MEGA65/mega65-core/docs/images/precomp.pdf

etherload.a65

etherload.prg

Ophis

diskchooser.a65

diskchooser

Ophis

diskmenuc000.a65

diskmenu_c000.bin

Ophis

.incBIN | .incBIN | .include | .include

diskmenu.a65

diskmenuprg.a65

diskmenu.prg

Ophis

kickstart.vhdl

Python Script

(./makerom)

kickstart.a65

kickstart65gs.bin

Ophis

rom_template.vhdl

.include

kickstart_task.a65

kickstart_mem.a65

kickstart_dos.a65

kickstart_machine.a65

kickstart_process_descriptor.a65 .incBIN

Choose ONE or
the OTHER
creates | creates

version.sh

version.vhdl | version.a65

.include

This diagram shows an overview of the build process implemented with the Makefile.

For example, to generate “etherload.prg” file, the “etherload.a65” file is passed into the “Ophis” compiler.

The “.incBIN” denotes that the lower file 'includes' the upper file, and the upper file is inserted into the lower file in a binary format.
Similarly:
the “.include” denotes that the lower file 'includes' the upper file, and the upper file is inserted into the lower file in a text-based format.

The “creates” suggests that the upper file 'generates' the lower file.

The “Choose...” suggests that one of the upper files is chosen to be “included” in the lower file.
Both the upper files are compiled by default.
The lower file is modified to select which of the two upper files to include.

The “pngprepare” executable is built from source. Details of this are not provided (refer to the Makefile).
The “pngprepare” file takes the upper file and generates the lower file.

A “Python Script” is used to generate one lower file from two upper files.

8x8font.png

charrom.vhdl

./pngprepare

mega65_64x64.png

BOOTLOGO.G65

./pngprepare

Used by Xilinx ISE
to be included within
the FPGA's bitstream.

To be copied onto the SD-Card. This image is displayed
during the boot process.
