MEGA65/mega65-core/docs/images/precomp-small.jpg

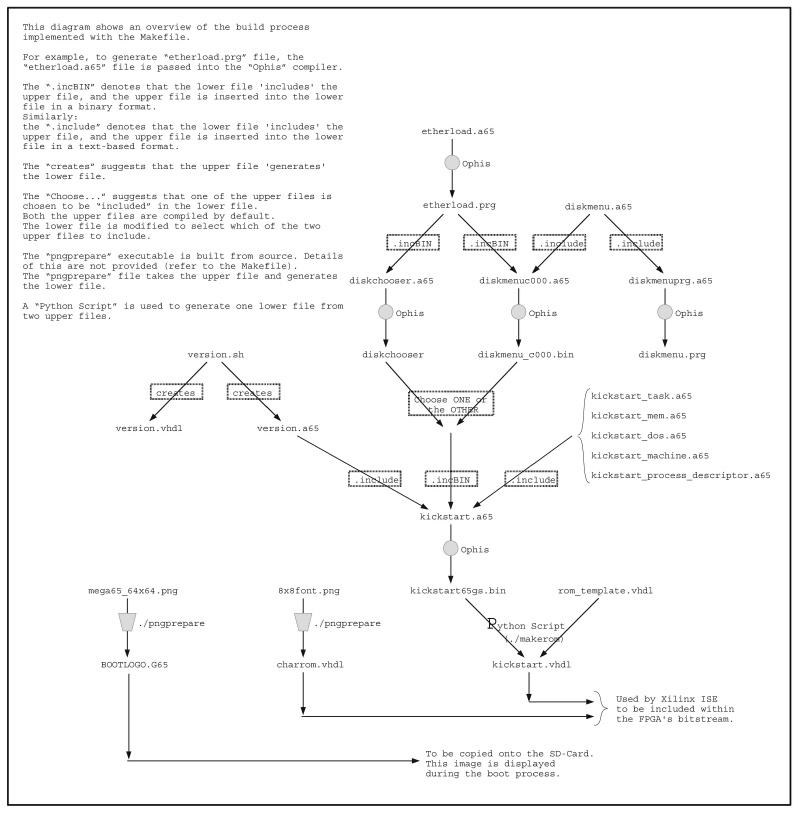
docs/images/precomp-small.jpg
