MEGA65/mega65-core/(threads)

Thread 1 (2016-08-08):

SD Card reader issues

gurcei, 2016-08-08:
I'm presently having trouble getting the kernel read from the sd-card and into memory.

There seems to be a chunk of incorrect data in the data, described in this forum post:

https://groups.google.com/d/msg/c65gs-development/q7kCars2Xqw/a_WIWMmcAgAJ

Paul has a few suggestions to chase up that he mentions in that forum thread.

##BREAKS Hypervisor cannot boot computer to C65 BASIC 10 from SD card

Ben-401, 2016-08-10:
Paul suggests this is one of my initial tasks.
also this thread:
https://groups.google.com/forum/#!topic/c65gs-development/lfTTbbDhWgo

gurcei, 2016-08-10:
No worries and fair enough too, as it's a fairly nasty issue that needs some heavy focus, and I'm getting fairly distracted with m65dbg as is. I'll still keep one eye on looking into this too, as it provided the impetus for the growth of the debugger, so I might still chip in my 10 cents worth on this topic from time-to-time if I notice anything.

gurcei, 2016-08-16:
While debugging tonight, discovered a potential cause of the problem. More info in this forum-post:

https://groups.google.com/d/msg/c65gs-development/lfTTbbDhWgo/5Fm-_td2AwAJ

gardners, 2016-08-16:
How about (untested):

dos_file_read_current_sector:
jsr dos_set_current_cluster_from_file
jsr dos_cluster_to_sector

; Add sector within cluster
jsr dos_get_file_descriptor_offset
bcc dos_return_error_already_set
ora #dos_filedescriptor_offset_sectorincluster
tay
ldx #$00
clc
php
lda dos_file_descriptors,y
bne dfrcs4
dfrcs2: lda #$00
dfrcs4: plp
adc $d681,x
sta $d681,x
bcc dfrcs_inced
php
inx
cpx #$04
bne dfrcs2
plp
dfrcs_inced:

i.e., save and restore the processor flags. Cost is 4 bytes and some cycles.

Do check that what I have suggested actually does the job before committing
;)

Paul.

On Tue, Aug 16, 2016 at 10:53 PM, Gurce Isikyildiz <notifications@github.com
> wrote:

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

gurcei, 2016-08-19:
Yep, Paul's suggestion solved the prob and he's pushed in the fix into the master branch.

There's another issue regarding the failed loading of the (optional) KICKUP.M65 file from the sd-card, I'm looking into that next.

gurcei, 2016-08-22:
I've tested with the latest bit-stream (I was on an older bitstream previously), and it was able to load the KICKUP.M65 successfully. Ok to close? Or other known quirks of behaviour in the sd-card reading that still remain?

gardners, 2016-08-22:
Hello,

If there are no known outstanding items, close the request. We can always
reopen it or open a new one if (or when ;) we find new problems.

Paul.

On Tue, Aug 23, 2016 at 5:50 AM, Gurce Isikyildiz <notifications@github.com>
wrote:

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

Ben-401, 2016-08-26:
i have confirmed that the SDcard reader sometimes needs to call the "redoread" function.
it seems to do this when it detects that it did not read 2x-pages (512 bytes).
in this regard i reverted the debug message to display this abnormality, in an attempt to characterise the behaviour.

It seems to consistently re-do-read when loading bitstream from USB and having KICKUP on SD.

Ben-401, 2016-08-29:
I have reviewed the "kickstart" and "dos" code, and have modified the Checkpoint messages that are generated. I now have a better understanding of how it works.

I have also created a script that examines a sdcard and writes information to harddisk.
I have also created a script to zero/partition/format a sdcard in an attempt to try diagnose the problem.

I will upload these files to the repo soon, in the src/utilities directory.

Ben-401, 2016-08-31:
i have found some unusual behaviour in the _dos code:
- re-reading MBR (sector 0) when not neccessary
- checking for $55AA when not nessessary
- not observing file attributes appropriately.
- seems to be using CHS (cylinder/head/sector) i think
- a heap of code for file handlers and offset information...

I have modified the _dos code, available for viewing on MVFILE branch
but is under development, please do not merge or branch from.

gardners, 2016-08-31:
Hello,

It should only be using LBA, not CHS addressing.

The file handler code etc is important, to allow a program to ask the
hypervisor to open multiple files at the same time.  However, we do know
that we have a file handle leak somewhere.

Paul.

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

Ben-401, 2017-02-14:
how do we test that this change infact works?
is there as basic program or assembly code that we can include in our test procedure?
Please... :)

And can this patch be applied to the development branch instead of cursorkeys?
I thought cursorkeys has been retired?

gardners, 2017-02-14:
Hello,

Falk and I are still pushing the cursorkeys branch forward as the focus of
our attention, as we are the only folks working on it.  It would be good to
merge all the changes onto development, of course.

Paul.

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

lydon42, 2022-01-09:
As reading and writing of the SD Card obviously works in 2022, we can close this.

Closed 2022-01-09.

Thread 3 (2016-08-09):

Problem with etherload stub

SvOlli, 2016-08-09:
Hello,

I tried a partial rewrite of the etherload stub to get arp replies working. I succeeded, almost. Even though the code should reply always the same if arping'ed from the same host, the results vary.

Without knowing what happening inside the hardware, I can't go on any further.
Once this issue has been solved, I might be able to squeeze in support for ICMP, so the stub will reply to pings.
[etherload.txt](https://github.com/MEGA65/mega65-core/files/409798/etherload.txt)

gardners, 2016-08-09:
What differences are you seeing? We did see some subtle bit corruption bug
with sending packets, but I don't know if that is still happening. Some
examples of the packets would be helpful in discovering the cause.

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

Ben-401, 2016-08-10:
to see what is going on in the hardware maybe you could add checkpoint messages to the .a65 asm files? and view those messages using the serial-monitor. ie

	jsr checkpoint
	.byte 0,"GOT-TO-HERE",0
or even better populate the output message with values corresponding to the register values.

SvOlli, 2016-08-10:
Hello,

I don't think that it has to do with the C65 code. There are a lot of bit
flips, where I can't make up a pattern. I've attached a dump done with
wireshark.

btw: the sourcecode reveals who to tell the hardware how big the packet to
send is, but how can I tell how big the incoming packet is?

Greetings,
SvOlli

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

Winke: o/~
SvOlli
--
|  _______       |
| (  /\          | Sie glaubt an ihre Traeume
|__)v\/lli a.k.a.| weil Traeume mehr als Gold wert sind.
|Sven Oliver Moll|   -- Selig, "Maedchen auf dem Dach"

gardners, 2016-08-10:
Hello,

Yes, I recall there was a problem with bit-flips.  I am not sure of the
cause of this.  I am guessing that it will likely be a problem with the
delay relationship of the clock line versus the data lines from the FPGA to
the ethernet controller.  It would be instructive to know if the bits are
in effect copied from the preceding 2-bit word in either direction (the
ethernet interface takes data 2 bits wide).

Paul.

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

gardners, 2016-08-10:
Datasheet for the ethernet interface IC on the Nexys4 is at:

http://ww1.microchip.com/downloads/en/DeviceDoc/8720a.pdf

TX data is latched when the clock goes high.  The data should already be
present on the line at that point in time, i.e., should be provided when
the 50MHz clock goes low.  At present, that is not the case.

Probably the best solution is to make the controller run at 100MHz, divide
that by 2 to generate the 50MHz clock for the ethernet controller, and then
drive the data explicitly on the low phase of the 50MHz clock, to be
certain that it is ready on time.  There is probably a one or a couple of
days work for someone to implement and test that.

Paul.

On Wed, Aug 10, 2016 at 4:55 PM, Paul Gardner-Stephen <
paul@servalproject.org> wrote:

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

gardners, 2016-08-10:
Have just taken a quick look: It seems possible to just invert the sense of the ethernet 50MHz clock to the PHY.   Trying that (commit e788e25610c59c83e899521976fb777def57b467).

Ben-401, 2016-08-10:
I am no expert, but I think the clocking of components needs revision.
ISE reports that there are gated-clocks, and clocks generated from combinational-logic(?).
This needs to be changed in my opinion.
From my experience we should be able to draw a solid line through the design to show which components are being clocked at 200M, 100M, 50M, and etc.

Ben-401, 2016-08-10:
my opinion is that all components should be clocked at 200mhz (or more), and the chip-enable to each circuit be generated from a 4-bit counter (to give 100, 50, 25) driven by the incoming 200+ clock_in.

gardners, 2016-08-10:
I agree the clocking can be improved. However, the pixel clock requires 192MHz, and the ethernet 50MHz, thus we cannot avoid having 2 clock domains.  The CPU is 48MHz (pixelclock/4), which is generated by the FPGA's PLL.  However, there are some other clocks lurking around the place that can probably be simplified, provided the process doesn't break anything.

gardners, 2016-08-15:
We have just tried flipping the ethernet clock, as it looked like we were providing data on the wrong clock phase, but that is in fact not the problem.

Ben and my best guess now is that there is glitching on the TX side, and will try registering the outputs.

gardners, 2016-08-15:
Implementing registering of ethernet tx signals in commit 44cddf87588ae2b14e00be76dd072387ae0a5b2d

gardners, 2016-09-15:
I still haven't gotten around to testing if registering the signals has fixed the bit-flip problem.

Ben-401, 2016-09-15:
Please assign this one to me. I will look into it after sdcard/fat32.

lydon42, 2022-01-09:
As this is very old, and stuff like WeeIP, fetch and Haustierbegriff works, I deem it hereby closed.
If there are still topics with it, it might be better to create a new issue with clear description of shortcomings and reference this one.

Closed 2022-01-09.

Thread 7 (2016-08-10):

serial buffer for in-built monitor

gurcei, 2016-08-10:
This one relates to #2 somewhat. Paul suggested the creation of a serial buffer for the comms sent out of the hardware by the monitor:

https://groups.google.com/d/msg/c65gs-development/FESl92s4vEM/rpmUe5Z4AQAJ

Perhaps this might improve performance too?

gardners, 2016-08-10:
The only performance boost it will give, is that you will be able to write
a whole command and flush at once.  USB latency is still likely to be a
remaining problem.

On Wed, Aug 10, 2016 at 8:32 PM, Gurce Isikyildiz <notifications@github.com>
wrote:

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

Ben-401, 2016-08-10:
i think the serial-comms needs to be a blocking-call. Ie your calling component waits until the message has been sent, then the calling component goes away and continues.
i dont think a buffer here will help at all, infact it will only duplicate the message, whereas my understanding is that the current architecture calling component sends a byte-at-a-time to the serial-monitor to transmit.
as for the serial-comms component, i think an improvement would be that the 2000-odd clock cycle delay be done-away with, and more tightly-timed circuit be implemented. I can elaborate on this. Its all about handshaking.

gardners, 2020-12-18:
The serial monitor is basically UART fed, so the lack of a UART RX buffer does mean that the sending side has to leave a long enough gap between each character for the monitor to process it. As the new monitor is actually running in a little CPU, this delay can be quite big. As a result we have to send each character with a considerable delay between them. Worse, because its over USB we have to make sure that the USB layer doesn't merge any of the writes into a single packet.  To make this stable, we typically have delays of 500 -- 2000 usec between each character, often more.  This means we effectively write at ~1KB/sec instead of the ~200KB/sec that the 2mbit/sec serial interface can support.  Thus just being able to write whole commands at once will likely result in substantially faster performance. But more importantly, it will greatly reduce the chance of characters being dropped, which does seem to be a problem when using Windows as the sender.

Closed 2022-10-02.

Thread 20 (2016-09-14):

Hypervisor DOS FAT32 chain and directory following/parsing compatibility problem and speed improvement idea

lgblgblgb, 2016-09-14:
According to https://en.wikipedia.org/wiki/Design_of_the_FAT_file_system

The FAT table contains last cluster for chain ("EOC") as values 0x?FFFFFF8 - 0x?FFFFFFF. It seems, KS only recognizes 0x?FFFFFFF, though as a test, I can see, that Linux dosfstools uses 0x?FFFFFF8 (this behaviour and compatibility problems even mentioned by the page). This can be an explanation why file systems created on some OSes doesn't work for us. The page also mentions about the fact, that FAT32 is actually FAT28, and the high 4 bits are not so much used to express cluster number but not always zero still, that's the reason of '?' marks in the hex numbers above (so they should be "masked out" before using a value as cluster?). It seems it's even recommended to treat **any** value in FAT which is over the max number of cluster on the given FS as "EOC", not only the range above, for better compatibility (as the page claims: "a good implementation ..."). This is exactly the problem I noticed with my M65 emulator with my own created FAT32: soon, invalid block is tried to be read on directory scanning, it can be the issue, that EOC (what is produced by my Linux box, but what is accepted by my various "stuffs" like digital camera etc) is misinterpreted by KS, and tried to be converted into SD block number the read -> thus the problem we see. As far as I know some other people also has problem like this.

I think, "sensing" EOC should be modified to care about these information too, including the 4 high bits issue, the multiple possibilities for EOC, and maybe even that any cluster number in FAT should be treated as EOC, if it would cause to address a cluster which does not exist on the used FS. This should be true for directory parsing, but also, for any file, where FAT is used for anything to detect EOC situation. Also maybe not only EOC, but cluster info from FAT should be handled to use only the lower 28 bits just in case for some "strange" FAT32 file systems, and even better compatibility.

I found this table especially useful (it mentions even more EOC possibilities, like cluster 0 and 1 ...):

https://en.wikipedia.org/wiki/Design_of_the_FAT_file_system#Cluster_values

The other issue is more like a performance gain than a real issue: again, according to the page above, during a directory read, if the 32 bytes directory entry starts with byte 0, directory parsing can be stopped. So even there is no need to parse the rest of the cluster (or read the next logical sector belonging to the actual cluster ...), and maybe no need to even check for next cluster then in FAT. It seems, this can be a compatibility issue in general in case of older FATs (FAT12 and FAT16) with some extreme old DOS versions, like DOS 1 and DOS 2 and some half-CP/M-half-DOS beings. However, as FAT32 is surely not handled/produced by these, I think, we can surely say, this theory is true for our case with FAT32-only KS. Even deleted files has first byte as 0xE5, zero should only encountered if no other entries follows in the directory (let it be the root directory or any other - as with FAT32 there is no difference, unlike with FAT12/16). Reference:

https://en.wikipedia.org/wiki/Design_of_the_FAT_file_system#Directory_entry

gardners, 2016-09-15:
FAT end of directory marker fix in commit

cc0cd02315e18259b9be1e6d6a623932a4da9029

FAT EOC marker fix in b9178ec202700edad6944c3884280dce88c6e88c

Both currently untested.

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

rdpeake, 2021-02-05:
fixed

Closed 2021-02-05.

Thread 24 (2016-09-23):

BOULDERMARK not working

Ben-401, 2016-09-23:
PGS has advised that the "BOULDERMARK" program no longer works on the current bitstream.
The Bouldermark program runs a special-level in the Boulderdash program and counts how many frames it takes to complete.
The Bouldermark program can be found on the MEGA65 image.

Ben-401, 2016-09-23:
An old bitstream dated Mar 15 2016 23:18:00 shows that the Bouldermark program gains a score of ~27K.
go64
y
sys49152
<mount MEGA65>
load"BOULDERMARK
POKE0,65
LIST
RUN
<joystick-FIRE a couple of times>

Ben-401, 2016-09-23:
PGS has suggested that maybe something in the gs4510 file has changed, causing the Bouldermark program to now crash.
PGS has suggested that an iterative-approach be taken to find which bitstreams do work, and at what point the bitstreams dont work, and then find the commit that breaks the Bouldermark program.

Ben-401, 2016-09-23:
the bitstream referred to above (Mar 15) is commit ID
commit ad7698ce809479d3ce1b71675ded70d2fa729b77
Author: justburn <justburn@users.noreply.github.com>
Date:   Sun Mar 13 07:44:16 2016 +0000
    Cleanup and making it work again

Ben-401, 2016-09-29:
i am currently building all relevant bitstreams to detect which commit caused the issue.

Ben-401, 2016-10-05:
I am able to build old bitstreams, using colossus HPC,
home/dev/sdcard/_safeKeep/MEGA65.BIT is the BITfile that runs and gets a score of 26023.
work only on PGS fpga-board, ie not on BNG fpga-board.
BG has captured a video showing the highscore.
still need to verify if I can build a BITfile that gains the same highscore.

gardners, 2016-10-20:
Have you found the commit where it stops working?

Ben-401, 2016-10-24:
i have found a commit where it does work. All I have is a "container.bit" file as listed above. What I have found is that this particular bitstream works to some success(*) only on your Nexys board; it works to a much lesser amount on my Nexys board. This suggests to me that the bitstream is not hardware independant. Given all the compile warnings and lack of timing closure, i think the best approach is to get the design compiling with 100% timing closure and minimise warnings before trying to fix an intermittent problem.

(*) Your board runs for a minute or so, says it run out of time, then continues the level as score increases, loops a number of times, then finishes the level with about 30k.
(*) My board starts the level, border flashing, after 5-secs or so, full-screen flash with bitmap-detail showing top horizontal line. seems to be stuck in a loop.

gardners, 2016-10-25:
Hello,

Yes, this suggests that timing closure is the problem -- or failing that,
that one of our boards is faulty in some way.

For the timing closure issue, this is relatively easy to verify, as you can
modify the design to operate at ~32MHz (196/6) or ~40MHz (192/5) instead of
~48MHz without great difficulty.  This isn't a long-term solution,
however.  The remaining timing closure problems in the CPU were intended to
be fixed by moving to the new CPU design, however, that is still some time
off.

Note that the VIC-IV 192MHz clock domain is much harder to get to meet
timing right now, but is rather unlikely to be the cause, because the CPU
is not sensibly dependent on it. The easiest and most sensible way to solve
the video clock timing is to drop to 1080p, as we have been planning for
some time, as this will allow dropping the pixel clock to 148MHz, which
should fixing the timing closure there.

Of course, the CPU and VIC clocks have to remain integer ratios of each
other, since there is a lot of cross-domain data passing between them.
This would mean that the CPU would need to be at 148/3 = ~48MHz as now, or
148/4 = ~37MHz.

But in the meantime, if you can identify the commit ID, we can examine what
was changed, and revert that specific problem for now.

Paul.

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

Ben-401, 2017-03-20:
The current version of code is KSv10.
The KSv10 when running on the NEXYS4DDR board labelled "PGS" gains a score of 26k or more. I have tested many times.
The KSv10 when running on the NEXYS4DDR board labelled "BNG" gains a score of zero. During the first 3 secs (when the balls are falling), the screen shows the balls falling etc but flickers black a few times, after the balls finish dropping, GAME OVER is instantly displayed and switches to the high-score table. This differs to what was experienced previously as detailed on 24-OCT-2016.

I consider that the firmware is not hardware independant, and seems 'tuned' to the 'PGS' board where the firmware was initially written for.,

This issue remains open.

gardners, 2017-03-20:
As mentioned, the issue is most likely related to the lack of timing
closure on the CPU.  This means that production variation in the FPGA can
change the behaviour of the system.  If you run Bouldermark with the CPU at
1MHz, then it performs reliably on all boards that I have seen, adding some
support for this theory.

I believe the underlying problem is occurring in branch instructions, but
don't have the hard evidence to back that up at the moment.

Paul.

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

Ben-401, 2017-03-20:
Yes, both the "PGS" and "BNG" boards get a score of 306-to-309 when BOULDERMARK is run in 1 MHZ mode, ie "POKE 0,64".

As for the timing closure issue...

gardners, 2017-03-20:
You could make a build with a 32MHz CPU and try that.

It is also possible that it is something strange that requires a CPU wait
state for some signal to be propagated.

Paul.

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

gardners, 2018-02-08:
This problem has been fixed some time ago, as I recall. I forget precisely what the underlying cause was. Please test and verify, then we can close the issue.

Ben-401, 2018-02-09:
cannot load the "BOULDERMARK.PRG" file from sdcard, as sdcard not working.
have tried using "monitor_load" but cannot seem to upload PRGs to c65-mode like i can do in c64-mode.

Can monitor_load be updated to upload files to c65-mode?
I will wait until sdcard operational then test.

Ben-401, 2018-02-09:
sorry, we should be in c64 mode, not c65 mode.
Yes I can upload bouldermark to c64 mode, gets a score of ~100 in c64 mode.
then upload bouldermark, POKE0,65, run, does not score.

-> still a problem (as verified with you alongside me)

rdpeake, 2021-02-05:
Currently tested on recent bitstream as working

Closed 2021-02-05.

Thread 39 (2017-10-27):

Errors while compiling

sorgelig, 2017-10-27:
https://github.com/MEGA65/mega65-core/blob/c1954d254a64a65d1a05083dcd4cb5262f61ca88/src/vhdl/viciv.vhdl#L1689

is current VHDL can be compiled? I have a lot of issues with signal multi-drivers like on link.
For example the address bus palette_fastio_address gets assigned in lines:
first group, lines: 1689 1693 1697
second group, lines: 2300 2304 2308
First group is combination logic used in read while second group is sequential logic triggered by rising_edge(ioclock) during write. This produces error as this signal has 2 drivers. I didn't use Xilinx development tools. I use Altera. But i've though there is a common HDL rule where signals might be assigned only in one logical block.
There are many such places in the different HDL files.
Finally, i found some modules have different signal assignment than calling module.

Overall code doesn't look like working. Am i right?

gardners, 2017-10-27:
For the moment, build from the m65pcb-ports branch if not already doing so. This branch synthesises fine using ISE. We will synchronise master and development to this in the near future.

However, it is possible that there may still be problems of this sort when switching tools, due to my inferior VHDL skills and differences in tools. If you can confirm which branch you are using, we can work out if we still need a solution, and proceed from there.

sorgelig, 2017-10-27:
I've cloned default branch, which should be master, i guess.

By the way, is it really necessary to use such high resolution? While many TVs/Monitors can support it, for compatibility purpose can you consider 1280x720@60 at least as an option?

gardners, 2017-10-27:
Hello,

ok. Try m65pcb-ports and let me know if the problem is still present.

Regarding the resolution, the challenge is we need to use a single common
mode that works everywhere, if we are to preserve the C64 idiom of
standardised raster timing.  That said, we may well move to 800x480 for a
variety of reasons I can't presently explain.  For testing, you can
certainly pick a mode with a lower dot clock to ease your timing closure.
It must be an integer multiple of the CPU clock, however.

Paul.

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

sorgelig, 2017-10-27:
Ok. i'm looking into m65pcb-ports branch, but can't find top-level files container*.vhd

sorgelig, 2017-10-27:
By the way, can you tell what is current BRAM (FPGA RAM) usage in the project?
My FPGA has 5,662,720bits of BRAM - do i have chance to run the mega65?

gardners, 2017-10-27:
The m65pcb-ports branch uses a new Makefile that creates all the files required. Also, it uses top-levels named for the different FPGA boards we are using, e.g., nexys4ddr, m65pcbr1 etc.

As for BRAM, we are using almost the entire BRAM of the T100 FPGA. There is some scope to save some space by merging the video and shadow RAM if you dropped the pixel clock (and possibly CPU clock) enough, but that would be a lot of work.

You currently need 128KiB for chip ram, 128KiB for the shadow of that, 128KiB for the "ROM", 32KiB for colour RAM, 24KiB for the Hypervisor and a few other 4KiB and 8KiB buffers here and there.

But if I have calculated correctly, your FPGA has more BRAM than the T100, so it should be fine.  What part/board are you using, out of curiosity?

sorgelig, 2017-10-27:
If you are still target to T100 then it's good! I was afraid you've moved to T200 already.

I'm trying to port mega65 to my project MiSTer: https://github.com/MiSTer-devel/Main_MiSTer/wiki
It's based on Terasic DE10-nano with additional expansion boards. Besides the main board all PCB designs, SW and HDL are open source and available on my repository.

I have ported C64, but in some aspects it's desired to be better. That's why i want to try your version of C64 as a subset of mega65.

gardners, 2017-10-27:
Ah, very cool. Well, we are happy for the M65 core to be ported, as we very much agree with the open-source approach.  Our C64 core is currently not as good as we would like, but welcome improvements, and certainly intend to improve it further.  Note at present our CPU defaults to 4510, not 6502.  6502 illegal opcodes are only partly implemented, and indeed the CPU is currently over complex for what it needs to do, and needs some refactoring and simplification -- but maybe not until we have some better test cases, so that we can verify that nothing gets lost in the process.  I have started work on a pipelined multi-core register-renaming 4510/6502 that is designed to be a lot faster and smaller in hardware, while still completely backward compatible (including for self-modifying code), but it isn't very far advanced yet.

You can see the current progress at: https://github.com/gardners/gs4502b

sorgelig, 2017-10-27:
where can i get **convert** utility used in your makefile?

gardners, 2017-10-27:
convert is a standard unix package for converting image types.  apt-get
install convert should get it.
what OS are you using?

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

sorgelig, 2017-10-27:
i've found it already, sorry :)

now i cannot find m65fdisk.prg
is the any link where to download it?

sorgelig, 2017-10-27:
I'm using Windows. I've downloaded this https://www.imagemagick.org/script/convert.php
it seems the same as linux one.

gardners, 2017-10-27:
It is built from a git submodule.

git submodule init
git submodule update
make

should do everything.

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

sorgelig, 2017-10-27:
it seems it links to non-existing commit. github gives error 404. git submodule also give error.
I will clone the latest commit - hope it will work as well.

gardners, 2017-10-27:
I have just pushed the missing commit

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

sorgelig, 2017-10-27:
Thanks for supporting! I'm slowly moving forward.
another problem:
```
$(BINDIR)/diskmenu_c000.bin:	$(UTILDIR)/diskmenuc000.a65 $(UTILDIR)/diskmenu.a65 $(BINDIR)/etherload.prg
	$(OPHIS) $< -l $*.list -m $*.map -o $*.prg
```

i see references to diskmenu_c000.bin, but actually diskmenu_c000.prg is produced. Is it mistake in makefile?

sorgelig, 2017-10-27:
ok, after changing to
```
$(OPHIS) $< -l $*.list -m $*.map -o $*.bin
```
i could finish generate following:
generated_vhdl
firmware
iomap.txt
utilities
roms

So, now i have files for SD card and hopefully all HDL files. Preparation and adjusting the HDL code will take some time, i think. So will report you later about result.

gardners, 2017-10-27:
okay. let me know how you go.  Feel free to make a pull request for the fix.

Paul.

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

sorgelig, 2017-10-27:
it's me again :)

I don't know how Xilinx compiles this part of code:
```vhdl
    if ioclock'event and ioclock = '1' then
      -- Allow writing to bitplane buffer memory directly for debugging
      -- (will be overridden if VIC-IV data pipeline is feeding us data)
      -- @IO:GS $FFBF000 - $FFBFFFF - DEBUG allow writing directly to the bitplane data buffer.  Will be removed in production.
      if fastio_write='1' and fastio_address(19 downto 12) = x"BF" then
        bitplanedatabuffer_waddress(11 downto 0)
          <= fastio_address(11 downto 0);
        bitplanedatabuffer_wdata(8) <= '0';
        bitplanedatabuffer_wdata(7 downto 0) <= fastio_wdata;
        bitplanedatabuffer_write <= '1';
      end if;
    end if;
    if pixelclock'event and pixelclock = '1' then  -- rising clock edge

      -- Copy sprite colission status out
      sprite_map_out <= sprite_map_in;
      sprite_fg_map_out <= sprite_fg_map_in;

      -- Have a drive stage on bitplane mode bits to ease timing.
      bitplane_mode <= bitplane_mode_in;
      bitplane_enables <= bitplane_enables_in;
      bitplane_complements <= bitplane_complements_in;

      -- copy sprite data chain from input side to output side
      sprite_spritenumber_out <= sprite_spritenumber_in;
      sprite_datavalid_out <= sprite_datavalid_in;
      sprite_bytenumber_out <= sprite_bytenumber_in;
      sprite_data_out <= sprite_data_in;
      sprite_number_for_data_out <= sprite_number_for_data_in;

      if sprite_datavalid_in = '1' and (sprite_spritenumber_in > 7) then
        -- Record sprite data
        report "BITPLANES:"
          & "  byte $" & to_hstring(sprite_data_in)
          & " from VIC-IV for bp#"
          & integer'image(sprite_spritenumber_in)
          & " byte #" & integer'image(sprite_bytenumber_in)
          & " x=" & integer'image(x_in)
          & " x_start=" & integer'image(bitplane_x_start)
          & " y=" & integer'image(y_in)
          & " y_start=" & integer'image(bitplane_y_start)
          & " border_in=" & std_logic'image(border_in)
          & " bitplane_mode_in=" & std_logic'image(bitplane_mode_in)
          & " bitplane_drawing=" & std_logic'image(bitplane_drawing);
        bitplanedatabuffer_waddress(11 downto 9)
          <= to_unsigned(sprite_spritenumber_in mod 8, 3);
        bitplanedatabuffer_waddress(8 downto 0)
          <= to_unsigned(sprite_bytenumber_in, 9);
        bitplanedatabuffer_wdata(8) <= '0';
        bitplanedatabuffer_wdata(7 downto 0) <= sprite_data_in;
        bitplanedatabuffer_write <= '1';
      end if;
```
signals **bitplanedatabuffer_wdata** and **bitplanedatabuffer_write** are driven by 2 clocks ioclock and pixelclock. Altera tools refuse to synthesize this. It's even impossible in real world. It's like connect outputs of 2 clocks together physically. How it's possible in Xilinx - i have no idea :(

sorgelig, 2017-10-27:
in this particular case, these signals are used to write into 2-port RAM, so it would be better to re-arrange the ports. One port use for ioclock control, another for pixelclock control. Anyway, it's not good to clock the RAM port with one clock but drive signal from other clock.

But there are several places with multi-drivers in other parts of code.

gardners, 2017-10-27:
Hello,

You can simply remove the ioclock access in the above case, as it was only
ever there to help debug bitplane function.  Falk Rehwagen will be merging
in the final fixes for the bitplanes when he has time, so there is no need
to keep the debug function.

Let's just work through the multi-drivers one by one, if that suits you.

Paul.

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

sorgelig, 2017-10-27:
Yep, doing one by one is the best way.
```vhdl
    if fastio_read='1' then
      if fastio_addr = x"D3632" then
        -- @IO:GS $D632 - Lower 8 bits of thumbnail buffer read address (TEMPORARY DEBUG REGISTER)
        fastio_rdata <= thumbnail_read_address(7 downto 0);
      elsif fastio_addr = x"D3631" then
        -- @IO:GS $D631 - Read port for thumbnail generator
        fastio_rdata <= thumbnail_rdata;
      elsif fastio_addr = x"D3630" then
        -- @IO:GS $D630-$D631 - Read-only hardware-generated thumbnail of display (accessible only in hypervisor mode)
        -- @IO:GS $D630 - Write to reset port address for thumbnail generator
        -- @IO:GS $D630 - Read to obtain status of thumbnail generator.
        -- @IO:GS $D630.7 - Thumbnail is valid if 1.  Else there has not been a complete frame since elapsed without a trap to hypervisor mode, in which case the thumbnail may not reflect the current process.
        -- @IO:GS $D630.6 - Thumbnail drawing was in progress.
        thumbnail_read_address <= (others => '0');
        fastio_rdata(7) <= thumbnail_valid;
        fastio_rdata(6) <= thumbnail_started;
        fastio_rdata(5 downto 0) <= (others => '0');
      else
        fastio_rdata <= (others => 'Z');
      end if;
    else
      fastio_rdata <= (others => 'Z');
    end if;

    if rising_edge(ioclock) then

      -- Tell ethernet controller which half of the buffer we are writing to.
      -- Ethernet controller autonomously sends the contents of the other half
      -- whenever we switch halves.
      buffer_moby_toggle <= output_address_internal(11);

      -- Logic to control port address for thumbnail buffer
      if fastio_read='1' then
        if fastio_addr = x"D3631" then
          last_access_is_thumbnail <= '1';
          if last_access_is_thumbnail = '0' then
            thumbnail_read_address <= thumbnail_read_address + 1;
          end if;
        else
          last_access_is_thumbnail <= '0';
        end if;
      else
        last_access_is_thumbnail <= '0';
      end if;     
    end if;
```
thumbnail_read_address has multi-drivers because first block is combination logic while second block is sequential clocked by  ioclock.
Is ioclock block also for debugging and can be removed?

sorgelig, 2017-10-27:
may be add following code to the ioclock block and remove thumbnail_read_address from combination block?
```vhdl
      elsif fastio_addr = x"D3630" then
        thumbnail_read_address <= (others => '0');
      end if;
```

sorgelig, 2017-10-27:
here is the whole block with my modification:
```vhdl
    if fastio_read='1' then
      if fastio_addr = x"D3632" then
        -- @IO:GS $D632 - Lower 8 bits of thumbnail buffer read address (TEMPORARY DEBUG REGISTER)
        fastio_rdata <= thumbnail_read_address(7 downto 0);
      elsif fastio_addr = x"D3631" then
        -- @IO:GS $D631 - Read port for thumbnail generator
        fastio_rdata <= thumbnail_rdata;
      elsif fastio_addr = x"D3630" then
        -- @IO:GS $D630-$D631 - Read-only hardware-generated thumbnail of display (accessible only in hypervisor mode)
        -- @IO:GS $D630 - Write to reset port address for thumbnail generator
        -- @IO:GS $D630 - Read to obtain status of thumbnail generator.
        -- @IO:GS $D630.7 - Thumbnail is valid if 1.  Else there has not been a complete frame since elapsed without a trap to hypervisor mode, in which case the thumbnail may not reflect the current process.
        -- @IO:GS $D630.6 - Thumbnail drawing was in progress.
        fastio_rdata(7) <= thumbnail_valid;
        fastio_rdata(6) <= thumbnail_started;
        fastio_rdata(5 downto 0) <= (others => '0');
      else
        fastio_rdata <= (others => 'Z');
      end if;
    else
      fastio_rdata <= (others => 'Z');
    end if;

    if rising_edge(ioclock) then

      -- Tell ethernet controller which half of the buffer we are writing to.
      -- Ethernet controller autonomously sends the contents of the other half
      -- whenever we switch halves.
      buffer_moby_toggle <= output_address_internal(11);

      -- Logic to control port address for thumbnail buffer
      if fastio_read='1' then
        if fastio_addr = x"D3631" then
          last_access_is_thumbnail <= '1';
          if last_access_is_thumbnail = '0' then
            thumbnail_read_address <= thumbnail_read_address + 1;
          end if;
        else
          last_access_is_thumbnail <= '0';
        end if;
        if fastio_addr = x"D3630" then
          thumbnail_read_address <= (others => '0');
        end if;
      else
        last_access_is_thumbnail <= '0';
      end if;     
    end if;
```
Actually the part with combination logic may introduce glitches in work since it produces many latches. Latches are evils :)

sorgelig, 2017-10-27:
another multi-driver:
```vhdl
    if rising_edge(pixelclock) then

      if rx_clear_flags='1' then
        -- Clear byte read flag
        reg_status0_rx_full <= '0';
        -- Clear RX over-run flag
        reg_status1_rx_overrun <= '0';
        -- Clear RX parity error flag
        reg_status2_rx_parity_error <= '0';
        -- Clear RX framing error flag
        reg_status3_rx_framing_error <= '0';
      end if;

      if (baud_subcounter + baud_subcounter_step < 1048576) then
        baud_subcounter <= baud_subcounter + baud_subcounter_step;
        tick709375 <= '0';
      else
        baud_subcounter <= baud_subcounter + baud_subcounter_step - 1048576;

        -- One baud divisor tick has elapsed.
        -- Based on TX and RX modes, take the appropriate action.
        -- Each tick here is 1/2 a bit.
        tick709375 <= '1';
      end if;
      if tick709375='1' or clock709375='0' then
        -- Depending on whether we are running from the 7.09375MHz
        -- clock or the 193.5MHz pixel clock, see if we are at a baud tick
        -- (193.5MHz clock is used for baud rates above 57.6K.)
        fine_tick <= '1';
      else
        fine_tick <= '0';
      end if;
      if fine_tick='1' then
        if reg_tick_countdown > 0 then
          reg_tick_countdown <= reg_tick_countdown - 1;
          baud_tick <= '0';
        else
          reg_tick_countdown <= reg_divisor;
          baud_tick <= '1';
        end if;
      end if;

      -- Keep track of last 16 samples, and update RX value accordingly.
      -- We require consensus to switch between 0 and 1
      rx_samples(15 downto 1) <= rx_samples(14 downto 0);
      rx_samples(0) <= uart_rx;
      if rx_samples = "1111111111111111" then
        filtered_rx <= '1';
      end if;
      if rx_samples = "0000000000000000" then
        filtered_rx <= '0';
      end if;

      if baud_tick = '1' then
        -- Here we have a clock tick that is 7.09375MHz/reg_divisor
        -- (or 193.5MHz/reg_divisor if clock709375 is not asserted).
        -- So we now have a clock which is the target baud rate.
        -- XXX We should adjust our timing position to try to match the phase
        -- of the sender, but we aren't doing that right now. Instead, we will
        -- use the simple consensus filtered RX signal, and just read it.

        -- Progress TX state machine
        uart_tx <= '1';
        if tx_in_progress = '0' and reg_status6_tx_empty='0' and reg_ctrl7_tx_enable='1' then
          -- Sent stop bit
          uart_tx <= '0';
          tx_in_progress <= '1';
          tx_bits_to_send <= 8 - to_integer(reg_ctrl23_char_length_deduct);
          tx_buffer <= reg_data_tx;
          reg_status6_tx_empty <= '1';
        end if;
        if tx_in_progress='1' then
          if tx_bits_to_send > 0 then
            uart_tx <= tx_buffer(0);
            tx_buffer(6 downto 0) <= tx_buffer(7 downto 1);
            tx_bits_to_send <= tx_bits_to_send - 1;
          else
            -- Stop bit
            -- XXX We don't support parity
            uart_tx <= '0';
            tx_stop_bit_sent <= '1';
          end if;
          if tx_stop_bit_sent = '1' then
            tx_in_progress <= '0';
            tx_stop_bit_sent <= '0';
          end if;
        end if;

        -- Progress RX state machine
        if rx_in_progress='0' then
          -- Not yet receiving a byte, so see if we see something interesting
          if filtered_rx='0' and reg_ctrl6_rx_enable='1' then
            -- Start bit
            rx_buffer <= (others => '1');
            rx_in_progress <= '1';
            rx_bits_remaining <= 8 - to_integer(reg_ctrl23_char_length_deduct);
          end if;
        else
          -- Receiving data, parity and/or stop bit
          if rx_bits_remaining > 0 then
            -- Receive next bit
            rx_buffer(6 downto 0) <= rx_buffer(7 downto 1);
            rx_buffer(7) <= filtered_rx;
            rx_bits_remaining <= rx_bits_remaining - 1;
          else
            -- Receive stop bit (or parity when we support it)
            rx_in_progress <= '0';
            -- Stop bit:
            if filtered_rx='0' then
              -- Received byte
              reg_status0_rx_full <= '1';
              if reg_status0_rx_full = '1' then
              end if;
              -- Allow short bytes
              case reg_ctrl23_char_length_deduct is
                when "01" => reg_data_rx(6 downto 0) <= rx_buffer(7 downto 1);
                             reg_data_rx(7) <= '1';
                when "10" => reg_data_rx(5 downto 0) <= rx_buffer(7 downto 2);
                             reg_data_rx(7 downto 6) <= (others => '1');
                when "11" => reg_data_rx(4 downto 0) <= rx_buffer(7 downto 3);
                             reg_data_rx(7 downto 5) <= (others => '1');
                when others => reg_data_rx <= rx_buffer;
              end case;
              -- XXX Work out parity and set state for reading it.
            else
              -- Framing error
              reg_status3_rx_framing_error <= '1';
              -- Make bad data visible, purely for debug purposes
              reg_data_rx <= rx_buffer;
            end if;
            -- XXX Assert IRQ and/or NMI according to RX interrupt masks
          end if;
        end if;
      end if;
    end if;

    if rising_edge(cpuclock) then

      porth_write_strobe <= '0';

      register_number(7 downto 5) := "000";
      register_number(4 downto 0) := fastio_address(4 downto 0);

      -- Calculate read value for various ports
      reg_porte_read <= ddr_pick(reg_porte_ddr,porte,reg_porte_out);
      reg_portf_read <= ddr_pick(reg_portf_ddr,portf,reg_portf_out);
      reg_portg_read <= ddr_pick(reg_portg_ddr,portg,reg_portg_out);

      -- Support proper tri-stating on port F and port G which connects to FPGA board PMOD
      -- connector.
      for bit in 1 to 7 loop
        -- Bit 0 of porte is the capslock key, which is input only
        if reg_porte_ddr(bit)='1' then
          porte(bit) <= reg_porte_out(bit) or (not reg_porte_ddr(bit));
        else
          porte(bit) <= 'Z';
        end if;
      end loop;
      for bit in 0 to 7 loop
        if reg_portf_ddr(bit)='1' then
          portf(bit) <= reg_portf_out(bit) or (not reg_portf_ddr(bit));
        else
          portf(bit) <= 'Z';
        end if;
        if reg_portg_ddr(bit)='1' then
          portg(bit) <= reg_portg_out(bit) or (not reg_portg_ddr(bit));
        else
          portg(bit) <= 'Z';
        end if;
      end loop;

      -- Check for register writing
      if (fastio_write='1') and (fastio_address(19 downto 16) = x"D")
         and (fastio_address(11 downto 5) = "0110000") then
        register_number(7 downto 5) := "000";
        register_number(4 downto 0) := fastio_address(4 downto 0);
        case register_number is
          when x"00" =>
            reg_data_tx <= std_logic_vector(fastio_wdata);
            reg_status5_tx_eot <= '0';
            reg_status6_tx_empty <= '0';
          when x"01" => null;
          when x"02" =>
            reg_ctrl0_parity_even <= fastio_wdata(0);
            reg_ctrl1_parity_enable <= fastio_wdata(1);
            reg_ctrl23_char_length_deduct  <= fastio_wdata(3 downto 2);
            reg_ctrl45_sync_mode_flags <= std_logic_vector(fastio_wdata(5 downto 4));
            reg_ctrl6_rx_enable <= fastio_wdata(6);
            reg_ctrl7_tx_enable <= fastio_wdata(7);
          when x"03" => reg_divisor(7 downto 0) <= fastio_wdata;
          when x"04" => reg_divisor(15 downto 8) <= fastio_wdata;
          when x"05" => reg_intmask <= std_logic_vector(fastio_wdata);
          when x"06" =>
            -- reg_intflag
            -- This register is not used in the C65 ROM, so we don't know how it
            -- should behave.  What is clear, is that there is some other mechanism
            -- besides reading this register that actually clears the IRQ.
            -- Perhaps just reading the data register is enough to clear an RX
            -- IRQ?  What about TX ready IRQ? It seems like writing a character
            -- or disabling the transmitter should clear it.
          when x"07" => reg_porte_out<=std_logic_vector(fastio_wdata(7 downto 0));
          when x"08" => reg_porte_ddr<=std_logic_vector(fastio_wdata(7 downto 0));

          when x"09" =>
            clock709375 <= fastio_wdata(0);
          when x"0b" => reg_portf_out <= std_logic_vector(fastio_wdata);
          when x"0c" => reg_portf_ddr <= std_logic_vector(fastio_wdata);
          when x"0d" => reg_portg_out <= std_logic_vector(fastio_wdata);
          when x"0e" => reg_portg_ddr <= std_logic_vector(fastio_wdata);
          when x"10" => porth_write_strobe <= '1';
          when x"11" => null; -- bucky keys readonly
          when x"12" =>
            widget_enable_internal <= std_logic(fastio_wdata(0));
            ps2_enable_internal <= std_logic(fastio_wdata(1));
            physkey_enable_internal <= std_logic(fastio_wdata(2));
            virtual_enable_internal <= std_logic(fastio_wdata(3));
            joy_enable_internal <= std_logic(fastio_wdata(4));
          when x"14" => portj_out <= std_logic_vector(fastio_wdata);
                        portj_internal <= std_logic_vector(fastio_wdata);
          when x"15" =>
            portk_internal <= std_logic_vector(fastio_wdata);
          when x"16" =>
            portl_internal <= std_logic_vector(fastio_wdata);
          when x"17" =>
            portm_internal <= std_logic_vector(fastio_wdata);
          when x"18" =>
            portn_internal <= std_logic_vector(fastio_wdata);
          when x"19" =>
            porto_internal <= std_logic_vector(fastio_wdata);
          when x"1A" =>
            portp_internal <= std_logic_vector(fastio_wdata);
          when others => null;
        end case;
      end if;
    end if;
```
**reg_status6_tx_empty** is driven by pixelclock and cpuclock.
If pasting the code is not convenient for you, i write the file name and line number instead.

gardners, 2017-10-27:
Hello,

The thumbnail_read_address <= (others => '0') is to reset the read pointer
for the thumbnail buffer.  Currently this happens if $D630 is READ. It
could be easily changed to be reset instead when $D630 is WRITTEN, which
would then place it in the ioblock.  This is more or less what you are
proposing, so it should be okay.

Paul.

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

Thread 41 (2017-11-20):

no compile - add m65fdisk src-files,

Ben-401, 2017-11-20:

Ben-401, 2017-11-20:
using the m65pcb-ports branch, and at toplevel, "make", getting to the stage where:
- kickup is compiled,
- on_screen_keyboard_gen etc is compiled,
- BANNER-M65 is compiled/generated,
then when an attempt to compile the "**mega65-fdisk**" PRG, it fails because the source-files are not in the directory.

Unsure where to get these.
The tail of the make-log is below.

```
src/tools/pngprepare/pngprepare logo bin/mega65_320x64_128colour.png sdcard-files/BANNER.M65
argv[0]=src/tools/pngprepare/pngprepare
argv[1]=logo
argv[2]=bin/mega65_320x64_128colour.png
argv[3]=sdcard-files/BANNER.M65
Reading bin/mega65_320x64_128colour.png
Input-file is: width=320, height=64.
Input-file is read and now closed
Processing with mode=0 and output=sdcard-files/BANNER.M65
mode=0 (logo)
Writing out palette of 87 values
done
src/tools/mempacker/mempacker -n shadowram -s 131071 -f src/vhdl/shadowram.vhdl sdcard-files/BANNER.M65@3D00
131071 bytes written
gcc -Wall -g -std=c99 -o src/tools/utilpacker/utilpacker src/tools/utilpacker/utilpacker.c
../Ophis/bin/ophis -4 src/border.a65 -l bin/border.list -m bin/border.map -o bin/border.prg
Assembly complete: 92 bytes output (12 code, 71 data, 9 filler)
( cd src/mega65-fdisk ; make )
make[1]: Entering directory '/home/gerb0002/dev/github/mega65/mega65-core-pauls/src/mega65-fdisk'
make[1]: *** No targets specified and no makefile found.  Stop.
make[1]: Leaving directory '/home/gerb0002/dev/github/mega65/mega65-core-pauls/src/mega65-fdisk'
Makefile:237: recipe for target 'src/mega65-fdisk/m65fdisk.prg' failed
make: *** [src/mega65-fdisk/m65fdisk.prg] Error 2
```

gardners, 2017-11-20:
git submodule init
git submodule update

before compiling will check them out.  This is standard for nested git
repositories.

Paul.

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

Ben-401, 2017-11-20:
```
$ **git submodule init**
Submodule 'src/mega65-fdisk' (git@github.com:MEGA65/mega65-fdisk.git) registered for path 'src/mega65-fdisk'
$ **git submodule update**
Cloning into 'src/mega65-fdisk'...
The authenticity of host 'github.com (192.30.255.112)' can't be established.
RSA key fingerprint is SHA256:nThbg6kXUpJWGl7E1IGOCspRomTxdCARLviKw6E5SY8.
Are you sure you want to continue connecting (yes/no)? yes
Warning: Permanently added 'github.com,192.30.255.112' (RSA) to the list of known hosts.
Permission denied (publickey).
fatal: Could not read from remote repository.

Please make sure you have the correct access rights
and the repository exists.
fatal: clone of 'git@github.com:MEGA65/mega65-fdisk.git' into submodule path 'src/mega65-fdisk' failed
```
i then added git config user.name and user.email, and tried again
```
$ **git submodule update**
Cloning into 'src/mega65-fdisk'...
Warning: Permanently added the RSA host key for IP address '192.30.255.113' to the list of known hosts.
Permission denied (publickey).
fatal: Could not read from remote repository.

Please make sure you have the correct access rights
and the repository exists.
fatal: clone of 'git@github.com:MEGA65/mega65-fdisk.git' into submodule path 'src/mega65-fdisk' failed
```
Any ideas?

gardners, 2017-11-20:
Hello,

Probably the issue here is that the git submodule references are by ssh
instead of https.  You can try modifying .gitmodules to use an https URL
copied from the repository "clone or download" option.

Paul.

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

Ben-401, 2017-11-21:
I could not get it to update the submodule.
So I manually cloned into the ./src dir, ie
```
cd src
git clone https://github.com/MEGA65/mega65-fdisk.git
cd ..
```
and the above worked fine.

below is what i tried when modifying the gitmodules file:
```
$ cat .gitmodules
[submodule "src/mega65-fdisk"]
	path = src/mega65-fdisk
	url = https://github.com/MEGA65/mega65-fdisk.git
$ git submodule update
<error as in above post>
```
I do not know how to fix this, but have provided a work-around.

Ben-401, 2018-02-06:
i have found that you need to "git submodule init" after any change to the .gitmodules file.

further, a clean checkout of the mega65-core repo was necessary to allow the modified ".gitmodules" file to work with "git submodule init" && "git submodule update".

refer to "builder" branch based on px100mhz, dated 6-FEB-2018.

gardners, 2018-02-08:
Assuming fixed by pull request #48.

Closed 2018-02-08.

Thread 72 (2019-03-19):

RESET approach in the Mega65 - suggestion

adtbm, 2019-03-19:
Testing the latest Bitstream and the soft Reset implementation
i thought about the main approach of doing a Reset on the Mega65.

How is it about, of making it possible, to swap inside the Freeze menu, between a soft reset and a Reset, without module check.
So a kind of a Hard Reset, maybe toggle between the two by pressing "R" and swap the "F5" key description accordingly between (F5 - (S)-Reset) and (F5 - (H)-Reset)

This would result, that the user would have the possibility of 3 different Reset functions , excluding Powering Off/On the Mega65:

1 x Soft reset (like shortening pin 1 and 3 on the c64 userport or typing SYS64738)
      - via Freeze Menu (S)-Reset
1 x Hard Reset (excluding the module check)
      - via Freeze Menu (H)-Reset
1 x ultra Hard Reset/Reboot
      - via Reset button on the Mega65

adtbm, 2019-03-19:
Issue is solved after speaking with Paul.

planned update:
Whenever doing a Reset (pressing " F5" inside the freeze menu), it will be checked for a module signature at $8000-$8009. If one exists, then the user will be asked, if it should be ignored or not and the Reset will be done accordingly.
"F6"-Key could be used for Hard Reset.

rdpeake, 2021-02-05:
Moved to mega-freezemenu as freezer now lives over there

Closed 2021-02-05.

Thread 104 (2019-09-19):

CIA timer problem

lgblgblgb, 2019-09-19:
During my experiment with IP65 TCP/IP stack I found a problem. IP65 needs some timing info, and it uses CIA timers for that purpose. It seems it fails on M65 but works in C64 (at least tested with VICE by me). The actual code what IP65 uses can be seen here:

https://raw.githubusercontent.com/cc65/ip65/master/drivers/c64timer.s

I quickly hacked some lame test program to isolate these functions only.
[c64timer_test.zip](https://github.com/MEGA65/mega65-core/files/3633031/c64timer_test.zip)

It simply shows the values given by those functions. On C64 the first 16 bit number normally increases, on M65 it's always zero. The second single byte is the second counter from TOD, that seems work on both of C64 and M65.

For more information how IP65 wants to use CIA exactly please see the source link above, it has some comments as well.

gardners, 2019-09-20:
The problem seems to be related to timer b counting timer a underflows.  The logic in the VHDL was crazy, and I have simplified it.

lgblgblgb, 2019-09-20:
As far as I see it fixed the problem by looking the result of my test program and compared with C64 (using VICE). The ethernet thingy we talk about is another question, not related this one, I guess :) Thanks.

lgblgblgb, 2019-09-21:
Still with CIA stuff, I measured 20sec of TOD second counting on the screen as about 29sec of real time with the stop watch app of my smart phone :) So it seems M65 TOD update is about 50% slower than it should be? But also NTSC/PAL stuff can effect this maybe (I am not sure) bit not as much as here I noticed, probably. Interestingly the timer value looks like in pair what VICE/x64 shows just the TOD looks slower.

lgblgblgb, 2019-09-21:
Interestingly even on VICE 30 sec real of "TOD time" is 36 sec real time, though I tried with PAL/NTSC, sounds interesting (real CIA - AFAIK - would maintain TOD clock from the 50/60Hz sampled from the power supply 9V AC, IIRC so it depends on the region of frequency of the mains ...). But with M65 the difference looks bigger anyway.

Closed 2021-02-28.

Thread 106 (2019-09-21):

CIA TOD seems to be too slow

lgblgblgb, 2019-09-21:
Still with CIA stuff, I measured 20sec of TOD second counting on the screen as about 29sec of real time with the stop watch app of my smart phone :) So it seems M65 TOD update is about 50% slower than it should be? But also NTSC/PAL stuff can effect this maybe (I am not sure) bit not as much as here I noticed, probably. Interestingly the timer value looks like in pair what VICE/x64 shows just the TOD looks slower.

Interestingly even on VICE 30 sec real of "TOD time" is 36 sec real time, though I tried with PAL/NTSC, sounds interesting (real CIA - AFAIK - would maintain TOD clock from the 50/60Hz sampled from the power supply 9V AC, IIRC so it depends on the region of frequency of the mains ...). But with M65 the difference looks bigger anyway.

The TOD second value can be seen with my test program mentioned and included in issue #104

gardners, 2020-02-29:
Confirmed that problem is real.

gardners, 2020-02-29:
Above commit patches i2cstatus.c to also show CIA TOD with RTC, so that we can very easily compare speeds.

Ideally we should switch between 50Hz and 60Hz clock, based on PAL vs NTSC.

gardners, 2020-02-29:
Above commits should fix the remaining known discrepencies.

frehwagen, 2020-03-16:
Fixed and successfully tested together with #163, merged back to stable_base so this is going to close now.

Closed 2020-03-16.

Thread 114 (2019-11-03):

PAL/NTSC Cycle-Accurate and HDMI-Compatible video modes needed

gardners, 2019-11-03:
The current video modes are VGA-oriented, and have  a number of problems:
1. They are not 63/65 VIC-II cycles per raster-line.
2. They have the wrong number of raster lines.
3. They use different dot clocks from one another, which causes shimmering in different modes, because the buffering for this is rather borked.
4. They won't work on HDMI, for many of the above reasons.

Thus we need to switch to the 27MHz dotclock HDTV modes for PAL and NTSC, but ideally in a way that still works on most VGA monitors. It may not be possible to make it work on all VGA monitors.

VGA output will likely need to be masked to 720/640 pixels wide, to avoid wrong colour correction.

There is significant work on this already on the unstable branch.

gardners, 2019-11-04:
The main remaining problem is that the video image appears on the wrong place on many monitors. This likely comes from the fact that we are producing a 800 pixel wide image, but the VGA modes want only 720.  So we should make sure that those front and back porches of 40 pixels either side are black.  But we want at the same time to provide the full 800 pixels wide for the MEGAphone. Thus the commits above provide two output streams, one 800 wide and the other narrower, as required.

gardners, 2019-11-06:
My LG TV thinks the 720x480 60Hz NTSC mode via VGA is 640x350 60Hz, with screen shifted down and right a bit, as well of course of looking way too large, so only part of the screen fits on.
Same LG TV refuses to even display the 720x576 50Hz PAL mode.

gardners, 2019-11-06:
Confirmed HSYNC and VSYNC polarity has no effect on these problems.

gardners, 2019-11-09:
The work on the unstable branch to get HDMI output working is progressing.
It is now at the point where running the src/utilities/hdmitest.a65 program and pressing SPACE a couple of times will configure the ADV7511
correctly, including retreive EDID info. The effect is that a connected HDMI monitor will begin receiving an HDMI signal.  The problem is that the display, however, remains blank.

gardners, 2019-11-13:
Considerable further work has been done on the unstable branch, such that we now have working HDMI output, and also VGA output that seems to work on a majority of monitors.
Deft etc have undertaken initial testing of this, and it seems to be functional, and thus can be merged into the 114 feature branch, in preparation for closing this issue.

gardners, 2019-11-16:
A sub-problem is that the $D012 raster counter is still not counting in the VSYNC period, which breaks some things. This is being fixed also.

gardners, 2019-11-27:
See also #146

adtbm, 2019-12-07:
Tested Bitstream on Nexys4 & Widget.

- 1st monitor: (LCD Panel) Video looks good:
PAL has a black frame on the right and upper side:

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

NTSC looks OK:
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

Older VGA monitors didn't received a signal at all.

adtbm, 2019-12-07:
Test with R2 board,
bitstream: mega65r2-20191202.19-HEAD_n-b03d929+DIRTY.bit

Attached R2 to HD 720p Beamer.
But when pressing the RESET Button on the MEGA65 reboots and shows for a splitsecond , the MEGA65 display Look Here:

frehwagen, 2019-12-21:
Finally this has been merged to stable_base branch. All open finding has been separated into new issues, so lets close this.

Closed 2019-12-21.

Thread 115 (2019-11-03):

Fix keyboard rework in unstable branch

gardners, 2019-11-03:
The keyboard matrix stuff in keyboard_complex was switched from using a 72-bit parallel interface to a little RAM block. This saves LOTS of FPGA resources. Unfortunately, right now it causes problems with the Widget board.  The exact problem needs to be identified and then dealt with.

gardners, 2019-11-06:
The problem is bad keyboard behaviour with widget board, and with any target when CPU is at 40MHz.
To reproduce, try typing using widget board, and it will sometimes print the wrong characters.
Also, if you POKE0,65 to set the CPU to 40MHz, the keyboard on any target will be very horrible to use.

gardners, 2019-11-06:
Confirmed resolved for nexys4ddr-widget target

gardners, 2019-11-06:
Confirmed fixed on mega65r2 target with real keyboard.

I now consider this problem fixed.

adtbm, 2019-11-08:
OK i can confirm #115 with freshly formated SD card on NEXYS4DDR+WIDGET
- naming internal incorrect
    name of bitstream on Scryptos: nexys4ddr-widget-20191105.02-HEAD_n-13bf229+DIRTY.bit
    name internally during bootup: (.13BF229+DIRTY.20191104.23
- c64/c65 keyboard works in 40 MHz
- Freezer menu crashes on leaving (entering works)
- loading d81 works
- NTSC video looks good
- PAL can't test (Freezer crashes)

frehwagen, 2019-11-08:
Fixed on stable_base build #2 by merge commit https://github.com/MEGA65/mega65-core/commit/98f8500eb2f50836b2baaf0fb45feef18f871c09, finally we are able to close this issue.

Closed 2019-11-08.

Thread 116 (2019-11-03):

Fix D81 / DMD disk image handling in unstable branch

gardners, 2019-11-03:
D81 mounting is currently not working on the unstable branch.
Find problem and fix.
Suspect the recently implemented MEGAdisk support as the cause.

frehwagen, 2019-11-11:
While it seems that the D81 mount issue was a broken image file on sd card, we will use this ticket to properly integrate MEGAdisk support into stable-base branch.

gardners, 2019-11-13:
Fixed by commit ba65cb53efdcb3535bdad927a2147541cc002a86

gardners, 2019-11-27:
Proposed test procedure:
1. Use freezer to set drive 0 and 1 both to "- no disk -".
2. DIR U8 -> should give ?DOS: DRIVE NOT READY
3. DIR U9 -> should give ?DOS: DRIVE NOT READY
4. Use freezer to set drive 0 to "- internal 3.5" -"
5. DIR U9 -> should give ?DOS: DRIVE NOT READY
6. DIR U8 -> should show directory of disk in drive, or hang if no disk inserted (See #147 )
7. Reset (solves hang problem if you had no disk to insert in (6)).
8. Use freezer to set drive 0 to a disk image, and drive 1 to "- no disk -"
9. DIR U8 -> should show directory of selected disk image
10. DIR U9 -> should give ?DOS: DRIVE NOT READY
11. Use freezer to set drive 1 to a disk image, and drive 0 to "- no disk -"
12. DIR U8 -> should give ?DOS: DRIVE NOT READY
13. DIR U9 -> should show directory of selected disk image
14. Use freezer to set drive 0 to one disk image, and drive 1 to another disk image.
15. DIR U8 -> should show directory of first disk image selected
16. DIR U9 -> should show directory of second disk image selected

Closed 2019-11-13.

Thread 118 (2019-11-03):

Check joystick pot input circuitry on MEGA65r2 PCB for completeness and correctness

gardners, 2019-11-03:
We should ;probably try to do this sooner rather than later, so that any fix can be incorporated into the r3 PCB for the devkits.

adtbm, 2019-11-04:
#122

gardners, 2019-11-04:
It needs to work with 1351 mouses and paddles.  The mouses in particular require behaviour that matches the C64, i.e., using a threshold comparitor and having a drain driver for pulling the line low.

gardners, 2020-02-13:
It looks like all we need to add is some 1.2nF capacitors between the POT lines and GND on the joystick ports.

gardners, 2020-02-13:
Looking more closely at the JA_POTX (and friends) lines on the FPGA, it looks like by substituting R77 for 0 Ohm, C130 for 1.2nF, removing R75 and R73 would get the circuit mostly right, except that it would not have any voltage conversion from 5V down to 3.3V.

gardners, 2020-02-13:
Ideally the circuit would be quite different, however:

1. JA_AX would be connected to the top of a transistor that when enabled, would pull the line to ground.  The enable line for this transistor would be connected to some pin on the FPGA.  This pin can be shared for all four pot lines.
2. JA_AX would also be connected to a 1.2nF capacitor whose other pin is connected to GND.
3. JA_AX would also be connected to the input of a 5.5V to 3.3V level converter (or something else that can limit the voltage to no more than 3.3V.

For testing, this could be perhaps be bodged by removing R73, R77, R75 and C130, and then using those pads to connect the necessary circuitry to.
Alternatively, we could make an adapter for the joystick ports that contains the necessary circuitry inline.

Either way, a first step could be to implement the circuit on a PMOD board.

gardners, 2020-02-14:
Found this specifications document for the 5717 chip in the 1351 mouse:

http://cbm-hackers.2304266.n4.nabble.com/attachment/4660682/0/5717spec.txt

Also confirmed with gnucap that the current configuration basically varies between 0V and about 0.85V when fed with between 0V and 5V as input.  So safe to use as is, just won't work with the 1351 mouse.

From the 5717 documentation: The SYNC input (which is just connected to a POT line with a 5.1K pull-up, as far as I can tell) must be <=1V to be considered low, and >=4V to be considered high.

I can see no simple way to replicate this by just changing values of the existing passives on the POT lines, that doesn't also result in >3.3V on the FPGA pins.

In short, we need to have the level converter and transistor method.

gardners, 2020-02-14:
This means adding a NC7SZ126P5X and transistor for each of the four pot lines, removing the resistors and capacitors currently there, and having. As there are already enough signals routed to the joystick ports, this should hopefully not require significant re-routing of the PCB.

The challenge is how to test before the board gets re-spun, so that we can be 100% sure it will work.

The various parts of this have been done before in:

http://c65gs.blogspot.com/2018/01/working-on-paddles-and-mouse-support.html

We should indeed make up a PMOD that implements an entire joystick port, and test it out.

Closed 2021-02-09.

Thread 122 (2019-11-04):

Pull-up resistors are needed on R3 board for Joystickports and internal discdrive

adtbm, 2019-11-04:
on the R2 Board the Pull-up Resistors are missing for the Joystick ports and the internal discdrive.
Those missing Resistors need to be implemented in the R3 board layout design.

adtbm, 2019-11-04:
sorry, i've seen it to late, that Paul already opened an issue

Closed 2021-02-08.

Thread 126 (2019-11-06):

Freeze menu should offer disk chooser for both drives

gardners, 2019-11-06:
Currently you can't choose a disk image for the 2nd internal drive.  This should be fixed.

gardners, 2019-11-15:
Fixed in unstable branch + updates to freeze menu.

bluewaysw, 2019-11-19:
This is beeing handled on the 116- branch together with issue #116 related changes.
Just decided to include 2 real floppy support to the branch as well, because it already contains a lot of fixes that relate to the dual drive support in freezer/disk chooser.

adtbm, 2019-11-25:
reviewing #116 issue.
i have encountered issues mounting images.
in my example i mounted an image to drive ID#0 and an Image to Drive ID#2
it resulted, that the internal 3.5 floppy drive was accessed while loading "$",9 NOT the image i've mounted

1st picture shows current mounting state after powering on:
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

2nd picture shows image loaded for ID 0
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

3rd picture shows image loaded for ID 1
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

4th picture shows mounting state after mounting images to 0 & 1 -looks ok-
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

5th picture shows correct mounted image after LOAD"$",8   -OK-
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

6th picture shows INCORRECT mounted drive after LOAD"$",9   -NOT OK-
It shows the content of the 3.5 floppy disc.

so the previousely mounted image for ID 1 has not been mounted, but the 3.5 disc drive has been moved from ID0 to ID 1 and has been mounted as ID 1
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

adtbm, 2019-11-25:
This behaviour is reproduceable and happens every time

adtbm, 2019-11-25:
UPDATE this BUG only happens when the image, you try to mount to ID0 is MEGA65.d81

adtbm, 2019-11-25:
Pauls updated (redesigned) Freezer from today (posted in Skype 12:51), solves the problem

Closed 2021-02-09.

Thread 127 (2019-11-06):

Can't talk to 7511 HDMI driver via I2C

gardners, 2019-11-06:
MEGA65 r1/r2 uses an ADV7511 HDMI driver.
We need to talk to it via I2C to setup various registers.
However, we are unable to get it to respond right now.
src/utilities/hdmitest.prg should show register values.
Doesn't work on SN#000001 pre-series.
I seem to recall that we had it returning register values on some machine, maybe SN#000004, but I'm
not sure.
Next step is probably to probe the SDA and SCL lines on the 7511, to see if we see them waggling.

gardners, 2019-11-06:
Various references for the 7511:

https://www.analog.com/media/en/technical-documentation/user-guides/ADV7511_Programming_Guide.pdf
https://www.analog.com/media/en/technical-documentation/user-guides/ADV7511_Hardware_Users_Guide.pdf

gardners, 2019-11-06:
Suspecting that SCL and SDA might we swapped around. Synthesising a fix for that.

gardners, 2019-11-07:
SDA pin looks like it works.
SCL pin not so much.
According to schematics, the pin for SCL was wrong.  Correcting, and retesting.

gardners, 2019-11-07:
Confirmed correcting that pin in commit ecc0b615f1b6175c1936d6cc3b2f962a4f7fbbb9 fixed the wiring problem.  Then fixed the test utility in commit 2880d7cd152ee68b70cc89aadd4b37d97caffa4c to the
point where we are getting replies.

gardners, 2019-11-08:
Next step: We need to activate the TPD12S016 level-shifter on the HDMI interface, so that the HDMI hot-plug detection and EDID work.  Without this, the 7511 will never leave power-down mode, and thus wont let us write to most I2C registers, and of course, won't produce an image.

See: http://www.ti.com/lit/ds/symlink/tpd12s016.pdf for datasheet.

Commit 84842d3e42acfa47bb6fcb82c5bdae4c0310109f attempts to plumb the CT_HPD and LS_OE and HPD_A lines to the FPGA model, so that we can control them.

gardners, 2019-11-08:
Further background on the 7511's I2C behaviour during power-down: https://ez.analog.com/video/w/documents/837/when-i-try-to-write-to-i2c-registers-of-the-adi-hdmi-transmitter-the-register-values-do-not-change-what-is-going-on

gardners, 2019-11-08:
Confirming that plumbing those lines has seemingly enabled the HDMI to seemingly power up.  Testing whether it allows changing of registers after that.

gardners, 2019-11-09:
ok. I2C communications are fine. Remaining problems are with actually getting an HDMI image.  Will open a separate issue for this.

Closed 2019-11-09.

Thread 129 (2019-11-08):

Bug reading files from real floppy disk directory

deftmega, 2019-11-08:
Around "the middle" of the directory, better end of 1st third, one or two files are not readable. you see them in the directory but get "file not found" if you try to load. or the load process just hangs and never ends.1st is more common. Anton: i can confirm this one ! it loads the file from a real 1581 ! but not from MEGA internal drive (from Skype chat)

gardners, 2019-11-09:
If you check which track/sector good and bad files start from, this would be great.  Basically any clues as to what is going on will be helpful.

gardners, 2020-05-29:
I have been investigating this, and the related problem with it being even less reliable on newer bitstreams.  There seems to be a few things going on:

1. The /DISKCHANGE line from the floppy doesn't seem to always occur.
2. When mounting a disk image or swapping from image to real floppy, there is no simulated /DISKCHANGE event, so DOS can get confused.
3. DOS can think the real floppy drive is on a different track than the one it is really on.  This is likely the cause of the read errors on some tracks, as it gets out of sync, and of course never knows to get back into sync.
4. If the drive hasn't gone to track 0, the head can be sitting funny, and not read properly (this shows up as very diffuse / random magnetix flux inversion intervals.

So, to fix it:
1. I am patching freeze menu disk chooser to always seek to track 0 when mounting a disk.
2. Adding a simulated /DISKCHANGE signal, that allows the dism image mounter to force a disk change event, even if the real drive doesn't support it.

But I still need to work out how and why the tracks get out of step. Are we stepping too quickly when using SD card? Because in theory at least, the drive head should always be matching the position of the SD card disk image from the DOS's perspective.

gardners, 2020-05-29:
Confirmed with floppytest utility from mega65-tools, that the drive ends up one track out sometimes.  We are not yet sure why.  To solve this once-for-all, we are implementing an auto-tuner for the drive controller, so that whether you have just switched to real floppy, or it has got out of sync otherwise, the drive will automatically step towards the track you are looking for. This relies on having a disk inserted that has the correct track numbers on its sectors, so some copy-protection schemes could confuse it badly.  But there aren't many for 1581 software, so I'm not expecting much trouble.

gardners, 2020-05-31:
I believe the auto-tuner has fixed this problem. The fix is staged on 138-hdmi-audio-27mhz (#138).

gardners, 2020-05-31:
The fix now requires independent confirmation.
Use -b @138/47

@frehwagen can you please test under GEOS?

@deftmega can you please test or delegate testing loading files from further down on directory of 1581 disks? (the 1581 disks I have here are empty, so I can't do it myself, unless I get floppy writing working, which is another whole kettle of fish)?

Once both tests are in, we can advance to fix test confirmed.

deftmega, 2020-06-02:
Okay, I understood I should test issue 129 bitstream and came to the result, that it still hangs not finding one track, especially if I reset the MEGA65 while holding the MEGA key - because this does not reset the drive. When I rebooted into C65 mode and heard the drive reset, reading got better afterwards. So, after reading the above, I think that Paul is totally on the right track and will now head over to testing 138/47 and then report back here!

frehwagen, 2020-06-02:
Ok, testing #129, this is interesting, independent of @129/1 or @138/52:
I tested with 3 alternative drives as replace ment of the internal one. 2 of the alternatives work, while the original internal one and another one isn't.

Initially I was a bit mixup, because bit 4 of $D689 is diffently used in #217, which I already integrated into the currentl GEOS version.

gardners, 2020-06-02:
I'll try to reproduce the problem Deft reported.

Falk: To clarify, with this bitstream it works on all of your drives now?

frehwagen, 2020-06-03:
No, 2 drives work, the other 2 doesn't work, show the same problem I observed before.

gardners, 2020-06-03:
Update: I believe we have all agreed that auto-tune solves the first part of the problem, but that reading sectors can still get stuck, which we need to continue to investigate.

frehwagen, 2020-06-15:
I tested with GEOS and saw the same hanging when reading bytes for the blocks. Switching to DMA makes the floppy operation stable and reliable in GEOS, so I can confirm general disk reading work fine, but there is still something with the byte access.

gardners, 2020-06-15:
Thanks for the looking into this. My gut feeling is that there is a bit of a race condition with the stuffing and emptying of the floppy circular buffer, i.e., the handling of the buffer pointers and empty/full flags.  I guess for now use DMA in GEOS, and we should aim to create a simple test programme that can reproduce the problem, so that we can better characterise the problem and then confirm when we have a fix for this.

Closed 2021-02-15.

Thread 136 (2019-11-16):

Suspect 1mhz branches get charged too many cycles sometimes

gardners, 2019-11-16:
Run wizball in PAL, and it will mostly work, but that the display flickerse with interrupts seeming to happen only every other frame, because something is going to slowly.  Disable charging for branches taken ($D7FB bit 0), and the problem goes away.

I have also seen indications elsewhere the branches might be incorrectly billed cycles, e.g., in synthmark64 results at 1mhz looking a bit low for things involving branches.

Needs to be investigated and fixed.

A temporary workaround is probably to just disable charging for these, as slightly too fast CPU shouldn't cause many problems compared with slightly too slow.

gardners, 2019-11-16:
Just as likely actually that badlines are getting triggered in the lower border.

gardners, 2019-11-16:
It looks like it might well be the triggering of badlines in the lower border that was the problem. In any case it has fixed it. There is still a funny glitch with the switching the vertical smooth scrolling from the score banner to the main playfield

gardners, 2019-11-16:
@frehwagen this one can also get merged in and closed when you are happy with it.  The remaining problems will become a separate issue.

lydon42, 2022-10-02:
From the commits this looks not like it was ever merged. Is this still a problem in recent cores? Who knows how to check?

Thread 138 (2019-11-17):

Get HDMI audio output working

gardners, 2019-11-17:
Self-explanatory.

Depends on #114

gardners, 2019-11-17:
Begun implementing this.

Using the hdmidebug target, I am able to play a tone, but it is being  badly shaped, a the following images show:

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

The waveform is smooth, just badly enveloped.

Changing the HDMI initialisation frequency in vga_hdmi doesn't change the ~4Hz pulse train, so it is not some HDMI setup thing.

That the waveform is smooth suggests to me that it probably isn't samples being missed, but its hard to know for sure.

gardners, 2019-11-18:
New fascinating clue: HDMI video works with SPDIF audio enabled, only in NTSC mode: In PAL mode, the screen goes blank.  SPDIF audio is still very broken up in NTSC mode, so something is still not right.

gardners, 2019-11-18:
Found this nice reference: https://www.av-iq.com/avcat/images/documents/pdfs/digaudiochannelstatusbits.pdf

There should be 192 sample PAIRS per sub-frame, not 192 samples, according to this.  Reading more...

gardners, 2019-11-18:
But that might be wrong, as with that, there is not even an HDMI image.
What might also be an issue is if the parity bit is 1, then we need the inverted preamble.  It doesn't look like that ever actually gets sent.

gardners, 2019-11-18:
Another source also indicates 192 x L+R pairs: http://www.hardwarebook.info/S/PDIF
But finding good source material seems to be hard...

gardners, 2019-11-18:
Trying a different SPDIF implementation from OpenCores in case it solves the problem.

gardners, 2019-11-18:
So, still no picture with PAL mode when SPDIF audio is enabled.  But still picture NTSC mode, even if audio is enabled.  STill not convinced the audio is right. Will build full bitstream to test with games.

gardners, 2019-11-18:
Full bitstream: Still no picture in PAL. Picture and broken HDMI audio in NTSC.  Commando music reveals that it seems to be eliminating all high-frequencies.  That is, it sounds like only some samples are being accepted.  Note that this is with a totally different SPDIF implementation to before. This makes me think that something with the ADV7511 setup is wrong.

gardners, 2019-11-19:
See also commit 910ab4753ccd15754e3a0315c656bd80be01d266

gardners, 2019-11-19:
I forgot to tag that commit with this issue, but it might well be the fix: Set N and CTS values for the audio stream, so that proper clock recovery is possible by the receiver.  This at least made LOUD noise come out of the headphones with the test bitstream.  PAL video mode is still blank and silent.

gardners, 2019-11-19:
Build into full mega65r2 target bitstream, and music is now quite recognisable, but still badly distorted using earbuds in the HDMI monitor I have here.  HDMI TV still doesn't want to give a picture in either NTSC or PAL mode, but that might be HDMI interrupt handling, which I have reverted, and will try on a fresh bitstream when ready.

gardners, 2019-11-19:
I get the distinct impression that the problem is the N and CTS values need fine-tuning.  The best solution to this is to allow reading and writing of the I2C registers of the 7511 directly, as well as the automatic initialisation via the i2c_sender, that way I can fine tune the values without having to do repeated synthesis runs.

gardners, 2019-11-20:
Apparently it isn't unusual to have problems with Audio Clock Recovery (ACR) in HDMI:

http://www.aes-media.org/sections/uk/Conf2011/Presentation_PDFs/14%20-%20john%20dawson%20-%20Audio%20Transport%20over%20HDMI%20-%20AES%202011.pdf

This also adds weight to the theory that getting the N and CTS values right is our best hope.  Certianly wrong values (like now) are going to hurt things.

Alternatively, we can increase the sample rate to 44100*(27.083333/27) and rely on the receiver to deal with the 0.31% difference as it would for any normal clock drift.  This would be 44237 samples per second in the SPDIF transmitter.

gardners, 2019-11-20:
The first option didn't work, so the above commits try the alternative of increasing the sample rate.

gardners, 2019-11-20:
That didn't work either. So let's take a step back, and implement a full R/W I2C memory mapped interface for the ADV7511, so that we can see what it thinks about the audio etc.
Will need to also add the i2c_sender functionality, so that it can automatically initialise the HDMI TX when required.

gardners, 2019-11-22:
Going slightly mad trying to get the memory-mapped I2C registers working.  Mapping of the existing M65R2 I2C registers is also being flaky, so suspecting the clock frequency bump might have pushed things out of tolerance, but need to investigate further.  Need a test harness for the I2C stuff, so that I can quickly make sure whether the hdmi_i2c stuff is actually correct or not.

gardners, 2019-11-22:
ok, with new HDMI I2C control and memory mapping of registers we are back to automatically configuring the HDMI display -- although it doesn't re-configure when monitor turns off or is disconnected, only on initial power up.  Writing to an ADV7511 register does trigger it, however.

gardners, 2019-11-22:
(The last commit above is a potential fix for this problem).

gardners, 2019-11-22:
It now mostly works, but the 7511 doesn't get powered back up after HDMI link loss. This means that the screen doesn't come back on automatically if monitor gets turned off and on.  Fix this by checking register $41 in our existing infinite read loop, and powering the chip back up if it has been powered off.

gardners, 2019-11-23:
Wrote HDMI status debug utility that lets me see things like N and CTS values.  This revealed that detected CTS was double the expected value, indicating we are generating samples at 88.2KHz, not 44.1KHz. Thus we need to double the value of N, and keep CTS the same.

gardners, 2019-11-23:
Well, that didn't fix it. But being able to play with registers in real-time revealed some things:
1. You have to turn HDMI audio TX off via reg $0A before you can change things like auto/manual CTS.
2. Switching to auto CTS got HDMI audio working very nicely in NTSC! (commits follow)

gardners, 2019-11-23:
Now to figure out why PAL video still shuts down when audio is enabled...

gardners, 2019-11-23:
Audio level is still WAY too high for HDMI audio. Mixer values need to be like $0707 or lower, so we are still at least 5 bits too loud.  Also some static in the sound sometimes (e.g., in parts of the krakout music).

gardners, 2019-11-23:
Static seems to be constant level, i.e., it sounds relatively louder if you reduce audio mixer gain, and quieter if you increase audio mixer gain.

gardners, 2019-11-23:
Not audible when there is no sound playing. Is it some harmonic of SID to HDMI audio output?

gardners, 2019-11-23:
For PAL mode, anything that ceases the audio stream restores video, including switching from SPDIF to another audio source, or telling the ADV7511 that the audio source uses external MCLK instead of recovered MCLK.

gardners, 2019-11-24:
Have gone through all ADV7511 I2C main map registers and confirmed that everything looks right in PAL vs NTSC modes, but PAL mode still shows no video when SPDIF audio is enabled. Running out of ideas as to what could be the cause.

gardners, 2019-11-25:
Found a possible cause: In PAL video data continues one raster line into the VSYNC period, which might be confusing the ADV7511.  Trying to fix this now...

gardners, 2019-11-27:
Some TVs/monitors have very broken audio, suggesting we aren't indicating the audio sample format correctly.

gardners, 2019-11-27:
Varying I2C register 14 doesn't change it.
Is it bigendian/littleendian perhaps?
Or just 192khz audio sample rate?

deftmega, 2020-03-17:
PAL over HDMI broken on HANNS-G 27" Monitor:
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

Disabling Audio completely makes it worse and adds flickering!

gardners, 2020-05-10:
Issue #165 has added perfect 27MHz pixel clock.  I'll see if that doesn't help us get HDMI audio working with the ADV7511 on all monitors.

gardners, 2020-05-31:
Compatibility test reports are being gathered in:

https://docs.google.com/spreadsheets/d/1Eg2ADZKcW-mgzo7DsoEzXYScAOobrWCLVbrtxMsdCtE/edit#gid=0

Closed 2021-02-15.

Thread 139 (2019-11-17):

HDMI video briefly blinks off sometimes

gardners, 2019-11-17:
Very likely this is due to the way we update the HDMI I2C registers continuously.  Switching it to instead reconfigure whenever an interrupt is received from the ADV7511 should fix it.

gardners, 2019-11-22:
Various fixes in #138 may well fix this problem, or at least mitigate it. This includes interrupt driven automatic reenabling of the link, instead of blindly setting the registers 4 times a second.
The blinking could also be due to losing the HDMI link because of out of tolerance timing due to 27.083 vs 27.000 MHz pixel clock, since enabling the audio stream currently totally kills display in PAL mode.

gardners, 2019-12-08:
Haven't seen this issue for a while.  Will close 20DEC2019 if it is not seen again by then.

rdpeake, 2021-02-15:
Closing as no comment about it being seen since 20 december 2019

Closed 2021-02-15.

Thread 141 (2019-11-19):

Virtual VDC support is needed

bluewaysw, 2019-11-19:
To make MEGA65 compatible to run main GEOS 128 application in high resolution it is required to support a virtual VDC interface. We plan to simulate required VDC functionality by implementing related hypervisor traps. The FPGA implementation need to map the register access to related traps.

gardners, 2019-11-20:
You have a fair bit of this done already, right?

frehwagen, 2019-12-02:
Yes, it is about bringing it to kickstart/stable base, some cleanup and some more testing.
In general the VDC registers conflict with C65 uart registers, so and flag to enable VDC operation needs to be added as well.

gardners, 2019-12-03:
For the C65 UART register conflict, I'd make the traps only work in VIC-II IO mode, as no C128 GEOS app should need access to C65 registers.

gardners, 2019-12-10:
Above commits are first attempt to implement emulated VDC register and memory access. This happens in the CPU's memory re-mapping part.

gardners, 2020-01-04:
There was a problem with this causing the freeze menu to hang. Not sure of the actual cause. As a first defensive measure, I have made the VDC support so that it only works outside of hypervisor mode.

gardners, 2020-02-08:
Yes, both VDC and freeze menu should be working with this commit in place. Please let me know if it is good for you.

frehwagen, 2020-02-19:
After an initial implementation of VDC behaviour subset that is needed by some GEOS 128 application using trap and hypervisor services written in assembly we decided to try a small footprint version directly in vhdl. @gardners did the basic setup directly in the CPU's implementation and it tured out that this seems to be the best approach. We completed the vhdl implementation of the  subset functionality, it is ready for testing now.

@gardners proved that even if we use some mult, div and mod operations in the  vhdl code, there is acceptable impact on the logic complexity, and we can go with this. Even if the VDC registers conflict with the UART C65 register GEOS needs the registers available in VICIV mode, so we introduced an flag to specifically enable the VDC override.

frehwagen, 2020-02-19:
The register/bit to enable VDC simulation registers is $D710 bit 2. Defaults to 0 (disabled).

The simulated VDC ram is assumed to live at $40000. The current implementation assumes 640 pixel screen width (80 cards), mono color. This might be improved later to match VIC configuration better.

As of now the following VDC register are simulated:
$12/$13 - current address for byte read/write or bulk write
$1E - block count for bulk operation
$!F - read/write data byte or trigger bulk operation
$20/$21 - source address for bulk copy

The simulation is only active in non-hypervisor mode.

adtbm, 2020-02-19:
tested :
mega65r2-20191217.13-HEAD_n-a6ed3fb+DIRTY.bit (Issue #141 bitstream)

unfortunately not able to get geos to display:
**HDMI - NTSC**
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

Autoboot GEOS:
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

**HDMI - PAL**
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

Autoboot GEOS:
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

**VGA NTSC:**
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

**VGA PAL**
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

Freezermenu works with Thumbnails
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

gardners, 2020-02-20:
ok, weird. The "SCREEN NOT OPEN" error when trying to load the disk
directory says to me that there is something else weird going on there.
I'll try the GEOS here at some point and see what result I get.

Paul.

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

frehwagen, 2020-02-20:
True, sorry, I left a auto start program on this that is not yet complete at all. Maybe click to the mouse would move in to the desktop. The status of it was, I  trying to acces the SD card mount funktionality of the hypervisor. I wasn't remembering that it acutally is auto starting. I'll send an update D81 without this auto starter.

But all the latest bitstream I see are dated 20200108, not sure where yours came from.

adtbm, 2020-02-20:
i have updated my previous post, with the correct bitstream now.
the Autoboot, is working nicely, i have used your second version of the geos.d81

frehwagen, 2020-02-21:
Merged back into stable_base branch after successfully testing the bitstream and the VDC simulation function by running GeoWrite 128.

Closed 2020-02-21.

Thread 144 (2019-11-25):

White screen when going into BIOS

adtbm, 2019-11-25:
This Bug only happens after powering ON. but it happens every time !
- hold ALT untill hypervisor submenu appears (To press 1 for utilities or 2 for SD tools)

now pressing 1 or pressing 2 will result in White screen....

pressing RESET button on R2 board and pressing ALT again works as work around.

gardners, 2019-11-26:
Please test with latest unstable bitstream, as I can't reproduce it here on N4DDR-widget board with head of unstable branch

gardners, 2020-02-25:
Do you still see this on the latest stable_base?

deftmega, 2020-03-20:
yes! Also entering FDISK is affected!
Happens on every Cold boot if you directly try to go to either FDISK or BIOS MENU!

gardners, 2020-03-24:
Problem is an interrupt of some kind triggering before the utility can mask them, combined with there being no valid ROM ready (even OpenROM requires the ROM vectors at $0300+ to be initialised)

gardners, 2020-03-25:
Fixed. Ready for merging in.

frehwagen, 2020-04-09:
Merged to stable_base/14.

Closed 2020-04-09.

Thread 145 (2019-11-26):

Ethernet is flaky on recent builds

gardners, 2019-11-26:
Ethernet is flaky, presumably because we latch data on rising edge, when it is in fact clocked on falling edges.

gardners, 2019-12-17:
Working on making ethertest.a65 a more useful test to support this.
Will include ARP, PING and TFTP server

gardners, 2019-12-17:
Working on making ethertest.a65 a more useful test to support this.
Will include ARP, PING and TFTP server.
TFTP get already works.
TFTP put is work-in-progress.  This has required implementing the missing dos_mkfile() hypertrap, which is making this issue blow out a bit.

gardners, 2019-12-17:
ethertest.a65 currently doesn't correctly realise when a file exists, to re-use it, and instead creates it again.
dos_mkfile() should fail with "file exists" in this case, but doesn't.
Result is duplicate files if attempting to create / put the same file repeatedly.

gardners, 2020-07-18:
Ethernet RX seems to be quite stable, testing watching the arrival of ICMP PING requests with ascending sequence numbers.

The problem is still on the sending side.

gardners, 2020-07-18:
Things to try:

1. Add back 200MHz TX clock to allow for proper TX phase adjustment.
2. Do we need fast slew?
3. Do we need an OBUF thingy to improve signal integrity?

gardners, 2020-07-18:
For 3, it is already inferring OBUFs.  SLEW FAST didn't fix it.
Not 100% sure if our TX phase adjusting is working, as it should be possible to pick a phase that makes it much worse, but there is no apparent difference.
Trying SLEW SLOW DRIVE 4, in case the problem is reflections or ringing

gardners, 2020-07-19:
Also should display packets on screen to make sure that reading is not the soiurce of the problem

gardners, 2020-07-30:
RX of packets now seems rock solid, and pinging with 950 byte packets results in reliable responses.
TFTP server however stalls sending all the time, because of RX errors on the linux side, i.e., we are still TXing the odd dud packet.  This probably means we should re-check the TX phase.

gardners, 2020-07-30:
Quick test with trying all four TX phase offsets shows problem still happening.  Further investigation required.

gardners, 2020-08-04:
Using BUFG on the ethernet clock has fixed almost all the RX and TX errors. We are still seeing the occasional lost packet, but no more packet corruption caused by fluffy clocks.

gardners, 2020-08-04:
Now, we have a remaining problem where the ethernet locks up and won't TX anymore. It still sees packets arrive, but seems unable to respond to them.

gardners, 2020-08-04:
Doing a soft reset of the machine doesn't fix it, so I assume it something in the ethernet controller's internal state machine.

gardners, 2020-08-04:
TX lockup actually looks like the ethernet PHY chip gets its MDX status confused.

Otherwise, the only problem we are still seeing is packet loss on the TX direction of ~2-3% without any real explanation.

gardners, 2020-08-04:
Removing and reinserting ethernet cable clears MDX status, but doesn't reestablish TX of packets.
Added instrumentation to see TX state machine status, and it looks like it is stuck counting down the TX delay interval.
The new logic for resetting the ethernet state machine seems to work to clear the situation, further confirming it is just a VHDL state machine problem.
That it is a VHDL problem is confirmed by the addition of a "soft reset" option that resets the ETH TX state, without resetting the PHY itself.  USing this soft-reset option also unblocks sending.

gardners, 2020-08-04:
Problem can be stimulated just by trying to send a bunch of packets in quick succession.  In my test, they were
just duplicates of 908 byte long ICMP reply packets.
What is really weird, is that a symptom of the problem is the TX wait counter counting endlessly, indicating that it is getting into the IdleWait state, which is the only action that the software reset performs.

gardners, 2020-08-04:
BUT if you assert the soft-reset for too short a period of time, it doesn't fix the problem.

Closed 2021-02-15.

Thread 152 (2019-12-08):

HDMI display doesn't not always come on on power-up

gardners, 2019-12-08:
If an HDMI interrupt happens while initialising the HDMI chip, it will only cause the HDMI configuration to continue, instead of starting over from the beginning.  However, the interrupt may indicate that the HDMI TX chip has reset, and thus needs a full reset.

gardners, 2019-12-08:
To test, we need to do a large number of reset sequences in a row, and see if it happens.
Will quantify the probability under the bitstreams where it occurs.

gardners, 2019-12-08:
Seems to happen more often if the monitor has been asleep for a while.

gardners, 2019-12-08:
e.g., turn monitor off. Turn monitor on, and leave off long enough to go to sleep.
But that also doesn't always cause it.

gardners, 2019-12-08:
The turn off M65, turn off monitor for long enough to go to sleep/power saving, and turn monitor back on, and finally turn on M65.
Do a series of runs:  Y = happened, - = means it didn't happen.
----Y----Y-YY

So it looks like the probability is >= 10%.  Twenty runs in a row without problem should be enough to confirm the problem is fixed.

gardners, 2019-12-08:
Also confirmed that it still happens without turning the screen off first.

gardners, 2019-12-08:
Seems to have fixed it.
Need to verify it, before retiring the issue.

adtbm, 2019-12-08:
No proper HDMI signal at all.

Let's start with VGA:
VGA looks nominal:
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

OK, main test HDMI:

i can confirm, that the Panel detects the HDMI signal immediately, but no proper picture. several attempts...
Examples:
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

adtbm, 2019-12-08:
sometimes, i receive a more or less...picture.
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

and even if the picture looks as bad as here:

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

The Freeze menu works always: Proof:

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

adtbm, 2019-12-08:
All results are with PAL. NTSC seems to work:

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

adtbm, 2019-12-08:
to summarize it:
The monitor gets the HDMI signal superfast, regardless of in PAL or NTSC !

But in PAL no picture, only freeze menu.
in NTSC picture OK !

gardners, 2019-12-09:
So I am suspecting that it could be HSYNC polarity that is a problem here.
In any case, it seems to be the HSYNC is being misinterpretted in some way.

Things to try:

sffd307c 0
sffd307c 40
sffd307c 80
sffd307c c0

Those four try all combinations of HSYNC and VSYNC polarity.

Then try disabling HDMI audio:

sffd361a 0

Each of the 8 combinations of the above would also be good to test: If it
is an older monitor, it might not do audio over HDMI well, and so the HDMI
audio could possibly cause a problem.

That's the main ideas I have for possible causes.

Paul.

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

rdpeake, 2021-02-15:
"ADV7511 fails HDMI 1.4a compliance tests at 720x576p and 720x480p in our configuration. Fixed on R3 PCB. Wont (and cant) fix on R2 PCB"

Closed 2021-02-15.

Thread 156 (2020-01-17):

Implement flashing of bitstreams into the QSPI flash

gardners, 2020-01-17:
Now that #155 , #153  and #149 are complete, we can implement writing new bitstreams to the QSPI flash.

##BREAKS Launching flash menu from HYPPO by holding TAB while powering on
##BREAKS Selecting a bitstream to switch to by holding TAB while powering on
##BREAKS Flashing a new bitstream to the QSPI flash for later use

gardners, 2020-02-13:
Now can write whole bitstreams, but sometimes doesn't succeed.
Need to add read-back after writing whole (as reading back after each write gets tripped up by a strange read buffer-like behaviour of the flash, as far as I can tell).
Need to implement QSPI writing, to speed up the writing process.
Need to speed up erase, by not repeatedly erasing each page by stepping only 512 forward during erase. We can step at least to the next 4KB boundary (this bug is probably related to the weird read-buffer thing).

gardners, 2020-02-13:
Flash erasing is now faster, but we are again having big problems reliably writing to the flash.
This is quite weird, as write_latch is being set etc.

gardners, 2020-02-13:
Will switch to QSPI for writing next, in case reading QSPI and writing SPI might do funny things.

gardners, 2020-02-28:
Reading registers via the ICAPE2 interface is proving a bit entertaining.  Output value, regardless of register read is $FFFFFF9B.  Tried adding a framework to do the switch to/from read/write, but still no luck, so far.

gardners, 2020-02-28:
CS/RW were switched. Testing with that fix...

gardners, 2020-02-28:
Hmm.. still no change.

gardners, 2020-02-28:
Turns out that you have to have started the FPGA from flash, not JTAG, just like when trying to reconfigure it.

https://forums.xilinx.com/t5/Other-FPGA-Architecture/ICAPE2-Configuration-Readback-issue-Zynq-7Z010/td-p/782420

I now see something. Plumbing in register selection, to see if we can correctly determine the cycle on which to read.

gardners, 2020-02-28:
The above commits get us a long way towards running other cores, and running an upgraded MEGA65 core if one exists.

Basically, the Hypervisor checks if the FPGA has been reconfigured since power on. If not, then it will try to run the megaflash.prg program, that is pre-embedded in BRAM at $50000.
Even if the FPGA has been reconfigured since power on, if either joystick button or the TAB key is being held down, then it will try to run the megaflash.prg.
However, this happens only on first boot after each FPGA reconfiguration, since we cannot otherwise rely on the megaflash program being present in memory.
The megaflash program gets DMAd down to $0801, and JMP $080D starts it -- i.e., it runs in the Hypervisor memory context.  The Hypervisor writes the correct return address at $03F0/1 before jumping to $080D.  The megaflash.prg program will use this to return to the Hypervisor if it decides that it should neither load an alternate bitstream nor display the flash menu itself.

That's all the theory. There are bound to still be some errors in the bitstream built from the above, but it will hopefully be close enough that it won't take long to get it all working.

gardners, 2020-03-01:
These commits get us to the point where the flash menu and utility menu can be run on first boot, and the flash menu appears if TAB is held, but otherwise returns control immediately to HYPPO.

The main problem right now, is that our OpenROM doesn't work with this, and we have to use a real C65 ROM -- seemingly because the $E518 entry point is not compatible.  This might be because it messes with the MAP instruction, which then of course causes grief when the RTS occurs, and it then goes to lala land, because the memory map was changed.

gardners, 2020-03-01:
Created issue in open-roms repo: https://github.com/MEGA65/open-roms/issues/43

gardners, 2020-03-01:
Will also try a work around: Lock hypervisor memory map in place when in hypervisor mode.

frehwagen, 2020-03-17:
Using the current version of the #156 feature branch after switch on it seems to end in endless looping in
dos_cluster_to_fat_sector
of hyppo/dos.

Initial tests show that the bootup passed flash_menu: in hyppo/main, but never end up at jmp
// Actually launch freeze menu
	jmp $080d
This in combination seems a bit strange, have to double check it.

frehwagen, 2020-03-20:
It seems strange that commit 02f2cc start with a flickering board, but latest commit be0ee5 doesn't flicker even if the assembly command order seem eqal?

frehwagen, 2020-03-30:
156- feature branch also come with changes for the following issues:

#149 - Cannot access QSPI configuration flash for updating bitstream under MEGA65 control
#155 - Incorporate fpgajtag functionality into monitor_load
#156 - Implement flashing of bitstreams into the QSPI flash
#153 - Work out how to do multiple bitstreams
#188 - Interrupt immediately following JMP ($xxxx) seems to save address of JMP, not its target
#144 - White screen when going into BIOS
#179 - MEGA65R1 target doesn't build
#167 - ROM checksum in Hyppo sums wrong region of memory
#188 - Interrupt immediately following JMP ($xxxx) seems to save address of JMP, not its target bug
#189 - $D610 ASCII keyboard acceleration ignores CAPS LOCK key
#190 - Holding TAB on power-on not starting flash menu
#164 - MEGA65 R2 PCB external microSD card slot not working

adtbm, 2020-04-04:
Testing 156/61
used Bitstream:  mega65r2-20200401.11-HEAD_n-058b393+DIRTY.bit
i am not reporting any already known and reported bugs, that are not related to this test bitstream
and connected issues.

[#6](https://github.com/MEGA65/mega65-freezemenu/issues/6) in MEGA65-Freezemenu branch **SOLVED**  1 <-> 2 MHz frequency bug ! MEGA65, when starting in c64 mode is in 1MHz and freezer menu shows 1 MHz.

#144  - **SOLVED** ! BIOS is working when powering on MEGA65 and holding ALT
#149  #153  #156  #190   - **SOLVED** ! able to access flash menu and to flash & erase Bitstreams/.COR,  NO SCROLL key works as flash menu hot-key always, as expected.

#189 - **NOT SOLVED** ! CAPS LOCK does not work in FDISK / writing problems, when using SHIFT LOCK in FDISK (

#164 partly solved. MEGA65 displays content of SD card, when two cards (SD & microSD) cards are inserted. it should display the content of the external (microSD).

SUGGESTION: My opinion: if the MEGA65 would use always the internal (SD card) for MEGA65 relevant files (Freezer, etc.) and attaches the external microSD card as a kind of second diskdrive, with access to the d81 images as well would be even more versatile.

#155  #188 #179 #167  - can't state/test on that.

frehwagen, 2020-04-04:
Thanks for the details report, I additionally can prove #179 because there are resuling mega65r1 bitstream on filehost for @156/61.

adtbm, 2020-04-07:
Testing Results: 156/64
Bitstream: mega65r2-20200407.10-HEAD_n-42e315a+DIRTY.bit

i have also rechecked the issues from previous 156/61 bitstream test.

#176  **SOLVED** SD logic is correct, when both SD cards ( SD card & microSD card) are inserted, content of microSD card (external card) is accessible.

#159  **UPDATE** When entering the disc image chooser the first time, the directory is blank. leaving and re-entering solves this issue.
The issue was not present in this bitstream:
unstabl 87a27d8+DIRTY,20191117.01
issue #159 updated - it is also valid for the R2 bitstream not NEXYS only.

#184 **SOLVED** you can choose a bitstream with cursor keys and it will load the selected bitstream
#185 **SOLVED** you can choose a bitstream with number keys and it will load the selected bitstream.
#189 **SOLVED** CAPS LOCK and SHIFT LOCK works both in FDISK menu.
#186 **SOLVED** CURSOR keys work reliably. in FDISK and disk image chooser, etc.
#190 **PARTLY SOLVED** NO SCROLL is the defined Flash menu hot key. REMAINDER Powering on with TAB pressed, still gives menu information popup window. not needed. NO SCROLL is key to enter flash menu. TAB is atm without any function. #190 updated
#197 **NOT SOLVED** more "strange" behaviours. #197 updated and [#199](https://github.com/MEGA65/mega65-core/issues/199) **CREATED**
#196 **NOT SOLVED** not able to type german letters. i've tried using ALT-key with all normal letters....(maybe the fault is me, not sure....)

#155 #188 #179 #167 #196  - can't state/test on those. these ones are still open and need to be tested.

gardners, 2020-04-07:
My test overnight.  Anton has tested most things more fully than I have, but here is a summary from me:

1. Bitstream starts fine with internal SD card.
2. ALT on first boot works to get into FDISK, and ASCII accelerated keyboard works fine in there, including ALT codes for Unicode Latin1 code page, typing quickly and other things that were problematic previously.
3. NO SCROLL on first boot gets flash menu, which has working ASCII accelerated keyboard behaviour, in particular, cursor UP not glitching.
4. Minor problem: TAB held on boot still shows a message, instead of being ignored. I would diff main.asm to unstable, as there are likely very few changes, and they will likely all be related to this.

frehwagen, 2020-04-07:
As for 4. there is no diff of main.asm that I consider logic relevant for TAB handling at startup. The diff hold 3 things:

- some differences in the sd mounting (not sure why those not has been picket to 156)
- hmdi audio related setup
- some string shortening regarding "NO SCROL"

adtbm, 2020-04-08:
When not having a microSD card inserted, MEGA65 doesn't boot.
MEGA65 is looking now for microSD as prime and ignoring normal SD card

frehwagen, 2020-04-09:
Done, merged to stable_base/14.

Closed 2020-04-09.

Thread 157 (2020-01-22):

Update to new Kick Assembler version

titanlab, 2020-01-22:
Kick Assembler releases >= v5.10 now contain new 65c02 instructions. Replace existing macros and migrate to them. This issue can be assigned to myself.

gardners, 2020-01-24:
Thanks! I have been underway relocating to Arkaroola, and will continue to have intermittent internet for the next 10 days or so.

lydon42, 2021-12-20:
Current mega65-core uses acme and ca65, I can't find any make rule that requires KickAss.
So this issue can be closed, and essentially KickAss could be removed from the mega65-core repo.

lgblgblgb, 2021-12-20:
My personal opinion only: it's not a good thing to always change assembler according to the latest fashion :) Just my personal experience, that Xemu used the Ophis format for some hypervisor debug symbol mode. Then mega65-core switched to acme for hyppo. Ok, now I altered things for acme (and I plan to use the "rep" file as well not only the "sym"). Then now switching to kickass, another change? :( Though for sure, I more speak about the assembler used for assembling hyppo.

titanlab, 2021-12-21:
I also think this issue can be closed. KickAss is also not open-source anymore.

lydon42, 2021-12-21:
I also discussed this with paul, we will remove KickAss from the core repo as it is not required anymore.

lydon42, 2021-12-21:
Removed in hwsc.

Closed 2021-12-21.

Thread 161 (2020-02-13):

Quantify MSSIAH cartridge boot/reset timing requirements

gardners, 2020-02-13:
The MSSIAH cartridge is quite picky about power-on timing. Even the Ultimate 64 had to tweak something so that it would work.  It also doesn't currently work on the MEGA65, due to this kind of problem.

What we wish to do, is to quantify the exact timing of the MSSIAH boot process.  This means we need to get oscilloscope traces from a real C64 with a MSSIAH plugged in, showing the 5V, /RESET, /GAME, /EXROM and A0 (as a proxy for CPU activity. Bonus points for capturing all 16 address lines) signals.

This should be done from cold power-on, and also when the /RESET line is triggered, e.g., using a reset button.

It should be ok to gather this data on a C128 instead of a C64, assuming the MSSIAH works on a C128.  But a C64 would be the golden standard for this.

(Once we have this information, we can work to match the timing on the M65's expansion port, and hopefully, get the MEGA65 running the MSSIAH cartridge. But that's for another issue.)

adtbm, 2020-02-13:
Help request has been posted in f64
https://www.forum64.de/index.php?thread/99211-mssiah-mega65-compatibility-communtity-help-needed/

lydon42, 2022-05-29:
This is a #564

LordKromdar, 2024-12-07:
Hello Mega65 friends. I recently got one and am going to quantify the boot timing this week with my MSSIAH cart. Will respond here with info.

Thread 163 (2020-02-14):

MEGA65 R2 PCB I2C peripherals not responding

gardners, 2020-02-14:
As described. No responses.

gardners, 2020-02-14:
Testing by modifying hdmidebug target to waggle the lines, to make sure they are correctly hooked up.
The weird thing is, it has previously worked, as I saw the RTC refusing to set the time when written to one byte of the clock at a time.  But now, it seems to just be stuck high.

gardners, 2020-02-14:
Ok, now we can see the registers for the HMAC/random bytes stuff, as well as the RTC registers, including the RTC SRAM.  RTC SRAM is working for being written to.

gardners, 2020-02-17:
Remaining problem is that we can't write to the RTC time/date registers.  All other RTC registers can be written to. This means we are likely not sending the STOP condition at the end of the write, which is specifically required for the RTC time/date registers, to prevent invalid writes from taking effect.

gardners, 2020-02-17:
Simulation confirms that we weren't sending the STOP signal.  Fixed (hopefully) in the above. Should also be done for other I2C busses, as this is a likely cause of some of the weird things we have seen.  Copy changes once confirmed working here.

gardners, 2020-02-18:
Not properly fixed.  The issue is that we need to allow the I2C bus to go idle after doing the read-all-regs loop, before starting any queued write. But the state machine doesn't handle this, so I'll need to add some mechanism to delay activation of command requests.

gardners, 2020-02-18:
Confirmed I2C write begins and ends with STOP/START sequences in waveform of the above commit.  Now synthesising to test...

gardners, 2020-02-18:
Confirmed that this fixes writing to the RTC clock, and setting it going.

Now we should do the same fix to the other I2C busses for the various targets.

gardners, 2020-02-18:
@frehwagen this one is safe for merging onto stable_base when you are ready.  There are a few others I have closed recently that should also be good to check for merging in.

frehwagen, 2020-02-21:
I reopen this issues because we want to have issues open until they are completed, fully tested and merged into stable_base branch.

adtbm, 2020-03-15:
**Testing 163:**

- **HDMI** NTSC -OK- / PAL -OK-
- **VGA** NTSC -OK- PAL -distorted-
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

- **FREEZER MENU**  THUMBNAIL -OK- Frame -NOT OK- (missing)
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

- **SOUND** -No Sound via HDMI NTSC from 3.5mm Audio jack
                     - Sound OK via HDMI PAL from 3.5mm Audio jack

- **SPRITES** - heavy "ghosting" with multiplexed Sprites
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

- **GEOS** HDMI NTSC -OK- (very good)
                  HDMI PAL -OK
                  FREEZER menu -NOT VISIBLE (blue screen (thumbnail visible, nothing else), but
                  operational (i.e. Pressing "V" to change video mode or "F3" to leave menu.
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

                   RTC tool (MEGA RTC) is working, crashes GEOS but after power recycle date & time are
                   still set.

bluewaysw, 2020-03-15:
As for the SPRITES issues, what this correct when using stable_base bitstream?
FREEZER currently is not able to freeze GEOS, but this should be a nother story/issue.
Not sure with the SOUND, I think this relates to FREEZER version beeing used.

gardners, 2020-03-16:
The lack of frame around thumbnail may be missing C64THUMB.M65 etc from SD card.

frehwagen, 2020-03-16:
The functionality expected here and resulting bitstream has been successfully tested, merged back to stable_base branch so this issues is considered closed now.

Closed 2020-03-16.

Thread 164 (2020-02-14):

MEGA65 R2 PCB external microSD card slot not working

gardners, 2020-02-14:
As described.

gardners, 2020-02-14:
I can waggle all lines EXCEPT D3/CD, which is required to bring the card to attention.  This is presumed to be the root cause of the problem.

gardners, 2020-02-14:
The D3/CD should be pin K2 according to the schematics. This is also connected to the M_RX pin on the MAX10.

gardners, 2020-02-14:
Probably a good idea to try waggling it from the MAX10.  Problem with that, is that for some reason I can't get the write.sh or flash.sh scripts to run. Even after de-configuring the Xilinx FPGA so that its DONE signal clears, allowing the MAX10 JTAG to enable, and making sure the MAX10 FPGA is visible to fpgajtag, the quartus tools are unable to find it.

gardners, 2020-02-15:
ok, so confirmed that the pin is K2, by using the JTAG boundary scan feature of monitor_load to watch while grounding the pin.  This just leaves the question of why the FPGA isn't able to pull the pin down.  Is it be cause the MAX10 is not tri-stating the pin?

gardners, 2020-02-15:
One way to see if this is the case, is to tell the FPGA to drive the pin with higher current, which I'll try. But I'm not yet too confident that it will solve the problem, because I would expect to at least see a ripple on the signal, if the drive was insufficient.

gardners, 2020-02-15:
ok, so it needs to be 24mA to work.  Now synthesising for M65R2.

gardners, 2020-02-15:
Confirming that external SD card now works.

gardners, 2020-02-18:
@frehwagen feel free to merge in to stable_base when you are happy with the changes.

frehwagen, 2020-04-09:
Fixed as part of #156, merged into stable_base/14.

Closed 2020-02-15.

Thread 165 (2020-02-16):

Get HyperRAM working on MEGA65 R2 PCB

gardners, 2020-02-16:
We have never gotten it working.
Adding logic to slow down transactions to ~Hz speed, so that we can monitor what is happening with the JTAG boundary scan stuff, since there are no pins accessible.

gardners, 2020-02-16:
Datasheet on the Hyperram is here: http://www.issi.com/WW/pdf/66-67WVH8M8ALL-BLL.pdf

Access protocol should be quite simple and straightforward.  Read operations are described in Figure 1.1 on page 4 of the datasheet.

gardners, 2020-02-16:
despite trying a pile of things, all the hyperram pins are apparently logic 0.  This is very suspicious, given some are inputs to the hyperram. I'll need to figure out what the problem is here. Is it a powered down IO bank on the FPGA?  Stupid VHDL errors on my part?

gardners, 2020-02-16:
so, hr_* lines all act as though tied to GND. Made sure it wasn't my logic driving them at fault by switching with LED pin, which then works fine.

gardners, 2020-02-16:
Bank 16 should be powered with 3.3V, and things like the joysticks etc are on the same bank, so assume the bank isn't the problem.

gardners, 2020-02-17:
ok, so I can talk to the HyperRAM on the TE0725-03 -- even though I don't seem to be able to write reliably to it.  JTAG shows activity again. This at least proves that my HyperRAM driver is capable of life.  So now to resynthesise for the M65R2, and see if we see any life there.  If not, then assume pins must be incorrect or some other fault on the PCB layout for the hyperram?
Will slow down the HyperRAM accesses again and set a pattern on hr_d (see commit 5e76e15 above) and try running on both M65R2 and TE0725-03 PCBs.

gardners, 2020-02-18:
Consulted with Antti who confirmed pinout is correct, and that he has had the hyperram working on his board, using litex: https://github.com/micro-FPGA/litex-boards/blob/master/litex_boards/partner/platforms/mega65.py

So why are thes pins staying low for me on the MEGA65R2 board, no matter what I do, but using much the same driving code, I can see the lines toggle on the TE0725-03 board?

gardners, 2020-02-18:
Confirmed M65R2 HyperRAM is 3V, and thus setup correctly. The HyperRAM on the TE0725 is actually a totally different part, with 1.8V IO.  Thus it isn't an exact proxy for the M65R2 part testing.

Last commit above is to enable monitor to try to read from HyperRAM which we currently have clocked super slow, so that we should be able to examine the signals via JTAG boundary scan.

(As well as verifying the M65R2 board behaviour, we can also get the HyperRAM more completely working on the TE0725 board, via the same JTAG testing).

gardners, 2020-02-18:
Just confirmed that a bitstream from Antti works, even though the JTAG boundary scan still shows 0 on all the HyperRAM pins. So it looks like I can't really trust the JTAG probing of the HyperRAM.

It might well be, that when I debug the HyperRAM on the TE0725, that it will then work when transferred to the MEGA65 R2 target.  I just need to think of a way to be able to watch and debug what is going on.

gardners, 2020-02-18:
Begun tackling problem by implementing a fake hyperram model that I can test against, now that I know the JTAG boundary scan stuff is not working for whatever unknown reason. This has already turned up several bugs in the hyperram controller.  Will continue with this approach.

gardners, 2020-02-18:
On that note: known things I have to fix so I don't forget:

1. Writing odd/even bytes.
2. Check reading logic for odd/even bytes also.
3. In model, check for RWDS going low ahead of writing actually beginning, then do actual writes.

gardners, 2020-02-19:
With the above commits, the test harness can now read and write.  Test via synthesis comes next.

gardners, 2020-02-25:
Added last commit, because even with the bitbashing debug registers which should always answer, the slow_devices wrapper interprets the RAM as having timed out.  To debug this, I have made it so that the bitbashing registers are ALWAYS read in the hyperram, and asserts the data_ready_strobe thus on any read of the hyperram.  If this works, then maybe the address comparison for the debug registers is wrong. If it doesn't work, then there is some nasty plumbing issue.

gardners, 2020-02-26:
Hyperram never seems to be readable, even with fake data source.

gardners, 2020-02-28:
Okay, with cache turned off, and using internal HyperRAM, we now seem to be able to *mostly* read from the HyperRAM.

There are some gotchas, though:

1. If RAM > 8MB is attempted to be accessed, then reads below 8MB can fail until an attempt is made to write. but it's not consistent. e.g.:

M8000000 <- read from 0MB point, returns lots of random values
M8800000 <= read from 8MB point, i.e., from 2nd (non-present) hyperram die. Returns regular pattern.
M8000000 <- read from 0MB point, should return lots of random values, but sometimes just repeats the pattern from M8800000

2. More importantly, it looks like we read the previously presented byte at all times, e.g.:

m8000000
:08000000:9405514A806F40D0D0191A106C035761

.m8000000
:08000000:6105514A806F40D0D0191A106C035761

.m8000001
:08000001:61514A806F40D0D0191A106C03576161

.m8000001
:08000001:61514A806F40D0D0191A106C03576161

.m8000002
:08000002:614A806F40D0D0191A106C0357616173

.m8000002
:08000002:734A806F40D0D0191A106C0357616173

This would seem to be a problem with the latching of the data read by hyperram.vhdl into slow_devices.vhdl, not a problem with actually reading the HyperRAM itself.  This might be possible to identify the cause of through simulation.

3. Writing seems to almost universally fail.  Presume that latency timing of writes is out by a cycle or two, causing no writes to get latched.

4. In fact, attempting to write can cause strange problems, e.g.:

.m8000002
:08000002:734A806F40D0D0191A106C0357616173

.s8000000 1 2 3 4 5

.m8000000
:08000000:01020304050500000004040404040404

.m8000000
:08000000:04000000000000000004040404040404

.m8000000
:08000000:04000000000000000004040404040404

Writing a single byte seems to break it out of this loop:

.s8000000 99

.m8000000
:08000000:99995549814F40D0D011191044435541

.m8000000
:08000000:41055549814F40D0D011191044435541

Presume a problem with the latching of writes when the HyperRAM interface is busy with an asynchronous write.

Note that we temporarily read back the written value twice (maybe a symptom of how the HyperRAM module gets shocked out of the confused state), but after that, the write has evidently not taken effect.

gardners, 2020-02-28:
Above commits should fix the read latency, and make it possible to adjust the write latency, to see if we can find the correct value.

gardners, 2020-04-07:
So, back at 08872b4 we have some strange behaviour happening with the ISSI hyperram:

With write_latency set to $0E:

1. Reading is fine. No problems at all that I am aware of.
2. Writing EVEN addresses, one at a time, works fine, too.
3. Writing ODD addresses results in the value being written to the correct location, as well as ADDR+2, and often ADDR-(ADDR&7)+1, especially if (ADDR&7)==7

If we set write_latency to $10, then writing to odd addresses works, but of course writes to ADDR+2 instead of ADDR.

Also, if we do multiple writes in quick succession, this seem to bork things, too. So we need a delay after doing one write, before allowing the next. This minimum turn-around time is mentioned in the specifications somewhere.

So we could do some slightly ugly thing with adding 2 to write_latency when writing odd addresses.  this seems really ugly.

So, debugging by using the external HyperRAM PMOD module thingy from 1BitSquared which has a Cypress HyperRAM on it, things are not that different:

1. When reading, we seem to need to allow an extra tick before the data actually comes, this means $xxxxxx0/8 always reads the last byte of the CA value ($00 or $04, respectively).
2. There is some funny stuff going on with duplicated by writes, which is a bit hard to pin down completely, but actually looks quite similar to what we are seeing with the ISSI part.

So it looks like writing a single oddly-addressed byte requires masking an entire word for write first, and we need to enforce enough turn-around time between writes.

gardners, 2020-04-07:
The fix for writing from one word earlier mostly works -- except when writing byte offset +$001 after KB boundary.  In that case, the byte ends up in several variable places in the 1KB area the write has occurred in, and/or in the previous 1KB.

This is presumably because we have fixed the writing of odd addresses by going back one address, and then we step over an internal row or column boundary or something in the HyperRAM's actual DRAM, which mean that things don't get time to settle, and the data can get committed to multiple memory cells.

We should be able to deal with this by using wrapped writes of a fixed size, and then just adjusting the address within that wrap range, and thus always staying on the same memory page/row/column.

Another approach would be to collect writes on an 8 byte cache line, and then commit the whole thing with no masking, as that will also presumably work without problems.

To do this, we need to be able to read and write the config registers for the HyperRAM, which we should do anyway, as it is the best hope we have for reducing read latency in the common case when single latency will be fine, instead of being fixed to double latency.

gardners, 2020-04-07:
With commit 0c6da6c, the following seems to work:

sbfffff5 1f       <- enable proper writing of conf registers
sbfffff8 0 0     <- prepare to write $0000 into conf register
s9001000 1   <- write those values into CR0 conf register (in theory at least)
sbfffff3 6        <- reduce countdown from $e to $6

(Still with the problem with writing to offset $001 in a given KB doing weird things).

Speed test results before this change:

Cache enabled:
Extra RAM -> Fast RAM copy: 5001KB/sec
Fast RAM -> Extra RAM copy: 1970KB/sec
Extra RAM -> Extra RAM copy: 1477KB/sec
Fill Extra RAM: 1970 KB/sec
Cache off:
Extra RAM -> Fast RAM copy: 1625KB/sec
Fast RAM -> Extra RAM copy: 1970KB/sec
Extra RAM -> Extra RAM copy: 902KB/sec
Fill Extra RAM: 1970 KB/sec

Speed test results AFTER this change:

Cache enabled:
Extra RAM -> Fast RAM copy: 5417KB/sec
Fast RAM -> Extra RAM copy: 2407KB/sec
Extra RAM -> Extra RAM copy: 1757KB/sec
Fill Extra RAM: 1970 KB/sec
Cache off:
Extra RAM -> Fast RAM copy: 1912KB/sec
Fast RAM -> Extra RAM copy: 2407KB/sec
Extra RAM -> Extra RAM copy: 1083KB/sec
Fill Extra RAM: 2407 KB/sec

So we are certainly speeding up writes quite appreciably: 2407/1970 = ~22% faster aka write latency reduced to ~0.82x original.

But there is a problem writing to CR0, as it seems to get $FFFF written into it, instead of the correct value.

Having $FFFF would give 4 cycles latency instead of 6, which then means write_latency reduces from $E to $6 (four internal ticks per cycle). It would also leave the extra latency always enabled for reading, which explains why the reading operations have not sped up at all. Also, it should be possible to drop to 3 cycle write latency to get a little extra turn of speed.

Basically it doesn't seem to matter what we try to write to CR0, it seems to get written as $FFFF.
Figure 5.1 of the ISSI HRAM datasheet indicates that the wave form should have the data immediately following.  Only difference I have spotted so far is that the linear/wrap bit should be set to linear for register writes, apparently.  If it is doing some weird wrap and overwriting with reading tri-stated pins, that could well explain what we are seeing with not setting CR0 properly.

gardners, 2020-04-07:
Minor diversion: The cache is still messing something up, as the following sequence shows:

1. Let's put some known values into $8000000:

`.s8000000 0 1 23 4 5 6 7 8 9 a b c d e f
`

2. Let's see what the current state of the cache is:

```
.mbfffff0
:0BFFFFF0:00FF030E021F07003412010000000000
```
So cache row 0 has $8000008-F, and cache row 1 has $8000000-7, with zero valid bytes in either, because the cache is disabled (bit 7 of offset $2).
(offset $0 = valids for row 1, offset $7 = valids for row 0, offsets $a-$c = address bits 26 downto 3 for row 0, offsets $d-$f = address bits 26 downto 3 for row 1).

While the cache is off, reading config registers will also stuff up, reading only the first byte, because of how config registers work on the ISSI Hyperram.  Why we see $12 and $34 as fill bytes is not totally clear to me, though.  Those are the values loaded into the buffer for writing to config registers ($BFFFFF8-9, seen above).

```
.m9000000
:09000000:0C123412341234123412341234123412
```

Again, if we check the status of things, we see the cache line offsets have no updated, but with all valid flags cleared:

```
.mbfffff0
:0BFFFFF0:00FF030E021F07003412000020010020
```

Let's also just make sure the values we wrote can be read back.  There is still the bug with writing to offset $001 in each KB, so that byte is zero, and I didn't type a space between 2 and 3, so its all shifted left a bit, but that's not a worry for us here:

```
.m8000000
:08000000:0000230405060708090A0B0C0D0E0F00
```

So let's enable the cache:

`.sbfffff2 83
`

And check that we can still read the bytes we wrote:

```
.m8000000
:08000000:0000230405060708090A0B0C0D0E0F00
```

Which we can now see are loaded into the cache, with all valid bits set, as the cache rows have been read:

```
.mbfffff0
:0BFFFFF0:FFFF830E021F07FF3412000000010000
```

Also, if we now  read the ID register 0, we get the 8 bytes of repeated values, as we expect:

```
.m9000000
:09000000:0C810C810C810C811212121212121212
```

And we see that these addresses are now happily loaded into the cache, with all valid bits set.
Well, actually, the $9000008-F gets loaded into the cache, leaving $8000008-F still in there.

```
.mbfffff0
:0BFFFFF0:FFFF830E021F07FF3412010020010000
```

This is when it starts getting strange, as if we read $9000000 again, we should just read the cached values, but instead, we get this:

```
.m9000000
:09000000:34343434343434341212121212121212
```

So, even though $9000000-7 should be getting freshly loaded, and it is indeed loaded into the cache, we get rubbish in there.  But the cache content looks file:

```
.mbfffff0
:0BFFFFF0:FFFF830E021F07FF1234010020000020
```

Now the really weird part comes when we load $8000000 again, in that the first transaction reads rubbish:

```
.m8000000
:08000000:0000000000000000090A0B0C0D0E0F00
```

I think the problem might actually be that when the HyperRAM has done a config register read (or possibly when my HyperRAM controller has done a config register read...), the next transaction just goes wonky.

If this is the case, we should be able to reliably read $8FFFFF8-$9000007 (if cache is flushed) to get the first config register, which we seem to be able to do.  Ok, so that's that mystery solved: The cache is fine, it is just switching to and from config register operations that is crazy.

Now to finish debugging setting config register values...

gardners, 2020-04-07:
Now, back to writing to config registers:  This still seems to be rather wonky.
My best guess so far is that when I do a write, I am ticking the clock as well as releasing CS0 -- this might cause a subsequent write to get registered.  This may in fact also explain the double-writes for odd addresses that I was seeing...  So, CS should release without an extra clock tick.  But for writing to even addresses, we probably still need to give the odd tick, so that a complete word transfer has happened.

gardners, 2020-04-07:
ok, the above commits should hopefully fix a variety of evils we were experiencing, and appreciably speed up access to the hyperram in the process.  It should even fix the writing to offset $001, if I have understood things correctly.

gardners, 2020-04-08:
ok, so that has certainly helped speed things up, but now we are still getting intermittent corruption of memory when writing.
This is usually taking the form of $BE ("before even" mask byte written to hr_d), and double-writing of the correct value at ADDR+1 and ADDR+3.  This has been seen mostly with even addresses at the moment.

I am wondering if the latency needs to be increased from 3 cycles to 4, or whether it is glitching on the HyperRAM interface, possibly due to poor timing closure.

gardners, 2020-04-08:
Confirming setting CON0 back to $8F1F and write_latency to $0E makes it all work reliably again.

Trying now with $8F17 (just switching to variable latency), and write_latency = $09
Yes: switching to variable latency would seem to be the problem.

Next step is to make the extra latency adjustable, so that we can get the timing exactly right when it is required.

gardners, 2020-04-08:
So while waiting for that to finish, it's time to start looking at collecting writes together to improve the write speed.

gardners, 2020-04-08:
Cached reading and writing now seems to work fine, and is quite fast:

Copies between fast and hyperram are ~8MB/sec in either direction.
Filling hyperram is also about 8MB/sec.
There is probably scope to further optimise the write scheduler, but it is a darn sight better than it was.

Remaining to be fixed, is that writing without the write scheduler enabled now doesn't work for some reason.  Should be debuggable in simulation.  But also isn't that much of a priority, since the default operation with cache on is what we want, and much more perfomant, in any case.

Apart from that, I just want to do a bit more testing.

Further improvements, e.g., prefetching data for the caches (possibly by fetching 16 bytes instead of 8, and having a "2nd row" buffer that can get moved into place when reaching the end of a cache row and/or actively prefetching a cache line and/or maintaining a larger set of "cached cache lines" that can't be searched for validity with zero latency, but with one cycle latency can be searched, or deferring the toolate signal when collecting writes to improve write performance and/or allowing chained writes of > 8 bytes can all wait.

gardners, 2020-04-08:
So, we will leave the cache on, and not worry about debugging non-cached writes.
I have started looking at shorten clock ticks when data stays the same, since in theory it should be fairly easy to do, and will reduce latency of all transactions maybe 10% or 20%

gardners, 2020-04-11:
165-hyperram feature branch has been created with the commits cherry-picked on.
Bitstream built, but the Hyperram is not writing properly, so will need to be debugged..

gardners, 2020-04-13:
So now the slow mode in this setup mostly works, except that 8th byte in each fetch sometimes gets ORd with the following byte.
E.g.: s8000040 30 31 32 33 34 35 36 37 0

will allow reliably reading the $37 from $8000047, but if we instead:

s8000040 30 31 32 33 34 35 36 37 FF

Enabling fast read doesn't change this behaviour.

Enabling fast write writes values somewhat messed up, which makes sense, as with the clock not offset by half a tick the wrong values and mask values can get latched by the HyperRAM. The same goes for the fast command mode.

So, slow reading should be  fixable by latching the data on the correct clock phase.

The fast modes will need an actually reliable way to delay the HyperRAM clock.  Maybe I should just provide a free-running clock for the HyperRAM, and just allow switching the phase of that, rather than enabling delayed or not delayed, so that there can be no glitching of the clock.

gardners, 2020-05-04:
Above changes are making good progress.
Internal hyperram seems to now be fairly stable with cache and fast read enabled.
Fast CMD and fast write still are unstable, but that's fine. They can stay disabled, as they provide relatively little benefit.

External hyperram is also getting closer to working. Oddly it gets lots of single-byte read errors if the cache is disabled. If cache and block reads are enabled, then they are rarer -- but that's probably just because it performs many less read transactions.   The main behaviour is that read transactions can get 2 bytes of rubbish at the start, presumably because a clock tick gets missed by the external hyperram.  I have enabled fast slew and 24mA drive strength to try to resolve this. Will test on synthesis.

Simulation is still revealing some corner case problems that I need to resolve, and will work on next.
In particular, linear writing to external hyperram seems to lose some writes.  This might well be related to the problem above.

gardners, 2020-05-04:
Attempting to read an address just after a pre-fetch of the same address seems to cause the state machine to get very confused, and the read request from slow_devices times out.

frehwagen, 2020-05-22:
IEC serial devices become instable in GEOS, probably because of the timing changes. This needs to be fixed.

gardners, 2020-05-22:
Yes, this is very likely the case. However, I prefer that we don't hold up this and 138 on that, and instead file a new issue for "IEC devices unstable in GEOS following CPU timing changes", and fix that specifically there.  Otherwise we have too much in one go, and it will take too long to merge it in.

lydon42, 2023-05-02:
checked with Release 0.95 core, no problems with HyperRAM found.

Closed 2023-05-02.

Thread 168 (2020-02-23):

D030 / "C128 fast" mode bit should be reversed?

lgblgblgb, 2020-02-23:
I really don't know too much about C128, unfortunately. But according to Paul, the current behaviour of MEGA65 is:

"Confirming 1 = 1MHz, 0 = 2MHz"

However stated by others (as I've told, I have no idea), the **opposite** should be true! Since it seems some C64 titles uses this bit (in the hope that it's a C128 in C64 mode so they can gain some speed, and setting this bit has no effect on a real C64), this can be a problem. It was discussed on mega65 forum at forum64.

Please someone can check this? First, how it works on C128 for real. Second: is Mega65 complies to the rules, or really it's reversed behaviour now! Third: can we fix that in mega65-core (if it's really reversed!), and then in Xemu too (this one by me).

I wouldn't change it in Xemu unless it's changed in mega65-core as well for obvious reasons :)

gardners, 2020-02-23:
Yes, it has been the wrong way around since the beginning :) Fixing now.

gardners, 2020-02-23:
@frehwagen feature branch created and committed. Change also applied to unstable

adtbm, 2020-03-16:
Testing 168:

    **HDMI** NTSC -OK- / PAL -OK-

    **VGA** NTSC -OK- / PAL -distorted-
    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

    **FREEZER MENU** THUMBNAIL -OK- Frame -OK-

    **SOUND** - Sound -OK- via HDMI NTSC from 3.5mm Audio jack
                 - Sound -OK- via HDMI PAL from 3.5mm Audio jack

    **GEOS** HDMI NTSC -NOT OK- (garbage picture)
              HDMI PAL -NOT OK-
              FREEZER menu -NOT VISIBLE (blue screen (thumbnail visible, nothing else), but
              operational (i.e. Pressing "V" to change video mode or "F3" to leave menu.
              RTC tool (MEGA RTC) - Can't test-
              OBSERVATION: after running GEOS, when switching MEGA65 off/on i receive this picture,
              instead of normal MEGA65 bootup. several tries of powercycling solve this.
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

**Comment to add:** this is the first bitstream, where multiplexed Sprites did not have any timing issue ! i am totally impressed ! WOW ! ! !

I have to cancel the above praisals.....
**C64 starts in 2MHz (Freeze menu shows 1 MHz) so YES the frequencies are inverted, but the Freeze menu doesn't displays this.
So now, when selecting 1MHz, you are running in 2MHz and vice versa.....**
At least this shows me, that there is a still a timing issue, since the demo i am using for testing was written for a 1MHz C64.
In 1MHz i still have the desynced multiplexed sprites. in 2 MHz it looks smooth..

adtbm, 2020-03-20:
issue # 168/4 Bitstreamtest
used Bitstream: mega65r2-20200317.19-HEAD_n-0ca6ef6+DIRTY.bit,
with SD-card files from subfolder.

- atm no change to previous bitstream. 1MHz <-> 2MHz Problem not solved.

deftmega, 2020-03-20:
- Switching to NTSC locks up machine in C65 mode

- Switching to NTSC in C64 mode results in top and bottom border disappearing. Hard lock-up see below.
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

- NTSC mode in C64 mode is super unstable. Machine will hard lock-up. Even reset button does not bring it back.
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

- 2 Mhz results in 1.95 in Synthmark. 1 Mhz results in 0.95 in Synthmark.
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

frehwagen, 2020-03-20:
Actually, from looking at the code internally (cpu-side), (1) mean 1mhz, (0) mean 2 mhz. On the way to the registers $D030 values has been inverted, so properly presented to the outside world. So in the end there is nothing to be fixed here, will close without change.

Closed 2020-03-20.

Thread 171 (2020-02-25):

Activate Internal speaker port on MEGA65 R2 PCB

gardners, 2020-02-25:
This will use the same audio port as bluetooth_left on the MEGAphoneR1, as we have only 8 audio output channels, and they are already all allocated, and we want headphones, HDMI audio and internal speaker to all be independently controllable.

gardners, 2020-02-25:
Well, it looks like it CAN work, but for some reason the audio isn't being plumbed through.  So the last commit above tries to plumb one of the other audio channels through to it. If that works, then we know the bt_audio_l generation is wrong. If it doesn't, then we suspect it is a plumbing problem in the heirarchy.

gardners, 2020-02-25:
so switching to the regular audio stream has it working. I also just realised what I had messed up when trying to feed the BT audio output channels :/ Commit coming ...

gardners, 2020-02-25:
We will need to have an option in the BIOS and AUDIOMIX to select default audio profile: speaker ( / BT ) audio output enabled or not.
Also, the audio level is very low on the nice 2W speakers, or suffers considerable background noise (including when silent) when the volume level is ramped up.  This was using PWM.  Try PDM instead, to see if that is any better (it probably should be).

gardners, 2020-02-26:
PDM indeed has much better signal to noise ratio in the form of reduced background noise.
Confirmed working.

All that remains now is to modify HYPPO to configure this audio channel on boot -- but only for MEGA65R2 PCB, as it will be bluetooth on the MEGAphone boards, so we need a target check. That will be a separate issue.

@frehwagen this one is ready for you to merge in now. To test, you will need an 8Ohm speaker on J19, and to go into audio mixer and under the BTL column, set SIDL, SIDR, DIGIL, DIGIR and MASTER there to F0F0 (press F7 once on each).

Closed 2021-02-21.

Thread 174 (2020-02-26):

Examine HDMI video sync timing differences between stable_base and unstable

gardners, 2020-02-26:
Falk has provided a bunch of screenshots showing monitor scan info for stable_base vs unstable HDMI output.  This seems to indicate that the most probable cause is difference in HSYNC and VSYNC pulse positions and widths.  Thus some investigation of these would be a good step to fixing the HDMI output problems on unstable. (Note that HDMI audio is still a whole separate kettle of fish).

gardners, 2020-02-27:
Unfortunately, examining the two bitstreams VGA output, the HSYNC and VSYNC signals seem to  identical in terms of frequency and position relative to active/inactive parts of rasters and frames.  So back to the drawing board :(

rdpeake, 2021-02-16:
closing as hdmi has been tested for compliance via testing equipment on r3 board. (r2 won't be fixed)

Closed 2021-02-16.

Thread 178 (2020-03-04):

disk chooser doesn't show more than one page of files?

gardners, 2020-03-04:
##BREAKS switching pages of disks in the disk chooser

gardners, 2020-03-04:
Observed on the current head of unstable at least.
To reproduce, have enough disk images to overfill one screen, and try to access them.

gardners, 2020-03-04:
Ooops, tagged the commit that fixes it with #177 instead. Anyway, confirmed fixed.

Closed 2020-03-04.

Thread 188 (2020-03-24):

Interrupt immediately following JMP ($xxxx) seems to save address of JMP, not its target

gardners, 2020-03-24:
See example trace below:

.r

PC   A  X  Y  Z  B  SP   MAPH MAPL LAST-OP In     P  P-FLAGS   RGP uS IO ws h RECA8LHC
FCFF 97 01 84 00 00 01FF 0000 0000         00     A1 N.E....C ...P 10 -  00 - .....lhc
,0777FCFF  6C 00 A0  JMP   ($A000)

.

PC   A  X  Y  Z  B  SP   MAPH MAPL LAST-OP In     P  P-FLAGS   RGP uS IO ws h RECA8LHC
FF48 97 01 84 00 00 01FC 0000 0000         00     A5 N.E..I.C ...P 10 -  00 - .....lhc
,0777FF48  48        PHA

.r

```
PC   A  X  Y  Z  B  SP   MAPH MAPL LAST-OP In     P  P-FLAGS   RGP uS IO ws h RECA8LHC
FF48 97 01 84 00 00 01FC 0000 0000         00     A5 N.E..I.C ...P 10 -  00 - .....lhc
,0777FF48  48        PHA

.m1fc
:000001FC:97A1FFFC000000000000000000000000

```

Note that the address of the JMP at $FFFC has been pushed to the stack, instead of the address of the target of the JMP.

This is causing boot lockup (often with rubbish on the screen) sometimes.
Possible cause of the white screen problem with utility menu etc as well?

Problem manifests with a clean build of the unstable branch commit 6715006b607c9567a15a622c859109cfe9364bc0, but not with my existing build directory, for whatever reason.

gardners, 2020-03-25:
Fixed. Ready for merging in. Problem was different to suspected in the end (although it is possible that this odd behaviour with JMP indirect persists, but in a harmless manner).

frehwagen, 2020-04-09:
Merged to stable_base/14, as part of #156 feature.

Closed 2020-04-09.

Thread 189 (2020-03-25):

$D610 ASCII keyboard acceleration ignores CAPS LOCK key

gardners, 2020-03-25:
Reading keys from $D610 doesn't change the alphabetic keys when CAPS LOCK is active. It should.

##BREAKS CAPS LOCK enables capital letters in $D610 ASCII key feed, e.g., typing in FDISK

gardners, 2020-04-03:
Hmmm, this seems to have either regressed, or never actually worked.
Possibly related: pressing two keys in quick succession results in only the second one being registered.
Regular shift works fine, just still not CAPS LOCK.

gardners, 2020-04-03:
Okay, that has it so that we have a simple bitstream that takes only about 6 minutes to build, and that echos all typed keys out on the serial port, and that reproduces the problem.

It also confirms that CAPS LOCK is not showing up in the bucky bit vector.

gardners, 2020-04-03:
Above commits get CAPS LOCK working and seem to have also fixed the dropping of rapid key presses. Cursor up/down and left/right are confirmed to still be working in the hdmidebug test stream as well.  Now synthesising mega65r2 target to test the corrections.

gardners, 2020-04-03:
It worked, except that CAPS LOCK was inverted for the ASCII key parser, so have inverted the static unused widget board caps lock line for the MEGA65 R2 target to flip it.

gardners, 2020-04-03:
ok. All done and fixed, ready for testing and merging in.

adtbm, 2020-04-03:
Test was successfull.
cursor keys do work in all menus and normal operations as expected.
(cursor up and left, no problems anymore.)
CAPS LOCK works in all menus, especially FDISC.
(of course not in c64 mode, that's expected)

frehwagen, 2020-04-09:
Fixed as part of #156, merged into stable_base/14.

Closed 2020-04-09.

Thread 190 (2020-03-28):

Holding TAB on power-on not starting flash menu

gardners, 2020-03-28:
This seems to be a regression on unstable after re-basing onto the updates on stable_base. The problem also exhibits in the #156 feature branch.

Tackling the problem on unstable first. Suspecting that HICKUP.M65 was out of date.  Confirmed that latest HICKUP.M65 I have built DOES start flashmenu correctly. Now synthesising a bitstream with it incorporated to verify.

gardners, 2020-03-29:
It looks like HYPPO starts the flash menu, but the flash menu doesn't bring up the menu for some reason. Investigating...

gardners, 2020-03-29:
Looks like HYPPO now boots so fast, that it is unlikely that a key event will be triggered in the VERY short time at the beginning of HYPPO initialisation.

Solutions include adding a delay, or using a bucky key, like NO SCROLL instead of TAB, as the bucky keys are scanned instantaneously.  For some reason, we can't use $D613 to query the 9th column of keys, so we can't just hard-probe the TAB key that way.  We could, ,however, do a proper column 8 scan of it, but that will eat more code space that we would probably like.

adtbm, 2020-04-07:
NO SCROLL works as hotkey to enter flash menu. anyway, holding TAB while powering on
still brings a popup screen. this is not needed anymore

frehwagen, 2020-04-09:
Fixed as part of #156, merged stable_base/14.

Closed 2020-04-09.

Thread 197 (2020-04-04):

ESC, F9, F11, F13 and TAB keys in ASCII key scanner have no delay before repeating

gardners, 2020-04-04:
Try pressing any of these keys in FDISK when prompted to type, and you will see this problem.
All are suspiciously on the last column of the keyboard scanner.

On-screen keyboard shows these keys as not being solidly on, so the problem is very much real and observable.

Keys look to be held about 1/4 of the time.

##BREAKS ESC, F9, F11, F13 and TAB keys repeat at normal rate in ASCII keyboard scanner

adtbm, 2020-04-07:
Not sure, if this is related.
when pressing the above mentioned keys, wrong & strange symbols showing up.
Also when usuing standard keys, it looks like the letters are slowly shifting from left to right.
Have a look at the attached picture.

adtbm, 2020-04-07:
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

frehwagen, 2020-04-09:
Fixed as part of #156, merged into stable_base/14.

Closed 2020-04-09.

Thread 212 (2020-04-26):

Accessing external drive should not trigger sounds from speaker

RalphEgas, 2020-04-26:
Context:

By default device #9 is set to an external drive. I tried addressing an external drive by executing load"$",9. I didn't actually have an external drive hooked up.

Witnessed behavior:

When I issues the command, sound was audible from the internal speaker that sounded like a motor was spinning up and coming to a close in rapid succession.

Expected behaviour:

No sound should be audible for external drive access.

gardners, 2020-04-27:
As we discussed, your machine has no internal speaker :) You are hearing the real floppy drive tracking the head movements that the SD card would have triggered, had they been real disk accesses.  Thus this is expected and correct behaviour

RalphEgas, 2020-04-27:
@gardners well, I'm not convinced that this issue can be dismissed, regardless of the sound coming from an actual internal drive. The issue as stated above addresses the fact that an internal sound is heard from an external drive that wasn't even hooked up.

In the external drive's absence, no sound should be heard when accessing one.

What would happen if one actually ended up hooking up an external drive. Would you then hear both external and internal drive spin up their motors? That can't be right.

gardners, 2020-04-27:
The noise from the internal drive only occurs when accessing a disk image from the SD card, ie., there is no real drive as the data source. When a real drive is the data source, there is no "ghosting" by the internal drive, just the real drive actions, so you can't get duplicated noise.  But as to whether we want the external drive over SD to make the internal drive whirr, that probably comes down to a user experience thing. My feeling is that it would be weirder to have ,8 make noise, but not ,9, even though both are coming from SD card.  Probably worth checking with Deft for a final decision.

RalphEgas, 2020-04-27:
I think you're absolutely right with regards to consistency in hearing sounds for #8 and #9 if both come from an SD card. What I'm arguing though is sound coming off an external drive that is *not* tied to an SD card. But then again, my assumption that I was selecting an actual external drive (not and SD card equivalent) may have been wrong and you already assumed this to be the case may have given rise to your argument. To be clear, I selected 1565 drive 1 under (1) External 1565 and assume this would access an external drive hooked up to the serial port. If that is not what this setting means, but instead it still means I'm somehow hooking up #9 to an internal thing, then I understand where you're coming from. Then still, the wording on the device selection in the freeze menu is hopelessly non-intuitive.

frehwagen, 2020-04-27:
The internal logic is real floppy internal or external map ot the same physical port at the moment, so you acutually have an external one it is the internal.

The source on sd mounts is a different issue.

frehwagen, 2020-04-27:
The issue is more that freezer offer the external drive that is not supported at the moment, I would think.

gardners, 2020-04-28:
Well, the problem is that the F011 doesn't correctly activate the external drive when selected. It is presumably still driving the same select line. The hardware *should* with a dual 34-pin floppy cable work with 2 drives.  This is of course untested at the moment.

(Note that the 2nd drive on a finished machine, is intended to be via a 1565 compatible C65 external floppy connection, not a normal C64 serial connection. Or people can just hang the 34-pin floppy cable and power out the back if they want an ugly solution.)

Ok. I just looked into this, and the 2nd floppy drive is not yet plumbed through, and does indeed use the internal drive mechanism.  I'm about to file an issue for this, and submit a fix for it.

gardners, 2020-04-28:
Ok. Synthesising that fix.  This will mean trying to use floppy drive 2 with a single-drive MEGA65 will fail, instead of using the internal mechanism. I don't have a 3.5" drive or disks here, but I do have 5.25" ones, somewhat ironically.

frehwagen, 2020-04-28:
Reopend because we are doing some code changes here.

But isn't it that we now loose the default option to have mounted drive 0/8 (SD) and use internal floppy as drive 1/9? GEOS implementation at least relies the fact the drive 1 floppy is actually map to the internal drive.

I think we need an option to map between F011 and internal floppy drive number more flexible.

frehwagen, 2020-04-28:
Ah it is done on #217.

Closed 2020-04-28.

Thread 215 (2020-04-27):

SDHC cards of 16GB or larger don't like ACMD41 initialisation

gardners, 2020-04-27:
SDHC cards don't like the ACMD41 initialisation sequence, as it makes them think the host is SDC only, and so they allow access to only a small fraction of the storage. (See https://electronics.stackexchange.com/questions/358114/sd-card-block-read-write-issue-in-spi-mode-stm32-cmd17-cmd24 )

So will try to fix this.

##BREAKS 16GB SDHC card capacity correctly recognised in FDISK

gardners, 2020-04-27:
Note this seems to mostly be a problem with the external microSD slot. 8GB and 16GB cards work on the internal slot for me, but neither properly on the external slot.

gardners, 2020-04-27:
Seems to work, but there was actually a problem in FDISK that was also responsible.

lydon42, 2022-01-05:
Tested with latest prerelease devel@fc504ef and 920283: 16GB µSDHC is correctly detected and used in external slot.

Closed 2022-01-05.

Thread 217 (2020-04-28):

Selecting second real floppy drive has no effect

gardners, 2020-04-28:
Currently we don't control the 2nd floppy drive, but still drive the internal drive.  This needs to be fixed to control a 2nd drive on the floppy cable (like B: drive on PCs).

Triggered by the discussion at #212

gardners, 2020-04-28:
Created 217-secondfloppy feature branch.
Synthesising now. We will need to test that internal drive still works (I have no 3.5" floppies here), and then try a 2nd floppy drive.

gardners, 2020-04-28:
Seeking track 0 still hangs forever, because the C65 ROM doesn't seem to have a mechanism for limiting the number of track steps that it will attempt before giving up.  This may be because the F011 external drives show low values by default, if not real drive is connected.

frehwagen, 2020-04-28:
Repeat from  #212

Reopend because we are doing some code changes here.

But isn't it that we now loose the default option to have mounted drive 0/8 (SD) and use internal floppy as drive 1/9? GEOS implementation at least relies the fact the drive 1 floppy is actually map to the internal drive.

I think we need an option to map between F011 and internal floppy drive number more flexible.

gardners, 2020-04-28:
Yes, we can add a flag to swap the internal and external floppy IDs, so that we have the best of all worlds.

RalphEgas, 2020-04-28:
@gardners I noticed an infinite hang until I actually put in a 3.5" floppy into the internal real drive as well, btw. I don't know whether this is standard behaviour for a F011. I don't think this was the case of 1581 drives on the C64 though. That would just report an error immediately if no floppy was inserted.

gardners, 2020-04-28:
That's fixed in the unstable branch, but has yet to be merged in.

Paul.

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

gardners, 2020-04-28:
ok. I am working on allowing swapping internal/external drive for @frehwagen, and also including the "no infinite hang" problem for you @RalphEgas
Will share bitstream when cooked.

frehwagen, 2020-05-24:
Cherry picked to #192 branch, for testing together.

frehwagen, 2020-05-24:
Includes #147

lydon42, 2024-08-17:
@gardners do you remember if this is finished? The tagged commits are all in release-0.96 and development.

Thread 218 (2020-05-03):

Error while Compiling

Nato-Hendo, 2020-05-03:
I'm currently attempting to compile via make and am receiving errors from Vivado stating the Synthesis failed. I've attached a text file containing the console output detailing the error(s). Everything instructed in the 'build' documentation file has been followed so I'm not sure what I'm doing wrong, thanks.

[compiling_error.txt](https://github.com/MEGA65/mega65-core/files/4569660/compiling_error.txt)

gardners, 2020-05-03:
Hello,

use:

make bin/mega65r2.bit

and preferably on the stable_base branch.

We need to clean up the default target and a few other bits and pieces, so
sorry about the confusion.
What board are you targeting?

Let me know if you hit any other problems.

Paul

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

Nato-Hendo, 2020-05-05:
Hi Paul,

Thanks for the assistance, I've followed your advice but am now encountering another error which I assume relates to these error messages as they appear just prior to the failure:

INFO: [Synth 8-139] cannot merge instances iomapper0i_10/\block2.framepacker0/buffer_moby_toggle_reg  and iomapper0i_10/\block2.framepacker0/buffer_offset_reg[11]  because of non-equivalent assertions
INFO: [Synth 8-139] cannot merge instances iomapper0i_10/\block2.framepacker0/buffer_moby_toggle_reg  and iomapper0i_10/\block2.framepacker0/buffer_offset_reg[11]  because of non-equivalent assertions

I've attached a snippet of the output from the terminal.

[compiling_error_02.txt](https://github.com/MEGA65/mega65-core/files/4578514/compiling_error_02.txt)

Thanks, Nathan.

gardners, 2020-05-05:
Hello,

That's weird.
Which branch and commit?

Paul.

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

Nato-Hendo, 2020-05-05:
According to git show:
commit 4abef64aee57c16b88e2cfa144bf17c936755c55 (HEAD -> stable_base, origin/stable_base)

gardners, 2020-05-05:
Can you please try:

git checkout 165-hyperram
make bin/mega65r2.bit

And tell me how that goes?

Thanks,
Paul.

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

Nato-Hendo, 2020-05-06:
Using those, I receive the following error:

make: *** No rule to make target 'src/vhdl/gen_utils.vhd', needed by 'vivado/mega65r2.xpr'.  Stop.

[compiling_error_03.txt](https://github.com/MEGA65/mega65-core/files/4584743/compiling_error_03.txt)

gardners, 2020-05-07:
Hello,

Ok. I have just added and pushed those.  Let me know if it still doesn't
build. But if you try in the next couple of hours, do another pull and try
again, as I am actively working on a couple of things for that branch.

Paul.

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

Nato-Hendo, 2020-05-07:
Thanks Paul, after pulling I received this error:

make: *** No rule to make target 'src/vhdl/s27kl0641.vhd', needed by 'vivado/mega65r2.xpr'.  Stop.

gardners, 2020-05-07:
Hello,

Hmm.. ok. That's one that is only used for simulation.  Pushing a fix to
the Makefile for this.

Paul.

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

rdpeake, 2021-02-28:
closing due to inactivity - builds via development branch should be working at this time for r2 board though

Closed 2021-02-28.

Thread 233 (2020-06-11):

Call for documentation revision

Kern0042, 2020-06-11:
## Brief
Whilst venturing down the lovely rabbit hole of getting the Megacore running, I believe that a lot of confusion whilst compiling could be cleared up with a revision of the documentation. <br /> <br />

## Suggestions
### General Improvements
The index needs a clearer layout. This could be achieved by revising the naming conventions and blocking the documentation into sections, e.g. Compiling the MegaCore, Basic Interactions with the MegaCore and Advanced Interactions with the MegaCore.

### Getting Started/First time compiling experience for new members of the community.
Compiling the Megacore could included various basic guides to get started with specific version numbers and examples of what the user should be seeing. This is proposed primarily as a tool to show the member what they should expect so the member can get closer to understanding and contributing to the project. As it stands the documentation is there just disjointed and in need of some TLC.

### Basic Interactions
May include a list and examples of the most basic interactions a user may be able to do with the program.

### Advanced Interactions
This may include a more collaborative approach allowing the community to contribute guides for how to use their latest features etc. hand in hand with the next suggestion.

### Function List
A list to document all the current features in the project and to tie all git hub commits to a central location such as index.

gardners, 2020-06-11:
It would be helpful if you made examples of what you are proposing.

Kern0042, 2020-06-11:
One complete guide could be all this project needs as long as all version numbers are listed so newbies could replicate the method if they were having issues for example compiling the dev build (mostly exposure so that when switching to a dev build they can undertstand whats happening). Each heading could link to its own page however if possible it would be amazing to have a full PDF using the structure mentioned, the current table of contents could resemble.

# Table of Contents:
1. Getting Started - How to successfully compile. A through guide using version XXXX of ubuntu 64bit methods
shown will work for version XXXX process may vary depending on distro of choice.
1.1 Requirements
1.2 Dependency - Version XXX
1.3 Method
1.4 Example of a successful compile.
2. Basic Interactions - (Formally known as using.md) Various commands and functions and how to use the basic features.
2.1 Ect
2.2 ect
2.3 ect
3. Advanced Interactions - Community describes advanced commands ,debug tools or docs possibly discussion on tools to write a custom OS.
3.1 Tools -
3.2 Quirks of the Emulator
4. Helpful Links
4.1 MEGA65 - same as current table of contents but hyperlinked to its own page
4.2 C65
4.3 C64
4.4 Misc

Ben-401, 2020-06-12:
i agree that the documentation is out of date.

I agree that listing the updated requirements to build would be most useful. I just did a clean clone, master branch, "make", and it failed at about "iverilog" as autoconf was not found.

I understand the previous requirements were listed in:
https://github.com/MEGA65/mega65-core/blob/master/docs/build.md#compiling
but this is now outdated.

Ben-401, 2020-06-12:
i could at least provide a list of dependencies that my system complains about, and post them into a list to try and resolve what are the packages required. I use ubuntu 18.

Paul can you please advise what branch any updates to the build process should be applied to?
I would hope that the master branch file readme.md is at least updated as this is what people see either from a clean checkout/clone or via the github UI.

gardners, 2020-06-12:
Yes, that would be helpful.
master, stable_base and 138-hdmi-audio-27mhz are the three key branches at
the moment.
Basically stable_Base will get merged onto master at some point, and
138-hdmi-audio-27mhz onto stable.
If you can report the missing dependencies, that would be great.

Paul.

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

Closed 2022-01-03.

Thread 234 (2020-06-16):

CBM DOS does not sense disk change and cache things over disk change too?

lgblgblgb, 2020-06-16:
During Xemu development Snoopy from Forum64 reported a bug in Xemu/MEGA65: https://github.com/lgblgblgb/xemu/issues/118

Summary: after disk change the "free blocks" shows the previous disk. This indicates CBM DOS caches some information and **_this situation can be dangerous (ie, what if the BAM is cached too, and a writes happens after disk change?)._** Initially I found that a bug of Xemu itself, since disk change signal was not emulated. However now it seems:

* the situation remains even after proper implementation of the disk change bit
* more over: it seems **MEGA65 itself is affected as well, this is the reason I reported here** too

**(real, rev2 PCB) MEGA65 testing method was:**

*  power-on, with default MEGA65.D81, DIR command, 1 blocks free (quite crowded a disk ...)
*  restore -> mount another disk image -> resume
*  DIR command, the correct directory shown (of the new D81) but with 1 blocks free, still!
* Issuing the COLLECT command, then DIR -> now the correct blocks free info can be seen

_Remark: COLLECT actually does "V"alidate the disk, which can be dangerous (if it's a GEOS disk for example) so it's merely an example only._

Can anyone other confirm this problem? Also, I'm not sure "what to blame" here for this problem. It can be simply a ROM bug from Commodore. Or a slightly different method it want to use, not the same as documented on F011 (what we used to implement it ...). Or it can be a testing mistake of mine :) Or whatever ...

gardners, 2020-06-16:
Its quite possible that the diskchange line handling in the FDC is broken in some way.  This needs to get fixed.

lgblgblgb, 2020-06-16:
What consider a bit strange here, that the chance of having bad disk change signal implementation in mega65-core is lower, since I met the same problem with xemu, where I implemented that disk change signal now with debug messages, and indeed, the bit sets and resets when it needs to be, but still, the problem remained! Maybe a ROM disasm/etc would be needed to see what CBM DOS actually does to try to detect disk change (if it tries at all, who knows ...). Though, just wondering that maybe the bit should have inverted meaning what I assumed, hmmm .. ?

gardners, 2020-06-16:
Well, I'll investigate it when I get the chance. I did notice when I implemented the auto track seek that I wasn't convinced I was seeing the disk change line doing what it should. So we will see. But it might be a while before I attack it.

adtbm, 2020-07-21:
I have to add, since Snoopy is still experimenting with it here: [https://www.forum64.de/index.php?thread/103179-disc-change-bug-in-c65-rom/]
When swapping images the number of free blocks remains the same -known-

BUT...
This bug only happens on the real MEGA65 when swapping images NOT when swapping real floppy discs.

Snoopy patched the 911001 ROM, this results, that the image swapping bug is gone, but now
there are problems accessing the real floppy drive.

So i am not sure, if Snoopys patch is OK and there is something wrong with the real drive implementation or if it is something else

gardners, 2020-07-21:
Can you please confirm if this occurs with the latest 138-hdmi-audio-27mhz branch builds, as those have some fixes for making the drive step to the right place, and if I remember correctly, some tweaking of the disk change stuff.

adtbm, 2020-07-21:
Yes i can confirm i've used the 138-5503-HD bitstream.

Thread 240 (2020-06-21):

Open-roms Ophis not cloned on root make

rdpeake, 2020-06-21:
When attempting to run make on a fresh download of the repo, it fails to run the open-roms make file as it does not init/update the submodules in order to pull down Ophis. (manually doing this in the open-roms folder worked to get past that point.

Ben-401, 2020-06-21:
what branch are you using?
Please use stable_base branch and not master.
Please post the logs if there is an error.

rdpeake, 2020-06-21:
was using development as that was what was suggested by the build readme file - will try stable_base now

rdpeake, 2020-06-21:
Running on stable_base seemed to work up to vivaldo builds - though with the dependencies i'd already installed having to do it the first time.

Given i'm talking dependencies - i figure i should probably point out i needed to install the following in order to get make to run under windows subsystem for linux, ubuntu 18.04 LTS

make, gcc, libusb-1.0-0-dev, libpng-dev (not sure this is needed), autoconf, gperf, flex, bison, g++, openjdk-11-jre-headless, python-minimal, imagemagick

I also had to make sure the vivaldo i installed was available via /opt/ - as it installed into /tools/ by default.

The issue i have now is DRC: `ERROR: [DRC MDRV-1] Multiple Driver Nets: Net machine0/cpu0/reg_math_write has multiple drivers: machine0/cpu0/reg_math_write_reg/Q, and machine0/cpu0/reg_math_write_reg__0/Q.`

gardners, 2020-06-21:
That'd be a bug in the VHDL. use 138-hdmi-audio27mhz branch for now.  That should build.

frehwagen, 2020-06-21:
Actually what target are you trying to build? Looks like the Makefile lists unsupported targets with "all:". I'll fix this.

Currently we maintain mega65r2 and megaphoner1, if you want to try another then you need to specify this with you make command.

make bin/nexys4ddr.mcs

For instance.

rdpeake, 2020-06-21:
i'm just running make directly with no target - as i was just trying to get it to build to make sure i could use the subsytem rather than needing to use a vm, or seperate computer in advance of getting a dev kit
will use the branch gardners suggests

rdpeake, 2020-06-21:
unless frehwagen is correct in that i need to specify a different build target the 138-hdmi-audio-27mhz fails to build due to missing vhdl file /ipcore_dir/dotclock100.vhd.
i may need to clean, given the change in branch - but last time i used clean make failed to work again

Ben-401, 2020-06-21:
hi, thank you for the information on what dependancies are required for windows-subsystem-linnux.
I can use that info as I am updating the build instructions now, see #236

How did you go in building the bitstream(s)?

What version of vivado are you using please?
i am just interested, i dont think there is a dependency on what version used...

rdpeake, 2020-06-21:
I have tried using `make` on branches stable-base, and 138-hdmi-audio-27mhz and they both failed during the build of 'mega65r1' for different reasons. based on frehwagen's comment i attempted to use mega65r2.mcs and megaphoner1.mcs on both branches however they all fail for the reason identified before. and as i indicated, development fails to build due to make errors. never tried master and figured it wasn't worth trying. the 'make clear' target may need to be double checked, as i tried to use that at one point and it didn't end well.

As i currently have no hardware to deploy this to, i'm not particularly worried about it not working, as i was mainly doing this to get it setup prior to the dev kit showing up some time later this year, and trying to understand how the code base is set up for potentially porting MISTer cores once i do get the dev kit.

rdpeake, 2020-06-21:
And because i forgot to answer - i am using vivado 2020.1

gardners, 2020-06-21:
Yes, I have only just updated to 2019.2.1 and don't currently have enough disk space to also install 2020.1 (its also a pain over satellite internet). It's possible that 2020.1 has some extra check that is detecting what it thinks is a multiple diver.  If it isn't a big hassle, you could try 2019.2.1 and see if the problems are still there?

rdpeake, 2020-06-21:
given i had to symlink 2020.1 in to the opt tool spot - it shouldn't be too hard to do it for 2019.2 will give it a go.

rdpeake, 2020-06-22:
using 2019.2 i was able to get to the make file trying to make mega65_ftp before it failed - given the statement above about what targets are maintained - i'm guessing this is a good place to be at and can wait until more details (and improvements are made) as dev kits get closer

Ben-401, 2020-06-22:
yes, we are working on cleaning up the build process.
the focus has been on development for a long while.
please come back soon and keep an eye out on us.

Ben-401, 2020-06-22:
its worth a mention, that the stable_base branch does in fact clone the Ophis
(see lines 30, 32, 42, 118, as shown below.
In that regard, I suggest this issue be closed, and the doco updated.
```
     1	devuser@u16vm:~/dev/mega65$
     2	devuser@u16vm:~/dev/mega65$ date
     3	Monday 22 June  11:03:20 ACST 2020
     4	devuser@u16vm:~/dev/mega65$ git clone https://github.com/mega65/mega65-core.git
     5	Cloning into 'mega65-core'...
     6	remote: Enumerating objects: 101, done.
     7	remote: Counting objects: 100% (101/101), done.
     8	remote: Compressing objects: 100% (77/77), done.
     9	remote: Total 45790 (delta 65), reused 49 (delta 24), pack-reused 45689
    10	Receiving objects: 100% (45790/45790), 25.95 MiB | 2.81 MiB/s, done.
    11	Resolving deltas: 100% (34509/34509), done.
    12	Checking connectivity... done.
    13	devuser@u16vm:~/dev/mega65$ cp -r mega65-core/ mega65-core-clean
    14	devuser@u16vm:~/dev/mega65$ cd mega65-core
    15	devuser@u16vm:~/dev/mega65/mega65-core$ git checkout stable_base
    16	Branch stable_base set up to track remote branch stable_base from origin.
    17	Switched to a new branch 'stable_base'
    18	devuser@u16vm:~/dev/mega65/mega65-core$ git show
    19	commit 4a8842dbedf0eae360092dc603553da03c99bf2b
    20	Merge: a9ccc62 9ef3620
    21	Author: frehwagen <frehwagen@bluewaysw.de>
    22	Date:   Sun Jun 21 11:36:02 2020 +0200
    23
    24	    Merge pull request #235 from Ben-401/stable_base
    25
    26	    update 2x submodules, change implementation of USE_LOCAL_CC65
    27
    28	devuser@u16vm:~/dev/mega65/mega65-core$ make
    29	Makefile:106: =============================================================
    30	Makefile:106: ~~~~~~~~~~~~~~~~> Making: Ophis/bin/ophis
    31	git submodule init
    32	Submodule 'Ophis' (https://github.com/gardners/Ophis.git) registered for path 'Ophis'
    33	Submodule 'cbmconvert' (https://github.com/sasq64/cbmconvert.git) registered for path 'cbmconvert'
    34	Submodule 'cc65' (https://github.com/cc65/cc65.git) registered for path 'cc65'
    35	Submodule 'ghdl' (https://github.com/ghdl/ghdl.git) registered for path 'ghdl'
    36	Submodule 'iverilog' (https://github.com/steveicarus/iverilog.git) registered for path 'iverilog'
    37	Submodule 'src/mega65-fdisk' (https://github.com/MEGA65/mega65-fdisk.git) registered for path 'src/mega65-fdisk'
    38	Submodule 'src/mega65-freezemenu' (https://github.com/MEGA65/mega65-freezemenu.git) registered for path 'src/mega65-freezemenu'
    39	Submodule 'src/mega65-libc' (https://github.com/MEGA65/mega65-libc.git) registered for path 'src/mega65-libc'
    40	Submodule 'open-roms' (https://github.com/MEGA65/open-roms.git) registered for path 'src/open-roms'
    41	git submodule update
    42	Cloning into 'Ophis'...
    43	remote: Enumerating objects: 31, done.
    44	remote: Counting objects: 100% (31/31), done.
    45	remote: Compressing objects: 100% (19/19), done.
    46	remote: Total 1081 (delta 20), reused 23 (delta 12), pack-reused 1050
    47	Receiving objects: 100% (1081/1081), 3.36 MiB | 1.37 MiB/s, done.
    48	Resolving deltas: 100% (584/584), done.
    49	Checking connectivity... done.
    50	Submodule path 'Ophis': checked out 'e6ae193fb11ade39b9c7750b36f509da5106adc0'
    51	Cloning into 'cbmconvert'...
    52	remote: Enumerating objects: 42, done.
    53	remote: Total 42 (delta 0), reused 0 (delta 0), pack-reused 42
    54	Unpacking objects: 100% (42/42), done.
    55	Checking connectivity... done.
    56	Submodule path 'cbmconvert': checked out '1569e9c38d2873fc81c862d4f79b68cc51d2100f'
    57	Cloning into 'cc65'...
    58	remote: Enumerating objects: 110, done.
    59	remote: Counting objects: 100% (110/110), done.
    60	remote: Compressing objects: 100% (76/76), done.
    61	remote: Total 61702 (delta 54), reused 67 (delta 31), pack-reused 61592
    62	Receiving objects: 100% (61702/61702), 22.60 MiB | 2.49 MiB/s, done.
    63	Resolving deltas: 100% (39006/39006), done.
    64	Checking connectivity... done.
    65	Submodule path 'cc65': checked out '6c320f7d654d9c04482b3486abe063c1ac1735bd'
    66	Cloning into 'ghdl'...
    67	remote: Enumerating objects: 253, done.
    68	remote: Counting objects: 100% (253/253), done.
    69	remote: Compressing objects: 100% (178/178), done.
    70	remote: Total 48345 (delta 118), reused 142 (delta 75), pack-reused 48092
    71	Receiving objects: 100% (48345/48345), 59.20 MiB | 2.81 MiB/s, done.
    72	Resolving deltas: 100% (36832/36832), done.
    73	Checking connectivity... done.
    74	Submodule path 'ghdl': checked out 'c00074985783c13dce54de3814c39e76cf269268'
    75	Cloning into 'iverilog'...
    76	remote: Enumerating objects: 58626, done.
    77	remote: Total 58626 (delta 0), reused 0 (delta 0), pack-reused 58626
    78	Receiving objects: 100% (58626/58626), 23.12 MiB | 2.81 MiB/s, done.
    79	Resolving deltas: 100% (46992/46992), done.
    80	Checking connectivity... done.
    81	Submodule path 'iverilog': checked out '40558160e7e4217eca3fcdf60fa357391e5f2700'
    82	Cloning into 'src/mega65-fdisk'...
    83	remote: Enumerating objects: 26, done.
    84	remote: Counting objects: 100% (26/26), done.
    85	remote: Compressing objects: 100% (21/21), done.
    86	remote: Total 399 (delta 13), reused 17 (delta 5), pack-reused 373
    87	Receiving objects: 100% (399/399), 110.43 KiB | 0 bytes/s, done.
    88	Resolving deltas: 100% (255/255), done.
    89	Checking connectivity... done.
    90	Submodule path 'src/mega65-fdisk': checked out '340914b85ba979e1a8e26a55aee5fc87ff14244b'
    91	Cloning into 'src/mega65-freezemenu'...
    92	remote: Enumerating objects: 35, done.
    93	remote: Counting objects: 100% (35/35), done.
    94	remote: Compressing objects: 100% (19/19), done.
    95	remote: Total 683 (delta 19), reused 31 (delta 16), pack-reused 648
    96	Receiving objects: 100% (683/683), 224.31 KiB | 340.00 KiB/s, done.
    97	Resolving deltas: 100% (445/445), done.
    98	Checking connectivity... done.
    99	Submodule path 'src/mega65-freezemenu': checked out '4af915a900d087662d693c3766aa593d630f2859'
   100	Cloning into 'src/mega65-libc'...
   101	remote: Enumerating objects: 189, done.
   102	remote: Counting objects: 100% (189/189), done.
   103	remote: Compressing objects: 100% (110/110), done.
   104	remote: Total 189 (delta 98), reused 163 (delta 76), pack-reused 0
   105	Receiving objects: 100% (189/189), 30.06 KiB | 0 bytes/s, done.
   106	Resolving deltas: 100% (98/98), done.
   107	Checking connectivity... done.
   108	Submodule path 'src/mega65-libc': checked out '43c6f7484bb3dbe2c8ba50931f9e46c49188b6da'
   109	Cloning into 'src/open-roms'...
   110	remote: Enumerating objects: 11125, done.
   111	remote: Total 11125 (delta 0), reused 0 (delta 0), pack-reused 11125
   112	Receiving objects: 100% (11125/11125), 4.29 MiB | 1.89 MiB/s, done.
   113	Resolving deltas: 100% (7691/7691), done.
   114	Checking connectivity... done.
   115	Submodule path 'src/open-roms': checked out '6deb5a4322fe9dd7c796c28125bc98aff4b2edff'
   116	Makefile:479: =============================================================
   117	Makefile:479: ~~~~~~~~~~~~~~~~> Making: src/utilities/ethertest.prg
   118	Ophis/bin/ophis -4 src/utilities/ethertest.a65 -l src/utilities/ethertest.list -m src/utilities/ethertest.map -o src/utilities/ethertest.prg
   119	src/utilities/ethertest.a65:83: WARNING: branch out of range, replacing with 16-bit relative branch
   120	Assembly complete: 414 bytes output (304 code, 102 data, 8 filler)
   121	Makefile:479: =============================================================
   122	Makefile:479: ~~~~~~~~~~~~~~~~> Making: src/utilities/etherload.prg
   123	Ophis/bin/ophis -4 src/utilities/etherload.a65 -l src/utilities/etherload.list -m src/utilities/etherload.map -o src/utilities/etherload.prg
   124	src/utilities/etherload.a65:219: WARNING: branch out of range, replacing with 16-bit relative branch
   125	src/utilities/etherload.a65:225: WARNING: branch out of range, replacing with 16-bit relative branch
   126	src/utilities/etherload.a65:231: WARNING: branch out of range, replacing with 16-bit relative branch
   127	src/utilities/etherload.a65:234: WARNING: branch out of range, replacing with 16-bit relative branch
   128	src/utilities/etherload.a65:243: WARNING: branch out of range, replacing with 16-bit relative branch
   129	Assembly complete: 276 bytes output (264 code, 12 data, 0 filler)
   130	Makefile:479: =============================================================
   131	Makefile:479: ~~~~~~~~~~~~~~~~> Making: src/utilities/test01prg.prg
   132	Ophis/bin/ophis -4 src/utilities/test01prg.a65 -l src/utilities/test01prg.list -m src/utilities/test01prg.map -o src/utilities/test01prg.prg
   133	Assembly complete: 46 bytes output (14 code, 23 data, 9 filler)
   134	Makefile:479: =============================================================
   135	Makefile:479: ~~~~~~~~~~~~~~~~> Making: src/utilities/c65test02prg.prg
   136	Ophis/bin/ophis -4 src/utilities/c65test02prg.a65 -l src/utilities/c65test02prg.list -m src/utilities/c65test02prg.map -o src/utilities/c65test02prg.prg
   137	Assembly complete: 68 bytes output (34 code, 31 data, 3 filler)
   138	Makefile:479: =============================================================
   139	Makefile:479: ~~~~~~~~~~~~~~~~> Making: src/utilities/c65-rom-910111-fastload-patch.prg
   140	Ophis/bin/ophis -4 src/utilities/c65-rom-910111-fastload-patch.a65 -l src/utilities/c65-rom-910111-fastload-patch.list -m src/utilities/c65-rom-910111-fastload-patch.map -o src/utilities/c65-rom-910111-fastload-patch.prg
   141	Assembly complete: 149 bytes output (149 code, 0 data, 0 filler)
   142	Makefile:479: =============================================================
   143	Makefile:479: ~~~~~~~~~~~~~~~~> Making: src/utilities/hdmitest.prg
   144	Ophis/bin/ophis -4 src/utilities/hdmitest.a65 -l src/utilities/hdmitest.list -m src/utilities/hdmitest.map -o src/utilities/hdmitest.prg
   145	Assembly complete: 927 bytes output (750 code, 169 data, 8 filler)
   146	Makefile:479: =============================================================
   147	Makefile:479: ~~~~~~~~~~~~~~~~> Making: src/utilities/vfpgatest.prg
   148	Ophis/bin/ophis -4 src/utilities/vfpgatest.a65 -l src/utilities/vfpgatest.list -m src/utilities/vfpgatest.map -o src/utilities/vfpgatest.prg
   149	Assembly complete: 2414 bytes output (551 code, 1855 data, 8 filler)
   150	Makefile:479: =============================================================
   151	Makefile:479: ~~~~~~~~~~~~~~~~> Making: src/utilities/sdbitbash.prg
   152	Ophis/bin/ophis -4 src/utilities/sdbitbash.a65 -l src/utilities/sdbitbash.list -m src/utilities/sdbitbash.map -o src/utilities/sdbitbash.prg
   153	Assembly complete: 148 bytes output (116 code, 24 data, 8 filler)
   154	Makefile:95: =============================================================
   155	Makefile:95: ~~~~~~~~~~~~~~~~> Making: cc65/bin/cc65
   156	git submodule init
   157	git submodule update
   158	( cd cc65 && make -j 8 )
   159	make[1]: Entering directory '/home/devuser/dev/mega65/mega65-core/cc65'
   160	ar65/objdata.c
   161	ar65/error.c
   162	ar65/library.c
   163	ar65/del.c
   164	ar65/fileio.c
   165	ar65/list.c
   166	ar65/exports.c
   167	ar65/extract.c
   168	ar65/main.c
   169	ar65/global.c
   170	ar65/add.c
   171	ar65/objfile.c
   172	common/check.c
   173	common/abend.c
   174	common/shift.c
   175	common/target.c
   176	common/gentype.c
   177	common/searchpath.c
   178	common/intptrstack.c
   179	common/fileid.c
   180	common/strstack.c
   181	common/hashfunc.c
   182	common/coll.c
   183	common/segnames.c
   184	common/alignment.c
   185	common/bitops.c
   186	common/strbuf.c
   187	common/fname.c
   188	common/strpool.c
   189	common/mmodel.c
   190	common/chartype.c
   191	common/debugflag.c
   192	common/cmdline.c
   193	common/fp.c
   194	common/cpu.c
   195	common/matchpat.c
   196	common/filepos.c
   197	common/filetime.c
   198	common/tgttrans.c
   199	common/xsprintf.c
   200	common/xmalloc.c
   201	common/filestat.c
   202	common/filetype.c
   203	common/exprdefs.c
   204	common/strutil.c
   205	^CMakefile:150: recipe for target '../wrk/common/exprdefs.o' failed
   206	make[2]: *** [../wrk/common/exprdefs.o] Interrupt
   207	Makefile:150: recipe for target '../wrk/common/tgttrans.o' failed
   208	make[2]: *** [../wrk/common/tgttrans.o] Interrupt
   209	Makefile:150: recipe for target '../wrk/common/xsprintf.o' failed
   210	make[2]: *** [../wrk/common/xsprintf.o] Interrupt
   211	Makefile:150: recipe for target '../wrk/common/xmalloc.o' failed
   212	make[2]: *** [../wrk/common/xmalloc.o] Interrupt
   213	Makefile:150: recipe for target '../wrk/common/filestat.o' failed
   214	make[2]: *** [../wrk/common/filestat.o] Interrupt
   215	Makefile:150: recipe for target '../wrk/common/filetype.o' failed
   216	make[2]: *** [../wrk/common/filetype.o] Interrupt
   217	make[2]: *** Deleting file '../wrk/common/cmdline.o'
   218	make[2]: *** wait: No child processes.  Stop.
   219	make[2]: *** Waiting for unfinished jobs....
   220	make[2]: *** wait: No child processes.  Stop.
   221	Makefile:150: recipe for target '../wrk/common/strutil.o' failed
   222	make[2]: *** [../wrk/common/strutil.o] Error 2
   223	make[2]: *** wait: No child processes.  Stop.
   224	make[2]: *** Waiting for unfinished jobs....
   225	make[2]: *** wait: No child processes.  Stop.
   226	Makefile:150: recipe for target '../wrk/common/hashtab.o' failed
   227	make[2]: *** [../wrk/common/hashtab.o] Error 2
   228	Makefile:6: recipe for target 'all' failed
   229	make[1]: *** [all] Interrupt
   230	Makefile:95: recipe for target 'cc65/bin/cc65' failed
   231	make: *** [cc65/bin/cc65] Interrupt
   232
   233	devuser@u16vm:~/dev/mega65/mega65-core$
   234
devuser@u16vm:~/dev/ben-401/mega65-core$

rdpeake, 2020-06-22:
yes, the original issue was resolved once the correct branch to build was given - also able to build supported targets using 2019.2.1 of vivado and the listed dependencies on WSL.

Closed 2020-06-22.

Thread 242 (2020-06-22):

old vivado 2016.2 unsupported, resolve dependency (u16), xpr tcl dsa.num_compute_units

Ben-401, 2020-06-22:
in ubuntu 16 with vivado 2016.2:
```make``` fails, as does ```make bin/nexys4ddr.bit```.

Seems the TCL-script that creates the XPR-file uses a setting that is not supported in v2016.2.
I am yet to confirm this.

```
devuser@u16vm:~/dev/ben-401/mega65-core$ make
Makefile:823: =============================================================
Makefile:823: ~~~~~~~~~~~~~~~~> Making: vivado/mega65r1.xpr
echo MOOSE vivado/mega65r1.xpr from vivado/mega65r1_gen.tcl
MOOSE vivado/mega65r1.xpr from vivado/mega65r1_gen.tcl
./vivado_wrapper -mode batch -source vivado/mega65r1_gen.tcl
vivado -mode batch -source vivado/mega65r1_gen.tcl

****** Vivado v2016.2 (64-bit)
  **** SW Build 1577090 on Thu Jun  2 16:32:35 MDT 2016
  **** IP Build 1577682 on Fri Jun  3 12:00:54 MDT 2016
    ** Copyright 1986-2016 Xilinx, Inc. All Rights Reserved.

source vivado/mega65r1_gen.tcl
# set origin_dir [file dirname [info script]]/..
# if { [info exists ::origin_dir_loc] } {
#   set origin_dir $::origin_dir_loc
# }
# set project_name "mega65r1"
# if { [info exists ::user_project_name] } {
#   set project_name $::user_project_name
# }
# variable script_file
# set script_file "mega65r1.tcl"
# proc help {} {
#   variable script_file
#   puts "\nDescription:"
#   puts "Recreate a Vivado project from this script. The created project will be"
#   puts "functionally equivalent to the original project for which this script was"
#   puts "generated. The script contains commands for creating a project, filesets,"
#   puts "runs, adding/importing sources and setting properties on various objects.\n"
#   puts "Syntax:"
#   puts "$script_file"
#   puts "$script_file -tclargs \[--origin_dir <path>\]"
#   puts "$script_file -tclargs \[--project_name <name>\]"
#   puts "$script_file -tclargs \[--help\]\n"
#   puts "Usage:"
#   puts "Name                   Description"
#   puts "-------------------------------------------------------------------------"
#   puts "\[--origin_dir <path>\]  Determine source file paths wrt this path. Default"
#   puts "                       origin_dir path value is \".\", otherwise, the value"
#   puts "                       that was set with the \"-paths_relative_to\" switch"
#   puts "                       when this script was generated.\n"
#   puts "\[--project_name <name>\] Create project with the specified name. Default"
#   puts "                       name is the name of the project from where this"
#   puts "                       script was generated.\n"
#   puts "\[--help\]               Print help information for this script"
#   puts "-------------------------------------------------------------------------\n"
#   exit 0
# }
# if { $::argc > 0 } {
#   for {set i 0} {$i < [llength $::argc]} {incr i} {
#     set option [string trim [lindex $::argv $i]]
#     switch -regexp -- $option {
#       "--origin_dir"   { incr i; set origin_dir [lindex $::argv $i] }
#       "--project_name" { incr i; set project_name [lindex $::argv $i] }
#       "--help"         { help }
#       default {
#         if { [regexp {^-} $option] } {
#           puts "ERROR: Unknown option '$option' specified, please type '$script_file -tclargs --help' for usage info.\n"
#           return 1
#         }
#       }
#     }
#   }
# }
# create_project -force ${project_name} vivado/ -part xc7a200tfbg484-2
# set proj_dir [get_property directory [current_project]]
# set obj [current_project]
# set_property -name "default_lib" -value "xil_defaultlib" -objects $obj
# set_property -name "dsa.num_compute_units" -value "60" -objects $obj
ERROR: [Common 17-142] Invalid property name 'dsa.num_compute_units'.  Please use the 'list_property' command to find properties supported by the target 'project' object.
INFO: [Common 17-206] Exiting Vivado at Mon Jun 22 17:03:37 2020...
Makefile:823: recipe for target 'vivado/mega65r1.xpr' failed
make: *** [vivado/mega65r1.xpr] Error 1
devuser@u16vm:~/dev/ben-401/mega65-core$
```

Re-runnung ```make```
```
devuser@u16vm:~/dev/ben-401/mega65-core$ make
Makefile:831: =============================================================
Makefile:831: ~~~~~~~~~~~~~~~~> Making: bin/mega65r1.bit
echo MOOSE bin/mega65r1.bit from vivado/mega65r1.xpr
MOOSE bin/mega65r1.bit from vivado/mega65r1.xpr
mkdir -p sdcard-files
./vivado_wrapper -mode batch -source vivado/mega65r1_impl.tcl vivado/mega65r1.xpr
vivado -mode batch -source vivado/mega65r1_impl.tcl vivado/mega65r1.xpr

****** Vivado v2016.2 (64-bit)
  **** SW Build 1577090 on Thu Jun  2 16:32:35 MDT 2016
  **** IP Build 1577682 on Fri Jun  3 12:00:54 MDT 2016
    ** Copyright 1986-2016 Xilinx, Inc. All Rights Reserved.

open_project vivado/mega65r1.xpr
Scanning sources...
Finished scanning sources
source vivado/mega65r1_impl.tcl
# reimport_files
Reimport all applicable files in the project.
INFO: [Vivado 12-429] No file reimported
# reset_project
# launch_runs synth_1 -jobs 2
CRITICAL WARNING: [filemgmt 20-730] Could not find a top module in the fileset sources_1.
Resolution: With the gui up, review the source files in the Sources window. Use Add Sources to add any needed sources. If the files are disabled, enable them. You can also select the file and choose Set Used In from the pop-up menu. Review if they are being used at the proper points of the flow.
ERROR: [Common 17-53] User Exception: Top module not set for synthesis run
Ensure that a valid value is provided for 'top'. The current value for 'top' can be changed using the 'Top Module Name' field under 'Project Settings', or using the 'set_property top' Tcl command
INFO: [Common 17-206] Exiting Vivado at Mon Jun 22 17:05:06 2020...
Makefile:831: recipe for target 'bin/mega65r1.bit' failed
make: *** [bin/mega65r1.bit] Error 1
devuser@u16vm:~/dev/ben-401/mega65-core$
```

try another target
```
devuser@u16vm:~/dev/ben-401/mega65-core$ make bin/nexys4ddr.bit
Makefile:823: =============================================================
Makefile:823: ~~~~~~~~~~~~~~~~> Making: vivado/nexys4ddr.xpr
echo MOOSE vivado/nexys4ddr.xpr from vivado/nexys4ddr_gen.tcl
MOOSE vivado/nexys4ddr.xpr from vivado/nexys4ddr_gen.tcl
./vivado_wrapper -mode batch -source vivado/nexys4ddr_gen.tcl
vivado -mode batch -source vivado/nexys4ddr_gen.tcl

****** Vivado v2016.2 (64-bit)
  **** SW Build 1577090 on Thu Jun  2 16:32:35 MDT 2016
  **** IP Build 1577682 on Fri Jun  3 12:00:54 MDT 2016
    ** Copyright 1986-2016 Xilinx, Inc. All Rights Reserved.

source vivado/nexys4ddr_gen.tcl
# set origin_dir [file dirname [info script]]/..
# if { [info exists ::origin_dir_loc] } {
#   set origin_dir $::origin_dir_loc
# }
# set project_name "nexys4ddr"
# if { [info exists ::user_project_name] } {
#   set project_name $::user_project_name
# }
# variable script_file
# set script_file "nexys4ddr.tcl"
# proc help {} {
#   variable script_file
#   puts "\nDescription:"
#   puts "Recreate a Vivado project from this script. The created project will be"
#   puts "functionally equivalent to the original project for which this script was"
#   puts "generated. The script contains commands for creating a project, filesets,"
#   puts "runs, adding/importing sources and setting properties on various objects.\n"
#   puts "Syntax:"
#   puts "$script_file"
#   puts "$script_file -tclargs \[--origin_dir <path>\]"
#   puts "$script_file -tclargs \[--project_name <name>\]"
#   puts "$script_file -tclargs \[--help\]\n"
#   puts "Usage:"
#   puts "Name                   Description"
#   puts "-------------------------------------------------------------------------"
#   puts "\[--origin_dir <path>\]  Determine source file paths wrt this path. Default"
#   puts "                       origin_dir path value is \".\", otherwise, the value"
#   puts "                       that was set with the \"-paths_relative_to\" switch"
#   puts "                       when this script was generated.\n"
#   puts "\[--project_name <name>\] Create project with the specified name. Default"
#   puts "                       name is the name of the project from where this"
#   puts "                       script was generated.\n"
#   puts "\[--help\]               Print help information for this script"
#   puts "-------------------------------------------------------------------------\n"
#   exit 0
# }
# if { $::argc > 0 } {
#   for {set i 0} {$i < [llength $::argc]} {incr i} {
#     set option [string trim [lindex $::argv $i]]
#     switch -regexp -- $option {
#       "--origin_dir"   { incr i; set origin_dir [lindex $::argv $i] }
#       "--project_name" { incr i; set project_name [lindex $::argv $i] }
#       "--help"         { help }
#       default {
#         if { [regexp {^-} $option] } {
#           puts "ERROR: Unknown option '$option' specified, please type '$script_file -tclargs --help' for usage info.\n"
#           return 1
#         }
#       }
#     }
#   }
# }
# create_project -force ${project_name} vivado/ -part xc7a100tcsg324-1
# set proj_dir [get_property directory [current_project]]
# set obj [current_project]
# set_property -name "default_lib" -value "xil_defaultlib" -objects $obj
# set_property -name "dsa.num_compute_units" -value "60" -objects $obj
ERROR: [Common 17-142] Invalid property name 'dsa.num_compute_units'.  Please use the 'list_property' command to find properties supported by the target 'project' object.
INFO: [Common 17-206] Exiting Vivado at Mon Jun 22 17:08:08 2020...
Makefile:823: recipe for target 'vivado/nexys4ddr.xpr' failed
make: *** [vivado/nexys4ddr.xpr] Error 1
devuser@u16vm:~/dev/ben-401/mega65-core$
```

Ben-401, 2020-06-22:
i will try vivado 2018.2.1 in ubuntu 16.

Should all targets in the "./vivado/*" directory work?
I will assume that the targets in that dir (on stable_base) of interest are:
mega65r2
nexys4ddr
nexys4

Can someone please advise?

gardners, 2020-06-22:
For now, assume only mega65r2 and megaphoner1 work, and maybe nexys4ddr-widget

Ben-401, 2020-06-22:
Thanks for that @paul,
I have confirmed that with vivado 2018.2,
```make``` generates ```bit/mega65r1.bit``` but fails when contuining on to ```bit/nexys4ddr.bit```.
error log is below.

i have started specifying targets now, and will verify those two/three you listed,

below is the log showing that the ```make``` (ie make all), after the mega65r1 was built, continued onto make the nexys4ddr, but failed.
I will not look into why it fails, merely show that it does fail.
```
Starting synth_design
Attempting to get a license for feature 'Synthesis' and/or device 'xc7a100t'
INFO: [Common 17-349] Got license for feature 'Synthesis' and/or device 'xc7a100t'
INFO: Launching helper process for spawning children vivado processes
INFO: Helper process launched with PID 7128
---------------------------------------------------------------------------------
Starting RTL Elaboration : Time (s): cpu = 00:00:02 ; elapsed = 00:00:03 . Memory (MB): peak = 1319.797 ; gain = 97.914 ; free physical = 4832 ; free virtual = 7511
---------------------------------------------------------------------------------
ERROR: [Synth 8-2032] formal clock80 is not declared [/home/devuser/dev/ben-401/mega65-core/src/vhdl/nexys4ddr.vhdl:319]
ERROR: [Synth 8-2778] type error near qspidb ; expected type unsigned [/home/devuser/dev/ben-401/mega65-core/src/vhdl/nexys4ddr.vhdl:346]
ERROR: [Synth 8-2032] formal clock240 is not declared [/home/devuser/dev/ben-401/mega65-core/src/vhdl/nexys4ddr.vhdl:396]
ERROR: [Synth 8-2029] formal clock50mhz has no actual or default value [/home/devuser/dev/ben-401/mega65-core/src/vhdl/nexys4ddr.vhdl:388]
INFO: [Synth 8-994] clock50mhz is declared here [/home/devuser/dev/ben-401/mega65-core/src/vhdl/machine.vhdl:60]
INFO: [Synth 8-994] clock100 is declared here [/home/devuser/dev/ben-401/mega65-core/src/vhdl/machine.vhdl:61]
INFO: [Synth 8-994] clock27 is declared here [/home/devuser/dev/ben-401/mega65-core/src/vhdl/machine.vhdl:62]
INFO: [Synth 8-994] clock162 is declared here [/home/devuser/dev/ben-401/mega65-core/src/vhdl/machine.vhdl:63]
INFO: [Synth 8-994] btncpureset is declared here [/home/devuser/dev/ben-401/mega65-core/src/vhdl/machine.vhdl:66]
INFO: [Synth 8-994] irq is declared here [/home/devuser/dev/ben-401/mega65-core/src/vhdl/machine.vhdl:68]
INFO: [Synth 8-994] nmi is declared here [/home/devuser/dev/ben-401/mega65-core/src/vhdl/machine.vhdl:69]
INFO: [Synth 8-994] restore_key is declared here [/home/devuser/dev/ben-401/mega65-core/src/vhdl/machine.vhdl:70]
<snip>
INFO: [Synth 8-994] btn is declared here [/home/devuser/dev/ben-401/mega65-core/src/vhdl/machine.vhdl:327]
INFO: [Synth 8-994] rsrx is declared here [/home/devuser/dev/ben-401/mega65-core/src/vhdl/machine.vhdl:330]
INFO: [Synth 8-2810] unit behavioral ignored due to previous errors [/home/devuser/dev/ben-401/mega65-core/src/vhdl/nexys4ddr.vhdl:173]
---------------------------------------------------------------------------------
Finished RTL Elaboration : Time (s): cpu = 00:00:03 ; elapsed = 00:00:05 . Memory (MB): peak = 1486.422 ; gain = 264.539 ; free physical = 4853 ; free virtual = 7533
---------------------------------------------------------------------------------
RTL Elaboration failed
INFO: [Common 17-83] Releasing license: Synthesis
65 Infos, 0 Warnings, 0 Critical Warnings and 5 Errors encountered.
synth_design failed
ERROR: [Common 17-69] Command failed: Synthesis failed - please see the console or run log file for details
INFO: [Common 17-206] Exiting Vivado at Mon Jun 22 19:40:11 2020...
[Mon Jun 22 19:40:11 2020] synth_1 finished
wait_on_run: Time (s): cpu = 00:00:13 ; elapsed = 00:00:14 . Memory (MB): peak = 1230.836 ; gain = 0.000 ; free physical = 5162 ; free virtual = 7841
# launch_runs impl_1 -to_step write_bitstream
ERROR: [Common 17-70] Application Exception: Failed to launch run 'impl_1' due to failures in the following run(s):
synth_1
These failed run(s) need to be reset prior to launching 'impl_1' again.

INFO: [Common 17-206] Exiting Vivado at Mon Jun 22 19:40:11 2020...
Makefile:831: recipe for target 'bin/nexys4ddr.bit' failed
make: *** [bin/nexys4ddr.bit] Error 1
devuser@u16vm:~/dev/ben-401/mega65-core$
```

gardners, 2020-06-22:
It's fine if we specify a minimum version of Vivado, e.g., of 2019.2.1, as there are known bugs in earlier versions.

Closed 2022-01-03.

Thread 247 (2020-07-02):

MEGA65 does not boot if an external POWERED OFF Disc Drive is connected to IEC

adtbm, 2020-07-02:
If an external drive 1581/1541-II is connected to the MEGA65 but is not powered on, the MEGA65 will not boot into C65, it does boot into C64, when MEGA-Key is pressed while switching MEGA65 on.

gardners, 2020-07-02:
This will be due to the powered-off drive holding one or more of the IEC lines low, which the C65 DOS misinterprets as there being a device connected.  Please try making an IEC cable with pull-up resistors to see if this resolves the problem, while not stopping normal IEC operation. If so, we should add/strengthen the IEC pull-ups on the M65 mainboard.

gardners, 2020-07-02:
Confirmed M65 R2 lacks pullups, but C64 has them.

RP6 places 1K pullup to 5V on clock, data and ATN:

http://www.zimmers.net/anonftp/pub/cbm/schematics/computers/c64/250469-rev.B-left-corrected2.gif

C128 also puts pull-ups on the SRQ line via RP5.4:

http://www.zimmers.net/anonftp/pub/cbm/schematics/computers/c128/310378-3-left.gif

We need to make sure that Antti is adding these in the list of missing pullups on the R3 PCB

deftmega, 2021-02-28:
The problem is not completely gone with R3. If 1541-II is connected over IEC and turned off, machine will do (tested with DevKit release default disk image):
a) Lock-up during autoboot in C65 Basic
b) Ignore full speed (40 Mhz) switch
c) Randomly lock up in C65 Mode

dansanderson, 2025-03-31:
Related: https://github.com/MEGA65/mega65-rom-public/issues/169

The pending HW IEC implementation does not have this issue.

Thread 255 (2020-07-14):

monitor_load and nexys4ddr core build errors

vvrbanc, 2020-07-14:
On branch master/stable_base commit 4a8842dbedf0eae360092dc603553da03c99bf2b.

I ran into some issues:

**1) src/tools/monitor_load.c compile fails with multiple errors:**

src/tools/monitor_load.c:152:1: error: unknown type name ‘uint32_t’; did you mean ‘u_int32_t’?

FIX: add #include <stdint.h>

undeclared variables/pointers:

screen_address
next_screen_address
screen_width
screen_line_step
screen_rows_remaining
screen_line_offset
screen_line_buffer

undefined function 'print_screencode'

FIX: I'm guessing some files are missing from source control? I don't see these declared anywhere in the entire repository.

**2) nexys4ddr.mcs target fails during synthesis:**

ERROR: [Synth 8-2032] formal clock80 is not declared [/var/tmp/mega65-core/src/vhdl/nexys4ddr.vhdl:319]
ERROR: [Synth 8-2778] type error near qspidb ; expected type unsigned [/var/tmp/mega65-core/src/vhdl/nexys4ddr.vhdl:346]
ERROR: [Synth 8-2032] formal clock240 is not declared [/var/tmp/mega65-core/src/vhdl/nexys4ddr.vhdl:396]
ERROR: [Synth 8-2029] formal clock50mhz has no actual or default value [/var/tmp/mega65-core/src/vhdl/nexys4ddr.vhdl:388]

It seems to me like some refactoring was done and the nexys4ddr.vhdl was not updated to reflect these changes.

A lot of clock lines were changed/renamed.

Nexys4 (non-ddr) builds successfully though. About a year back these two files (nexys4.vhdl and nexys4ddr.vhdl) were identical so I just copied nexys4.vhdl over nexys4ddr.vhdl and changed the line 390 to "target => nexys4ddr".

Looks like LCD panel output (for pmod?) is not present in nexys4.vhdl so that was lost in the process. It used some of the changed clock lines and I didn't know how to fix this.

Either way, I can't test lcd panel output since I don't have that pmod. Ideally nexys4ddr.vhdl should be updated, and the LCD panel part merged back into nexys4.vhdl?

**3) more build errors for nexys4ddr.mcs:**

vivado/nexys4ddr_gen.tcl seems out of date, and nexys4_gen.tcl seemed more up to date so I merged over what made sense.

I've uploaded my fixes here: https://github.com/vvrbanc/mega65-core/tree/vv005 . I advise reviewing the changes before merging, I have no idea what I'm doing :) FWIW it compiles and runs.
commit is here: https://github.com/vvrbanc/mega65-core/commit/60bf44d5050aba12d361eace8a5049d1615ed23b

gardners, 2020-07-14:
For (1), monitor_load.c should just be taken out of this repo, as it has been subsumed by m65.c in the github.com/mega65/mega65-tools repo.

For (2) and (3), we currently only support the nexys4ddr-widget target for the Nexys4 boards.  We should probably just retire the nexys4ddr target.  But I have no objection to it being resurrected, either, if you have it working again.

vvrbanc, 2020-07-14:
Thanks, I didn't realize.

I think it is better to retire nexys4ddr non-widget target.

I suppose all that needs to be done then is replacing nexys4ddr with nexys4ddr-widget in Makefile, as well as removing monitor_load files and Makefile target.

Closed 2020-07-14.

Thread 256 (2020-07-14):

Not possible to enter Configure, when using microSD card

adtbm, 2020-07-14:
when trying to access the MEGA65 configure menu during startup, with a microSD card inserted, MEGA65 only brings black screen.
Using the same card in the internal SD card slot, entering Configure works.

gardners, 2020-07-16:
The problem here is that the configuration menu is launched BEFORE Hyppo probes the SD cards, so we don't know
on which SD bus to look for the config sector.

We could make the configure programme probe the busses first.

Longer term, it makes sense to preferentially read/write config sector to NVRAM, on those models that have it.  But SD card should still be a fall-back.

lydon42, 2022-10-02:
int/ext SD card switching does work with recent cores. It could still be enhanced, I think, but the bug mentioned here can't be reproduced anymore.

Closed 2022-10-02.

Thread 267 (2020-08-06):

VIC-IV: SPRPTRBNK reset when legacy registers are touched

hernandp, 2020-08-06:
When registers considered as "legacy" are touched and HOTREG is enabled,  sprite pointer address registers (SPRPTRADR) are modified accordingly, but  SPRPTRBANK (0..6 bits of $D06E) does not seem to be set. This is correct? Do we need to reset it to zero?

https://github.com/MEGA65/mega65-core/blob/b728aa8ea375f39449b8cccf3e12e9413227ada3/src/vhdl/viciv.vhdl#L1482

gardners, 2020-08-06:
To be tested when synthesis runs, then can move to staging.

gardners, 2020-09-11:
Related to this, the banks are being set incorrectly, as VIC-IV looks at writes to $DD00, but not the DDR register at $DD02 when picking the VIC-II bank.  It needs to get the cooked pin voltages instead.

lydon42, 2022-01-05:
This seems to be somewhat inconsistent with the handling auf CHARPTR in #368:
Here the MSB is *not* reset to allow for use of high memory area in legacy software.

Closed 2022-10-02.

Thread 269 (2020-08-07):

inconsistencies across branches, -> please merge 138-* into master

Ben-401, 2020-08-07:
There are numerous differences between the two main/active branches, namely:
- master/stable_base, and
- 138-hdmi-audio-27mhz
These differences include change of filenames, obvious code, tool chain, etc.

Can we please resolve these consistencies by merging the two branches above??

Ben-401, 2020-08-07:
current problem with 138-hdmi-audio-27mhz is that it does not build 'out-of-the-box'.
These building issues have been resolved in master.

current problem with master/stable_base is that it does not support the new features that is being actively developed in 138-*

Can we please all get onto the same page? so that we can have the best of both worlds?

gardners, 2020-08-07:
the 138 branch implemented a number of important changes to clocking and hdmi output etc, that are required.

What is required to merge the branches is to identify what regressions the 138 branch has compared to stable_base, and fix those, so that we can advance stable_base to the head of the 138 branch.

That is, getting the test framework up and running is the key to advancing stable_base.

lydon42, 2022-01-05:
Current pre relase development has everything from 138-hdmi-audio-27mhz, as a compare shows.

Closed 2022-01-05.

Thread 280 (2020-08-21):

HyperRAM: 16-bit write/read not stable

sy2002, 2020-08-21:
Start at address 0x00333333 and fill 1MB of data with 16-bit values starting from 0x0000 and then count them up by one at every address, so:

```
Address    ==> Value
0x00333333 ==> 0x0000
0x00333331 ==> 0x0001
0x00333332 ==> 0x0002
[...]
0x00343332 ==> 0xFFFF
0x00343333 ==> 0x000
[...]
```

After filling 1MB like this, the code starts to read everything back. If something goes wrong, then the address where this happens, the actual value and the expected value is printed.

### STEP 1: Run from a freshly programmed FPGA (means: HRAM driver and wrapper fresh)

The very first 255 words of the 16-bit part work. But then word number 256 and 257 have a problem. And from there on, every 256 words of the 16-bit part has errors:

```
16-bit linear test: Fill 1MB from 0x0333333 with 16-bit values, then test:
16-bit linear test: FAILED
Read Errors: 0x0198 (decimal: 408)
Address   Actual  Expected
00333433: 0000    0100
00333434: 0001    0101
00333533: 0100    0200
00333534: 0101    0201
00333633: 0200    0300
00333634: 0201    0301
00333733: 0300    0400
00333734: 0301    0401
00333833: 0400    0500
00333834: 0401    0501
00333933: 0500    0600
00333934: 0501    0601
00333A33: 0600    0700
00333A34: 0601    0701
00333B33: 0700    0800
00333B34: 0701    0801
00333C33: 0800    0900
00333C34: 0801    0901
00333D33: 0900    0A00
00333D34: 0901    0A01
00333E33: 0A00    0B00
00333E34: 0A01    0B01
[ ... output shortened, but the pattern continues every 256 bytes ...]
0033FC33: C800    C900
0033FC34: C801    C901
0033FD33: C900    CA00
0033FD34: C901    CA01
0033FE33: CA00    CB00
0033FE34: CA01    CB01
0033FF33: CB00    CC00
0033FF34: CB01    CC01
```

### STEP 2: Run the program again (without re-programming the FPGA)

Similar result, but there are two more errors (410 errors instead of 408) and those two additional errors are at the very beginning.

```
16-bit linear test: Fill 1MB from 0x0333333 with 16-bit values, then test:
16-bit linear test: FAILED
Read Errors: 0x019A (decimal: 410)
Address   Actual  Expected
00333333: CC00    0000
00333334: CC01    0001
00333433: 0000    0100
00333434: 0001    0101
00333533: 0100    0200
00333534: 0101    0201
00333633: 0200    0300
00333634: 0201    0301
00333733: 0300    0400
00333734: 0301    0401
00333833: 0400    0500
00333834: 0401    0501
[ ... output shortened, but the pattern continues every 256 bytes ...]
0033FE33: CA00    CB00
0033FE34: CA01    CB01
0033FF33: CB00    CC00
0033FF34: CB01    CC01
```

sy2002, 2020-09-05:
Unfortunatelly, this did not fix it:

I tested it and the results are exactly the same as the ones described above in https://github.com/MEGA65/mega65-core/issues/280#issue-683859002

Even the behaviour "newly configured FPGA" (step 1) vs. "running the test twice" (step 2).

gardners, 2020-09-05:
Hmm.. It is quite strange that it is behaving exactly the same after the fix.
You did grab the hyperram source files from the head of 138-hdmi-audio-27mhz, not a different branch, right?

sy2002, 2020-09-05:
Yes, I did. I even did a file compare and synthesized twice, because I also at first thought that I made a mistake.

sy2002, 2020-09-05:
You are right, it seems I mixed up the 138-hdmi-audio-27mhz branch with the 138-hdmi-audio branch (without the 27mhz at the end):

I have tested the wrong file.

Retesting now.

sy2002, 2020-09-05:
OK did double check now, with the 100% correct file.

Problem is still here as described in https://github.com/MEGA65/mega65-core/issues/280#issue-683859002

(I always had the right file, already in my initial test, ignore my last mail - sorry for the confusion)

sy2002, 2020-09-26:
## There is Progress:

Using the newest file
```
wget https://raw.githubusercontent.com/MEGA65/mega65-core/138-hdmi-audio-27mhz/src/vhdl/hyperram.vhdl
```
which does nothing else differently than setting this signal to zero:
```
  signal block_read_enable : std_logic := '0'; -- disable 32 byte read block fetching
```
leads to the following result:

### Run 1: Freshly configured FPGA

Freshly configured FPGA means: I am programming a "cold started" FPGA with a fresh bitstream and then load my test program:

**The linear write/read test works like a charm!** 👍

### Run 2 .. n: Running the test program again and again

"Again and again" means: Re-running the test program again and again after the successful run 1.  The 1MB write/read-back works mostly fine, but the very first two writes/reads are failing:

```
8-bit test: PASSED

16-bit linear test: Fill 1MB from 0x0333333 with 16-bit values, then test:
16-bit linear test: FAILED
Read Errors: 0002
Address   Actual  Expected
00333333: CC00    0000
00333334: CC01    0001
```

gardners, 2020-09-26:
How small a fill can you do, where repeating it still stuffs up? I am keen to reduce this to the absolute minimum case.

gardners, 2020-09-26:
Meanwhile, maybe try disabling all of the other cache things, and see if that works, and then we can reenable each in turn.  Send me the repository link again together with the test procedure you are using, and maybe I can try doing that from here.

sy2002, 2020-09-26:
OK - I will try the disabling of the other cache things and prepare the testbed, so that you can use it for example to attach Xilinx ILA / Chipscope. I will try to contact you on Skype later.

sy2002, 2020-09-26:
@gardners about this question:

> How small a fill can you do, where repeating it still stuffs up? I am keen to reduce this to the absolute minimum case.

I did the experiments and here is the result:

I can only reproduce it, when a wrap around happens on the high word:

* I am starting at 0x0333333 (which means 0x0666666, because in 16bit mode I am multiplying the address by 2, before handing it over to your controller)
* When the high word wraps around from 0x33 to 0x34, then the problem happens. That means after 0xCCCD (52429 decimal) words written. In contrast to the 1 MB test, this is a much smaller number :-)
* I assume the number 52429 has no meaning. But the fact that the high word wraps from 0x33 to 0x34 (meaning from 0x66 to 68) might mean something to you?

So for summing up: My original test ran from 0x333333 to 0x433333, which equals 1 MB. My new test runs from 0x333333 to 0x340000 which equals 52429.

About your second question: Yes, you can play around with it by yourself. I created a new branch in the QNICE repository called `dev-hram`. You can synthesize using `hw/xilinx/MEGA65/Vivado` - but I assume I need to give you some mini introduction, before you might be able to attach ILA / Chipscope to it. I will contact you on Skype.

sy2002, 2020-09-26:
I found out some more interessting stuff:

* As described above: When doing 1 MB from 0x333333 to 0x433333, then in the first run it works, in subsequent it does not and I do get **two errors**.

* When going from 0x333333 to 0x340000, which is only 52429 words, then the behavior is identically to the 1 MB case: **two errors**, but only on subsequent runs. In the first run it works.

* Now, fasten your seatbelt: But when I go from 0x33E000 to 0x340010, then **it already fails at the first run** and I do get **31 errors** already on the first run. Here they are

```
16-bit linear test: FAILED
Read Errors: 001F
Address   Actual  Expected
0033E100: 0000    0100
0033E200: 0100    0200
0033E300: 0200    0300
0033E400: 0300    0400
0033E500: 0400    0500
0033E600: 0500    0600
0033E700: 0600    0700
0033E800: 0700    0800
0033E900: 0800    0900
0033EA00: 0900    0A00
0033EB00: 0A00    0B00
0033EC00: 0B00    0C00
0033ED00: 0C00    0D00
0033EE00: 0D00    0E00
0033EF00: 0E00    0F00
0033F000: 0F00    1000
0033F100: 1000    1100
0033F200: 1100    1200
0033F300: 1200    1300
0033F400: 1300    1400
0033F500: 1400    1500
0033F600: 1500    1600
0033F700: 1600    1700
0033F800: 1700    1800
0033F900: 1800    1900
0033FA00: 1900    1A00
0033FB00: 1A00    1B00
0033FC00: 1B00    1C00
0033FD00: 1C00    1D00
0033FE00: 1D00    1E00
0033FF00: 1E00    1F00
```

All these tests were performed with the latest `hyperram.vhdl`. It did not yet deactivate any more cache flags.

sy2002, 2020-09-26:
Update on my last comment: As written there, with the address range 0x33E000 to 0x340010 I am getting 31 errors on a freshly programmed FPGA. What I forget to mention is: If I then re-run the test program, I get 32 errors. Everything identical to my last comment but one more at the very first address:

```
0033E000: 1F00    0000
```

sy2002, 2020-10-03:
Tested the newest `hyperram.vhd`.
The error pattern is identical to the one described in https://github.com/MEGA65/mega65-core/issues/280#issuecomment-699504233

lydon42, 2024-08-17:
@sy2002 @gardners graveyard shift here... shouldn't this be fixed by the new HyperRAM stuff? This is a 4 year old issue...

gardners, 2024-08-17:
@lydon42 I recommend closing it as done, and if someone sees a problem with it in future, then we create a new issue based on what they encounter

Closed 2024-08-17.

Thread 284 (2020-09-12):

AUDIO processing : Add a BBD effect section in the audio processing

jmorel33, 2020-09-12:
This was raised on September 10th 2020 in the MEGA65 youtube channel in the comments aof a video ( https://www.youtube.com/watch?v=NJbSPwVOPhE ), that it would be interesting for developers and sound designers to have the option to use a Reverb / Delay / Chorus for in game effects.  This thread got some traction with many people liking the proposal.

The thought was to include in the audio mixer, a possibility to route the audio of one or multiple channels into an effects chain, or effects module (DSP type processing) to allow a digital form of BBD (Bucket Brigade Delay) type of sound processing.

We asked what would be the basic levers that would be necessary in order to satisfy some of the common requirements of a BBD.  First we need to understand how a BBD works.  For this we could refer to the following thread on Wikipedia.  https://en.wikipedia.org/wiki/Bucket-brigade_device

What was suggested was to allow the following dials to be accessible (via peek/poke memory addresses)
- Delay time (length)
- Delay feedback decay time
- LFO pitch depth (this is a free running LFO)
- LFO rate
- Low Pass filter frequency (this affects the feedback loop) (more fancy would be to have low pass, band pass and high pass with Q factor)

We did not mention if there would be a need for a stereo  model or multiple instances of a BBD, but to at least have one instance would greatly enhance the capabilities vs having no effects at all.  This is why I would suggest to dig deep into this possibility as it may not be out of reach to simply add a sampling algorithm and feedback loop with a filter, and then maybe on a stage two,, add an LFO on the pitch.  The end results will a variety of Reverbs, Delays and Chorus effects, and even possibly phasing.  All of which are the basic effects you can find in the professional music domain for all to enjoy.

NOTE ON MYSELF:  I am a huge fan of the SID chip and the commodore 64.  Also a huge fan of 8-bit and 16-bit computer as a whole, and have been since my first home computer way back in 1985.  I am also a musician (m4ntr0n1c).  You can view my EQUIPBOARD here https://equipboard.com/m4ntr0n1c

gardners, 2020-09-12:
I'm quite happy to consider this, but someone will need to supply a VHDL BBD model that we can look to incorporate. Ideally it would not use any BRAM, as on A100T targets we have none left. Using some distributed RAM is fine, as is using a reasonable number of DSP48 blocks.

jmorel33, 2020-09-13:
So far this is what I found, whcih is a model of the most common BBD chip;
https://www.electrosmash.com/mn3007-bucket-brigade-devices

jmorel33, 2020-09-17:
I haven't found a Bucket Brigade source code... BUT.... Everything else, ,and it is source code which comes from a book, but all available on github https://github.com/juandagilc/Audio-Effects

Thread 285 (2020-09-12):

HYPPO: please consider adding some query interface (maybe using some trap?)

lgblgblgb, 2020-09-12:
In some cases it would be useful if a user program (let it be some "system level" stuff - like a test utility etc - more, than an average - let's say - game, etc) to be able to query some information Hyppo has already, just it's not easy to access (as far as I know, correct me, if I'm wrong). What I can mention:

* current bitstream version as string (or later, as kind of numeric value **too**?). _As hickup displays version string on reset, it surely knows it but AFAIK it's not possible easily a userpace program to "extract" it_
* SD-card detected max sector number (per SD bus?). _For some programs, want to do direct SD I/O (yes, even if it's not so much advertised to use in the future, some time it is still useful at least after some trap which allows in the future to turn on userspace usability of SD I/O at least)_

I'm not sure on the second how useful it is, but surely, it would be handy to do, as FDISK would not need to do its own.

**What we have already (AFAIK):**

* hardware information: by reading port $D629
* HDOS version number (using a trap)

gardners, 2020-09-13:
Raw SD access will only be allowed after asking hyppo for permission.  Not yet enforced. Then it is up to programmes that do this to size the card themselves, as else we use up precious hyppo code space.

gardners, 2020-09-13:
The bitstream identifier would, however, be good to make available, even if the whole idea is that eventually it won't be necessary.

lgblgblgb, 2020-09-13:
I'm thinking that even currently available information (like bitstream version string, etc etc) should be kept within a single block of memory inside of HYPPO. And just adding a simple trap function which copies that block to "user memory" on request. However for sure the structure of that range should be kept the same (maybe appending something if needed but then caller program must aware which version the "info block" has, and how much space it needs). I think, this way, the memory usage in hypervisor memory is minimal, as there are no separate functions of query things etc, just a simple single "copy the info block for me, as-is" kind of call. That wouldn't require more than "few bytes" (ok, this is a bit too much to say, but anyway ...) to implement. The rest of the decoding logic of that information is deferred to the user program want to query this kind of information.

gardners, 2020-09-13:
Bitstream ID can just be in registers. It's easier and safer that way, and doesn't need a hyper-trap to read it that way.  We already have that for the keyboard CPLD version.

lgblgblgb, 2020-09-13:
It was just an example for a broader term of all available information hyppo knows either by "hardwired" (eg textual name of the firmware with git short commit id, or what it is ...) or detected things maybe on power-on. Honestly my idea came to my mind that I'm writing a "mega65 information" utility and I would also like to display that same text for the "firmware" (ie: bitstream) what hyppo also displays on reset. Surely, it's only a marginal need, but there can be so much information still, besides this "nuance". But if it sounds like a stupid idea, just forget it :)

gardners, 2020-09-15:
Itsa a nice idea to have this. You can also query the flash to get the stored information about the bitstream, and there are FPGA registers available that will tell you which slot you have loaded the bitstream from.
The commit ID from HYPPO is not trustable, though, as it comes from HYPPO, which can be changed via HICKUP.M65.

For the keyboard CPLD, you can query:

GS $D62A KBD:FWDATEL LSB of keyboard firmware date stamp (days since 1 Jan 2020)
GS $D62B KBD:FWDATEH MSB of keyboard firmware date stamp (days since 1 Jan 2020)
GS $D62C KBD:FWGIT0 LSB of keyboard firmware git commit
GS $D62D KBD:FWGIT0 2nd byte of keyboard firmware git commit
GS $D62E KBD:FWGIT0 3rd byte of keyboard firmware git commit
GS $D62F KBD:FWGIT0 MSB of keyboard firmware git commit

Ideally I would provide some similar registers for the main FPGA.

lgblgblgb, 2020-09-17:
Ok, thanks! And btw also HYPPO version is nice to know, what is trustable then at least if no other info it is from there :)

lydon42, 2023-03-30:
This seems like an ancient issue, closing.
Please create new issue with reference to this if still something should be added.

Closed 2023-03-30.

Thread 286 (2020-09-12):

Hyppo: Freeze menu breaks text mode display after switching to lowercase

steph72, 2020-09-12:
Steps to reproduce:

1) boot MEGA65 into C65 mode
2) press RESTORE to enter freeze menu
3) press "f3" to resume
4) type: PRINT CHR$(14) [ + RETURN ]

Result: "@" characters all over the screen (colours remain correct though)

Also works in C64 mode. Also works when entering lowercase with [MegaKey]+[ShiftKey]

gardners, 2020-09-13:
This is already fixed with all the $DD00 bank bit fixes in the head of 138-hdmi-audio-27mhz

lydon42, 2021-12-31:
Bug can not be triggered with above recipe in mastet@bbd0391 on r3.

Closed 2021-12-31.

Thread 289 (2020-09-20):

Sprite Y positions are off, depending on video standard and freezer usage

steph72, 2020-09-20:
While experimenting with some old games in C64 mode I discovered that sometimes sprite positions are shifted up and down.

I wrote a little test program in BASIC 2 in order to reproduce the issue:
[spostest.zip](https://github.com/MEGA65/mega65-core/files/5251366/spostest.zip)

Here are the reproducible findings so far:

1. Original PAL C64:
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

2. MEGA65, NTSC mode on powerup, directly booted into C64 mode with test disc image mounted as standard image:
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

3. MEGA65, PAL mode on powerup, directly booted into C64 mode with test disc image mounted as standard image:
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

4. MEGA65, PAL mode on powerup, directly booted into C64 mode with test disc image mounted as standard image, change to NTSC via freezer menu:
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

5. MEGA65, PAL mode on powerup, directly booted into C64 mode with test disc image mounted as standard image, change to NTSC via freezer menu, run test, change back to PAL via freezer, run test again:
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

In my original experiments, I encountered worse deviations, but so far I haven't been able to reproduce them.

gardners, 2020-09-20:
It looks like the NTSC sprite vertical positioning is out versus the character generator position.
In mega65-tools/src/tests there is also vicii.prg that can be built that tests various things.
Interestingly it doesn't pick up the problem you indicated, but does find another problem when I ran it in NTSC.

It would be a very good idea to expand on this, implementing the test you wrote, and attempt to document the problems, so that we can find and fix the root cause(s).

steph72, 2020-09-21:
> It would be a very good idea to expand on this, implementing the test you wrote, and attempt to document the problems, so that we can find and fix the root cause(s).

I'd love to do that (as soon as my jtag adapter arrives)

gardners, 2020-09-21:
Issue gladly assigned :)

Ben-401, 2020-09-21:
Hi, yes I confirm that my build also demonstrates collisions=255 when i mount and run the test program.
Can we add that program to the repo somewhere? is in repo:test-procedures a good spot?
And instead of checking in the binary, can we check in the source code for a basic program?

My build is BRANCH:138-hdmi-27, 20200826, 8A90709 (yes quite old i know).
Using VGA on N4ddr, all DIPs off.

steph72, 2020-09-21:
@gardners I just checked my machine (preseries r2 board, 138-hdmi-audio-27-mhz, 20200917.07) with the vicii test program from mega65-tools/src/tests

To my great surprise, the existing test actually detects the error with my board:

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

This behavior is reproducible by

- starting up in NTSC60 + C65 mode
- mounting test d81 image via freezer
- resuming via 'f3'
- issuing 'go64'
- LOADing + RUNning the test program

I have the feeling that the error in Y positioning gets more pronounced the more the freezer is being used.

This is a photo of my own test program after applying the same procedure:

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

Notice how all sprites are being placed way too low on the screen – in fact almost completely covering the lower 'test frames', except one single line? This almost certainly corresponds to the $32-$1c=$16 pixels difference your test program is reporting.

(Since the existing test program picks up the error alright, I'll refrain from adding my own – redundant – tests, unless you see any use in it...)

gardners, 2020-09-21:
The problem when switching PAL/NTSC in the freezer, is that it has to do some magic to do the switch, because the hotregs don't get triggered, because the flags are being changed in a frozen programme, not in a running one. Thus freezer.c modifies some VIC-IV registers, but clearly doesn't modify the sprite one.

See from about line 862 in freezer.c

I am putting a fix in there,

gardners, 2020-09-21:
Build new FREEZE.M65 from the referenced commit, and it will hopefully fix the problem.

steph72, 2020-09-23:
@gardners with the new FREEZE.M65, the $16px problem after using the freezer is gone

But there's still an 2px offset in Y position when starting up in NTSC mode (not using the freezer) and running the test program:

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

gardners, 2020-09-23:
Try putting different values in $FFD3072 to find the value that is correct. Let me know the correct value, and I'll bake it in.

steph72, 2020-09-23:
For my r2 board, its $18 in NTSC60 mode.

But once I've set $ffd3072 to $18 and then return to PAL mode via the freezer, there is a 1px error in the sprite's Y position which I can't correct no matter what value I put in $ffd3072 (the 1px gap is with a value of $00... it would need -$01 to correct for the 1px gap)

gardners, 2020-09-24:
ok, making a bitstream and updated freezer with $18 as the value.

Thread 303 (2020-10-16):

1351 mouse "stutters"/"jumps" in GEOS

adtbm, 2020-10-16:
We tested the 1351 in GEOS and compared to the MEGA65 CONFIGURE menu, the mouse "jumps" every couple of pixels a bit.
The Micromys has exactly the same problem.

The AMIGA mouse works fine (but keyboard input is not working when the mouse is plugged in)

I've tried to change to "1351 emulation" in CONFIGURE, but that doesn't help either.

bluewaysw, 2020-10-16:
GEOS currently overrrides MEGA65 CONFIGURE and forces the 1351 emulation mode, to prevent the keyboard being locked after startup. This happens if a 1350 is connected initially (an 1351 emu is off?). The keyboard was released then if the mouse is moved around, not sure if this was still the case in the latest bitstream. Forcing the emu mode for 1351 cause the keyboard to work properly but seems to break if a real 1351 is connected.

So the emu mode by GEOS is wrong, so we need a fix for the keyboard lock after startup if a 1350 is connected.

gardners, 2020-10-16:
Hello,

There is a way to disable the joystick port from being able to interfere with the keyboard.  Or at least I thought I there was. Trying to find it... Hmm, no, it would seem my memory is playing tricks on me. BUT what you can do in this case, if you suspect that the joystick is causing problems, you can disable the physical joystick ports via writing $00 to $D611 (writing $02 re-enables them). Note that this is a "write only" function, so don't try to set/clear the bits, instead just write the correct value.

I'd recommend that you just leave the mouse emulation as set by configure, to avoid user confusion.  Setting the 1351 emulation to "aggressive" should also greatly ease the problem.  The problem is if the mouse is resting in a position where the quadrature signals are plausible for a joystick. Or alternatively, add an option to your GEOS configure that allows toggling it.

lydon42, 2022-10-02:
#549 closing old issue, keeping the new.

Closed 2022-10-02.

Thread 304 (2020-10-23):

CPU Rework

gardners, 2020-10-23:
The current CPU memory interface is a bit of a mess because of the ISE to Vivado migration.
Basically ISE allowed asynchronous BRAM access via some magic, and the MEGA65 memory interface was built on this. However, Vivado refuses to do the same magic (probably quite sensibly, as it turns out).
The work around was to put some of the magic into the MEGA65's CPU, however this makes it really hard to manage memory accesses, as there is a two-stage process of presenting the data and latching it in two different places. The end result is that the code is a pain to maintain -- although we very much appreciate the work done to work around the Vivado problem.

But the time has come to fix this once and for all.

The best solution is to move the memory interface out into a separate VHDL file, which abstracts all this away, and uses the BRAM only in a synchronous manner.  This will increase memory access latency. So at the same time, we should increase the clock speed to the BRAM and use pipelining to meet timing closure.

If we add an instruction fetch mode, so that all bytes of an instruction are fetched at the same time, the average latency per instruction should actually drop, as well. Thus we will get more maintainable code, and very likely a reasonable boost to instruction throughput.

Current plan is to drive the BRAM at 8x CPU clock speed, i.e., at 324MHz for 324MB/sec maximum throughput.  By adding an "instruction fetch" flag to the interface, we can make it very quickly fetch whole instructions, and will probably even end up having some little instruction fetch buffer as well, that will mean that the latency per instruction will be encountered only following branches.  If we have a backward-branch instruction fetch buffer, we can probably avoid that latency for tight loops, as well.

This will also make it much easier to interface to the HyperRAM, as we can remove some of the finicky latency-reducing symetry breaks in that interface.

In the end, we will also update the DMA controller to use the fast fetching mechanism, to allow much faster DMAs within the fast RAM.

Finally, all the pipelining will make it possible to have >384KB fast/chip RAM on the MEGA65 R1 and R3 boards that have the A200T FPGA. In theory, we could have about 1MB of fast/chip RAM on those FPGAs.  But with the old design, its not possible to get timing closure to a big BRAM that uses all the little BRAMs, because the physical distances on the chip die are too great.

Current plan is to have 8x 324MHz clocks of latency on data fed to the BRAMs, and the same on the read side. This means two 40MHz ticks on the round trip.

As mentioned, for instruction fetch, we can largely hide this.  For data writes, the write can be scheduled asynchronously.  For data reads, we will now have higher latency than before, by two cycles. However, because the instructions will fetch in 1 cycle typically, the 1+2=3 cycle latency for random reads will still mean we can do an absolute mode read in 4 cycles -- the same as the 6502, and 1 cycle faster than the MEGA65 can do now.  Writes will happen in 1 cycle, however, providing a very significant speed-up.  If we implement the ZP cache, then the ZP indirect modes will be able to do a ZP vector fetch in 3 cycles, the same as now, or possibly even a bit faster, since we can clock the ZP cache at 2x or 4x CPU clock to allow fetching multiple bytes in a single CPU cycle.  This will especially help the 32-bit ZP pointer modes, as their vector fetch time will drop from 5 cycles to probably 2 or 3 cycles.

brouhaha, 2020-10-24:
I wasn't aware that ISE had any magic to make BRAMs look asynchronous, but in both Vivado and ISE I have long done that by clicking the BRAM on the falling clock edge, vs rising edge for all the logic. The usual BRAM setup and hold times still apply, but relative to the falling edge. The static timing analyzer knows how to handle that.

I'm _not_ recommending that you change your plans.

gardners, 2020-10-25:
Hi Eric,
Yes, this all came about because ISE happily synthesised with an async description of the BRAMs in my VHDL, but Vivado refused to do so.  Interesting re clocking on falling edge. I had at some point thought about doing that, but didn't know enough about how it all works to be confident it would be a better solution.

Hopefully I can get the latencies and pipelining under control enough that maximum CPU speed is not worse than at present with my rework. If I can do that, then I won't need to change plans. But if that proves to not be possible, then clocking on falling edge might be a good alternative.

In any case, thanks for the interesting feedback.

Paul.

lydon42, 2024-08-17:
@gardners the cpurework branch seems not to be merged, is this something we can throw away, as it is too old now?

gardners, 2024-08-17:
It can be closed, but don't discard the branch, in case I ever decide to get around to finishing this job @lydon42 .

Closed 2024-08-17.

Thread 307 (2020-11-27):

internal discdrive on DevKit release bitstream not working

adtbm, 2020-11-27:
It's not possible to load something from internal drive.
If you switch in CONFIGURE to internal drive it still loads the content of the SDcard
If you switch in FREEZER to internal drive it starts loading, but fails.  blinking Drive LED or ?FILE NOT FOUND ERROR.

gardners, 2020-12-01:
Problem is caused by ROM DOS toggling bit 2, which changes the selected drive, and the logic comparing with the previously selected drive, instead of the currently selected drive.

lydon42, 2022-01-04:
This is now working with pre release rom and devel bitstream.

Closed 2022-10-02.

Thread 308 (2020-11-28):

$D068-$D06A not being reset by hot registers

FeralChild64, 2020-11-28:
Execute the following code from C64 mode:

```
	; unhide VIC-IV

	lda #$47
	sta $D02F
	lda #$53
	sta $D02F

	; change chargen location

	lda #$01
	sta $D06A ; chargen pointer MSB

	; restore original chargen location by using VIC-II hot register

	lda #$04
	sta $D018
	lda #$14
	sta $D018
```

Result: on the DevKit we get a blank screen (character set is taken from empty C65 RAM - wrong), on XEMU after this piece of code is executed, a normal screen is displayed (expected behaviour). It seems to me that on the DevKit any change to $D068-$D06A result in a state that cannot be reverted to the original VIC-II behaviour any more (wrong).

gardners, 2020-11-28:
This is a feature, not a bug.  $DD00 banks DO get applied, however.

From the VHDL:

```
      -- Apply VIC-II banks
      screen_ram_base(15 downto 14) <= not last_dd00_bits;
      vicii_sprite_pointer_address(15 downto 14) <= not last_dd00_bits;
      character_set_address(15 downto 14) <= not last_dd00_bits;

      -- All VIC-II/VIC-III compatibility modes use the first part of the
      -- colour RAM.
      colour_ram_base <= (others => '0');

      -- NOTE: We DONT reset the character set address with a legacy write.
      -- This makes it easier to use alternate character sets, and full-colour
      -- text mode upgrading of old programmes.
```

If you think we SHOULD do it, we can change that. But given that there is very little software that could possibly expect it right now, I'm uninclined to change it.

FeralChild64, 2020-11-28:
Well, actually Open ROMs (the build which is a part of core flashed on the DevKit) expects this, otherwise it's "GO 64" command won't work.

My use case is: I've set the $D068-$D06A to do what I wanted to (in my case it was Open ROMs, but if someone decides to use these registers from within his newly written file browser, he will end up with exactly the same problem), now I want to launch a legacy program. How do I revert all the effects of my writes to $D068-$D06A?

gardners, 2020-11-28:
The easy remedy is to write $001000 back into those registers before launching the legacy programme, or does that leave problems for you?

FeralChild64, 2020-11-29:
Seems to work - but I haven't tested moving charset to another location using VIC-II/CIA in C64 mode yet.

Closed 2022-01-01.

Thread 309 (2020-11-28):

CROM9 bit of VIC control register A not working

FeralChild64, 2020-11-28:
C65 ROM contains 2 character sets - one ant offset $D000 (original C64 character set), and a second one at offset $9000 (the C128 character set). It is possible to switch to C128 character set by setting bit 6 of VIC-III register $D030. This does not work on MEGA65 DevKit. Easiest way to reproduce problem:

- prepare special MEGA65.ROM - wipe character generator at $9000-$9FFF offsets
- most likely after starting the system with working CROM9 bit you should see a blank screen (I suppose the C65 ROM selects $9000 charset for C65 mode); if not, go to C64 mode, and type:

POKE 53295, 71 : POKE 53295, 73 : POKE 53296, 64

now you definitely should see a blank screen (but on MEGA65 DevKit there is no change in the display - wrong).

BTW. It seems that XEMU does not implement this bit either, and Open ROMs currently uses $9000-$9FFF area for other purposes - I'll have to fix this.

gardners, 2020-11-28:
MEGA65 currently doesn't implement this bit. We might in the future, but its not currently a priority.
Even if we do, it will only be on T200-based MEGA65 targets, as it requires an extra 4KB BRAM to have the doubled character ROM.

dansanderson, 2023-08-13:
We recently confirmed that CROM9 is not implemented in the C65 prototype. I'm removing erroneous prose descriptions of CROM9 from the MEGA65 documentation to avoid confusion. We'll have to decide how to interpret historical artifacts for intended behavior, and how to prioritize implementing a feature that is not needed for historical compatibility and is not practical for modern programs. (CROM9 is not used by the BASIC FONT command to switch fonts. Font switching is a MEGA65 addition and works by copying charsets from the ROM to MEGA65 character memory.)

lydon42, 2024-08-17:
@dansanderson should I add (not implemented) to D030.6 description?

gardners, 2024-08-17:
I believe marking it not implemented is the right approach, and then closing it.

Closed 2024-08-17.

Thread 311 (2020-11-29):

DevKit: SPRPTR16 not working correctly

steph72, 2020-11-29:
In yaped32 (my 32 colour petscii editor) I use SPRPTR16 to put sprites in the $00fxxx memory range. This worked fine on my R2 prototype M65. When I got my DevKit I noticed that sprites are no longer displayed correctly.

I wrote a little test program (attached to this issue) to demonstrate the problem.

On the M65 prototype, the (correct) output looks like this:
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

whereas on the DevKit, only one line of the sprite is displayed:
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

Here is the BASIC 10 test program to reproduce the issue:
[spritetest.zip](https://github.com/MEGA65/mega65-core/files/5612003/spritetest.zip)

gardners, 2020-11-30:
There is indeed something weird going on here.
The first row of the sprites comes from $F000, as expected.
But the subsequent rows are coming from $C000.
So the fetch address is getting borked somewhere.

The issue is an in-progress fix for latching sprite data source area, like VIC-II does, or continuously monitoring the sprite pointer to allow different sprite data to be selected every row, like we previously implemented on the VIC-IV, but which is not actually correct.

To select the correct VIC-II behaviour, which also works around this bug: Clear bit 3 of $D07A.

But I still need to find out the root cause and fix it.

gardners, 2020-11-30:
Probably needs simulation and grinding through the VHDL log messages to see where the sprite fetches all happen from.

What we know is that at the start of the sprite, when sprite data offset = 0, that it is right. But then for subsequent rows, its like the sprite pointer has $0000 in it, instead of the correct value.

More investigation: For subsequent rows it has rubbish in there, because it seems that the sprite_data_addresses() array doesn't get updated sometimes for some reason.

As said, this all needs more debugging.

steph72, 2020-11-30:
I tried the workaround with clearing bit 3 in $d07a. The good news: Sprites are being displayed now; the bad news: The first line is corrupted. The strange thing is that the corruption changes with the position of the sprite... I've attached a little clip, maybe it helps you narrow down the overall problem...

https://streamable.com/5dtndy

(yaped32 has two cursors as sprites: one is the mouse pointer and the other is the current character position)

gardners, 2020-12-18:
I think I have found the cause of this problem now. Will hopefully synthesise a fix for it soon.

lydon42, 2022-01-07:
Can't reproduce this on r3a board and pre release development / rom.

@steph72 could you please recheck and close this issue if it is resolved?

Closed 2024-08-17.

Thread 313 (2020-11-30):

MEGA65 Configuration

umueller-wsw, 2020-11-30:
There are still problems in the configuration menu. In my opinion the time is not read correctly from the RTC. After 11:59.00 comes 32:00.01 ? After 23:59.59 comes 24:00.01 ?

Once the menu has been saved you can no longer access the device. Only after switching it off and on again everything works again. Maybe Paul has a good idea again.

lydon42, 2022-09-25:
Antique issue

Closed 2022-09-25.

Thread 319 (2020-12-13):

DMAs can't cross bank boundaries, but should

gardners, 2020-12-13:
(note that they should not cross MB boundaries, though)

lgblgblgb, 2020-12-14:
Just to have my comment here as well, not just on discord, as far as I remember, Paul told me once, that this is by design, and c65's DMA should behave this way (as on c65 only the lower 16 bits are inc/dec'ed ...). I see a potential incompatibility if this "bug" wanted to be fixed. so then there should be some compatibility flag with c65 (or MEGA65 enhanced DMA option?) to select between behaviours. Though I am not really sure if any existing C65 programs exploited this feature, however I feel a bit uncertain if at more and more points we break C65 compatibility unconditionally in the name of "but this is more logical and easy to use" (which is indeed true, don't get me wrong!). So for me, it's not so much a bug, but instead a feature request. However it's also true, that I am not aware of any tests done on a real C65, if it's really a case there ...

gardners, 2020-12-14:
Hmm..., yes, could be true.  I guess the question is whether there is any C65 code that assumes the C65 behaviour. My gut feeling is probably not.

lgblgblgb, 2020-12-14:
well, not to troll here, but I feel, while you're absolutely right, virtually about everything, we can say "no code assumes that" since not so much C65 software _at all_ exist. But it has some danger to really call MEGA65 as a C65 compatible computer after a while. Especially if some (real) c65 owner starts to dig in into MEGA65 with the hope that their real C65 can get much love and additional software this way, then "strict(er) c65 compatibility subset" of MEGA65 can be an important factor in the future even if it's not the case _right now_. Again, it's just my personal fear with this whole topic to remain c65 compatible. For example as far as I know, Snoopy on forum64 is kinda keen to write/have C65 titles and more interested in the C65 side "only" of MEGA65. Again again ;) as far as I feel about this situation ... Feel free to ignore my stupid comments, though, I have not so much a big problem with this change otherwise ...

gardners, 2020-12-14:
I hear you, and I agree generally.  That said, there will already be other compatibility problems to real C65s (and they have compatibility problems with each other). Indeed, there are at least 2 incompatible versions of the DMA controller in the field. So on this particular one, I think the risk is acceptable.

Closed 2024-08-18.

Thread 321 (2020-12-18):

DMA texture issue on Nexys 4

headkaze, 2020-12-18:
Exhibited whilst running the MEGAMAZE demo. Screenshots attached show expected vs Nexys 4 rendering.
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

headkaze, 2020-12-19:
Looking at the source we can see the following #define for the location of the textures:
`#define TEXTURE_ADDRESS 0x8000000L`
Which according to iomap.txt refers to
`GS $8000000 - $FEFFFFF Slow Device memory (127MB)`
Which is the expanded memory or PSRAM on the Nexys 4.

Please refer to https://github.com/MEGA65/mega65-core/issues/324

gardners, 2020-12-20:
Yes, so it looks like it is using the expansion RAM for the textures.

lydon42, 2022-10-02:
There is no attic RAM support on the Nexys4. A possible solution is to either support the DRAM on the nexys4ddr / A7, or to allow the use of PMOD hyperram. This is something that could be done, but the focus currently is on the mega65r3 boards.

And already is covered in issue #324, so closing this one.

Closed 2022-10-02.

Thread 322 (2020-12-18):

Erasing flash slots not working on Nexys 4

headkaze, 2020-12-18:
Launching slot 0 works with the latest **138-hdmi-audio-27mhz** branch but erasing a slot or flashing a bitfile to a slot is failing (see attached screenshot).

Also the nexys4.xdc and nexys4ddr.xdc files need ConfigRate changed from 66MHz to 26MHz so flashing to QSPI from Vivado works without CRC errors.

`set_property BITSTREAM.CONFIG.CONFIGRATE 26 [current_design]`

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

lydon42, 2022-01-03:
Duplicate #348 ?
nexys4.xdc and nexys4ddr-widget.xdc both have the 26MHz setting. Note that nexys4ddr target is obsolete, please use the -widget variant.

Can you please test with a recent (today) development core?

lydon42, 2022-10-02:
#522

Closed 2022-10-02.

Thread 332 (2020-12-30):

Transparency Issues with 16 color sprites

smnjameson, 2020-12-30:
Reduced a bug I was seeing down to the following reproducable test. As you can see overlapping sprites in 16 color mode (16bit pointers, Color 0 set as transparent) seem to have issues:

https://user-images.githubusercontent.com/4640763/103364107-cf743400-4ab4-11eb-8c7d-3e6b80a93d1c.mp4

Tet prg here:
[SpriteTest.zip](https://github.com/MEGA65/mega65-core/files/5754725/SpriteTest.zip)

gardners, 2020-12-31:
Most curious. Are you able to quantify more exactly what is happening?  It looks like pixels to the left of the overlap are ending up black (or maybe some other colour).  Maybe if you can make a programme that shows the problem statically (maybe hit space to toggle the problem-causing-overlap), then I can dig into it a bit more easily.

smnjameson, 2020-12-31:
It seems to be that in an overlapped area, the sprite underneath takes the left most column of pixels in the underlying area and repeats them for each column in the overlap, in this case showing black for transparency was in the left most column. The following update to the test will move the sprite to the same position when you press fire:

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

[SpriteTest.zip](https://github.com/MEGA65/mega65-core/files/5757675/SpriteTest.zip)

gardners, 2021-01-09:
Seems to fix it for me. Please confirm in latest bitstream, then mark STAGED.
Test programme for exercising this issue is in github.com/mega65/mega65-tools /src/tests/test_332.c

gardners, 2021-01-10:
Test written in mega65-tests src/tests/test_332.c

lydon42, 2021-12-31:
Checked with stable bitstream on r3 hardware, all looks good!

lydon42, 2022-07-31:
Correct: 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
Wrong: 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
(wrong example made with mega65r3-20201226.18-138-hd-7534ac3.bit)

Closed 2021-12-31.

Thread 339 (2021-01-17):

When enabling 16 sprite pointers, the low byte of the sprite data address is ignored

M3wP, 2021-01-17:
When enabling 16 bit sprite pointers with $D06E, the low byte address of the pointer is not used in the calculation to determine the location of sprite data in memory.

hernandp, 2021-03-12:
Guys, is there any workaround for this ? Thanks.

hernandp, 2021-03-20:
There is any workaround for this? Thanks.

hernandp, 2021-04-26:
@rdpeake @gardners  SPRPTR16 test program.   Press any key to switch between 0x380 with 8-bit pointer table and 0xC000 using SPRPTR16.

[sprptr16.test.zip](https://github.com/MEGA65/mega65-core/files/6378894/sprptr16.test.zip)

gurcei, 2021-05-04:
I've done some inspection of the test and fiddled with the $D06C-$D06E values on the fly via m65dbg and shared some observations on this discord thread:
- https://discord.com/channels/719326990221574164/783728598313992262/839109186482733056

From what I've seen, it seems as though it is not so much that the LO-byte in $D06C is being ignored, but moreso the first 4 bits of it are being ignored.

gurcei, 2021-05-04:
Further inspection of `viciv.vhdl` within that Discord thread has led me to the following conclusions on the behaviour of sprptr16 location:

So from what I'm seeing here, this 16-byte boundary location for the sprptr home is 'by design'.

So if I were to document it, I'd say:
```
$D06C =
  - bits 0-3 ignored
  - bits 4-7 = SPRPTRADDR bits 4-7
$D06D =
  - bits 0-7 = SPRPTRADDR bits 8-15
$D06E =
  - bits 0-3 = SPRPTRADDR bits 16-19
  - bits 4-6 = ignored
  - bit 7 = SPRPTR16 enabled flag
```

So, from what I'm seeing, I think SPRPTRADDR can be positioned anywhere within the 1st megabyte (and not within the 1st 8MB of RAM, as currently described in the mega65-book)
These 8 sprite-pointers can then point to sprite-data within the 1st 4MB range (as correctly described in the docs).

M3wP, 2021-09-30:
Why was this issue closed?  The issue has NOTHING to do with the location of the sprite pointers but the use of the sprite pointer data at that address.  As far as I can tell, the original issue still persists.

Closed 2021-09-18.

Thread 341 (2021-01-17):

IEC communications is flaky

gardners, 2021-01-17:
Basically IEC communications fails quite often. We suspect that there is something fishy with the CPU timing at 1MHz.

See also #150 for a related problem, where badline emulation happening at the wrong time may be a contributor.

Attached are traces captured with a real C64 and the MEGA65 doing various IEC things, so that we can try to spot the difference.
[iec-trace-mega65-load-1541-and-sd2-iec.zip](https://github.com/MEGA65/mega65-core/files/5826914/iec-trace-mega65-load-1541-and-sd2-iec.zip)
[iec-trace-mega65-sd2-iec.zip](https://github.com/MEGA65/mega65-core/files/5826915/iec-trace-mega65-sd2-iec.zip)
[iec-trace-mega65-1541-load-and-sd2-iec-load.zip](https://github.com/MEGA65/mega65-core/files/5826916/iec-trace-mega65-1541-load-and-sd2-iec-load.zip)
[iec-trace-c64-1541-2-load.zip](https://github.com/MEGA65/mega65-core/files/5826917/iec-trace-c64-1541-2-load.zip)
[iec-trace-c64-load-8-and-sd2-iec-load-9.zip](https://github.com/MEGA65/mega65-core/files/5826918/iec-trace-c64-load-8-and-sd2-iec-load-9.zip)

gardners, 2021-01-17:
These can be viewed with pulseviewer on Linux

gardners, 2021-01-17:
I also need to conduct pulse tests from the MEGA65 with a precisely timed loop toggling the IEC lines, to see if the resulting frequency is correct.

adtbm, 2021-01-19:
> I also need to conduct pulse tests from the MEGA65 with a precisely timed loop toggling the IEC lines, to see if the resulting frequency is correct.

Is there a tool available ? Tomorrow Dieter will come to my house and we will repeat the measurements in the "non-working" condition.

gardners, 2021-01-20:
Not yet.
But let me see if I can cook something up quickly. It really will be very small and simple.

gardners, 2021-01-20:
Try this one.  Screen will go funny when it is running, but it should toggle all 3 lines on the IEC port with 50% duty cycle at about 70KHz.  Please log on real C64 and on a MEGA65. Do not have a disk drive connected for this test, as it is toggling the serial lines flat out, which might upset a connected device.

adtbm, 2021-01-21:
> Try this one.

??? what file/bitstream ?

gardners, 2021-01-21:
[iectoggle.zip](https://github.com/MEGA65/mega65-core/files/5846334/iectoggle.zip)
Sorry, it rejected the .PRG file. Here is the .ZIP which is several times bigger :/

adtbm, 2021-01-30:
Here are the data logger recordings for,
MEGA65 : runs constant
C64 : seems to crash:
[iectoggle.zip](https://github.com/MEGA65/mega65-core/files/5897213/iectoggle.zip)

C64 :
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

gardners, 2021-02-04:
That funny display is correct for C64 running iectoggle, as it crudly messes with the VIC-II banking as well, which is also on $DD00.

gardners, 2021-02-04:
iectoggle.prg does indeed toggle the line at ~70KHz on MEGA65.
There is jitter if the screen is on ($1B in $D011), which is expected, but not sure if it is correctly timed.
Will be interesting to try to load on MEGA65 with the screen disabled ($00 in $D011), to see if that helps the IEC, in which case, we have bad line bugs as the likely culprit.

gardners, 2021-02-04:
My 1581 seems to have died again, so testing with an old 1541.
Found a disk with "skate or die", and it seems to be loading fine: loader graphic screen appears correctly, music starts playing.
This is on R3 with bitstream:

```
build GIT: development,766,20210201.17,5ab8bc9
```

Which version of bitstream did you guys test with?

adtbm, 2021-02-08:
i am using this one at the moment
mega65r3-20210203.20-develo-06000a4.bit

should i expect changes with the IEC drives ?  then i'll start a test

gardners, 2021-02-08:
With the bitstream I indicated above, I couldn't cause the 1541 to fail to load anything.

gardners, 2021-02-08:
Now have the Pi1541 back up and running with a fresh 1970s era 7405 from my stock.
It's set to device 11 at the moment, and I can do:

```
10 OPEN15,11,15
20 GET #15,A$: ? A$;:GOTO 20
```

And that seems to work fine. But if I try `LOAD"$",11`, it gets stuck on `SEARCHING FOR $`

But I'm not sure if this is a problem with the C65 ROM or not.

gardners, 2021-02-08:
Confirmed problem happens with stock C64 ROM as well.

Next step is to try tweaking CPU speed a bit faster or slower to see if we get any clues there.

gardners, 2021-02-08:
So, I can load a directory BEFORE having mounted a disk image, but after that, it hangs on `SEARCHING FOR $` as described above.  So presumably the problem is when the Pi switches to the accurate 1541 emulation that it has problems.

gardners, 2021-02-08:
Now I am wondering what the difference between `OPEN15,11,15` etc is, compared with `LOAD"$",11`, from a protocol perspective, since one works, but the other doesn't... It's the sending of the filename. If I use `OPEN15,11,15,"I"`, then it also won't work.

So this means it is probably the turn-around between sender and receiver that breaks. This is a helpful clue.

gardners, 2021-02-08:
The potential problems that come to mind are reading and writing $DD00.
The 45GS02 processor always runs at full speed internally, so a write to $DD00 effectively happens 3 x 1MHz cycles too early, as it happens near the start of the 1st cycle, instead of during the 4th cycle.
A similar problem occurs for reading $DD00 -- the value will be read 3 x 1MHz cycles early.

Now, in theory it feels like this should cancel out, as a connected drive would see the signal from the M65 the same amount early that the M65 will read the response from the drive, and indeed, all signals from M65 to the drive will be similarly shifted forward.

However, clearly this falls down somewhere, since it doesn't work with the Pi1541. OR the Pi1541 is not quite cycle accurate, since the turn around DOES work with a real 1541.

gardners, 2021-02-08:
Will try adding a cycle-accurate delay to writes to $DD00 in the first instance.

gardners, 2021-02-08:
Issue logged on Pi1541 repo https://github.com/pi1541/Pi1541/issues/209

lydon42, 2024-09-24:
Merged 736, which should also handle this one.

Closed 2024-09-24.

Thread 352 (2021-01-29):

MEGAFLASH: Make use of a new 'model_id' field within core header to assess suitability of .cor file chosen for flashing

gurcei, 2021-01-29:
This is the megaflash-counterpart to the card on mega65-tools repo:
- https://github.com/MEGA65/mega65-tools/issues/19

The aim is to prevent the user from trying to flash a .cor file into a slot if it is not appropriate for their m65 target device.

E.g. If they try to flash a nexys .cor file into a slot on a mega65r3 board, new logic added within 'megaflash.c' should prevent them from doing so.

gurcei, 2021-06-03:
@gardners preferred to make use of the 'model_id' number (which should equate to the value in register $D629).

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

So I've provided such a field in the core file's header now (via the latest bit2core tool), and will aim to make use of it in this ticket.

```
0x0000 +====================+
       | "MEGA65BITSTREAM0" | (magic string - 16 bytes long)
0x0010 +--------------------+
       |     CORE NAME      | (32-byte string)
0x0030 +--------------------+
       |   CORE_VERSION     | (32-byte string)
0x0050 +--------------------+
       |    M65_TARGET      | (32-byte string)
0x0070 +--------------------+
       |    M65_MODEL_ID    | (1-byte)
0x0071 +--------------------+
       |                    |
       :    CORE PADDING    :
       |                    |
0x1000 +====================+
       |                    |
       :  BITSTREAM HEADER  :
       :       & DATA       :
       .                    .
```

gurcei, 2021-07-07:
Just as a side-note, on this card, I've also resolved an issue Kernal reported with the mechanism for selecting ROMs at boot-up failing for nexys boards. Issue raised here:

- https://discord.com/channels/719326990221574164/783728598313992262/860354253696532501

The patch to main.asm got a mention here:

- https://discord.com/channels/719326990221574164/783728598313992262/861709873569988638

Didn't hear any objections there, so will treat that as my code-review. And it has been confirmed to fix the issue on Kernal's nexys board, as well as mine.

Closed 2021-07-07.

Thread 353 (2021-01-30):

Default audio levels are illogical and cannot be changed?

M3wP, 2021-01-30:
The default audio levels seem to be fixed on reboot.  This is not too much of an issue except for the fact that they are shockingly out of what could be considered reasonable.

I can't seem to attach a screen shot of what they should be.  Here is what it should read from the audio settings of the freezer menu:

0
-2
-3
-6
-6
-79 (although -6 would be reasonable)

0
-6
-6
-2
-3
-79 (although -6 would be reasonable)

gardners, 2021-01-30:
The defaults are all set in src/hyppo/audiomix.asm
There should be routines for setting stereo vs mono default audio settings in there. And using configure menu should change between those on boot, as well.

M3wP, 2021-01-30:
Okay, understood I'll take this on then.  The settings aren't being saved as far as I can tell.

gardners, 2021-01-30:
Audio mixer settings are not saved between reboots.
It would be possible to use some of the config sector to put this information, if you feel like making the configure menu capable of setting the audio levels (or choosing between some presets, as you see fit).

gardners, 2021-01-30:
(If you do, please keep in mind that the MEGAphone has quite a few more outputs and inputs that should be configurable, such as BT in/out volumes, micrphone in volumes, cellular in/out for two modems, and quite possibly some more I have forgotten).
If you do that side, I'll make the freeze menu audio mixer save its changes when modified there, and make HYPPO read the settings in.  For Hyppo efficiency, there should be a number of audio coefficient number + 8-bit coefficient pairs = 2 bytes per value, so that I can just read through them in HYPPO. OR we just use the upper 256 bytes of the config sector to hold the complete set of coefficients might be even easier...

M3wP, 2021-01-30:
I'll just do some diffs on the settings as they are given by the current defaults and what I need to change.

There are quite a few config changes lined up!  I think having panning and volume controls would work much better and maybe only the main outputs in config?

M3wP, 2021-01-31:
Unfortunately, I have found a fundamental flaw in audiomix.asm.  It is not checking the system setting for stereo or mono operation and is simply falling through to setting mono after setting stereo.  This fall through is new to the development branch where a change was made to include the OPL.

I do not know how to test the configuration settings myself.  I need to maintain some compatibility with other devices and setting deltas are better for all of them but there is no way I can see of applying them except as something of a hack.

I will simply allow the program to run as it does now and then patch the final result.  This is totally inelegant but the only solution at the current time.

gardners, 2021-01-31:
syspart.asm is the place where system settings are applied.
That should be setting them correctly. So you will likely see setting stereo, then mono, then whatever is correct.  This should be rationalised to probably setting mono only, then whatever is correct (which will only happen if there is a system partition).

M3wP, 2021-02-03:
I believe I am getting inconsistent results between m65 -a and the audiomix program.  I will need to check by recalculating the values manually.  I am still uncertain if the Headphone L and R slots are the right way around in the listing.  I should be setting them the same, in any case.

I have found, in exploring the mixer settings, that there are serious issues on the Nexys board.  Testing will need to be done on this hardware.

I don't think it is vital that the settings be saved in configuration at this point so long as the settings are logical.

I will check the values with m65 since this does seem to be consistent with the results of my tests so far.  I have not yet looked at the audiomix program.

M3wP, 2021-02-04:
I have been experimenting with the R2 and Nexys and have found what I think are the best settings.  There are a few issues with the current settings and some bugs in a number of programs.  Now that I have a better grasp of what is required and what is happening, I can look at addressing some of the issues.

Thread 355 (2021-01-31):

DEW/INW does not set/clear the N flag

FeralChild64, 2021-01-31:
It seems that DEW does not handle N flag at all (Z flag seems to work), contrary to what is stated in both MEGA65 manual and 65CE02 whitepaper. Example test code (changes screen/border colour in case of unexpected N flag status):

```
	lda #$01
	sta $FC
	lda #$FF
	sta $FB

	; At this point N flag is set, it is expected that DEW should clear it

	dew $FB
	bpl @1
	inc $D020 ; if N is cleared (as expected), this shouldn't execute!
@1:
	lda #$00
	sta $FC
	sta $FB

	; At this point N flag is cleared, it is expected that DEW should set it

	dew $FB
	bmi @2
	inc $D021 ; if N is set (as expected), this shouldn't execute!
@2:
```

FeralChild64, 2021-01-31:
Same problem with INW.

gardners, 2021-02-01:
Staging a commit to fix this.

gardners, 2021-02-04:
Please confirm when fixed, and add the "staged" flag to the issue.
Ideally someone would also write a test case for mega65-tools repo in src/tests/test_355.c :)

FeralChild64, 2021-02-06:
Where can I find the bitstream with the fix?

gardners, 2021-02-07:
Latest experimental builds will be at http://cores.dev.mega65.org/experimental

Paul

FeralChild64, 2021-02-07:
Checked today - it seems to be fixed correctly.

lydon42, 2021-12-20:
Created test_355.prg in mega65-tools to check this.
Checked against master@bbd0391 and development@0f9af7e, all tests pass.

```
Entering unit test mode. Waiting for test results.
2021-12-20T16:36:35.312Z START (Issue#0355, Test #000 - DEW/INW DOES N FLAG)
2021-12-20T16:36:35.312Z  PASS (Issue#0355, Test #001 - #01 DEW $NN -NZ)
2021-12-20T16:36:35.312Z  PASS (Issue#0355, Test #001 - #02 DEW $NN +Z-N)
2021-12-20T16:36:35.313Z  PASS (Issue#0355, Test #001 - #03 DEW $NN +N-Z)
2021-12-20T16:36:35.315Z  PASS (Issue#0355, Test #001 - DEW - 3 TESTS PASSED)
2021-12-20T16:36:35.316Z  PASS (Issue#0355, Test #002 - #01 INW $NN -NZ)
2021-12-20T16:36:35.316Z  PASS (Issue#0355, Test #002 - #02 INW $NN +Z-N)
2021-12-20T16:36:35.317Z  PASS (Issue#0355, Test #002 - #03 INW $NN +N-Z)
2021-12-20T16:36:35.319Z  PASS (Issue#0355, Test #002 - INW - 3 TESTS PASSED)
2021-12-20T16:36:35.322Z  PASS (Issue#0355, Test #000 - TOTAL - 6 TESTS PASSED)
2021-12-20T16:36:35.322Z  DONE (Issue#0355, Test #000 - DEW/INW DOES N FLAG)
>>> Terminating after completion of last test.
```

Closed 2021-12-20.

Thread 356 (2021-01-31):

$D613 and $D614 in iomap.txt and their detailed behaviour

lgblgblgb, 2021-01-31:
It seems, `$D613` and `$D614` registers are used by open-rom to scan the keyboard without the usual "joystick interference" and having also the "C65 extra keys" as part of the matrix. However by looking iomap.txt it's confusing, since it says:

    GS $D613 DEBUG:CRTACSCNT Count of cartridge port memory accesses (read only)
    GS $D614 DEBUG:KEYMATRIXPEEK 8-bit segment of combined keyboard matrix (READ)

If possible please make it clear what those registers are for, and also please remove the `DEBUG` tag if this new functionality is planned to be supported on longer term.

Also some questions (my be more a documentation kind of material?):

* $D614 seems to select the row to scan, but not with a bitmask but with values 0-8 (8th being the "C65 row"). What happens if someone writes value greater than 8?
* Why do we need to registers, ie writing `$D614` and then reading `$D613`, it would be enough to have a single register, selecting the row by writing and reading the selected row's state on reading. But anyway, then the next question:
* What effect do you have if you read `$D614` or write `$D613`?

_So, it's not just 'remove debug status', as it seems `$D613` is meant to do something with the cartridge and other questions still may remain anyway._

gardners, 2021-02-01:
It should be only $D614: Write the row number and then read the matrix row back.
Values 0 through 9 read the keys, values above that will return $FF, i.e., no key(s) depressed.

gardners, 2021-02-01:
I think no change is required? If happy, please close the issue.

lgblgblgb, 2021-02-01:
Thanks! Hmm, interesting! Since I emulated this by using the scheme I've described using both of `$D613` and `$D614` and it seems how open-rom works, since it actually allowed me to be able to type in open-rom. So at least for me it seems, the current behaviour of MEGA65 uses that scheme if open-rom can be used this way. The other question: what selected row 9 does? 0-7: C64 "normal" matrix, 8: C65 extra keys, but what 9 does?

gardners, 2021-02-01:
So I think you are right. I misread the VHDL.  So I think its write to $D614, read from $D613, right?

lgblgblgb, 2021-02-01:
Yes. And one question was, why it's the case and not happens in the way actually you described as well, looks like more logical and more saving in precious I/O space :) So I liked your description that it "should" work that way, just it seems it's not the case currently, though :) Also, in iomap.txt `$D614` is described quite well, maybe just remove the word "DEBUG", but for `$D613` it's documented with a kind of very different functionality something to do with cartridges? :-O Honestly I was not aware too much about these things, only a forum64 thread made me thinking that I should make it possible to use open-rom with Xemu, so this thread of problems came ...

lydon42, 2022-10-03:
BOUNCE: did one of you derived the correct interpretation? Please update the docs :)

lgblgblgb, 2022-10-03:
I can only tell how I emulate this now in Xemu which seems to work: writing $D614 selects the row to scan, then reading $D613 gives the result of the selected row read. $D614 seems to need the value between 0-8, where 0-7 are the standard C64 positions, and the 8 is the "C65 keys" extra row we can say.

lydon42, 2024-08-17:
Essentially we could swap the DEBUG with UARTMISC and be done.
The latest ROMs use D619 for the keyboard, though.

gardners, 2024-08-17:
Agree, just promote from DEBUG to supported in the documentation.

Closed 2024-08-17.

Thread 358 (2021-02-02):

C64 Jiffydos

DarkstarII, 2021-02-02:
I would like to see if you can implement Jiffydos in the C64 mode of the Mega65. Current hardware like Commodore 1541, 1571, 1581 and others like Rear Admiral Thunderdrive and uIEC/SD adapters that use it will lose the speed benefits.

FeralChild64, 2021-02-07:
Open ROMs already contains JiffyDOS implementation - but for now I had to disable it in the MEGA65 build, as there are some timing problems leading to data damage (happens with original JiffyDOS ROM too). Currently Open ROMs implementation is not as fast as the original one, due to missing specialized LOAD protocol support, but is still several times faster than original CBM code.

lgblgblgb, 2021-02-08:
Even if IEC timing is perfect: I would say, it's kinda non-trivial to implement Jiffydos for C64 mode of C65 (or MEGA65) the reason that it's kinda non-standard KERNAL with various modifications, like even move to C65 mode on boot, and all the patches to call the "in-computer" DOS for accessing the internal drive, also for example tape routines are removed, maybe new stuff is there instead, and who knows. Maybe it's possible though to slightly modify a Jiffydos ROM for C65/MEGA65, which works then, minus, you can't access easily the internal drive anymore (including the possibility of "mounted" D81 from the SD-card). That would need more serious effort to have a snapshot on the heavily modded C64 KERNAL used in C64 mode of C65, and try to implement Jiffydos support in it ...

gardners, 2021-02-08:
@FeralChild64 if you are able to quantify the timing problems, this would be great, as I am trying to track down and squash all IEC port timing problems.

The one I know may contribute, is the CPU internal timing is always at 40MHz, and the CPU then just waits many cycles before executing the next instruction, if set to 1MHz.  This means both reads and writes to the IEC port happen 3 cycles earlier than expected.  But as the difference is equal, it "shouldnt" affect things. But I'd welcome your input on this.  Otherwise, there is a problem with badlines happening at the wrong time, that I need to fix, which will be making JD sad when badline emulation is on.  Does disabling it allow JD to work without problems?

FeralChild64, 2021-02-08:
Last time I tried (last year...) both mine and original JiffyDOS implementations were producing an error (damaged byte) every couple of bytes, randomly. My implementation running with disabled badlines was producing one error each few kilobytes - this wasn't really that visible to the user, but for example crunched software did crash.

Is this '3 cycles earlier' read/write relevant to LDx/STx only, or for every instruction? My implementation uses LDA, ORA and EOR for reading CIA #2 port A, depending on a bit pair received.

I'll try to retest it and find out which bits are misinterpreted (just not today, it will require several tests) - maybe this will give us some clue.

gardners, 2021-02-08:
It applies to any instruction: Because the CPU runs at 40MHz, the IEC port will see the event (or the IEC port event will be seen) within 100ns of the instruction starting.  Since almost all accesses will be with XXX $nnnn type instructions, those all take 4 cycles on a real C64, i.e., ~4,000ns, with the write/read occurring at about 3,000ns, this explains the "3 cycles early", in that 2,900ns = ~ 3 cycles.

FeralChild64, 2021-02-08:
Some updates:

1. [offtopic] It seems that my routine to detect PAL/NTSC (https://github.com/MEGA65/open-roms/blob/master/src/kernal/init/setup_pal_ntsc.s - stolen from Codebase 64) hangs on MEGA65 if NTSC is enabled. I'll try to check it in more details - maybe I did something wrong, if I won't find anything I'll create a ticket.

2. When I switch MEGA65 to NTSC mode, my JiffyDOS loading is stable if badlines are disabled, there are no transfer errors. Is it possible, that the '1 MHz' clock is slightly too slow? Please keep in mind, that my implementation is reverse-engineered and tuned by trial-and-error on VICE and Ultimate 64; timing might not be precisely the same as the original JiffyDOS implementation.

gardners, 2021-02-08:
Yes, it is possible that it is very slightly too slow, because the frame rate is exactly 50Hz.
50Hz x (625/2) lines x 63 cycles / line = 984375 Hz
But it should apparently be 985248 Hz , so we are running at about 99.9% speed, i.e., we should drop less than one cycle per thousand, which I wouldn't have thought would cause problems -- but who knows.
To fix this, we need to go from 540000 cycles per frame to 540486 cycles per frame.  I can most easily increase it to 540000 + 625 by making each raster line one clock tick narrower.

But this also reminds me: I've seen C64s with clocks that are up to +/- 3% away from nominal speed. So I'd be a bit surprised if this was enough to cause the problem.

As for the PAL/NTSC detection, can you please debug what value it gets for the max raster number?  It might be that we have an out-by-one somewhere for the NTSC max raster number.

gardners, 2021-02-08:
Please check max raster in NTSC, and let me know.
Synthesising the above fix for PAL clock speed adjustment.

gardners, 2021-02-08:
On frequency variation, 50ppm error on the crystal would imply a best-case tolerance of ~50Hz, which is much tighter than I have observed on real C64s.  Would be interesting for some folks to measure it on various machines.  In any case, as JiffyDOS byte transfers take <1,000 cycles, I'm not confident that this fix will be successful.

Is JiffyDOS incorrectly guessing that a PAL machine is NTSC? Or is the code the same for both video standards?

gardners, 2021-02-09:
Bitstream for test: http://cores.dev.mega65.org/experimental/mega65r3-20210209.10-develo-ac1aac0.bit

FeralChild64, 2021-02-09:
Unfortunately, no change regarding JiffyDOS in this build (not a surprise, the speed difference is really very small). Bits that get flipped seem to be random at first glance, but I'll try to analyze the results in more detail.

No, my JiffyDOS code does not check for PAL/NTSC - the instruction timing should be valid for both clocks.

Regarding the VIC RASTER register - it goes up to $FF, something else must be the reason; I'll try to write some more sophisticated tests (but this is a topic for another ticket).

gardners, 2021-02-09:
ok. I'm also not surprised that the tiny speed difference has no effect.

Paul.

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

dansanderson, 2025-03-31:
HW IEC is a new feature that adds timing-accurate IEC communication as a hardware (FPGA) device, and the MEGA65 KERNAL is being upgraded to use it for all IEC serial comms. For IEC disk drives that support JiffyDOS, this supports the JiffyDOS protocol.

There are currently no plans to update the C64 KERNAL that powers GO64 mode to use HW IEC. I'm reluctant to touch the C64 KERNAL at all: it works, and keeping it as byte-stable as possible is the reliable path to keeping it compatible with C64 software. But if anyone wants to try replacing the C64 KERNAL IEC routines similarly to the M65 KERNAL, we could do a slow rollout with a forked ROM at first for people to test until we're confident that it's stable, offer it as a fork indefinitely, or even make C64 KERNAL switching a feature of GO64 mode and distribute both.

FWIW, I doubt there is a reasonable way to use the C64 JiffyDOS KERNAL with GO64 mode directly. The GO64 KERNAL is not identical to a C64 in a few important ways. Using HW IEC is a more likely path forward.

dansanderson, 2025-04-28:
I'm going to resolve this for now. Once HW IEC is completed, the path forward for giving GO64 mode access to JiffyDOS would be changes to the GO64 ROM, with no further core changes required. That can be someone's fun project someday, but it's not on the roadmap. (I have backwards compatibility concerns, as above.) If someone really wants this open, please re-file at mega65-rom-public.

Closed 2025-04-28.

Thread 370 (2021-03-16):

MEGAFLASH: Set autoboot slot via flashmenu

adtbm, 2021-03-16:
This is a Feature request.

i would suggest to compare the bitstream version in slot 1 against slot 0

if slot 1 MEGA65 Bitstream version is older or not a MEGA65 bitstream, boot from slot 0
slot 0 can/should only be a MEGA65 bitstream (it is a MEGA65 ;-) )

or a different approach:
maybe would it be possible to select the autoboot slot in the flashmenu ?
i.e. i have:
- in slot 0 the nominal MEGA65 bitstream
- in slot 1 Gameboy
- in slot 2 ZX uno
- in slot 3 and alternate MEGA65 bitstream
Now i want to make a test session with the ZX uno, so that i can switch the autoboot slot to 2 ?

So whenever i power on the MEGA65 it will boot from the selected slot, if a valid bitstream is existent, otherwise it will fallback to slot 0.
 Untill i change/deselect the autoboot slot again.

gardners, 2021-03-18:
A timestamp field in the COR files would allow for an efficient "newness" test.

In terms of setting the default slot examined, this is also possible, by storing this elsewhere in the flash (this means we have to erase the 64KB page that holds this, and reserve 64KB for it). A complication is if the newness test is also used, as if you want to auto-start a bitstream that is older than the latest factory bitstream will mistakenly trigger the "do you really want to load this older bitstream?" behaviour. I'd welcome ideas on how to best manage that.

adtbm, 2021-03-18:
I would say, if you can set the default slot (0 - 3) then there is no need anymore to compare the bitstream version, because then it could be intentional that you want to run an old bitstream (maybe for testing, from i.e. slot 2).
as long as you can set the default bootslot between 0 and 3 this should be fine and as long as slot 0 is always a MEGA65 bitstream and in case of problems it always falls back to slot 0.
So if you set the default slot to 0, the MEGA65 will always boot from slot 0 regardless of what cores are flashed in the other slots, and so on.
This would also prevent the problem we had last time, when we flashed with vivado a new bitstream to the MEGA65, while the previous user updated the MEGA65 only on slot 1, unfortunately we have not been able to erase the core in slot 1 (with CTRL & 1) so the only way to bypass slot 1 autoboot was by doing a full erase with vivado.

just to ensure again: if the selected default slot is empty or not a valid core, it falls back to slot 0 which is always a MEGA65 bitstream.

gardners, 2021-03-19:
If a slot is invalid, unfortunately it will (by the nature of the FPGA
hardware) keep searching through the flash for the next valid slot.

Also, we need to deal with the case where you had the problem with updating
the factory core. I suggest that we should remember the default chosen
core, and the version of the factory core at the time. If the factory core
is updated to a newer core than the default one selected, then it should
ask for confirmation on next boot, and if accepted, we update the stored
version of the factory core in this, so that we don't get asked again.

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

lydon42, 2022-01-03:
There is now the option to choose between slot 1+2 via dip switch 4: #443

lydon42, 2023-09-24:
Default slot selection is in 683-cartflash branch.

Closed 2023-09-24.

Thread 379 (2021-05-02):

HyperRAM read failure

steph72, 2021-05-02:
On the R3 board, when

1) writing to address A,
2) reading from address A again, and then
3) repeatedly reading from address B

sometimes the contents of address A is returned instead of the contents of address B.

After writing a different value to address A, address B switches to the correct value.

Attached is a BASIC65 program that demonstrates the issue.

[hyperbug.zip](https://github.com/MEGA65/mega65-core/files/6411534/hyperbug.zip)

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

Edilbert, 2021-05-02:
I can confirm this issue.
The program runs with no errors on XEMU, but shows read failures on the MEGA65 dev kit.
When I inspect the attic RAM with the BS monitor after running the program, its shows correct values.
So it seems, that under certain conditions the read access does not return the value from the correct memory page.

lydon42, 2021-12-30:
BASIC test is a little bit faulty, NEXT R is missing between 200 and 210.
Runs without fault. Fix already merged with master.

lydon42, 2022-08-13:
Unittest for this is test_585

Closed 2021-12-30.

Thread 380 (2021-05-03):

Not able to enter Flash menu

adtbm, 2021-05-03:
i have a strange issue with the last two bitstreams for R3 (the two in the posts above my report), whenenver i try to go to the FLASH menu, instead of booting into the flashmenu (when holding NO SCROLL while powering up), i get instead in the Hypervisor/CONFIGURE menu.
When i boot up the MEGA65 in this condition it gives me on the screen the number "4" when i press "5".
(This happens only with a newly formatted SDcard)
completely discharging the MEGA65 and inserting the "original" SDcard it then works again.

adtbm, 2021-05-03:
Pauls reply:
It sounds like the ASCII keyboard scanner is having marginal timing for some reason.

gardners, 2021-05-03:
Just tried with latest bitstream build here, and it works. Commit id: a1f4135d53c157a9bfdcf249e51ed11b896760d6
Not sure if there is something odd going on. Poke me on discord for latest bitstream I generated here.

adtbm, 2021-05-03:
it does looks like a keyboard timing issue.
https://youtu.be/QexOtJ_k_0A

adtbm, 2021-05-03:
keyboard tester.
- pressing and holding "5"-key
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

adtbm, 2021-05-04:
defective cable was the root cause.

gardners, 2021-05-04:
Loose cable was probably causing glitched clock pulses and/or reflections that were causing the first few keys in the data vector to be corrupted on each transfer. The keyboard protocol runs at several MHz, with an effective scan update frequency of about 10KHz -- 100KHz depending on temperature and phase of moon in keyboard CPLD.

Closed 2021-05-04.

Thread 402 (2021-06-15):

DMA Line Fetch - incorrect results

smnjameson, 2021-06-15:
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

The above image is created by horizontally scanning a source texture and horizontally drawing it line by line to the screen. The screen is set up with vertical char strips and the source texture is a regular image scanned left to right and top to bottom. In the above case both slopes are X positive with slope values of $00:$00 and it draws correctly

If we take the source slope and change it to $FF:FF it should read the source texture with diagonal lines at a 45 degree downward angle to the original. Drawing these lines out to the screen should have the effect of skewing the resulting screen image 45 degrees upwards. However this is the output:

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

Likewise we can rotate a scan line in the source image around a point like a clock hand and draw that texture source data at the same rotated angles on the screen. Essentially copying data in a circle from source to destination. However the result is such:

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

With only the left hand quadrant somewhat displaying the correct data.

smnjameson, 2021-06-15:
Here is a good image showing the problem:

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

The same image is scanned and rendered to the screen using lines three times with gaps between each scan line to help visualise the scan line directions. The arrows above each image show the direction of the scan lines and the lines drawn are of the same direction and angle as their corresponding scan line. The orange arrows indicate the direction of the start point of each line over time, with the start point remaining stationary on the third radial example.

You can see that horizontally scanning works perfectly, this is the same as the source texture image.

Scanning vertically does something strange, while the starting point is correctly moving from left to right, it appears like each source line is still taken _**horizontally**_ and so we see the red line at the top of the source image drawn vertically and getting smaller as the source start point moves across it.

Therefore when scanning at a range of angles as shown in the third image, the results are completely incorrect

smnjameson, 2021-06-15:
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
 OK Ignore this!!!

the key is to make sure the texture data is stored like the screen data, in vertical strips of 8x8 chars
obvious really, I feel so stupid

Closing this "bug" as its working as intended

gardners, 2021-06-15:
You can actually structure the source data in a variety of different ways, provided you configure the DMA controller to know what you are doing :)

Closed 2021-06-15.

Thread 411 (2021-06-20):

synth_1 failed run for mega65r3.bit make

clar0867, 2021-06-20:
Unable to make mega65r3.bit as synth_1 run fails preventing impl_1 to launch.
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

gurcei, 2021-06-20:
Which branch are you building from? If not using it already, I'd suggest working from "development" branch, as that is the most active branch at present and is building successfully

clar0867, 2021-06-21:
Build was from the development branch.

gurcei, 2021-06-21:
Ah ok, so just for point of comparison, our Jenkins build server successfully built the latest commit to 'development' branch (commit#73a2cab) from 3 days ago.

So if you're building from this exact commit too and it is failing, it'll require figuring out what is different on your system compared to what the jenkings build agent has.

If you've made changes to the vhdl since then, you might need to scrutinise those changes.

Also might be worth reaching out to falk on the discord channel to learn more details on what pre-reqs are on those build agents and how they differ to you.

E.g. Could it be a difference in versions of vivado causing this? (Though I've switched between a few different versions of vivado in my time and had success, but still, can't rule it out).

Also, jist to share my own recent experiences, I built from latest development branch on my local ubuntu vm last night, for `make bin/mega65r3.bit` and `make bin/nexys4ddr-widget.bit`, and both built fine.

gardners, 2021-06-21:
This can also be caused by having insufficient RAM. Vivado needs _lots_ of
RAM, probably at least 4GB, and more likely 8GB to successfully synthesise
the MEGA65.

Paul.

On Tue, 22 Jun 2021 at 00:42, Gurce Isikyildiz ***@***.***>
wrote:

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

clar0867, 2021-06-22:
Appears that the solution to running make bin/mega65r3.bit using Vivado 2020.2 is to run an excess of 8GB of RAM and multiple processor cores to enable this. I feel as though a minimum inclusion of hardware requirements would be beneficial as this has solely come down to a lack of information on this behalf.
If aware I could have resolved this issue weeks ago throwing near full capacity of 32GB RAM and the i7-10875H into the VM for this to conduct this almost instantly.

gurcei, 2021-06-22:
Glad you got it sorted, and can sympathise with the pains you went to get things working.

Also good to see that not long after reaching out via the ticket, you got some answers that helped make up for the shortcomings of present documentation.

So moving forward, I agree with you that it'd be good to document minimum hardware requirements for building bitstreams somewhere:
- speed of cpu
- number or cores
- how much hard disk space is needed for the vivado installation
- how much memory

As for where a good home for these details might be, I was thinking perhaps in the repo's build.md file?

https://github.com/MEGA65/mega65-core/blob/master/docs/build.md

Perhaps @gardners might have another home for it in mind?

@clar0867, if you're keen, you're welcome to add such details and open a PR for us to merge in.

Also might be good for it to point to a walkthrough of how to install vivado, as I recall someone recently tripping up on install steps.

Someone has already prepared some docs for vivado steps, I will try to integrate it into the mega65 user guide soon.

https://github.com/MEGA65/mega65-user-guide

gurcei, 2021-07-01:
Ok, on this matter, I've played my part and merged in Amok's documentation on installing-vivado into the latest mega65-book.pdf file.

I'll leave this ticket open a little longer, to see if you're open to adding those minimum-hardware-details into the 'build.md' document.

gurcei, 2021-07-13:
I've found a location inside the mega65-book.pdf file where some mention of the required specs was made for synthesising bitstreams, in "CH19: Flashing the FPGAs and CPLDs in the MEGA65":

> Be prepared to install many gigabytes of software on a Linux or Windows PC, before you
will be able to write programs for the FPGAs and CPLDs in the MEGA65. Also, ”compiling”
complex designs can take up to several hours, depending on the speed and memory capacity
of your computer. We recommend a computer with at least 8GB RAM (preferably
16GB) if you want to write programs for FPGAs and CPLDs.

I will update this paragraph to reflect your recent experiences, and perhaps provide a concise list of suggested pre-reqs for synthesis:

- **speed of cpu**: As fast as you can get your hands on!
- **number or cores**: The free license for Vivado can make use of a maximum of 8 parallel cores (so ideally, 8 or a few more)
- **how much hard disk space is needed for the vivado installation**: Several GB, depending on how much you install (bear in mind the full install file is 50GB)
- **how much memory**: Latest bitstreams need a minimum about 12GB of RAM to build (ideally, have more, to play it safe)

gurcei, 2021-07-16:
I've found a location inside the mega65-book.pdf file where some mention of the required specs was made for synthesising bitstreams, in "CH19: Flashing the FPGAs and CPLDs in the MEGA65":

> Be prepared to install many gigabytes of software on a Linux or Windows PC, before you
will be able to write programs for the FPGAs and CPLDs in the MEGA65. Also, ”compiling”
complex designs can take up to several hours, depending on the speed and memory capacity
of your computer. We recommend a computer with at least 8GB RAM (preferably
16GB) if you want to write programs for FPGAs and CPLDs.

I will update this paragraph to reflect your recent experiences, and perhaps provide a concise list of suggested pre-reqs for synthesis:

- **speed of cpu**: As fast as you can get your hands on!
- **number or cores**: The free license for Vivado can make use of a maximum of 8 parallel cores (so ideally, 8 or a few more)
- **how much hard disk space is needed for the vivado installation**: Several GB, depending on how much you install (bear in mind the full install file is 50GB)
- **how much memory**: Latest bitstreams need a minimum about 12GB of RAM to build (ideally, have more, to play it safe)

Ok, I feel like `mega65-book.pdf` has been updated sufficiently well now to address your feedback, feel we can close this ticket off.

Closed 2021-07-16.

Thread 422 (2021-07-05):

Saving CONFIGURE settings under nexys

kernal-clink, 2021-07-05:
When using latest bitstream (nexys4ddr-widget-20210628.22-develo-400b006.bit) settings are unable to be saved

gurcei, 2021-07-11:
Oh, I'm wondering if this relates to something that user Amok experienced early on too.

I was reading his past threads on Discord recently and saw that he switched:

- https://discord.com/channels/719326990221574164/719326990221574168/842697905290215435

FROM: loading the bitstream from the sd-card (the default path nexys users are suggested to use in our docs)

TO: loading the bitstream from the QSPI flash chip (which is a less trodden path and not as well described in our docs, but improving)

I read that the possible reasons that made him switch were:

1) Problems rebooting after onboarding finished or freeze-menu used to swap PAL/NTSC
2) Such settings not being saved.

So it's possible that settings not being saved from the configuration utility might also be affected by this, and so you might want to try switching to QSPI bitstream-loading mode yourself.

I'm underway with merging Amok's documentation on his nexys4 experiences of topics like this (transitioning over to using QSPI). Some of these efforts have made their way into the latest mega65-book.pdf

Temporary location of latest documentation is here:
* http://gurce.net/mega65_files/docs/

In "CH10: Using Nexys4 boards as a MEGA65", there's now a section called "Loading the bitstream from QSPI".

I've still got two more docs from Amok to merge in that probably have more details too, so will put *all* of his docs on your radar too, just in-case.

https://drive.google.com/drive/folders/1gCMJYNMlzHUNEyNNFBCIPwh8zOnVaL__?usp=sharing

gurcei, 2021-07-11:
I also had a read of the discord thread that spawned this ticket:

- https://discord.com/channels/719326990221574164/783728598313992262/861702464189235230

The thread is a bit intermixed with another thread, but Paul jumped in at this point providing some reasoning:

- https://discord.com/channels/719326990221574164/783728598313992262/861761354692296724

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

gardners, 2021-07-12:
Configuration goes to SD card, and it should not matter at all whether the bitstream was loaded from QSPI, USB or carrier pigeon. Only flashing QSPI is restricted if you didn't load the bitstream from QSPI (for complicated Xilinxy reasons that are possibly possible to overcome, but I haven't figured out how to).

headkaze, 2021-07-17:
Be aware that the default setting for QSPI ConfigRate in [nexys4.xdc](https://github.com/MEGA65/mega65-core/blob/master/src/vhdl/nexys4.xdc#L267) and [nexys4ddr.xdc](https://github.com/MEGA65/mega65-core/blob/master/src/vhdl/nexys4ddr.xdc#L241) is 66MHz:

`
set_property BITSTREAM.CONFIG.CONFIGRATE 66 [current_design]
`

But it may be too fast so you may need a lower setting like 26MHz:

`
set_property BITSTREAM.CONFIG.CONFIGRATE 26 [current_design]
`

gardners, 2021-07-17:
Correct -- but now that the configure settings are not stored in the QSPI, but rather on the SD card. But you are quite right, that on some boards at least, 26MHz may be required, if the system doesn't boot reliably from QSPI.

gurcei, 2021-07-24:
Just refreshing my memory on what I observed from testing @gardners' attempted fix, mentioned in this discord thread:
- https://discord.com/channels/719326990221574164/783728598313992262/866247419490336769

Seems like it didn't work as hoped, that settings weren't getting saved successfully to sector 1, and visibility of the sd-card during startup seemed a little hit-and-miss (with occasional hickup reports of `NO MEGA65.ROM FOUND` on some startups).

I'll dig into it some more tonight...

gurcei, 2021-07-27:
Ok, a fix for this has been merged into 'development' branch

Closed 2021-07-27.

Thread 423 (2021-07-12):

Cannot enter config menu if no SD card is inserted

deftmega, 2021-07-12:
If no SD card is inserted, config menu crashes after decrunching.

Closed 2021-12-20.

Thread 433 (2021-08-21):

Floppy should retry if CRC errors occur during reading

gardners, 2021-08-21:
Currently if the 1st attempt to read a sector fails, then the sector operation fails.
We should, however, retry a few times before giving up, in case its a transient error.

gardners, 2021-08-23:
Believed to be working now, but a bit difficult to test, without formatting a special disk with multiple broken copies of a sector, and one real good copy of the sector on a track.

Closed 2021-08-23.

Thread 437 (2021-08-28):

Saving to disc images no longer works with latest bitstream

steph72, 2021-08-28:
With bitstream development@292846b it is no longer possible to save files to disc images mounted from the internal SD card (using closed ROM V920218)

Steps to reproduce:
1. Mount a .d81 disc image from the freezer (or have it auto mounted at startup)
2. Create an arbitrary BASIC one liner
3. save it with `DSAVE "FOO"`
4. type `DIR`
5. "foo" wasn't saved and doesn't show up in the directory

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

steph72, 2021-08-28:
P.S.: Issue is not related to BASIC65. Using CBDOS through the C64 mode kernal has the same results.

gardners, 2021-08-28:
Roger that. Will investigate tonight. Most likely still something funny with implementation of floppy writing.

lgblgblgb, 2021-08-28:
I had similar problems with Xemu in the old days when I have a ( .... err ... more ) bugs in the fdc emulation. It's really interesting though that there is no error message or anything that it could not be written, this was my experience as well.

gardners, 2021-08-28:
Confirmed that I can save to a D81 on commit 80a1b3c, and also on ccd8468.

@steph72 can you please double-check that there is no HICKUP.M65 on the SD card? As there was a bug in the HICKUP code that would cause this problem.

There were also some recent commits where it was broken, but it should not be 100% fine.

steph72, 2021-08-29:
Problem disappears with a freshly formatted SD card.

lgblgblgb, 2021-08-29:
Btw it seems **Gurce found the possible reason that deleted file is picked up** still, that is on filename comparison uses `DEX` followed by `BNE` and not `BPL` so the first (zeroth ...) char of the name is never checked. Among other problems (like picking up also `AICKUP.M65` for example instead of `HICKUP.M65`, it also causes to happy find a deleted file as exactly the first character of the filename is overwritten by `$E5` in that case, which is not checked then by that bug.

Closed 2021-08-29.

Thread 441 (2021-09-10):

VIC displays wrong border colour in 2-bitplane mode and even colour indexes.

Edilbert, 2021-09-10:
10 FOR BC=0 TO 7:BORDER BC
20 SCREEN 320,200,2
30 PRINT BC,PEEK($D020)
40 GETKEY A$
50 SCREEN CLOSE
60 NEXT BC

This test program opens in a loop a graphics screen for the border colours 0 to 7.
The border colours 2, 4 and 6 are displayed as 1, 2 and 3, while the printout shows the correct numbers.
The other indexes are correct.
0 -> 0
1 -> 1
2 -> 1
3 -> 3
4 -> 2
5 -> 5
6 -> 3
7 -> 7

So if bit 0 of the border colour is 0, the displayed colour is the register colour shifted right.

lydon42, 2021-12-20:
Can't reproduce this with current development@0f9af7e nor master@bbd0391 on nexys4ddr.
Border colours are correct, return values of peek match BC.
Is this still an issue? Please clarify platform, core and rom used.

lydon42, 2021-12-30:
Possibly fixed by 32 color patch. Problem no longer exists. Bit Shifter confirms.

Closed 2021-12-30.

Thread 449 (2021-09-25):

Enhance SID, please?

M3wP, 2021-09-25:
Please make some enhancements to the SIDs including extra oscillators and better noise, as discussed.

This link was requested to be included:  [https://justanotherelectronicsblog.com/?p=402](https://justanotherelectronicsblog.com/?p=402)

M3wP, 2021-11-30:
Perhaps convert it to LAN based protocol?  You have the source?

Daniel.

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

headkaze, 2021-12-01:
> Perhaps convert it to LAN based protocol? You have the source?

Building the entire MEGA65 bitstream just to work on the SID implementation would be quite time consuming so I propose using NetSID for faster development. You can make modifications to the vhdl, build a bitstream directly to the Nexys 4, then test any song using the ACID 64 player over UART.

The history of the SID implementation used in MEGA65 is quite interesting as referenced in the [README.md](https://github.com/headkaze/NetSID/blob/main/README.md). Essentially we don't know the original author of the vhdl but we do know that [alvieboy](https://github.com/alvieboy) added filter support.

I was under the impression this implementation was quite complete? What features are missing or are you proposing enhancements not contained in the original SID chip?

gardners, 2022-01-26:
Relevant reference material for accurate SID emulation (in no particular order):

https://www.kvraudio.com/forum/viewtopic.php?t=526480  -- includes SPICE model of the filter. Can we use that to implement a VHDL one?
https://bel.fi/alankila/c64-sw/index-cpp.html
http://forum.6502.org/viewtopic.php?f=8&t=4150

There are some tools for converting SPICE to Verilog, for example, which could be a nice way to tackle this. E.g.:

https://www.tekmos.com/about/blog/spice-to-verilog

deftmega, 2022-01-29:
Let's try Sorgelig's new Mister SID for a change:

deftmega, 2022-01-29:
https://github.com/MiSTer-devel/C64_MiSTer/tree/master/rtl/sid

deftmega, 2022-01-29:
oh, one more comment: we need someone (NOT Paul) to dig into porting reSID to VHDL in full. It has not been done because the other projects don't have big enough FPGAs - we do. This can be the perfect SID without the limitations of a too small FPGA, like FPGASID. If anyone dares to take this job, please contact us / me for support <3

deftmega, 2022-01-30:
More valuable resources:
http://www.sidmusic.org/sid/sidtech.html
https://bel.fi/alankila/c64-sw/index-cpp.html

deftmega, 2022-01-31:
from discord:

 Test bit (from the inSIDeous document):
On every synthesizer, the oscillators are usually running in the background continuously. If there is silence, the oscillators will still be playing, but you won't be able to hear them because the amplitude envelope has reduced their volume to zero. When you press a key to play a note, the envelope allows the sound to pass through, but the oscillator itself does not restart its wave from the beginning. The test bit allows you to do just that. When it is set, the oscillator will have its wave restarted from the beginning (at a phase of zero). This is an advanced feature that is mostly useful when using multiple channels to create a single monophonic sound. If you set one channel to use the test bit and another to not, the two waves will have a random phase difference on every new note. You can also set the test bit at any point in the step table, allowing you to make it sound like a single waveform is playing a new note.
Try using 2 channels, both set to use the sawtooth wave and make sure the TEST bit is disabled for both. Play some notes to hear how it sounds. The sound should be consistent on each new note, but the phase between the 2 channels will be different. You can see this on the output scope at the bottom-right of inSIDious. Now enable the TEST bit on one channel. Play some notes again and you'll be able to hear (and see in the scope) that the phase is different between the two on every note. This is because one channel has its phase reset on every note while the other doesn't. Now enable the TEST bit on both channels. Because both channels have their phase reset on every note, the two waveforms are identical and so sound like a single channel at twice the volume.

`:
  reg8 test_next = control & 0x08;

  // Test bit set.
  // The accumulator and the shift register are both cleared.
  // NB! The shift register is not really cleared immediately. It seems like
  // the individual bits in the shift register start to fade down towards
  // zero when test is set. All bits reach zero within approximately
  // $2000 - $4000 cycles.
  // This is not modeled. There should fortunately be little audible output
  // from this peculiar behavior.
  if (test_next) {
    accumulator = 0;
    shift_register = 0;
  }
  // Test bit cleared.
  // The accumulator starts counting, and the shift register is reset to
  // the value 0x7ffff8.
  // NB! The shift register will not actually be set to this exact value if the
  // shift register bits have not had time to fade to zero.
  // This is not modeled.
  else if (test) {
    shift_register = 0x7ffff8;
  }

  test = test_next;`

M3wP: I suggest making test a counter and while not 0, fade the registers and decrement, setting it to some value on detecting the bit being set and unset (to stop the counter)

deftmega, 2022-01-31:
TEST (Bit 3)--The test bit, when set to a one, resets and locks oxcillator 41 at zero until the test bit is cleared. The noise waveform output of oscillator 41 is also reset and the pulse waveform output is held at a DC level. Normally this bit is used for testing purposes, however, it can be used to synchronize oscillator 41 to external events, allowing the generation of highly complex waveforms under real-time software control.

deftmega, 2022-01-31:
I found a complete reference on digital sampling and the C64, including: general theory, SID hardware description, and methods of playback, here:
http://sid.kubarth.com/articles/the_c64_digi.txt

Closed 2024-09-10.

Thread 452 (2021-09-30):

Make a 15khz video output for older monitors

intric8, 2021-09-30:
This could allow one to use an old C= CRT monitor, for example, while also using an HDMI modern monitor. (which would be totally rad)

gardners, 2023-12-25:
Speaking with @ki-bo , we explored some of the solution space, and came to the following idea:

1. This should work with a special DB9 to DB15 adapter cable on the MEGA65's VGA port.
2. It should use the same cable as the M2M framework for MEGA65.
3. The cable should be used to provide the means of detection for the MEGA65 core (and M2M cores when they are updated to support this), so that it is impossible to accidentally provide 31KHz video to an old CRT monitor.
4. The VGA SDA/SCL pins are a good candidate for this: Bridge them using a 4.7K resistor, and the MEGA65 can check for this physical connection. If present, then the MEGA65 can assume it has a 15KHz monitor attached, and switch to 15KHz output.
5. The 15KHz video generation can be provided by r3_expansion.vhdl, that already generates 15KHz timed video for composite / S-video output.
6. The R,G, and B channels are already the right voltage on VGA, so we just need to provide a "composite sync" signal, which we can already generate in r3_expansion.vhdl.
7. r3_expansion.vhdl should just gain VGA SCL/SDA pins, and a pass-through for the VGA from the core to the VGA connector, and do all the magic switching internally.
8. When working, coordinate with M2M framework team for them to support the same mode.

Ideally we should collate links to all the relevant resources in this issue. Some already:
https://www.retrogamingcables.co.uk/composite-video-vs-composite-sync
https://bboah-hardware.de/cgi-bin/showhardware.cgi?HARDID=849

gardners, 2023-12-25:
Probably me to do the VHDL parts. But I don't have a 1084 or similar monitor here, so will require assistance with testing.  It would be good for me to have a test cable with the resistor fitted, but with a momentary-break switch in-line for testing the auto-detection via watching sync on oscilloscope. i.e., so that I can watch the sync frequency change.

markkrueg, 2024-03-12:
It would be nice if there were a software "force mode" option as well. With warnings if necessary (although 15KHz mode shouldn't damage a modern VGA monitor).

Currently I connect my MEGA65 to my US NTSC 1084S-P using a DB15 to 6 pin DIN connector. The US 1084 does not have SCART or a DB9, so the normal way to connect an Amiga or similar would be over the analog 6 pin DIN connector.

Anyway, I use this cable to connect my MEGA65 to my 1084, but currently it only operates when using the C64 core. This core has a nice menu where you can choose 15KHz mode and what type of sync you prefer. I'm hoping for a similar capability in the MEGA65 core without having to build another cable.

https://www.ebay.com/itm/124200576180?var=425049611391
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

markkrueg, 2024-03-12:
Here is a comparison of PAL and NTSC models of 1084:
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

ZorroDJ, 2024-06-21:
Pease 115Khz RGB, not CVBS.

gardners, 2025-09-06:
I'm currently looking at this, using a VGA to SCART passive cable I have here.

Also fixing NTSC colour space issues for composite output on the expansion board.

gardners, 2025-09-06:
Confirmed that this gets 15KHz SCART output working for me from the VGA connector with a standard MiSTer cable.

Thread 454 (2021-10-04):

Fetch current CPU bank

M3wP, 2021-10-04:
When MAPping the CPU, it becomes important for library code to know where a seemingly near address is actually located in the flat memory space (for example, when declaring DMA job lists and trying to call them).

Being able to fetch the actual current bank will alleviate many issues when attempting to build code libraries.

M3wP, 2021-10-04:
[test454.zip](https://github.com/MEGA65/mega65-core/files/7281653/test454.zip)

I have created a test which tests the following conditions:

1. DMA started from $D706 works correctly in RAM when _not_ MAPped
2. DMA started from $D706 works correctly in RAM when MAPped

It adheres to the automated test harness requirements and reports test activity.

It succeeds on the R2 but apparently fails on the Nexys.  I am yet to confirm.

lydon42, 2021-12-21:
This is in hdfloppy and hwsc branches.
I just tested it on hwsc and get a green border, no 1 or 2 displayed. But I don't see any unit test output in my m65 tool.

M3wP, 2021-12-21:
I had to port the unit test output code from C to ASM.  You may be unwilling to debug it.

If there is a green border, then it is working.

I do apologise about the unit test output unit not working.  I ran out of time and didn't know how to test it properly.

lydon42, 2021-12-22:
Is your issue resolved by the provided solution?

M3wP, 2021-12-22:
Umm...  Well...  The change does allow the DMA to be used more sensibly when utilising the MAP CPU feature.  I was hoping for a more generic solution (reading from the DMA perhaps) but the issue can be closed.

Closed 2022-01-09.

Thread 460 (2021-10-17):

Exit and reboot to onboarding - reboots to Open Rom.

mindrail, 2021-10-17:
When in the configuration menu and doing an exit and reboot to on-boarding.. It reboots to open rom.
If you power off and back on it then enters the on-boarding.

lydon42, 2021-12-30:
Is this still happening? Which core release are you using?

lydon42, 2022-01-09:
I tested this in the last week quite often on both r3 and r3a: this is fixed.

Closed 2022-01-09.

Thread 465 (2021-11-02):

$D610 consumes key presses without being written to

gardners, 2021-11-02:
If multiple keys are pressed, they replace the key value currently being presented on $D610, without requiring $D610 to be written to.

gardners, 2021-11-02:
Confirmed problem is with keyboard input buffering logic.
Synthesised an initial fix, now fixing a previously unnoticed problem with the $D610 keyboard input buffer overflowing.

gardners, 2021-11-03:
Resolved.

gardners, 2021-11-03:
Simple test program that allows you to type keys, then press fire on joystick 2 to see them displayed on the screen, to confirm that they were properly queued.

gardners, 2021-11-03:
```
;d610_test.prg ==0801==
    0 print"{clr}"
    2 poke53295,asc("g")
    3 poke53295,asc("s")
    5 i=1
   10 v=53248+6*256+16
   20 j2=53248+12*256
   25 poke1024,peek(v)
   30 ifpeek(j2)and16goto25
   40 poke53280,(peek(53280)+1)and15
   50 poke1024+i,peek(v)
   55 i=i+1
   60 pokev,1
   70 if(peek(j2)and16)=0 goto70
   80 goto30
```

Closed 2021-11-03.

Thread 472 (2021-11-07):

Floppy WDATA line can contain glitches

gardners, 2021-11-07:
Root cause unknown, as it suddenly started happening on my R3, prior to which reading was rock-solid.
Suspect VCC to floppy is too low at 4.7V.
The symptom is very short gaps, typically ~1/3 of the minimum interval length breaking up the true interval (as compared from multiple reads of the same track.
Thus the problem is believed to be in the read electronics. Symptoms seem consistent with a brief flux inversion being reported that is not really there.
Thus these short gaps should be treated as glitches and merged with the gaps on either side.

gardners, 2021-12-30:
Confirmed that it is _not_ on the read side, as disks written by other systems read without glitches.
Must therefore be on the write side.
R3A board has 5.07V instead of 4.65V on 5V line, so that is not the problem.
Suspect the combinatorial logic that selects the F_WDATA, F_WGATE etc is the most likely source of glitches.
Trying to move that to clocked to resolve this.

lydon42, 2022-01-09:
Floppy writes where tested thoroughly the last week, so this is fixed.

Closed 2022-01-09.

Thread 499 (2021-12-22):

HW-Reset from within FREEZER breaks sprite display

hernandp, 2021-12-22:
Using the latest core and BASIC ROM yields the following behavior:  the default sprite mode seems to be full vertical resolution (V400) but poking POKE $D076,0 to disable it does not seem to work.

This can be tested with:

* Boot up the machine in 65 mode.
* Type:

10 FORI=1536TO1536+63:POKEI,255:NEXT
20 POKE$D015,255:POKE$D000,100:POKE$D001,100

run the program you will see the sprite in non-VICII mode (full vertical resolution).

POKE $0D76 to enable or disable the setting.  It wont change.

lydon42, 2021-12-22:
Tested on nexysA7 with latest master, development and hwsc plus ROM 920271 and 920273:
$D076 is always 0 on startup, and sprite is big, so V400 disabled.
Best report issues with specific core build (either jenkins number or git hash) and ROM version.

hernandp, 2021-12-22:
Cold resetting made it to work, but the start of my adventure into this is that in my Sprite Editor I get now V400 enabled at default, so I get bad cursor and preview sprites ;  but I couldn't reset it poking to D076, so I'm researching what  the Freezer environment changed in the last commits.  I know VICIV registers are setup differently now.

hernandp, 2021-12-22:
I reproduced it again by:

* Cold reboot
* Execute BASIC program, should work.
* Enter Freezer.
* Do not exit with F3/F5, Warm reset with Nexys board.
* Execute BASIC program, sprite is of incorrect height. D076 seems to be unoperational.

ROM 920273.
Freezer commit 16518d87ceea2d5bbf267495bf34aa87fb7831b6
MEGA65 hypervisor 00.16, Development 20210810.19,3e0bacf

hernandp, 2021-12-22:
Updated to Development 20211229.22, 0F9AF7E.

Same behavior.

lydon42, 2021-12-23:
Just tested with 0f9af7e and 920273 on nexysA7, following your instructions: behaves as it should. Tested both PAL and NTSC modes.
Could you generate a md5sum of your FREEZER.M65? Perhaps the problem lies there. Just tested again with a freshly build FREEZER from hwsc head, but it also does not show the problem. My original FREEZER must be about two month old from the SD-Card Essentials file.
`b09b6066e0b05635834e6310307ce5eb  FREEZER.M65` (installed from SD Card Essentials)

Correction about the instructions:
- Power on
- _flash bitstream with m65 -b_
- run test program from disc
- enter freezer
- preset reset button on nexys
- run test program from disc

hernandp, 2021-12-23:
My FREEZER.M65 is built on the latest commit.
$ md5sum FREEZER.M65
5a03e8d7a998d209880c58fc2131a3c7 *FREEZER.M65

El jue, 23 dic 2021 a las 13:12, Oliver Graf ***@***.***>)
escribió:

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

lydon42, 2021-12-23:
ok, now tried with the head of mega65-freezemenu: still no bug! Damn, the second to last commit message even mentions D076... I will look at the changes if something pops up... and the question would be: is this really a mega65-core issue? or is it a mega65-freezemenu issue?

hernandp, 2021-12-23:
@lydon42  Thanks for following up.
Made a quick video of it, sorry for the video shake (phone-in-hand) :)

https://youtu.be/lFlbbGjhWlQ

lydon42, 2021-12-23:
Already the first POKE$D076,255 looks wrong to me. The sprite should not be at the top position right below the border. rather it's distance in V200 mode it has to the top should be halved. So that's already suspicious.

This is how it looks for me: https://youtu.be/4cfVrJC87vo
You also see that my Freezer is way to low on the screen... only happens with NTSC.

hernandp, 2021-12-23:
Thanks. I can confirm that works in NTSC, but not in PAL.

gardners, 2022-01-02:
@hernandp please tell me how to reproduce the problem in the sprite editor, and I'll debug it directly from there.

hernandp, 2022-01-03:
@gardners Checkout  f655bcb437d4190597436cc28270d5a9776fbd8e from mega65-freezer (I added poking $D076 to zero in the startup code) and build FREEZER.M65 and SPRITED.M65 from there.
Upload to SD Card.

I'm using:
ROM 920273.
Core: Development 20211219.22, 0F9AF7E.

Bootup machine. Start freezer -> and Sprite Editor. You'll see distorted cursor and preview sprite.

hernandp, 2022-01-03:
Addendum:  Attach the D076 test program.
[D076.zip](https://github.com/MEGA65/mega65-core/files/7801746/D076.zip)

lydon42, 2022-01-20:
I could reproduce this using master@1586ad4 and 920287 on r3a.
Poking $d076 to 255 is not a prerequisite to trigger the bug, just FREEZE and then press reset button.
After this sprites are in the described state.

So this is nothing that is triggered by D076. It is some state then freezer sets the VIC to which is not cleared by a reset. Only way to get it back to normal seems to be power cycle.

The problem is only triggered by pressing the hardware reset button while in freezer. Pressing F3 or F5 in the freezer to reset does not trigger the problem.

lydon42, 2022-01-20:
I already compared VIC registers before and after the reset, but I could not find anything obvious. And setting VIC regs to values from before the reset did also have no effect on the wrongly displayed sprites.

Symptoms are:
- sprites are not in the position they should be (they are moved left and down compared to before)
- sprites are in V400 mode regardless of D076 contents

lydon42, 2022-01-20:
Steps to reproduce:
- have a prg that displays a sprite (the one above or my SPV4002.PRG)
- start in mega65 mode
- execute prg to see sprites
- freeze with restore
- press warm reset button of hardware
- execute prg
- bug!

Also:
- start sprite editor from freezer, sprites a are wrong

Reproduced with master@1586ad4 and 920287 on r3a.

[spv4002.zip](https://github.com/MEGA65/mega65-core/files/7908723/spv4002.zip)

lydon42, 2022-02-05:
No core bug, this is a freezer bug -> https://github.com/MEGA65/mega65-freezemenu/issues/33

lydon42, 2022-02-05:
This needs still an update of the mega65-freezemenu submodule, so reopening this as a reminder.

lydon42, 2022-02-06:
Pushed update to new freezemenu version.

Closed 2022-02-06.

Thread 523 (2022-01-16):

Ethernet RX buffer handling problems

gardners, 2022-01-16:
The ethernet controller seems to have problems with the RX buffer handling.  Initial investigation shows duplicate frames being received, suggesting that the wrong buffer is being presented to the CPU.  Similarly lost frames and seemingly out-of-order received frames suggests that this might be an issue.

The duplication of received frames was confirmed by enabling logging of received and transmitted ethernet frames in mega65-weeip, and then using a utility to convert those logs to normal pcap-compatible capture logs that could be analysed using tcpdump or wireshark.

gardners, 2022-01-16:
Maybe make an ethernet loop-back enabling program, to see if we can reproduce the problem.

gardners, 2022-06-30:
Confirmed that the ethernet buffer handling in VHDL gets confused if all buffers are filled (which of course can happen quite easily for client software written in C).

ki-bo, 2023-05-25:
This is probably solved by this commit: https://github.com/MEGA65/mega65-core/pull/653/commits/70522820ad65217f5d681a60566b4591e2982429

Closed 2024-09-10.

Thread 526 (2022-01-19):

N and V flags with BIT #imm

jimnicholls, 2022-01-19:
In the VHDL, does the immediate addressing mode of `BIT` (opcode 89) alter the N and V flags and should it?
Ref: http://forum.6502.org/viewtopic.php?f=2&t=2241&p=27243#p27239

Xemu and hyppotest both implement this quirk of `BIT` whereby `BIT #$nn` does **not** alter the N and V flags but it does alter the Z flag. All the other addressing modes for `BIT` alter all 3 flags.

Some datasheets for 65c02-class CPUs say `BIT #$nn` does **not** alter the N and V flags. Some say the N and V flags are undefined. And some don't make any specific mention of `BIT #$nn` being different to the other addressing modes of `BIT`.

gardners, 2022-01-19:
Yes, N, V and Z are currently set for all version of the BIT instruction, including immediate mode. This is the simplest logic.  We can change it if its wrong, however.

jimnicholls, 2022-01-19:
There's a some ambiguity around if the real 4510 did this or not, and if 45GS02 needs to follow.

lgblgblgb, 2022-01-19:
> There's some ambiguity around if the 65CE02/4510 did this or not, and if 45GS02 needs to follow. I'm going to write a simple test program and see if someone with a 4510 can run it.

Even if 4510 does not follow, I think it's more important to be compatible with 65C02 at this point. Eg, I would guess about zero programs ever written for C65 which really depends on this. However 65C02 and compatible CPUs are used in many things, many compiler/assembler can be targeted that, and some 65C02 based stuff can be expected to be ported to MEGA65, with the promise that 65CE02 is in fact an enhanced 65C02 (thus the letter "E", I think). So just by chance, I think it's much more important to follow the standard. After all, some (early? most? all? no idea ...) 4510s known to exist in development C65s **could not even** execute well the Z-indexed addressing mode because some hardware bug in 4510 implementations. Does it mean that we must follow 4510 and forget Z indexed addressing mode then? ;)

_Surely it was my personal opinion only_. Of course if there is a much more major difference 4510 did differently (compared to lake 65C02) then it's already a bit different story.

lydon42, 2022-01-20:
Bo Zimmermann did run a test on the real C65: the CPU did set N and V flags also for the immediate addressed versions.

Reference: https://discord.com/channels/719326990221574164/782759365064917065/933794977232879627

lydon42, 2022-01-20:
In essence: the MEGA65 behaves like the C65, but not like the 65C02 (which does not set N and V in immediate mode).

Now the decision is still to be made: which one do we follow?

lydon42, 2023-12-13:
The implementation of the MEGA65 copies the implementation of the 4510 CPU of the C65, which does not treat BIT immediate differently then it's addressed variants. The test Bo Zimmermann did confirms this on real hardware.

The Steering Committee confirmed that the current implementation in the core is the correct one, and that we will add documentation to the user-guide to reflect this and avoid further questions.

See also the [65CE02 documentation](https://web.archive.org/web/20221112231057if_/http://archive.6502.org/datasheets/mos_65ce02_mpu.pdf) (the 4510 is based on a 65CE02 core):

> The BIT (IMMEDIATE) test will set the N and V flags
> with valid states, which was not the case with earlier
> 65C02s.

xemu-mega65 will be changed to mirror the behavior of the MEGA65 core.

Closed 2023-12-13.

Thread 531 (2022-02-05):

Enable mounting of D64 disk images

gardners, 2022-02-05:
We currently support D81 and D65 images. It would be good to support D64 and D71 images.
Bitshifter already has working CBDOS modifications to support these, but the hardware disk image handler needs to know about the new sizes of these images, so that it doesn't allow read or write beyond the end of the disk image.

$D68A bit 6 = D64/D71 enable for disk 0
$D68A bit 7 = D64/D71 enable for disk 1

Combining D64 bit with MEGA Disk bit = 1571 image. So now we have D64, D71, D81 and D65 disk sizes using two bits per drive... once I implement it.

lydon42, 2022-06-13:
Open: HYPPO needs to allow the attaching of D64 images. This currently fails because there is a size check.

gurcei, 2022-06-17:
I've committed a few tweaks to the `d64_support` branch to get it to accept d64 files in hyppo and the freezer.

I can now see the .d64 files in the diskchooser menu, but the disk preview elements within show up as corrupted:
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

To my surprise, if I mount some .d64 images while in c64-mode, I can list their directories (not all the time, some d64s work like this, others don't).
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

But regardless, I'm unable to load files within the disk at present.

I cherry-picked two of @gardners' commits in relation to #531 that he had on another branch and built a core with them, but still didn't help.

We can revisit this later when there's time to iron things out further.

dansanderson, 2024-07-01:
Status update: A previous attempt to enable D64 support in the ROM (920381) caused some weird issues in edge cases and was rolled back. I am testing a roll-forward of the ROM change atop ROM beta 920402, and along with core release v0.96, an affected case that could be reproduced in core v0.95 ROM 920381 cannot be reproduced in core v0.96 and a new ROM. We don't have an explanation; my closest guess is something in the core wasn't being reset before and now is, though this doesn't explain why this case appeared to persist state across a cold boot (!). I'm doing extra end-to-end testing on this change, then will be re-releasing the ROM side as a new ROM beta.

> the hardware disk image handler needs to know about the new sizes of these images, so that it doesn't allow read or write beyond the end of the disk image.

Just to confirm, has this part been implemented?

If we're satisfied with the core, Hyppo, and Freezer changes for D64 support, then this issue can be resolved. ROM issue https://github.com/MEGA65/mega65-rom-public/issues/45 tracks the implementation and release of the ROM change.

lydon42, 2024-07-02:
> > the hardware disk image handler needs to know about the new sizes of these images, so that it doesn't allow read or write beyond the end of the disk image.
>
> Just to confirm, has this part been implemented?

Looking at [99db06f](https://github.com/MEGA65/mega65-core/commit/99db06fb9ad883a6bd8705ffdeed477d55bdf165) I would tend to confirm this:
`
        if f011_d64_disk='1' and (f011_track >34) or (f011_track = 34 and f011_sector > 2) then
          -- Past end of D64 image, point to first sector instead
          diskimage1_offset <= to_unsigned(0,17);
        end if;
`

lydon42, 2024-08-15:
Got some positive feedback from discord with development and 920407, closing.

Closed 2024-08-15.

Thread 542 (2022-05-15):

Unify date/time display and entry between tools

dansanderson, 2022-05-15:
The configuration screen's RTC setting interface displays the current value of the clock, time and date. The date entry expects the format YY-MM-DD, but does not enforce value ranges. If someone misunderstands the date format and enters MM-DD-YY values, it accepts them, but then some date displays like the BASIC title screen show a corrupted value. The config screen doesn't indicate that there's an issue: it just prints the date as it was entered.

Ideally the config screen would display the expected format alongside the field value, and also enforce ranges. I understand enforcing ranges properly requires deeper logic and UX, but even hard-coded limits of 99, 12, and 31 could be useful. Short of enforcement, a warning message would help.

A "20" before the year value would also be a big win, I think.

On-boarding sets the time using a very different interface. I don't know if any changes are required there.

lydon42, 2022-05-29:
I agree, Date and Time ranges should be enforced by configure.

lydon42, 2022-08-13:
The way time and date is entered and displayed should be unified. This will be decided in the next steering group meeting.

Onboarding uses `HH:MM:SS dd/mmm/yyyy`
Configure uses `HH:MM.SS yy.mm.dd`
ROM displays `dd-mmm-yyyy HH:MM:SS` on startup as well in TI$ and DT$

lydon42, 2022-08-21:
Confirmation by steering group: `HH:MM:SS dd/mmm/yyyy` we will go for and implement in all configuration tools.
In addition range checking should be implemented as much as it is possible. Full leap year day limiting is not a requirement.

Closed 2022-09-24.

Thread 544 (2022-05-17):

Ugly scroll in C64 mode

fredrikr, 2022-05-17:
I ran a small Basic game in C64 mode on the MEGA65 core (the core version that was shipped with my MEGA65, serial no 311) and the scrolling of the color memory seems to be out of sync with the scrolling of the screen memory, i.e. when the text scrolls up sometimes part of a character flashes in the wrong colour. I tried the same game on a real C64C PAL and it doesn't happen there. Attaching the game.

[torpedo.zip](https://github.com/MEGA65/mega65-core/files/8706550/torpedo.zip)

HovKlan-DH, 2022-05-17:
Did you try to update the ROM to the newest version, 920350? So many ROM changes since the factory default version.

fredrikr, 2022-05-17:
I installed the latest core and the latest ROM. It still happens, but maybe less frequently than before. I also changed my display from HDMI to VGA - could that be a factor?

Edilbert, 2022-05-30:
ROM changes are done for the MEGA65 mode, not the C64 mode.
The C64 mode is not fully compatible with a real C64 for several reasons:
Illegal opcodes do not work as expected, they are now real opcodes for new instructions.
Access to units #8 and #9 is intercepted and handled by CBDOS, not the IEC bus.
Tape routines are removed to make room for bank switching CBDOS calls.

fredrikr, 2022-05-31:
I'm fully aware of that.

I just thought this seemed to be a thing that could be improved in the scrolling routine.

Edilbert, 2022-05-31:
I get already a lot of complains, because I change the MEGA 65 part of the ROM,
which, sometimes inevitable, sometimes by chance introduce incompatibilities.

I'll not touch the ROM part for the C64 mode.
If I would do that, I know, that I would be blamed for every issue, that pops up and there are many already.
But these are currently all heritage of the Commodore 65 developers,
so these are not my business and I can focus on BASIC 65 and CBDOS.

fredrikr, 2022-05-31:
Ok. I certainly didn't mean to complain. I know you've done a great job and you keep at it. Closing this.

Closed 2022-05-31.

Thread 546 (2022-05-19):

Zero-byte at end of command string to drive breaks

fredrikr, 2022-05-19:
Using assembler in C64 mode on the MEGA65 core, I sent a command to the drive: "U1 2 0 1 0" + zero byte. (Read track 1 sector 0 on drive 0, send results to channel 2). Adding the zero byte at the end is incorrect, but doing this still works on a real 1541 or 1581 drive, or an emulated drive in Vice. Here, it makes the drive return seemingly random data instead of the data that is actually in track 1 sector 0.

I realize fixing this may not be a top priority, but I thought I'd share it anyway, as it may stop some C64 programs from working.

I used the current core and current ROM as of 2022-05-18.

lydon42, 2022-10-02:
For one: it is not expected that the C64 mode is fully C64 compatible.
On the other hand a real core version (recheck with RC1 or upcoming RC2) would be great, and an example program would alos be great. And if you know if a pi1541 will handle this correctly, because this is the only IEC device I currently have attached (1541 and 1571 are broken/dirty/no disks :) )

Thread 552 (2022-05-28):

Hyppo / Config run in HDMI mode even if DVI only is configured

lydon42, 2022-05-28:
Reported by @dananderson as https://github.com/MEGA65/mega65-rom-public/issues/4

**Test Environment (required)**
 - Platform: MEGA65
 - ROM Release: 920355
 - Core Commit: bdeeb15

**Describe the bug**
The "Enhanced" (sound enabled) DVI video mode does not work with DVI-only displays, which is why it is an option in the configuration. However, it appears that several of the pre-config menus, including the Hypervisor, core menu, and the config menu itself use "Enhanced" mode. This breaks these screens on DVI-only displays, and prevents the user from accessing the config menu to change it for the rest of the machine.

As I understand it, DVI-only mode should show a correct picture on all displays using the DVI output, including modern HDMI displays that otherwise support sound. Hypervisor et al should use DVI-only mode.

**To Reproduce**
Steps to reproduce the behavior:
1. Connect a DVI-only display. I'm using a Dell 2001FP and an HDMI-to-DVI video cable.
2. Hold Alt, then turn on the MEGA65.

**Expected behavior**
The Hypervisor Alt menu should display correctly. Instead, it behaves as if in "Enhanced" video mode.

The only workaround I know is to connect a VGA display to access these menus. It so happens that the Dell 2001FP has both VGA and DVI inputs, so I keep both connected and switch between them as needed. I now realize that this would not be necessary if these menus used DVI-only mode.

lydon42, 2022-05-29:
Someone needs to test this, my DVI monitor can't handle the MEGA65 signal.

dansanderson, 2022-05-29:
If there's a candidate fix I'm happy to test an experimental core where I can reproduce this issue.

cwscws, 2022-06-06:
Would be very much interested in a fix. Using VGA at the moment but would prefer DVI. Unfortunately black screen when in config/core select via DVI.

Would a fix be applied with a Mega65 core update?

lydon42, 2022-06-06:
I can reproduce it, probably happens because config is read after start of mega65_config.prg

lydon42, 2022-06-06:
Try the following (works best if you also have VGA connected to not have to write blindly):
```
Boot with ALT, press 1 for configure.
MEGA-TAB
s777d61a 02
```
now DVI should show a picture.

I can't fix it with a HICKUP, as it seems, as the startup stuff all comes from unmodified core in slot 0. And fixing mega65_config will also require reflashing of slot 0. So there is probably no workaround without flashing slot 0.

Problem is hyppo/main.asm - safe_video_mode, which sets $d61a to 0 instead of 2. Possible fix is also to add a sta of 2 to §d61a in init of mega65_config.asm.

dansanderson, 2022-06-06:
I can confirm that s777d61a 02 restores a configuration screen on the DVI display.

Are there plans to ship batch #2 machines with an updated core 0? In theory this bug locks out users with DVI-only displays, but I don't know how big that user base is, and in practice most DVI-only displays also have VGA analog inputs and we can coach those users toward the workaround of using both inputs. I'm more inclined to recommend "use a VGA or HDMI display for config" as the workaround than "get a special difficult-to-find cable and carefully overwrite core 0." If we have the opportunity to prepare a new factory core for batch #2, I'd prioritize this fix.

dansanderson, 2022-06-06:
P.S. I do have a full JTAG adapter and I'm willing to try a new core 0 to test. I'd need instructions.

lydon42, 2022-06-07:
fix core created, testing with @dansanderson

dansanderson, 2022-06-07:
Testing successful. The fixed core runs boot menus in DVI-only video mode.

The fixed core must be in slot 0 to run the core selection menu in DVI-only mode. We verified this by first testing the fixed core in slot 1 (ALT utilities worked, NO SCROLL core selection still did not), then flashing it to slot 0 via JTAG (both ALT and NO SCROLL utilities work).

cwscws, 2022-06-07:
Great! But have no JTAG adapter. And it was said that nobody should mess with slot 0...

lydon42, 2022-06-07:
@cwscws  flashing slot 0 is possible without JTAG. It is just more dangerous, because if the flashing goes wrong, you will have no way to get the MEGA running again. So we advice against this. We will be discussing this topic in an upcoming meeting.

cwscws, 2022-06-07:
I think it would be better to wait for a more stable core before flashing to slot 0. VGA works anyway, DVI would just be a nice bonus.

Closed 2022-06-07.

Thread 553 (2022-05-29):

CMD swap button compatibility

oe3gwu, 2022-05-29:
**Test Environment (required)**
You can use [MEGA65INFO](https://files.mega65.org?id=3eeb7d82-8bd7-44b7-82b6-cef29d123b0e) to retrieve this.
 - Platform: MEGA65
 - Core Commit: 7C5281E
 - ROM Release: 920357

**Describe the bug**
CMD FD-2000 and CMD-HD Swap Buttons dont work properly. This button swaps the CMD Jumpered Drive Number with the internal drive 8. It works on real hardware, aswell aus the Ultimate 64. However, if you press the button on the MEGA65, nothing happens. A workaround is, that you can reconfigure the internal drive to an unasigned number, then the swap button works.

**To Reproduce**
Steps to reproduce the behavior:
1. Turn on the MEGA65
2. Click the swap button
3. Swap LED does NOT light up.

**Expected behavior**
The internal drive 8 and the jumpered drive letter from the CMD drive should swap positions.

**Additional context**
If I get my hardware back, I can support with a Read Admiral FD-2000 Drive (CMD FD-2000 Clone).

lydon42, 2022-05-29:
Is this related to #554 ?
Does the drive itself work?

oe3gwu, 2022-05-29:
No I use damaged drives all time time. Of course they work and work perfect on my Ultimate 64 Elite.

gardners, 2022-05-30:
The reason that this doesn't work, is that the CMD swap button works by breaking the IEC standard, by temporarily becoming the bus master -- which only the computer is allowed to do -- and then connecting to whatever drive is on the other device ID, and instructing it to change it's device number, and then the CMD device changes its device number internally as well.

This never worked on any of the Commodore 65 prototypes because the C65's internal drive is _not on the IEC bus_.  The C65 KERNAL doesn't listen for IEC commands from another bus master.  In fact, it _can't_ listen for IEC commands from another bus master, because the ATN line is output only on the C65 (and the C64, for that matter).  So there is no way for a C65 to know that the CMD device is trying to take over the world temporarily (for the purposes of good of course ;).

Even if the C65 were physically able to watch for this situation, it would only work while the KERNAL was active.  It would mean that the KERNAL would have to be running an interrupt _very_ frequently to watch for the ATN line mysteriously going low.  The instant you were running software that disabled the KERNAL and used its own interrupt routines (i.e., a very large fraction of all software), it would also cease to work.

The MEGA65 has exactly the same function here as a C65, and thus the CMD drive swap button will only work with IEC connected drives. The MEGA65's internal drive is, just like in the original C65, not on the IEC bus, and so all of the above discussion still applies.

The only way to fix this would be to make the MEGA65 do the drive swap function, instead of the CMD drive breaking the IEC protocol to do it.

The FD2000 manual (eg from ftp://cbm8bit.com/hardware/manuals/CMD-FD2000-Manual.pdf) confirms that this is how the drive swap button works (top of page 15):

"SWAP can be used even if you do not already have a device 8 or 9 on the serial bus. In this case, the FD simply becomes device 8 or 9 without affecting any other devices on the bus."

It's a little vague, but the clear implication of what they are saying is that if the FD2000 doesn't find another device on the IEC serial bus, then it will just switch to the swapped device number.  This is exactly what happens with a C65 or a MEGA65 (or for that matter, a C64 with an REU ram disk on device 8, or anything else on device 8 that is not on the IEC serial bus).

The key give-away here is "without affecting any other device on the bus" -> The FD2000 drive swap can by its own admission only affect other devices on the IEC serial bus. The C65 and MEGA65's internal drive is not on the IEC serial bus, but is rather directly on the processor's address and data bus, and it appears on device 8 because the KERNAL intercepts accesses to that device number before they even hit the IEC bus -- just like an REU ram disk would.

So as much as it would be nice to support the CMD drive swap buttons, this is not physically possible.  The work-around is to use the freezer or other means to shove the internal drive off of device 8.  It would also be possible to implement a function in the freezer that does the swap. You are welcome to implement this, as I am sure a number of people would appreciate it.

But as for the original issue, it is not possible.

Closed 2022-05-30.

Thread 554 (2022-05-29):

1581 Game Compatibility

oe3gwu, 2022-05-29:
**Test Environment (required)**
You can use [MEGA65INFO](https://files.mega65.org?id=3eeb7d82-8bd7-44b7-82b6-cef29d123b0e) to retrieve this.
 - Platform: MEGA65
 - Core Commit: 7C5281E
 - ROM Release: 920357

**Describe the bug**
There is a website for download converted games to 1581 (D81) format. However, 2/3 of the games stall in loading. Like Test Drive II. After detecting the drive, nothing happens - just before the Accolade Logo. Be aware, the icons on the website dont work anymore, but the download links are still valid.

I got those images on CMD-2000 FDD's. Due to a Freezer Bug, I cant mount the game via the C64 Freezer Menu.

The Disks work perfect using a real C64 or a Ultimate 1541 Elite.

http://members.optusnet.com.au/spacetaxi64/MAIN/1581-GAMES.htm

**To Reproduce**
Steps to reproduce the behavior:
1. Turn on the MEGA65
2. Mount the Test Drive II D81
3. Load the game
4. Change cheat options as you want
5. N0S Loader will detect the Image (od Drive)
6. Loading stalls

**Expected behavior**
Game should work

gurcei, 2022-05-29:
I've also found slme c64 releases a bit problematic to load up. I do recall someone saying to try choose versions of software released by groups like REMEMBER, as they didn't use any illegal instructions in their code. I wodner if that will help (I haven't tried on my end).

If illegal instructions are a necessity though, they are available via the pure C64 core.

lydon42, 2022-05-29:
Please clarify: are we talking about real disks that are read in some IEC attached drive? Or real disks written with this CMD-2000 and then read in the internal drive?
Or is this a problem that the specific game does not work? That's no problem, it is expected that not all C64 games will work in C64 mode.
If we are talking IEC device problems, that could be an core issue.

oe3gwu, 2022-05-29:
Real disks, I use a Rear Admiral FireDrive 2k.

Thread 555 (2022-05-29):

REU Builtin

oe3gwu, 2022-05-29:
**Is your feature request related to a problem? Please describe.**
No

**Describe the solution you'd like**
D81 Images sometimes tend to load them into RAM. This is true for Sonic the Hedgehog for example. So a REU Support should be added. But dont get me wrong, I am not willed to use a REAL REU Brick on an FPGA Computer. It would be nice to have it built in.

**Describe alternatives you've considered**
I tried to use my real REU Cartridge, but it doesnt work. I am not developer enough to debug this, however the commands that are added from the REU to Store and Fetch Data arent working either.

lgblgblgb, 2022-05-29:
@oe3gwu REU is a C64 "thing". So you can't expect too much to be in the mega65-core. It is more suited for the C64 core, but this "issues" section is for mega65-core, not the C64-core (also called "alternative cores", C64-core being one of them). The MEGA65 style solution for this problem is to fill the hyperRAM ("Attic RAM") which is 8Mbyte in size (you can use even BASIC65's `BLOAD` - I believe - to load things there). MEGA65-core's C64 compatibility is limited by design as C65's one too (and MEGA65 based on the C65 design). That is the reason for better C64 compatibility, a dedicated C64 core should be used, it's a common mistake to think that MEGA65-core should be 100% C64 compatible (even then' MEGA65's "C64 mode" is way more C64 compatible than C65's, but because of reasons I mentioned it won't be ever 100% and it's not even the goal, that's more a C64-core territory). Otherwise of course it wouldn't hurt to have REU in the MEGA65-core as well, however the problem that it's impossible to do: mega65-core internal memory decoding and its timing is so much overloaded, that it's about virtually impossible to try to "force in" even more things in this respect, at least currently.

oe3gwu, 2022-05-29:
Well it is a MEGA65. The C64 core is builtin the MEGA65.ROM, so this is a MEGA65 issue. The REU Units can also be used for the C128. So why not the M65?

lgblgblgb, 2022-05-29:
Oh, no, there is a big misunderstanding here. C64 core is not builtin the ROM! The core itself what configures the FPGA to use routings between its logic blocks, LUTs etc to routed in a given way, ie a creating a "hardware circuit" inside the FPGA using its resources. That is what mega65-core's or the C64-core. The ROM is only a software running on top of the hardware (in our case, on the hardware created inside the FPGA). MEGA65's "C64 mode"  you see after "GO64" is nothing to do with the C64-core! It's a C65 "legacy" and it just does that the MEGA65-core and its created hardware gets settings in I/O register to try to mimic the defaults of a C64 more or less (like, setting VIC-IV to have 40 column display etc, but it's still a VIC-IV and not VIC-II! So won't be even _ever_ 100% C64 compatible just more or less ...). At the other hand, C64-core is a core, which sets up the FPGA to implement a totally different internal logic for implementing a C64 computer. Cores needs to reconfigure the FPGA. Thus, for having a simple example, core is like having a C64, C16, Plus4 etc so the hardware itself (just in MEGA65's FPGA case, it can be altered since it's an FPGA not a fixed PCB with fixed chips like a real C64 or C16, etc ...) while ROM is only a software running on the hardware, it cannot be a "core" since it's software and not hardware (I mean the ROM content, for sure in a C64 ROM itself is also a chip ... I didn't meant that).

Hopefully it helped to cure the misunderstanding here what a core is. Even with my bad English :) C64-core is a totally different entity, with its own core files needed to be uploaded to the FPGA to re-create a C64 not a MEGA65 hardware inside the FPGA.

oe3gwu, 2022-05-29:
Well, I am no developer. As User I just would like a REU Support. I need it for many operations on the C128 too. This is a basic function that EVERY other FPGA C64 has got.

If this is thr wrong place, then tell me where to put it.

lgblgblgb, 2022-05-29:
Yes, absolutely, I will discuss this "wish place" idea with the others which is not mega65-core topic strictly. However the other key factor here that you wrote: "This is a basic function that EVERY other FPGA C64 has got". Well mega65-core is not a c64 core. That would the the alternative C64-core but not the mega65-core. So mega65-core is not needed to be C64 compatible at all. As I've said even the "Go64" is still not the C64-core, it's a C65-legacy (you can say mega65-core is a C65 - not C64 - core though with large amount of own inventions meanwhile to become the MEGA65 now) to provide a very basic level of C64-like environment more or less, without real "strict" C64 compatibility. For a better C64 compatibility, surely another FPGA core should be used, like the C64-core I mentioned now several times, not the mega65 FPGA core.

oe3gwu, 2022-05-29:
Well if it is no C64 and I shouldnt have any hopes that C64 functions are added, you should remove it entire. I mean I am very frustrated now. I gonna shelf this project. If nothing changes the next month, I just sell it. I am out, completly!

lydon42, 2022-05-29:
This is not a MEGA65 issue. The C64 core has REU on the roadmap.

gardners, 2022-05-30:
Also, it must be said, that there is already partial implementation of the REU in the MEGA65. It may well get completed at some point, but requires someone with the time and energy to tackle it.  You are welcome to contribute to this. I will provide support, but it will require someone who knows (or is willing to learn) VHDL.

Now, in terms of removing the "GO64" and the C64 mode of the MEGA65 -- this makes no sense: What we have, is exactly what the C65 had in this regard, a _partially_ compatible C64 mode for _partial_ compatibility with existing software and _some_ hardware. The C65 Specifications Manual document from Commodore is quite explicit about this. I think they call it "moderate compatibility" with hardware.  In fact, you couldn't even _physically fit_ a C64 REU in the C65's cartridge port, because the C65 had a Plus/4 style cartridge port instead. So we have already improved the hardware compatibility with the C64 quite a lot!

A more fruitful approach would be to patch any software that expects an REU to instead use the MEGA65's DMA controller and Attic RAM.  This would not be particularly hard to do for most titles.

gardners, 2022-05-30:
Also, please remember that we have been totally up-front that the MEGA65 is a _community work in progress_. It gets better by everyone contributing. If you were looking for a machine that was finished from day 1, then I am sorry, the MEGA65 is probably not the machine you were looking for.  If on the other hand you have patience, or the desire to learn how to solve some of these rough edges, then you will have a great time along with the rest of us. But that is not a decision we can make for you.

Closed 2022-05-29.

Thread 556 (2022-05-29):

Kung Fu Flash Cartridge doesnt work correct

oe3gwu, 2022-05-29:
**Test Environment (required)**
You can use [MEGA65INFO](https://files.mega65.org?id=3eeb7d82-8bd7-44b7-82b6-cef29d123b0e) to retrieve this.
 - Platform: MEGA65
 - Core Commit: 7C5281E
 - ROM Release: 920357

**Describe the bug**
Kung Fu Flash is a software defined cartridge. The last configured CRT or PRG will automatically start. This works fine. However, if you want to reset the MEGA65 through the reset button, a blue screen appears. If you want to go to the freezer menu and load an other software, the screen scrambles and the MEGA65 hangs. Again works perfect on the Ultimate 1541 Elite.

**To Reproduce**
Steps to reproduce the behavior:
1. Turn on the MEGA65
2. Click the Menu or Reset Button on the Kung Fu Flash

**Expected behavior**
Freezer and Reset should work.

**Screenshots**
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

**Additional context**
If I get my cartridge back, I can ship it to a developer for debugging.

lydon42, 2022-05-29:
This is a #564

Schwefelholz, 2024-08-18:
On my R3A using cores RC fb7e8f0 and 0.96 Release, I cannot get my Kung Fu Flash to run at all.
I just get the second clean blue picture as shown in https://github.com/MEGA65/mega65-core/issues/556#issue-1251851024

nobruinfo, 2024-08-18:
On R6 and da9b0fb and the earlier 0.96 3c10488 release core this just works for me.
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

https://github.com/user-attachments/assets/6e7295e9-ce3c-4f12-988a-f0e3a677f5c9

lydon42, 2024-08-18:
> On R6 and [da9b0fb](https://github.com/MEGA65/mega65-core/commit/da9b0fb8d02b224eeeafcca18f7049a09a60c434) and the earlier 0.96 [3c10488](https://github.com/MEGA65/mega65-core/commit/3c1048830bb6f543cb832049e969301a9a389fa2) release core this just works for me.

Just to clarify: the Cartridge does run in the C64 Core not in the MEGA65 core. But detection through MEGAFLASH works well, as the C64 core seems to be started automatically.

Pressing HELP will bring up the C64 cores menu, thats a clear indicator (but you did not press it in your video).

nobruinfo, 2024-08-18:
Yes, I didn't think of the [HELP] key.
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

paich64, 2024-08-18:
Kung FU flash observations on **R6**:

**With the C64 core V5.1** : It perfectly works, all buttons are working as expected.

**Without the C64 core** (i.e using the Mega65 core) :

- If a game was previously saved as the game to start (operation done when used with the C64 core), Then the cartridge the Mega65 core will boot the cartridge and launch the game.

- Now having the game launched, MENU & RESET button won't work correctly :

While a game is running, MENU will not come up when hitting the "MENU" button. instead the game freezes and the left/right borders are flashing really fast.

The only workaround to access the MENU (while having the game frozen and left/right borders flashing) is to reset the MEGA65 with the Mega65 reset button.

As soon as the Mega65 resets, it boots the cartridge and display the KFF menu.

It's possible to navigate in the menu, but trying to load a game will fail [black screen] (Normally the KFF flash cartridge is supposed to load the game in memory and start it)

- The RESET button won't work : instead of resetting, it will freeze the game. Any attempt to reset the Mega65 with the Mega65 reset button will result in the Mega65 resetting but not booting the cartridge.

Instead we get to the Basic 65 prompt. We need to power cycle the Mega65 to having it booting the KFF again and the Game (already launched when using the C64 core) will start immediately.

What it means : It means that **on R6 with the MEGA65 core, the KFF partially works but it barely unusable since it's not possible to launch a game.**

Kung FU flash observations on **R3/R3A**:

**With the C64 core V5.1** on R3A, It's already known as not capable of working as expected because of the Cartridge Lines limitations in R3A

Read https://github.com/MJoergen/C64MEGA65/blob/master/doc/cartridges.md in which the is a section which clearly states :

_The circuits of the MEGA65's R3 and R3A boards are not able to detect the KFF's signals properly. Therefore you need a workaround to work with the KFF. It takes a bit of practice to get the timing right, but as soon as you are getting the hang of it, you can work very well with the KFF and the C64 for MEGA65 core_

Personally i can't experience on R3A since i have a problem with my cartridge port. Even the explained workaround won't work for me.

**Without the C64 core V5.1**

For the same reason I can't experience on R3A

lydon42, 2024-08-18:
So the todo here would be: get Kung Fu flash working on r6 with the MEGA65 core. Possibly so that a M65 style CRT can be used with it.

Schwefelholz, 2024-08-18:
> So the todo here would be: get Kung Fu flash working on r6 with the MEGA65 core. Possibly so that a M65 style CRT can be used with it.

From my perspective it would be better to use an EF3 instead of a KFF for that, because I actually can boot an EF3 with the M65 core on as R3A...
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

Thread 558 (2022-05-29):

Add support to upload different ROMs like JiffyDOS, JaffyDOS, SpeedDOS, ExOS, ...

oe3gwu, 2022-05-29:
**Is your feature request related to a problem? Please describe.**
No

**Describe the solution you'd like**
I would like to use a JiffyDOS ROM on the C64 Side. It would be nice to have to one big MEGA65.ROM but different ROM's. One for the MEGA65, and one for the C64 Side.

**Describe alternatives you've considered**
The real C64 ROM is just slow to load stuff and annoys me now the same way as in the past.

lgblgblgb, 2022-05-29:
@oe3gwu So as far as I can see, it's more like C64-core request. MEGA65's C64 mode anyway uses CBDOS thus for the internal drive (and for "D81 mount") it's nothing to do with the IEC bus, these solutions won't even work (as these "fastloader" solutions are for speeding up the IEC bus communication between the computer and the drive on the IEC bus). MEGA65-core is based on the C65 design thus not using IEC bus at all for its internal drive access + D81 "mounting".

For sure, in theory you can you can use an IEC bus drive with the MEGA65 + mega65-core, indeed, when it can be useful, that's true. But having a custom C64 ROM in "C64 mode" of mega65-core would lose all possibility to access the internal drive and SD-card D81s from C64 mode. Thus it's more a sane solution for the C64-core, in my opinion at least.

lydon42, 2022-05-29:
The C64 core will be able to load other ROMs, as the MiSTer can, it is on the roadmap.
I am unsure how this will translate to the MEGA65 core. We need to discuss this.

Edilbert, 2022-05-30:
The C64 mode of the MEGA65 uses CBDOS for the internal drive and the SD-Card images.
This is way faster, than any IEC bus solution, like Jiffy-DOS and others.
Alternative ROMs like JiffyDOS don't know about CBDOS. The internal floppy drive and SD Card images couldn't be used with such ROMs.

gardners, 2022-05-30:
Also don't forget that you can already use a C64 JiffyDOS ROM on the MEGA65 -- its just that it will then only boot into C64 mode, and will not be able to see the internal 3.5" drive or SD card or any other C65 or MEGA65 feature anymore, as the ROM will be managing the machine as though it were a C64. It _will_ however make your external drives load at JiffyDOS speed.  You can have multiple ROMs on the SD card named MEGA651.ROM through MEGA659.ROM, and use those on a boot-by-boot basis by holding down the number keys 1 through 9 when resetting the MEGA65. Thus you can easily switch between the normal MEGA65 ROM and the JiffyDOS C64 ROM based on what you want to do at the time.

In the alternative, you are welcome to offer assistance at completing the JiffyDOS support in the MEGA65's ROM.

oe3gwu, 2022-05-31:
Ok I understand!

I have to try this. I wasnt aware, that different ROM's were already compatible already with the MEGA65.

Thank you!

Mikey351AU, 2023-01-27:
> Also don't forget that you can already use a C64 JiffyDOS ROM on the MEGA65 -- its just that it will then only boot into C64 mode, and will not be able to see the internal 3.5" drive or SD card or any other C65 or MEGA65 feature anymore, as the ROM will be managing the machine as though it were a C64. It _will_ however make your external drives load at JiffyDOS speed. You can have multiple ROMs on the SD card named MEGA651.ROM through MEGA659.ROM, and use those on a boot-by-boot basis by holding down the number keys 1 through 9 when resetting the MEGA65. Thus you can easily switch between the normal MEGA65 ROM and the JiffyDOS C64 ROM based on what you want to do at the time.
>
> In the alternative, you are welcome to offer assistance at completing the JiffyDOS support in the MEGA65's ROM.

Hi Paul,

What are the requirements to create a MEGA65x.ROM file for a Jiffy C64 mode. I guess it will need to contain basic+jiffykernal+char rom ?

Mike

dansanderson, 2023-02-02:
MEGA65.ROM is an uncompressed binary file that gets loaded into 3.000-4.FFFF by the Hypervisor. The segments of the ROM follow the C65 layout documented in the manual, with DOS and C64-mode ROM regions in the first half. Registered MEGA65 owners can get read access to the Closed ROM source repo (MEGA65/mega65-rom) if you want to look at the source. You can modify it, build it, and generate binary diffs for distribution. (The complete ROM cannot be distributed freely because it contains licensed material. End users can reconstruct the ROM with the M65Connect tool and the official C65 ROM distributed for free by Cloanto.)

Alternatively you can prepare it as a runtime patch with a loader routine that disables the Hypervisor write protect. It might be challenging to keep it up to date with future ROM changes, but runtime patching might be an interesting way to offer it so it can be something that an end user can just load from a boot disk.

Closed 2024-09-10.

Thread 561 (2022-05-29):

(S)FTP Client builtin

oe3gwu, 2022-05-29:
**Is your feature request related to a problem? Please describe.**
No

**Describe the solution you'd like**
I would love to have an FTP Client to native connect to the Filehost and get online COR and Kernel Updates. Also maybe connect to 3rd party FTP for File Download.

**Describe alternatives you've considered**
I currently do this via a PC: It works, but still ...

**Additional context**
None.

lgblgblgb, 2022-05-29:
@oe3gwu As with #562 this is a software not so much a mega65-core idea/bug itself. This one would be indeed very useful and even planned in theory, however the same issue as with #562 that the team is more focusing now with the hardware platform itself, and the mega65-core, and even "only" this totally overloading everybody. However as I wrote at the other issue as well, MEGA65 is a community effort, so of course we would be very happy to take this job, let it be you, or anybody else. Surely maybe in the future of "more relaxed time" it's quite possible that even team members will have more time to do things like this as well. Of course personally I would like to do things like this (as well). However time is always the limiting effort, as it's just a non-profit hobby for all of us. And I totally agree, it would be a very cool feature not to need to have a PC for this task, but doing it on the MEGA65 itself only :D :D

oe3gwu, 2022-05-29:
I understand that this has no priority. :-)

lgblgblgb, 2022-05-29:
Btw, I really think, we should create a software-idea kind of bug tracking / wish-list place as well, at this point :D Do not misunderstand me, all ideas counts and useful (and should be remembered), just maybe would be better to have the correct place for those, much easier to have an overview and even making people's life easier who want to contribute to an idea with some actual work. But this _my_ opinion now, not the team's common one, so stay tuned please.

oe3gwu, 2022-05-29:
Thats a good idea.

lydon42, 2022-05-29:
Again, no core related feature, but a an application. Probably to be integrated into the freezer or as an standalone option.
There are already thoughts going around (@gardners ) implementing an ethernet based alternative to the JTAG interface. But again this does not need additional support from the core.

Yes, we will thing about a better way to create overarching feature requests that can't be easily assigned to on specific MEGA65 repository. And it's not helping that we can't move issues...

gurcei, 2022-05-29:
Understanf this is off-topic to mega65-core, but still thought it was worth a mention that maybe the mega65_ftp tool can help you scratch that itch a little bit. While it is still a pc-based tool, it does have commands like `fh` and `fhget` that retrieve files directly from the filehost and transfer them onto your sd-card (via the serial/jtag connector). If you'd like more info/details on this, happy to talk it over further on the discord chat server.

Closed 2022-05-29.

Thread 567 (2022-06-06):

Flasher should ignore dotfiles

dansanderson, 2022-06-06:
**Test Environment (required)**
 - Platform: MEGA65
 - Core Commit: bdeeb15
 - ROM Release: 920364

**Describe the bug**
When installing a new core from the core menu, the core file selection screen duplicates every .cor file with a similar entry with an odd character at the beginning of the name. The "file" with the odd character is not a real core. Selecting it will warn that the device ID doesn't match, but the user can continue to write the errant file to a core slot.

**To Reproduce**
Steps to reproduce the behavior:
1. Prepare a microSD card in the MEGA65. Move it to a PC, copy some valid .cor files onto it, then move it back to the MEGA65.
2. Turn off the MEGA65, hold NO SCROLL, then turn on the MEGA65. The core selection menu opens.
3. Press Ctrl + 2 (or any numbered slot). The core file selection screen will display.

**Expected behavior**
Only the actual .cor files should appear in the menu.

**Screenshots**
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

**Additional context**
I manipulate my SD card with a macOS computer. I don't think it's a Mac-specific artifact but I could be wrong.

The errant file entry does not appear when the SD card is mounted to a PC (or at least not on my Mac).

lgblgblgb, 2022-06-06:
Just a comment and guessing here: can it be an LFN issue? Ie, if not DOS short name compatible names are used (8 + 3 characters, upper case only, US-ASCII only) then an LFN entry is created for the filename as well.

gurcei, 2022-06-06:
I'm wondering if it is a file with a dot at the start of the file (hence hidden from view, perhaps visible by doing an `ls -lha`?)

dansanderson, 2022-06-06:
Aha, @gurcei wins the prize! These are macOS resource fork files with names like `._C64MEGA65-1-R3.cor`.

This is now a feature request to have the core file selector ignore dotfiles. (LFN support is always good too but for this issue it's about the dotfiles.)

lydon42, 2022-06-07:
This requires LFN support in both hyppo and qspiflash, because DOT is no valid DOS filename character.
Postponed until LFN works @gurcei

lydon42, 2023-06-09:
683-cartflash already should not show those files anymore.

lydon42, 2023-06-16:
Check with a image provided by @dansanderson shows that the changes seem to be sufficient.

Closed 2023-06-16.

Thread 570 (2022-06-07):

In the Freezer when choosing new D81 or D65 Image - System Hangs

oe3gwu, 2022-06-07:
**Test Environment (required)**
You can use [MEGA65INFO](https://files.mega65.org?id=3eeb7d82-8bd7-44b7-82b6-cef29d123b0e) to retrieve this.
 - Platform: (MEGA65)
 - Core Commit: (187-899CF4F)
 - ROM Release: (920365)

**Describe the bug**
When I enter the FREEZER (0.1.4) and want to create a new D81 or D65 Image, the System hangs. Border color changes sometimes to red or black.

**To Reproduce**
Steps to reproduce the behavior:
1. Go to the FREEZER
2. Click on 0
3. Choose new D65 HD Image
4. System hang.

**Expected behavior**
A new Image or a Dialog with a Filename.

**Screenshots**
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

dansanderson, 2022-06-07:
I'm also having an issue with D81 disk image creation, but I make it to the name prompt and the "Creating..." message with the flashing border. It flashes like it's doing something but never finishes. Note that this appears to be a regression in newer firmware/FREEZER.M65 because I was able to do it "before," but I haven't tried looking for the version that broke it yet.

Should we track these as separate issues?

gurcei, 2022-06-08:
Had another debug session just now on my devkit, some further notes here:
- https://discord.com/channels/719326990221574164/984239895918837791/984239899446222878

On this occasion, I noticed the system tried to load the `MAKEDISK.M65` file from the sd-card but failed.

When I took a look at my sd-card, it indeed was missing.

After adding the `MAKEDISK.M65` file onto the sd-card and trying again, I finally got the popup window offering me to type the filename:
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

So I'm wondering if it's possible that this file went missing on your sd-cards too perhaps?

As for why it might have happened, not sure. I thought perhaps some of you may have prepared your own sd-cards anew via the mega65 config menu's fdisk utility, and I wondered if it perhaps failed to extract out this `MAKEDISK.M65` file from the core? I noticed that in a screenshot from a past user, that the file was in there:
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

...but who knows, perhaps something went amiss with this pre-populating process in more recent cores?

gurcei, 2022-06-09:
I still had probs after adding MAKEDISK.M65. Upon debugging them, seemed like there was a bug when traversing dir-entry clusters. I provided more details and a new `MAKEDISK.M65` file that affected users can try on their sd-cards. Let me know if this resolves your situation or not:

https://discord.com/channels/719326990221574164/984239895918837791/984400989614407720

oe3gwu, 2022-06-09:
Thank you!

I will try this later today. Keep you posted here.

gurcei, 2022-06-12:
Ok, digging into this issue revealed another edge-case issue (if the last direntry of a directory is on the end of a cluster). This edge-case impacted both the hypervisor and makedisk, so I've added fixes to both and will roll them into my upcoming PR.

gurcei, 2022-06-13:
Ok, judging from the feedback from several affected users, feel like the fix for this is sorted now, the PR is still underway, but will close now.

Closed 2022-06-13.

Thread 573 (2022-06-09):

Sound Playback using PLAY never ends

iFlash, 2022-06-09:
When playing a melody using PLAY command and the sound is stopped with PLAY **before** it plays through, any further usage of PLAY is compromised: The volume is wrong (and can not be changed), the Envelope can no longer be changed, and the sound will not stop although "R" command is given and no looping is wanted.

gurcei, 2022-06-09:
It may be a core issue. @iFlash I'm wondering which SID you were using? 6581? Would it be possible to try switch to the 8580 SID (via ALT-powerup and go to config menu to select SID version).

It's just that I had observed odd behaviour on the 6581 lately, and I believe @gardners was underway with changes to that SID.

If that proves to be the case, lets re-open the issue here.

iFlash, 2022-06-09:
Platform: MEGA65
Core Commit: d71fa6b
ROM Release: 920365

If using a SID 6581 a melody is stopped prematurely by PLAY (without parameter) OR another PLAY in the same channel starts before the end of the melody, the sounds will never end and play in different envelope, volume etc. The sound can not be changed by any PLAY commands. PLAY without parameters will stop the sound, but when started again it will still play with different volume etc. and will not stop on last note, i.e. the last note of the melody will play forever. Change in volume, envelope will have no effect.

If using a SID 8580, the sound will not get as much corrupted if stopped with PLAY"" but the tone currently playing will never end. And the MEGA will crash if only PLAY (without quotation marks) is used (RUN STOP/RESTORE will bring it back). IMPORTANT: The cash will only happen when running the commands in a program! The error does not show when you enter the commands directly.

dansanderson, 2024-06-30:
An issue filed against the ROM a long time ago is actually this issue. I'm confident it's a core issue. BASIC65.D81's "PLAY EXAMPLE" is really good at reproducing it. https://github.com/MEGA65/mega65-rom-public/issues/3

I tried this with @MassiveBattlebotsFan 's most recent SID improvement build and can still reproduce the issue.

Some good news: I can only reproduce this with the 6581, and not the 8580.

(fwiw I messed around with PLAY a bit and am confident it is doing the right thing.)

Thread 579 (2022-06-12):

Tiled sprite not covering right-most pixel of the screen

zendar, 2022-06-12:
- Platform: NexysA7
 - Core Commit: d71fa6b
 - ROM Release: 920352

**Describe the bug**
When using 200px high, tiled sprite, the rightmost pixel-column is visible indepent of what Xpos of sprite is. The column is so thin it looks like a 1pixel column of 640px wide mode, even though I am running program in 320x200 mode.

Using sprite setup:

    // Enable a full color, tiled sprite with 200 height
    lda #$01
    sta $d015     // Turn on sprite
    sta $d06b     // Full color
    sta $d055     // Variable height
    lda #$f0
    sta $d04d     // Horisontal tiling (SPRTILEN)
    lda #200
    sta $d056     // Height of sprite (SPRHGHT)

    lda sprite_wipe_x
    sta $d000
    lda #50
    sta $d001
    //MSB
    lda sprite_wipe_x_msb
    sta $d010

**To Reproduce**
Steps to reproduce the behavior:
1. Go to '...'
2. Click on '....'
3. Scroll down to '....'
4. See error

**Expected behavior**
Tiled sprite is expected to cover whole screen from X-pos to right side of screen.

.

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

gardners, 2022-06-13:
Probable cause is this section of sprite.vhdl:

```
    -- Stop drawing sprites in right fly-back, to prevent glitches with
      -- horizontally tiled sprites.
      -- (but allow non-tiled sprites to wrap around into left border, as on the
      -- C64.)
      if (sprite_h640='0') and (x_in > 416) and (sprite_horizontal_tile_enable='1') then
        x_in_sprite <= '0';
      end if;
      if (sprite_h640='1') and (x_in > 832) and (sprite_horizontal_tile_enable='1') then
        x_in_sprite <= '0';
      end if;
```

Can someone please confirm if the problem exists in both 40 column and 80 column mode?
Also, if someone can please produce a minimum failing test in mega65-tools/src/tests/ that uses the VIC-IV pixel-read-back to confirm if it is happening or not in an automatic way, this will help regression testing.

gardners, 2022-06-13:
Problem is _not_ that the sprites stop one pixel early, but something else stranger, as the VIC-IV pixel colour read-back thing can't read the values. Also note that it is only on every second raster.  I'm suspecting that the sprites might stop rendering 2/3 of a pixel early at this stage. Currently investigating.

Closed 2022-10-09.

Thread 584 (2022-06-18):

Complete paddle support

dansanderson, 2022-06-18:
**Test Environment (required)**
You can use [MEGA65INFO](https://files.mega65.org?id=3eeb7d82-8bd7-44b7-82b6-cef29d123b0e) to retrieve this.
 - Platform: MEGA65
 - Core Commit: 380f41a
 - ROM Release: 920365

**Describe the bug**
Someone in the Discord mentioned that paddle support is incomplete. I did a quick test and am opening this issue to track completion of this feature. (I don't know if this is core or ROM.) Issues I noticed:

1. Paddles connected to joystick port 1 register direction and fire on JOY(1) and JOY(2). They also register direction but not fire on JOY(3) and JOY(4).
2. Paddles connected to joystick port 2 only register the fire buttons on JOY(3) and JOY(4), and do not register a direction.
3. There is about a quarter turn at the end of the counterclockwise direction that all reads as 255, so the entire range of motion is not reported across 0-255. (I don't know if this might be an issue with my paddles or if this is expected for Commodores.)

**To Reproduce**
Steps to reproduce the behavior:
1. Use this BASIC program: `10 PRINT JOY(1), JOY(2), JOY(3), JOY(4):GOTO 10`
2. Connect Atari-style paddles to joystick port 1. Run the program, and adjust both paddles all the way clockwise and counterclockwise. Press the fire buttons.
3. Connect Atari-style paddles to joystick port 2. Run the program, and adjust both paddles all the way clockwise and counterclockwise.

I'm happy to test candidate fixes, just let me know.

dansanderson, 2022-06-18:
(ROM code looks ready on visual inspection, so I'm guessing this is a CIA paddle port wiring issue in the core.)

lydon42, 2022-10-02:
As paddles do work with the C64 Core, it certainly should be fixable.

dansanderson, 2023-01-27:
I'm going to nuke this and convert it to a ROM issue. I'm not aware that more wiring is needed to support paddles connected to port 2. The POT() function is not working to spec but the cause is not clear. (I don't know why I said "JOY" above, I clearly meant "POT". But no matter. :) )

Also, I only recently just learned that the "missing" quarter turn is because I'm using Atari paddles. Commodore paddles use a different potentiometer value. I acquired some Commodore paddles today and they correctly register 0-255 across the entire turn.

Closed 2023-01-27.

Thread 589 (2022-07-01):

Core menu can be entered by powering up with space-bar held

gurcei, 2022-07-01:
My daughter discovered this by her own accidental bash-testing.

I even recall on one of her bash-testing forays, she managed to jump straight into the flashing mechanism (skipping the initial core slot menu altogether).

Part of me feels like we might be able to replicate these issues with some bash testing ourselves.

gurcei, 2022-07-01:
Other observations:
- While on the core slot menu, if I press c, b, d it surprisingly goes to a file chooser (to pick a core).

- pressing 'm' shows the flash monitor, but @gardners explained this is intended behaviour

lydon42, 2022-08-17:
Also TAB and Joystick buttons seem to be (or have been) an entry vector. This needs to be cleaned up further. Perhaps also differentiated by target platform, so we reduce the keys for the *real* thing, but leave in the backdoors for the development boards, where you might have sub-optimal USB keyboards attached.

lydon42, 2022-08-17:
Also: add display of flasher/core version to the flasher screen.

Closed 2022-09-24.

Thread 591 (2022-07-08):

External RTC logic sets hour to "19" on boot; everything else works

dansanderson, 2022-07-08:
**Test Environment (required)**
 - Platform: MEGA65
 - Core Commit: f555316 (198)
 - ROM Release: 920371

**Describe the bug**
Using an external Real-Time Clock (RTC) sets the hour to "19" on boot. All other features appear to work: the year, month, day, minute, and second values can be set in Configuration, and advance correctly with both power on and power off.

I have a batch #1 MEGA65 with a faulty internal Real-Time Clock (RTC) that does not tick. I acquired a DS3231 RTC in a package intended for RaspPi applications, along with a Grove connector cable, and installed it according to published instructions. The battery of the DS3231 external RTC had low voltage (0.8V) so I replaced it with a CR2032 (2.6V measured).

I removed the RTC battery on the main board.

**To Reproduce**
With a MEGA65 that has a non-ticking internal RTC (as reported my MEGAINFO):

1. Install the DS3231 external RTC with Grove cable and upgraded battery.
2. Turn on the MEGA65. Ensure that it is running core f555316 (v198); install this build to core slot 1 to such a core if it isn't. Confirm with MEGAINFO (with recent SD files, Freeze menu then Help key) or another method that the clock is ticking successfully.
3. Turn off the MEGA65. Hold Alt, turn on, then enter Configuration (1). Set the time and date using an hour value *other* than 19, then save and exit. Notice that the clock has the time that you set, including the hour value, but is not ticking because it is using the factory core.
4. Turn off the MEGA65, then turn it on again to run the latest core from slot 1. Notice that the clock is now fully functional *except* it shows an hour value of 19.
5. Reboot into the Configuration utility. Notice that the Configuration UI also now believes the hour is 19.

**Expected behavior**
The hour should match what was set, and advance correctly with the rest of the time values.

grim-fandango, 2022-07-08:
Even though the hours are stuck at 19 on the MEGA65, I've noticed that the date advances still - which suggests that the RTC has a sense of what the hours are.  My guess is that the MEGA65 always sets the hours to 19 and reads the hours as 19.  I'll test this and report back

dansanderson, 2022-07-08:
I have confirmed that the battery of my DS3231 is only reading about 0.8V. I will pursue the recommendation to use a soldering iron to connect a more reliable 3V source, then re-test.

dansanderson, 2022-07-09:
I have installed core 198 (f555316), and have upgraded the battery on my DS3231 to a CR2032 that measures 2.6V with the same polarity as the previous battery. I have used MEGAINFO to confirm that it is using the external RTC and it is ticking. I have used the Configuration utility to set the time (17:32:40 as I write this); doing so boots into the factory core, so I power off, then power on. The time now reads 19:35:11.

I am now in full agreement with @grim-fandango : There seems to be something peculiar setting the hour to 19, while preserving the other date and time values. Everything else seems to be working with the external RTC, including battery backup of the time. This is true even with the battery on the main board removed.

dansanderson, 2022-07-09:
(Updated issue title and description.)

dansanderson, 2022-07-09:
I left the MEGA65 powered on starting at "19":37:34, and the time now reads "19:04:18". So the "19" is being forced in real time; it doesn't tick over to 20.

gardners, 2022-07-09:
Please try POKE $FFD7402,<something other than $19> from BASIC65, and report if it changes the hours.

dansanderson, 2022-07-09:
```
POKE $FFD7402,$03
?TI$
03:40:59
```

Yes, the POKE updates the hours. This value survives the reset button, but not a power cycle: turning the machine off then on again sets the hour back to 19.

dansanderson, 2022-07-09:
New data point: I set the hour to $03 with the POKE and let the minutes roll over. The hour value *stayed* at 03.

```
?TI$
03:49:24

?TI$
03:01:38
```

grim-fandango, 2022-07-09:
Well, I watched the date all day yesterday, and 15 hours later it still hadn't changed, but then I was just too tired to wait another hour :-)  This morning the date has changed, so at some point the date has incremented.  I've just tried setting the time to 2355 to see if the date flipped at 'midnight', but it didn't.  Very peculiar!

grim-fandango, 2022-07-09:
Another observation: when in MegaInfo, it detects the RTC, and says "CHECKING".  It then starts displaying the time.  If you want until the top of the hour, it says CHECKING again, when you wouldn't expect it to.  Just noting that here in case that was an indicator of something

dansanderson, 2022-07-09:
A clue from a troubleshooting session with Paul in Discord: the hour value survives the reset button, but not the FPGA reset poke. This indicates bad initialization.

Set the hour value and confirm it is set:
```
POKE $FFD7402,$10:?TI$
```

FPGA reset into core slot 1:
```
POKE $FFD36C9,$40:POKE $FFD36CF,$42
```

This resets the hour to 19.

We could see this from the Alt menu via the serial monitor: set the hour value again, power off, hold Alt, power on to get to the Hypervisor menu with core 0. Hold Alt on the MEGA, then In the serial monitor:

```
sffd36c9 40
sffd36cf 42
```

This resets to the menu again with core 1. Confirm this in the serial output, then test the hour value with `mffd7402`. I saw:

```
MEGA65 Serial Monitor
build GIT: development,20220623.13,f555316

.:0FFD7402:1901080722000000000000001C08001C
```

(See the "19" at the beginning.)

dansanderson, 2022-09-14:
FYI this issue persists in RC 0.95 core dadad1c. (I'm not aware that anyone submitted a fix, just saying it will continue to be an issue if not fixed for RC 0.95.)

lydon42, 2022-09-25:
> Another observation: when in MegaInfo, it detects the RTC, and says "CHECKING". It then starts displaying the time. If you want until the top of the hour, it says CHECKING again, when you wouldn't expect it to. Just noting that here in case that was an indicator of something

This is expected, MEGAINFO can only do between 1-2 hours of tracking, then the counter will run over and it will start detecting again.

pietpukkel, 2022-09-25:
it however also does this when starting MEGAINFO just 1 minute before rollover. Reverts to checking and the hour does not rollover.

lydon42, 2022-09-25:
F1 enables debug output in the bottom row...

lydon42, 2022-09-25:
And to summarize my investigation today: I can't see any place where the RTC hours get set to 19, nor where the RTC gets totally reset. Looked into hyppo and i2c vhdl.

lydon42, 2022-09-27:
The part where the 19 can be find is the signal initialization in grove_i2c.vhdl:
```
  signal write_job_pending : std_logic := '0';
  signal write_reg : unsigned(7 downto 0) := x"02";
  signal write_val : unsigned(7 downto 0) := x"99";
```

But write_job_pending is 0, so it is unclear to me why it is writing it on startup.

Quick fix will be implemented by changing write_reg to 0d, which will write to the second alarm day register instead. As alarm features are unused, this will solve the clock hour 19 problem, but it is obviously not the final solution to the problem.

Closed 2022-10-03.

Thread 592 (2022-07-09):

QSPI flash write-protect PPB bits are not checked on R3A

gardners, 2022-07-09:
**Test Environment (required)**
Any extant core.

**Describe the bug**
The flash menu and jtagflash utilities do not query the PPB write-protect flags for flash sectors. But this information is required when diagnosing problems restoring core slot 0 in the flash when it has been somehow messed up.

**To Reproduce**
Steps to reproduce the behavior:
1. Lock a sector using the PPB flags
2. Hold NO SCROLL and power cycle, _or_ run jtagflash.prg via your favourite method.
3. Attempt to flash a slot that includes the locked sector.
4. Note that you will get an error about unable to write, but no explanation as to the root cause.

**Expected behavior**
1. If a PPB bit is configured for a sector, this should be reported, and flashing stopped.

**Screenshots**
N/A

**Additional context**
N/A

lydon42, 2023-06-16:
the changes of [66c9f2b](https://github.com/MEGA65/mega65-core/commit/66c9f2bcd06d3f827e1c8c03ed93a055bf91a76d) are no longer in development nor in 683-cartflash, as they made problems.

So we need to reinvestigate this, but as there is no thing that sets the write protect, I will need a testcase for this.

0xa000, 2024-02-02:
What is the use case for this? Normally the flash should unlocked, right? I did read somewhere that R3(A?) boards came with write protection enabled, is that true?

Checking write protection in a general way is a (little) bit tricky, because there is also block protection in addition to the PPB bits (and DYB bits, but these we can ignore). Also, for the 4K/64K mixed sector flash chips, determining the bit to check needs extra work. (I thought erasing also needed special care, but it turns out you can erase the 4K/64K chips as if they have a uniform 64K sector layout.)

lydon42, 2024-07-21:
I think this is more a function we need to add to mflash.prg, as it seems to me that this will come up during development and debugging, rather than on production systems. So we could opt to not add it right now.

Thread 599 (2022-08-07):

Floppy not recognised when going from GO64 to MEGA65 mode

MauriceMEGA65, 2022-08-07:
**Test Environment (required)**
See screenshot MEGA65 info, core 3253c5d

**Describe the bug**
While in GO64 mode, I used Freezer to mount my real floppy.
After mounting, I could write and read to/from floppy, so in G64 mode all was fine.

Then I went to MEGA65 mode via SYS58552.
After that point, the floppy was no longer recognised, and DIR give me a READ ERROR.

I tried:
1. Mount the floppy again via Freezer --> same read error after DIR
2. Mount the floppy in BASIC via MOUNT --> same read error after DIR
3. Eject the disk, reinsert the disk, MOUNT --> success

**Expected behavior**
MOUNT of a floppy disk should work after switching between MEGA65 and GO64 mode without re-inserting the disk.

**Screenshots**
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

lydon42, 2022-10-02:
Can't confirm this on RC1, just did it with the hybernated disk and after the SYS to MEGA65, autoboot kicked in and started the game, as it is expected.

Closed 2022-10-02.

Thread 601 (2022-08-22):

C65 demo does not run on core 3253c5d, but does run on XEMU and slot 0 core

MauriceMEGA65, 2022-08-22:
**Test Environment (required)**
You can use [MEGA65INFO](https://files.mega65.org?id=3eeb7d82-8bd7-44b7-82b6-cef29d123b0e) to retrieve this.
 - Platform: MEGA65
 - Core Commit: 3253c5d
 - ROM Release: 911001

**Describe the bug**
C65 demo (see attached) does not run on latest core, but runs OK on core in slot 0 and on XEMU

**To Reproduce**
Steps to reproduce the behavior:
1. Boot with old ROM (911001)
2. Mount ZED-YAGO.D81 (see attached)
[zed_yago.d81.zip](https://github.com/MEGA65/mega65-core/files/9397446/zed_yago.d81.zip)

3. Load and run DEMOLOAD65 (will switch to C64 mode)
4. In C64 mode, load and run DEMOLOAD64

**Expected behavior**
Same as on XEMU or real hardware booted with slot 0 core

**Screenshots**
If applicable, add screenshots to help explain your problem.

**Additional context**
Audio seems OK, video is effected/scrambled

lgblgblgb, 2022-08-22:
I'm not sure how important that is, since: https://github.com/lgblgblgb/xemu/issues/142#issuecomment-855451262

So it can happen it's just a coincidence that it runs with older bitstream (slot 0) or Xemu. But I can't judge this clearly anyway.

lydon42, 2022-10-02:
A slot 0 core is just a very old core. As we are adding enhancements, old stuff intended for the "real" C65 will probably break, it is not possible to enhance and keep old the old "quirks".
So if you like to run a very old example, make sure to use an equally old core.

Closed 2022-10-02.

Thread 604 (2022-08-28):

VIC-IV raster irq incorrectly triggered twice

ki-bo, 2022-08-28:
**Test Environment (required)**
 - Platform: NexysA7,
 - Core Commit: F5553164
 - ROM Release: 920376

**Describe the bug**
1. If the IRQ is acknowledged ($d019) while still in the same line where it was triggered and the handler is exited while still in the same raster line, a second "phantom" raster IRQ will be triggered at the beginning of the following raster line. This makes it rather impossible to have proper raster IRQ handlers that last shorter than one raster line.
2. If the IRQ is acknowledged in the same line where it was triggered, but exited in another raster line, a second (phantom) IRQ will be triggered immediately after the first handler has exited via rti (it is therefore happening in the same raster line still, not the following one).
3. If the IRQ is acknowledged in a different raster line than it was triggered, all is as expected (no second phantom IRQ is triggered).

**To Reproduce**
Steps to reproduce the behavior:
See example code snippet

[vic-iv_raster_irq_ack_bug.txt](https://github.com/MEGA65/mega65-core/files/9440437/vic-iv_raster_irq_ack_bug.txt)

The raster irq should draw the border in red for some lines starting at $68. Instead, it also draws it cyan for the same amount of lines afterwards - indicating a second raster irq has been triggered after the first one is done. The IRQ handler of the test snippet attached is written to chose red color in case we really get called in line $68 and will draw cyan lines otherwise.

**Expected behavior**
The raster IRQ acknowledge should be possible in the IRQ handler no matter in which raster line it is done (same behaviour as a C64/VIC-II would show).
In the attached example: only one raster IRQ should be triggered (in the example in line $68), no other raster IRQ should be triggered, no cyan lines should be visible.

**Screenshots**
Output of the test program:
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

ki-bo, 2022-08-30:
Looking at viciv.vhdl, the problem seems to be that for a vic-iv raster line, the irq is activated for the first three pixels (as long as external_frame_x_zero_latched is 1), but _in addition_ at the very end of the raster. There are two pixelclock cycles where external_frame_x_zero_latched is already 1, but ycounter is still representing the old raster line (since ycounter is updated through ycounter_driver, there is a two cycle delay). This will trigger the raster irq again at the very beginning of the next raster, and therefore only irq handlers lasting at least until the second row will be triggered as expected by users (and only if users are careful to ack the irq only in the next line, thus rather at the end of the irq handler).

This is not an issue for vic-ii raster lines, because for those the raster irq is edge triggered on the update of ycounter (or more specifically vicii_ycounter in that case), so there is only one specific pixelclock cycle in which the raster irq triggering is evaluated. There is a comment in the code that for vic-iv this is not needed. But I really can't see why this should not also be the case for vic-iv rasters. We will eliminate the spurious raster double triggers and make life easier for developers getting the behaviour they are used to.

Closed 2022-09-13.

Thread 613 (2022-09-14):

RC 0.95: Configure time set doesn't always stick while editing

dansanderson, 2022-09-14:
**Test Environment (required)**
 - Platform: MEGA65
 - Core Commit: dadad1c
 - ROM Release: 920376

**Describe the bug**
Release candidate 0.95, Configuration v01.00: new time setter may or may not retain the value I type. This appears to be an issue with how the clock is being updated in the field while I'm typing in it. When I leave the field late, sometimes it re-reads it from the RTC and overwrites my value.

I can't tell under what circumstances it retains the value and when it doesn't. I was able to set my hour field with some struggle, but I have not successfully set my minute field yet.

*Important:* I am running a Grove external RTC. My batch #1 MEGA65 has a non-functional internal RTC (no ticks).

**To Reproduce**
Steps to reproduce the behavior:
1. Install core dadad1c in slot 1.
2. Power off, hold Alt, power on. Select Configuration (1).
3. Use cursor keys to navigate to Chipset menu, with Time field selected. Notice it is updating the current value once per second.
4. Enter a different hour value from what is set. Press Tab to navigate to the minute field at different times.

**Expected behavior**
If I have typed any value in a time field, it should retain that value and set it to the RTC when I leave the field, regardless of when I leave the field.

**Additional information**
I would further suggest that typing two digits in any time field should automatically advance the cursor to the next field. Right now I have to type (for example) 2 3 TAB 2 8 TAB 0 0. I personally wouldn't mind freezing the entire Time value if any Time field is active.

Pressing TAB with the seconds field active does nothing. Maybe this should advance to the first Date field?

dansanderson, 2022-09-14:
I'm having other issues with the Time *and* Date setting in Configuration retaining their values. I just set my Date to 31-OCT-2022, cursored to another tab, then cursored back and it went back to its previous date value.

Again, this is with a Grove external RTC and the dadad1c candidate core in slot 1.

M3wP, 2022-09-14:
I believe that this is a problem with not having enough documentation.

The date and time fields aren't saved in the same way as the other details.  This is because they aren't restored by Hyppo during the boot process, they are simply free-running.

In order to save the time or date you enter, you need to press "Return" while editing the field.  This can be done at any time but when it is done, validation is also applied so invalid times or dates will be altered.

Tab is required to shift between the sub-fields of the time field because the sub-field (hours, minutes, seconds) being edited is locked from updates until moving to another field or sub-field.  This could be changed but I do not recommend it.

Tab does not move to the next field.  Use the arrow up/down keys to do this.  This could be changed but it would likely need to be made a general key and I again, do not recommend it.

dansanderson, 2022-09-14:
There are more fundamental UX issues here that can't be patched over by documentation.

The requirement to press Return is extremely unintuitive, not least because pressing Return appears to do nothing at all: it doesn't advance the cursor to another field, and there's no other user feedback if the user has entered a valid date. If I change a date value then use the cursor keys to navigate to other fields on the page, the date field appears to retain the value I entered. If I leave the Chipset page, the value I entered is lost, and I may never notice. There is nothing to indicate that the value is unsaved and it's my responsibility to do something special to save it, and there is nothing in the entire UI that needs the Return key for this purpose.

I agree that part of the problem is we're mixing UI metaphors. The overall Config interface behaves as a draft document that doesn't take effect until explicitly saved in the Done tab. The date and time fields do not currently behave this way and are updating the RTC during the editing process. It also needs value validation, and there's no other part of this UI that currently validates values. If space weren't at a premium, I'd suggest that the date and time be a modal editing interface (e.g. a pop-up window) that reinforces that settings are validated and set on exit; exit can be blocked with a message if the value is invalid, with an option to revert and cancel.

We should at least validate and save/restore the date the moment the field is exited via cursor up/down or the page is exited via cursor left/right, i.e. all loss of focus should behave like Return. It's less than ideal that an invalid date value is invisibly reverted when I leave via cursor left/right, but fixing that would require bigger changes to the overall Config UI. As is, I can enter a *valid* date value and have it invisibly reverted, which is unacceptable.

M3wP, 2022-09-14:
There will be no modal functions, no pop-ups.

Why is updating a value by pressing Return "unintuitive"?  What sort of feedback is actually required?  These fields are quite specifically different to the others.

Why do you need auto-commit?  What if you have entered the incorrect value and don't want it anymore?  Another "unintuitive" key press (labelled so because you don't know it yet) to reset?

It will only "revert" your entry if you don't "commit" it.  All I can see is user error in light of not having the correct documentation.  There is no "fundamental" problem only a lack of familiarity of use.

If you enter a valid value and commit it, your problem is solved.

dansanderson, 2022-09-14:
+1 to not doing a modal pop-up here, there's not enough time or space. :)

There are only three text fields in the entire Config UI, so there's not a lot of opportunity for a user to discover how it works. The Default Disk Image field retains its value without pressing Return. It's only the date and time fields that use Return in this way.

I can only say that the current behavior is against my expectations and I'm not sure how I could have figured it out. If I'm in the Hour field and type a value then press Tab to navigate to the Minute field, the Hour field reverts to its previous value. As far as I can tell, I can't edit the time. Now that you've told me how it is implemented, I see that I can enter the Hour field value and press Return, then press Tab, then enter a Minute value and press Return, etc. Pressing Return doesn't appear to do anything, even though it is doing something. I would at least expect to be able to enter the entire time value before needing to press Return to set it.

The date field appears to behave differently from the time field in this way. I can tab through its fields and enter values without pressing Return, and they don't revert until I switch pages.

If we really need the user to press Return within each sub-field to commit its value, we should print a "press return to set" message under the selected field if the field contains changes (and hide it when the field doesn't contain changes). The time and date fields should behave consistently with each other. Does that sound right?

M3wP, 2022-09-14:
Yes, you were meant to be able to enter the whole time value before commit.  At some time during the development, this was lost.  This should be addressed to improve ease-of-use.

There is no commit required on the Disk Image field because it is managed by the standard save and Hyppo load.  The MAC address field also behaves differently to the others but this seems to have gone unnoticed.

There is absolutely no room for any messages.  I don't think I can even change the colour of the field at this point in time.

If you change the date and time, some kind of commit is going to be required.  I think auto-commit would be a mistake.

lydon42, 2022-09-25:
The ticking while editing has been disabled. Pressing RETURN to write value entered into RTC is needed.

Closed 2022-09-25.

Thread 614 (2022-09-14):

RC 0.95: Onboarding date setting shows day -1

dansanderson, 2022-09-14:
**Test Environment (required)**
* Platform: MEGA65
* Core Commit: https://github.com/MEGA65/mega65-core/commit/dadad1c885c95d61f49387648551e6448586d077
* ROM Release: 920376

**Describe the bug**
It appears the Onboarding date setting interface reads the date from the RTC with the day value -1. After setting it, it appears in BASIC as the set day value +1. This is true even when setting the day value to 31: BASIC shows a day of "32."

*Important:* I am running a Grove external RTC. My batch-1 MEGA65 has a non-functional internal RTC (no ticks).

This may or may not be related to https://github.com/MEGA65/mega65-core/issues/613.

**To Reproduce**
1. Power off, hold Alt, power on. Select Configuration (1).
2. Chipset tab, notice the current date setting. (Right now, mine says 15-SEP-2022.)
3. Done tab, Exit and Reboot to Onboarding.
4. Notice that Onboarding things the day value is -1. Mine says 14/Sep/2022.
5. Use F9 and F11 to set the date to 31/Oct/2022. Press Return to save and exit.
6. BASIC header displays `32-OCT-2022`, as does `?DT$`.

**Expected behavior**
Onboarding should show the current set date accurately, and should set it accurately.

**Additional context**
The time and date set in Onboarding appears in BASIC, but is reverted when I power off and on again. This might be a separate issue, and may be specific to Grove external RTC support.

lydon42, 2022-09-14:
duplicate #540

Closed 2022-09-14.

Thread 620 (2022-09-26):

HYPPO: d81attach0/1 fails with D64 size check

lydon42, 2022-09-26:
A d64 image is not attached, as the dos_d81check routine does not check it's size correctly.

In addition the whole "which image is it" is done double in d81check and d81attach0 and d81attach1. So it would be reasonable to store the detection result of d81check, and not check sizes again in attach to set the flags correctly.

lydon42, 2022-09-28:
There is currently a systematic problem with the image attach/detach functions.

Currently we have a d81attach0 and d81attach1 function call, to attach an image to either drive 0 or 1.
Then there is a d81detach which will detach both images at once.
Both calls will update the internal processdescriptor to reflect the image currently attached.

There is no call to just detach one image, which in my eyes is missing. Because of that BASIC MOUNT will just use pokes to unmount the image on one drive, which is then not reflected in the display of the FREEZER.
In the same way it is not actually detaching the image, but it is **attaching** the internal drive. For this there is also no call. And so there is also no update to processdescriptor.

The proposal is to:
- add d81_detach0 and d81_detach1 calls
- make d81_detach a macro call that does the two above
- make d81_attach into one backend function (without call)
- add the possibility to attach the internal drive instead of an image, updating process descriptor
- make d81_attach0/1 call the above

This way all old calls will stay compatible.

lydon42, 2022-10-02:
#494 has the same "problem" as d81_detach. We should implement a similar solution here.

lydon42, 2022-10-03:
This fixes the size check close file problem, But I keep it open, because I would like to reorganize the hyppo mount functions and also provide a single drive unmount.

lydon42, 2022-10-10:
Working in [620-hyppo-dos13](https://github.com/MEGA65/mega65-core/tree/620-hyppo-dos13)

lydon42, 2022-10-10:
Removing enhancement part from bug part for clarity. Work continues in #628

Closed 2022-10-10.

Thread 622 (2022-10-02):

CONFIG: Add option to disable floppy drive sounds while accessing SD

MauriceMEGA65, 2022-10-02:
Currently the floppy drive is being activated while accessing the SD in order to create floppy drive sounds.

I would like to be able to disable the floppy drive being activated while accessing the SD. Using both media makes it hard to distinguish which drive is being read/written by the sound of it. An enable/disable setting in config would be welcome. Perhaps also reducing wear and tear as a bonus. I will make it a future request

lydon42, 2022-10-02:
Linked to #621

MauriceMEGA65, 2022-10-02:
Ah, same issue as #518, so most likely duplicate

grubi, 2023-01-09:
I'd like to support this one. Drive sounds are no problem when loading a game from time to time. But when the Mega65 is used for heavy development, it can quickly become annoying - plus I fear it will wear off the old, used drives more quickly. I have disconnected my disk drive cable internally, after finding out that the SILENT flag in $D6A0 doesn't work.

tmilker, 2023-01-26:
I'd also like to express my support for this feature. In addition to not being able to determine if a real disk is being accessed, what happens if we have an actual disk in the drive?  I don't know really know how a floppy drive works, could this cause wear & tear on the disk itself too or an unknown/unexpected bug cause it to be accidentally written to or damaged?

KiDraDragon, 2023-01-26:
It would be a very much appreciated feature.

Mikey351AU, 2023-01-26:
I support this request.

LeifBloomquist, 2023-01-27:
Yes!  Need this

nobruinfo, 2023-02-05:
I would even suggest to make this *opt-in*. Meaning it should not only be configurable but **off** at default. Not only would this make it more VICE compatible :) but also people would not have surprise effects upon first starts of their machines.

lydon42, 2023-02-18:
This needs #621 to be fixed.

deathybrs, 2023-08-10:
I add my voice to this request - it is a really cool feature, but many of us fear for the life of our drives, which seems like a valid concern to me.  I further really like @nobruinfo's suggestion that the option default to off rather than on so that we start out protecting people's disk drive.

dansanderson, 2023-09-17:
Notes from Paul:

Most likely in sdcardio.vhdl
the line that enables the real drive motor is motor <= fastio_wdata(5)
hang on, no, it will be f_motora/f_motorb
silent_sdcard is the variable that controls it, and it should be working at first look.
It is not currently applied to head stepping, however.
so this is likely what is happening: The actual selection of real drive is suppressed until you step tracks, at which point it does get selected.
basically follow the f_selecta/b references and add the missing checks for real floppy or silent_sdcard to those blocks.

lydon42, 2023-09-18:
If unsure: also add to ONBOARD, so the user gets asked as soon as possible.

RetroCogs, 2024-01-09:
As someone that develops late at night, the drive sounds everytime I launch an iteration are very loud and I would love to be able to develop in silence.

tundraC, 2024-01-11:
I'd love the option to en/disable.  I was troubleshooting a boot issue last year and it was very difficult to figure out what was being used for loading.  The issue was very hard to determine if the drive was actually seeking or faking it.  Plus, when working late at night, it's nice to keep it quiet.  Just my two thoughts :)

dansanderson, 2024-07-02:
I can confirm that this is implemented and working in the latest development core. This issue can be closed (along with #621).

MauriceMEGA65, 2024-09-10:
👌

Closed 2024-09-10.

Thread 623 (2022-10-02):

Config to switch the RTC registers to "time since boot"

dansanderson, 2022-10-02:
**Is your feature request related to a problem? Please describe.**
The Real Time Clock is dedicated hardware that provides date and time values to registers, and these registers are used by BASIC 65 as the values of the `TI$` and `DT$` variables. R3 boards are shipping with a 25% failure rate in RTC chips for the time being; an "external" RTC workaround is available via the Grove connector but core support is not yet complete (issue #591) and requires users to acquire, assemble, and modify appropriate hardware.

It would be easy to ignore the RTC except for three things: the BASIC start-up banner, SD card FAT16 timestamps, and the `TI$` variable. https://github.com/MEGA65/mega65-rom-public/issues/24 proposes and includes a patch for removing the display of the date and time from the BASIC start-up banner.

The `TI$` variable sticks in my craw a bit because it is available in all previous Commodores as a string representation of the time since boot. A MEGA65 with a broken RTC behaves as a stuck or slow clock, not a zero'd working one, despite the `TI` variable advancing correctly. This feels like a regression against Commodore BASIC. (One could argue that we've already redefined `TI$` by adding colons to the time value.)

**Describe the solution you'd like**
I propose that the MEGA65 Hypervisor have a configuration option to replace the RTC registers with a time-from-boot clock: "Enable RTC: yes/no." The new "RTC disabled" mode would set the clock to 00:00:00 2000-01-01 on hard boot, and advance the clock via the CPU similar to how `TI` is advanced.

This new mode would allow these registers to be written by software, which is not currently possible with the RTC. This would prepare the clock for a future case where we might support setting the clock on boot from a networked time server. BASIC 65 could be enhanced to allow assignment to `TI$` similar to BASIC 2 and 7. Software that uses a real-time clock value can prompt the user to confirm or set the time.

This provides a useful value everywhere the RTC value is available, and helps 25% of MEGA65 owners feel less like they own a broken or incomplete machine. I believe this would be welcome even with a fully functional external RTC option.

**Describe alternatives you've considered**

**Alternative:** Rewrite the RTC implementation in the core such that it only uses RTC hardware to set a CPU-managed clock at boot, instead of hard-wiring the registers to the RTC hardware. Allow writing to CPU clock registers. Broken RTCs would set the clock incorrectly, but the clock would advance and could be set from BASIC or from software. No changes to config.

**Alternative:** Complete the external RTC implementation and help affected users acquire and install RTCs. Offer no other solution.

**Alternative:** Disable the time in the BASIC banner (as is already being considered), and do nothing else. In affected cases, only software that uses RTC values or the `TI$` variable have incorrect behavior. Remove the vector clock demo app from the demo disk.

**Alternative:** Do nothing at all. In affected cases, BASIC banner displays an incorrect time and cannot be fixed.

**Additional context**

```
GO64
ARE YOU SURE? YES

READY.
?TI$
000002

READY.
TI$="001001"

READY.
?TI$
001003
```

dansanderson, 2022-10-03:
Issue #591 is fixed in the latest RC2 test core that will become the batch 2 factory core and recommended upgrade core for batch 1 users. I still think this is a compelling feature request but I would now consider it lower priority, to the extent that an external RTC is an option to repair the original functionality.

Of the 25% of owners affected by the broken internal RTC issue, not all of them can or will pursue an external RTC fix. Disable RTC or Alternative 1 gives these owners a way to restore functionality up to the C64's capability.

Disable RTC or Alternative 1 might be useful for all owners, as a way to set a soft clock during a session that overrides the hard clock.

dansanderson, 2024-06-05:
I'm satisfied with the R3 RTC workaround and the R6 overhaul of the RTC. BASIC programmers can live without a writeable TI$ variable, and ML programmers can use KERNAL routines to set and read the CIA TOD clock.

Thread 625 (2022-10-04):

MEGAFLASH: add JTAG-less slot 0 flashing option

lydon42, 2022-10-04:
If slot 0 is erased, a slot 1 core will still be booted after 30 seconds of searching. This also happens if only the start of slot 0 is erased, or some piece inside slot 0. My tests always ended up booting slot 1 after a short while.

So we could make a slot 0 flasher by requiring a good core in slot 1 and asking the user if he is able to start the system from slot 1.

This would enable us to add the Slot 0 flash function as a official function to the integrated flasher.

Checks:
- attic ram (already there)
- slot 1 (and slot 2?) contain a MEGA65 core
- core file needs to be a MEGA65 core!

Questions to be answered:
`I am aware that I VOID my warranty if I flash slot 0 without a JTAG interface`
`I hereby CONFIRM that I am able to boot the system by selecting slot 1 from the flash menu`
The user needs to type `yes` to both of them and confirm each entry with return. Alternative he could also be required to type `VOID` and `CONFIRM` for some more variation...
We (deft, martin, I) are positive that this will be enough to not be accidentally triggered.
In addition the Slot 0 Flash functions stays on the (currently secret) MEGA-something combination, so that it is not triggered by accident.

So in total three prerequisites need to be fulfilled and the user needs to confirm two question by typing YES

Recovery:
if slot 0 is broken because of some mishap, the system will boot slot 1 in a short while and you can use NO-SCROLL to enter the Slot 1 flasher.
**Edit:** this is not entierly true, Paul corrected that the first sector needs to be erased so that happens. If an later sector would be erased, the system will still be unrecoverable without a JTAG.

dansanderson, 2022-10-04:
We should avoid implying the existence of a warranty if there isn't one. I think we just want to emphasize that this is a technically complicated procedure that may fail, and failure will require a recovery process.

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
```

lydon42, 2022-10-04:
Three words: to many characters!

dansanderson, 2022-10-04:
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

```
You are about to replace core 0.

If this process fails or is interrupted,
core 0 will fail to boot and MEGA65 will
blink blue lights.

If this happens, hold the NO SCROLL key
for 30 seconds to restart this process.
This requires a working MEGA65 core in
slot 1.

Be sure to confirm that core 1 works
before proceeding!

  * I have read and understand this
    message.

  * I have tried booting with core 1
    and it works.

  Type CONFIRM to proceed, or press
  Return to abort: CONFIRM_
```

dansanderson, 2022-10-04:
If you need fewer bytes, let me know how many bytes you're willing to spare. :)

lydon42, 2023-03-28:
Extra ideas:
- make it that there is NO file selection, but a fixed `FIRMWARE.COR` is loaded
- add `FIRMWARE.CRC` which contains a CRC checksum
- add checksum calculation which calculates the checksum from attic ram contents and compares to `FIRMWARE.CRC`
- add erase first sector on any failure after flash has started
- add reprogram fpga from slot 1 after flash failure

lydon42, 2023-09-24:
This is in 683-cartflash but still needs finishing touches.

Closed 2024-02-24.

Thread 628 (2022-10-10):

HYPPO-DOS: refactor d81attach / d81detach calls

lydon42, 2022-10-10:
There is currently a systematic problem with the image attach/detach functions.

Currently we have a d81attach0 and d81attach1 function call, to attach an image to either drive 0 or 1.
Then there is a d81detach which will detach both images at once.
Both calls will update the internal process descriptor to reflect the image currently attached.

There is no call to just detach one image, which in my eyes is missing. Because of that BASIC MOUNT will just use pokes to unmount the image on one drive, which is then not reflected in the display of the FREEZER.
In the same way it is not actually detaching the image, but it is **attaching** the internal drive. For this there is also no call. And so there is also no update to process descriptor.

The proposal is to:
- [ ] add d81_attach that does everything
- [ ] deprecate old calls, point them to the new implementation
This way all old calls will stay compatible.

Continuing from #620 (split because bug and enhancement are separate).

EDIT: This can now be found in branch [760-hyppo-dos13](https://github.com/MEGA65/mega65-core/tree/760-hyppo-dos13) (see #760)

lydon42, 2023-12-23:
removed from batch 3 milestone, this should go into the after batch 3 hyppo dos branch, which also implements writing and other stuff.
Is not needed for the factory core, can easily go into standard core.

lydon42, 2024-08-31:
This has now changed to become ONE call dos_attach which will handle all attaching and detaching.

Closed 2024-09-01.

Thread 631 (2022-10-22):

SID 8580 won't play certain notes on first invocation

bubbob42, 2022-10-22:
**Test Environment (required)**
 - Platform: DevKit, MEGA65
 - Core Commit:  93d55f08
 - ROM Release:  920377

**Describe the bug**
When SID8580 is enabled, a noise wave won't be played on first attempt.

**To Reproduce**
1. Set SID to 8580 (6581 is not affected)
2. Switch on the machine (cold boot required)
3. enter: SOUND3,5000,10,2,0,0,3

**Expected behavior**
A noise signal should be played on channel 3. It will only play when repeating the command. This behaviour is present for all SID channels.

johnwayner, 2022-11-05:
This issue only effects the NOISE waveform.  The issue is resolved once a different waveform is selected and gated on (or Basic's SOUND interrupt shut's down a voice by writing $08 (enabling TEST) to its control register).

@gardners The LFSR is stalled out initially due to it relying on wave_out (which will be all zeroes) for part of its value.  Most importantly wave_out[4] will be zero to start and that needs to be 1 to prevent the stall.  Basic sets the TEST bit of the CONTROL register which unstalls the LFSR:

`(lfsr_noise[17] ^ lfsr_noise[22] ^ reset ^ 'test_ctrl)`

Enabling another waveform unstalls the LFSR as well by feeding non-zero values into wave_out.

There is a [more traditional implementation](https://github.com/MEGA65/mega65-core/blob/93d55f0841d48f52cec420621f692bf6ece36fed/src/verilog/sid_voice_8580.v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) of an LFSR commented out below [the current one that uses wave_out](https://github.com/MEGA65/mega65-core/blob/93d55f0841d48f52cec420621f692bf6ece36fed/src/verilog/sid_voice_8580.v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) that seems to work.

I assume there was a reason for the more complicated one.  Perhaps it simulates the actual 8580?  I have no idea.

Anyway, it can be fixed by reverting back to the commented code or otherwise ensuring the LFSR doesn't ever equal all zeroes.

I can provide a pull request to revert to the commented code, but I don't want to do that without understand why it is the way it is.

lydon42, 2024-09-01:
@bubbob42 Is this fixed?

Closed 2024-09-07.

Thread 633 (2022-10-31):

Remote control via ethernet to make development faster and easier

gardners, 2022-10-31:
**Is your feature request related to a problem? Please describe.**

When developing for the MEGA65, if you don't have a serial adapter, its a bit of a pain to pull the SD card out all the time to put your program on. Even with the serial cable, its a bit slow if you have large slabs of memory to load.

**Describe the solution you'd like**
It would be great to have an option to remote control the MEGA65 via Ethernet, so that you can immediately reset the machine, and push stuff into memory wherever you like, and then set it running.

**Describe alternatives you've considered**
Do nothing.

**Additional context**
N/A

gardners, 2022-10-31:
Setting dip switch 4 will enable this feature.
Resurrecting the old etherload program as the MEGA65-side end of it.
Will make an "e65" command to go with "m65" that will take broadly similar arguments, but do everything via ethernet, instead of serial.
Will require MEGA65 to be on the local network, i.e., no router support.  Layer 2 switches will be ok, including transparent wifi APs.

gardners, 2022-10-31:
@lydon42 correctly pointed out that sw 4 is the core 1/2 select. Using sw 2 instead, which was DVI audio disable, but which can be done in the configure program.

gardners, 2022-10-31:
User guide updated to reflect this.

gardners, 2022-11-02:
HYPPO side of things now works. 2nd dip switch enables ethernet hyperrupts, and tells eth controller to make ack stale frames so that hyperrupt trigger frames can always be received.

Things to improve:
1. make ethernet scan the hyperrupt frames, even if buffers are full, without needing to store the frame, and thus not having to change the behaviour of the ethernet controller's handling of all buffers full.
2. Modify etherload.c in mega65-tools to relocate the ethload routine from $C000 to somewhere in a higher memory bank or in the tape buffer area or somewhere where it is generally less likely to be stomped on when loading large programs.
3. Modify etherload.c to allow loading multiple segments in different parts of RAM.
4. Modify etherload.c to allow setting entry point address.
5. Modify etherload.c to allow setting up c64 or c65 memory map for exiting to BASIC programs
6. Modify etherload.c so that it confirms reception of every data frame (modify data frame routine to trigger a TX of the received frame back to the sender as simple confirmation scheme)

gardners, 2022-11-02:
7. Save PC to $C0FE/FF before launching ETHLOAD
8. Have ETHLOAD save all regs (including stack pointer and location), so that previous prog can be resumed.
9. Document in manual

ki-bo, 2024-02-04:
Split feature to resume running programs after launching etherload into own issue #784

ki-bo, 2024-02-04:
> 7. Save PC to $C0FE/FF before launching ETHLOAD
> 8. Have ETHLOAD save all regs (including stack pointer and location), so that previous prog can be resumed.

These will be done in #784

Closed 2024-02-04.

Thread 637 (2022-11-11):

MK-II keyboard uses a different protocol: Add auto-detect and support for it

gardners, 2022-11-11:
**Is your feature request related to a problem? Please describe.**
The MK-II keyboard uses I2C to communicate, which is very different to the original keyboard protocol.
So the MK-II keyboard doesn't work with current bitstreams.

**Describe the solution you'd like**
The bitstreams should support both versions of the keyboard, automatically detecting which has been connected.  Bonus points if hot-swapping works.

**Describe alternatives you've considered**
Slapping fish while chanting. But too alternative to be useful.

**Additional context**
N/A

gardners, 2022-11-21:
Solved in two different ways for different targets:
1. For mega65r2, mega65r3, that have MAX10 FPGAs, the conversion is done in MAX10, because the MAX10 is the FPGA that is actually connected to the keyboard, and thus the only one that can tri-state lines.
2. For the Nexys4DDR target, adding experimental support for connecting a MK-I or MK-II keyboard using the same approach, by replicating mk2_to_mk1.vhdl from MAX10 into this repo.

gardners, 2022-11-22:
Support for Nexys4DDR / Artix7 A100T boards now implemented and confirmed working.

Closed 2022-11-25.

Thread 656 (2023-02-01):

IRQ feature in AudioDMA

M3wP, 2023-02-01:
**Is your feature request related to a problem? Please describe.**
Use of AudioDMA is highly desirable but uses quite significant amounts of memory.  Buffering can be used to reduce this footprint but is difficult to achieve reliably without IRQ notifications.

**Describe the solution you'd like**
A "low water" alarm should be available for each channel and flags to enable and represent the condition of having entered into a specific region of the sample data.

**Describe alternatives you've considered**
Polling the playback position is an alternative but you want to poll for the loop point (end point) and this is particularly difficult to do without doing only this and in large buffers.

**Additional context**
I have implemented the feature and will make it available after more thorough testing.

lgblgblgb, 2023-02-01:
@M3wP If possible, please make a test program available using this feature, would be great for Xemu too, since I need to add this feature there as well, and it's nice then if there is some test material available. Thanks in advance!

M3wP, 2023-02-01:
[probe.zip](https://github.com/MEGA65/mega65-core/files/10561091/probe.zip)
Here you will find my test program for the IRQ feature.  It shows setting and reading the IRQ enable and event flags and how to use the trigger value to trigger the IRQ at the half-way point.

It has become a little "hacked" since I have been using it to track down problems in Manche v2 which also will make use of this feature but should be useful still as a reference.

lydon42, 2024-08-18:
This is #811

Closed 2024-08-18.

Thread 660 (2023-02-03):

Make MAP register readable from program code

dansanderson, 2023-02-03:
**Is your feature request related to a problem? Please describe.**
The 45GS02 MAP register is currently write-only from program code. A program can set it but not read it. This makes MAP state difficult to pop and push. A program can manage its own MAP settings by diligently setting variables every time it updates them, but this is an error-prone workaround when the CPU knows these values.

Interrupt handlers must never to change the MAP register if it intends to return control to the code that was interrupted. Similarly, it is impossible for the kernel, the MEGA65 monitor, or third-party developer tools to accurately interface with the program counter, because it can't determine the complete PC value.

**Describe the solution you'd like**
The 45GS02 has an instruction sequence for setting the MAP register from AXYZ. It should have a symmetric instruction sequence for loading the MAP register into AXYZ. I don't have a preference as to which magic incantation would be best.

I haven't thought through the consequences, but a new NOP knock might work, e.g. NOP (without an active MAP, !=EOM) followed by MAP. Assemblers could spell this "TMAPQ," maybe.

**Describe alternatives you've considered**
I gather that the method for setting the megabyte byte of the MAP register uses a special value. Assuming 00 0F 00 0F is used by programs consistently, we could reserve the A and Y registers as command space for X=0F/Z=0F, and declare a command for reading the registers, e.g. `LDA #$01 LDX #$0F LDY #$01 LDZ #$0F MAP EOM`.

The Hypervisor can read the MAP register, so I presume there's some mechanism for it. I don't know if it's appropriate to expose that mechanism to program space directly. Another possibility might be a Hypervisor trap to copy this register into AXYZ.

**Additional context**
The MEGA65 monitor currently has no reliable way to determine the full PC after a BRK. This prevents it from accurately displaying the PC, and from making it easy to resume a program after a BRK (the "G" instruction without arguments). In ROM 920377 it guesses bank 3, which works for kernel troubleshooting and not much else. ROM 990003 changes it to "last remembered bank" but the uninitialized variable is often non-zero. I might try updating it with a slightly better guess useful for novice programmers working in bank 0, but that only feels like a slight improvement.

ki-bo, 2023-03-14:
I believe we can do that via a hypervisor call from user space:
hyppo_get_mapping
LDA #$74 : STA $D640 : CLV

dansanderson, 2023-08-06:
Thanks! I tried it from the monitor and got some kind of result, so I'm going to assume it's a correct result and close this issue. :)

Closed 2023-08-06.

Thread 667 (2023-02-08):

Allow Hyppo and Freezer to swap writeable charset with default temporarily

dansanderson, 2023-02-08:
**Problem**
It is currently possible to write to VIC-IV Character ROM at FF7E000-FF7EFFF. This changes the default character set, which is used by the Hypervisor, the Freezer, and the main system if CHARPTR is set to the special value $0001000. The special value is not documented, but it is the default on boot. Character ROM *is* documented as "write-only," and BASIC and some programs customize the character set by writing to this memory instead of setting CHARPTR to RAM.

A side effect of writing to character ROM is that Hyppo and Freezer displays use whatever modifications were set by a program, possibly becoming unreadable. Hyppo also uses the customized charset for the boot display when the user presses the reset button.

**Proposed solution**
Hyppo should always use the default PETSCII character set *and* preserve any modifications that were written to VIC-IV char ROM by a program in cases when it's possible to resume the program. For example, after a program writes to VIC-IV char ROM, entering the Freezer should switch to the default PETSCII charset, and resuming from the Freezer should restore the modified charset.

One possible implementation: add new FFxxxxxx actually-read-only ROM for storing the PETSCII charset, then have Hyppo/Freezer use CHARPTR to select it on entry and restore CHARPTR on exit. Formalize CHARPTR=$10000 as "use the writeable VIC-IV char memory." This would give BASIC and programs the ability to force PETSCII without overwriting VIC-IV char ROM, as well as a way to access ROM source of truth for the original PETSCII charset even after lower ROM has been clobbered.

**Alternatives considered**
We could renege on making VIC-IV char ROM writeable. It would always contain the PETSCII charset. This would break existing programs, and would require rewriting BASIC CHARDEF. If we also make VIC-IV char ROM readable, BASIC and other programs could safely clobber ROM data at 0002D000-0002DFFF for use with CHARPTR, and could restore it any time from VIC-IV char ROM. I suspect the backwards incompatibility would be too conspicuous to allow for this option.

lydon42, 2023-03-12:
In #676 hyppo freeze/unfreeze of the chargen area was implemented.

lydon42, 2023-05-31:
@dansanderson as you can read just above: #676 did add the feature that the FREEZER can read the WOM, so it can be frozen correctly.

dansanderson, 2023-08-07:
This issue requests that Hyppo/Freezer use the default charset when displaying its own UI. It's great that it freezes it now, but to my knowledge we haven't yet implemented Hyppo/Freezer temporarily restoring the default charset for its own use. Presumably the custom changes would come back when it restores, so it just needs one more step to copy PETSCII into char memory just after freezing.

I don't think we answered the question about where Hyppo/Freezer would find the PETSCII charset. There's a ROM location, but programs can technically overwrite that. I recall asking about how char memory is initialized on boot but I don't remember if I got a response. I assume it can just be re-initialized?

Repro steps:
1. `CHARDEF 1,$FF,$FF,$FF,$FF,$FF,$FF,$FF,$FF` : This sets the letter A to a solid block.
2. Hold Restore then release to open the Freezer.
3. Press F3 to resume.

Expected: The letter A appears normally in the Freezer, then returns to a block shape after resuming.

Actual: The letter A appears as a block shape in the Freezer. (True as of 684-cartflash,20230612.07,cae3b0b.)

lydon42, 2023-08-07:
Pressing F14 loads the default charset "CHARSET.M65" or the one inside "MEGA65.ROM".

lydon42, 2023-08-07:
Not a core issue.

Closed 2023-08-07.

Thread 669 (2023-02-21):

Fix issues reported with internal sd-card

gurcei, 2023-02-21:
**Test Environment (required)**
As provided by Yuriksha and MickOz
 - Platform: MEGA65r3
 - Core Commit: 93d55f08 (tag: release-0.95)
 - ROM Release: (i.e. 920377)

**Describe the bug**
Several users have recently reported similar issues relating to problems getting mega65-config and/or mega65-fdisk working properly:

- yuriksha
- mickoz
- [remz](https://discord.com/channels/719326990221574164/909037755420520499/1076102597645172828)
- [MattJD](https://discord.com/channels/719326990221574164/719326990221574168/1076050859483484161)
- [Rob Colton](https://discord.com/channels/719326990221574164/719326990221574168/1075062023794200597)

Full details of past debugging efforts in [this lengthy discord thread](https://discord.com/channels/719326990221574164/1066882157429149697/1066882157429149697)

**To Reproduce**

Not all users are impacted by this issue, but it appears a subset of our user-base is (so potentially could relate to borderline behaviour in some of the sd-cards, as yuriksha tried a different sd-card in the internal slot and met with success - see [this thread](https://discord.com/channels/719326990221574164/1066882157429149697/1070564244619276358)). I believe the steps to replicate are:

1. Do an ALT+power on
2. Go to the mega-config menu
3. Get greeted by a message saying `there was a problem in the detection of your sd card.`

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

**Expected behavior**
Should successfully enter mega65-config, correctly detecting the sd-card.

gurcei, 2023-02-27:
Ok, I've rebased my efforts onto the development branch, will make a PR soon

gurcei, 2023-03-02:
My commit was merged into `development` branch

Closed 2023-03-02.

Thread 671 (2023-02-23):

80x50 text mode missing bottommost pixel row in NTSC only

dansanderson, 2023-02-23:
**Test Environment (required)**
 - Platform: MEGA65
 - Core Commit: 93d55f0
 - ROM Release: 920382/990003

**Describe the bug**
The VIC-IV 80x50 text display mode does not display the bottommost pixel row in NTSC. It displays all pixel rows in PAL.

I noticed this in the 80x50 text mode as implemented by ROM 920382/990003, which adds an operating mode in this resolution to the BASIC editor. I assume this is *not* specific to that implementation but general to this VIC-IV display mode.

**To Reproduce**
Steps to reproduce the behavior:
1. Install ROM 990003.
2. Ensure the MEGA65 is in NTSC video mode.
3. Press ESC then 5 to enter 80x50 text mode.
4. Cursor to the bottommost text row. Type characters with set pixels in the bottommost row, e.g. `j`, `y`, `;`, `,`, or many PETSCII graphics characters. Notice the bottommost pixel row is missing.
5. Switch to PAL mode. Notice the bottommost pixel row is present.

**Expected behavior**
All pixel rows should display in both NTSC and PAL.

**Screenshots**
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

ki-bo, 2023-03-16:
Looking at the code, I can confirm that NTSC is currently only displaying 399 raster lines between top and bottom border by default. But the root cause is actually that the top border is ending one line earlier than expected. Since the position of the character generator initializes according to the top border position, the last line is actually missing. A correct fix is moving the top border up by one pixel while letting the bottom border as is.

Closed 2023-05-25.

Thread 674 (2023-03-10):

A 1581 does not work anymore once the freezer was accessed

Schwefelholz, 2023-03-10:
**Test Environment (required)**
You can use [MEGA65INFO](https://files.mega65.org?id=3eeb7d82-8bd7-44b7-82b6-cef29d123b0e) to retrieve this.
 - Platform: MEGA65
 - Core Commit: 93d55f0
 - ROM Release: 920377

**Describe the bug**
A 1581 connected to the serial IEC bus does not work anymore once the freezer was accessed. Only a power cycle of the MEGA65 will resolve this issue. Neither a computer reset nor power-cycling the 1581 has any effect.

**To Reproduce**
Steps to reproduce the behavior:
1. Connect a 1581 (set to U11 to be able to access it at all)
2. Insert a formatted disk
3. `DIR U11` correctly displays the directory
4. Enter the freezer
5. Leave the freezer (no action necessary)
6. `DIR U11`: The activity indicator and the drive motor of the 1581 come on, but the directory is not displayed; the computer hangs
7. Run/Stop - Restore ends the hanging process, but no access to the 1581 will work until the computer is turned off/on.

**Expected behavior**
A 1581 should not be affected by entering/leaving the freezer, as is the case for a 1541 or 1571.

**Additional context**
The effect on `DIR` is just an example. `DLOAD` or `DSAVE` will hang as well. Reading the error channel, however, seems to be possible.
The effect is also there if the 1581 was powered on _after_ the freezer was entered/left.
A 1571 is proven to be unaffected.

eilers, 2024-09-01:
I followed the test case and got the following results:

R3A, Core:  0.96 6d764c4 (with hardware IEC), and ROM 920407 (with IEeC support VHWIEC4): ✅
R3A, Core:  0.96 3c10488 (without hardware IEC), and ROM 920408 (latest beta release): ❌
R3A, Core:  0.96 6d764c4 (with hardware IEC), and ROM 920408 (latest beta release): ✅

R6, Core:  0.96 6d764c4 (with hardware IEC), and ROM 920407 (with IEeC support VHWIEC4): ✅
R6, Core:  0.96 3c10488 (without hardware IEC), and ROM 920408 (latest beta release): ❌
R6, Core:  0.96 6d764c4 (with hardware IEC), and ROM 920408 (latest beta release): ✅
R6, Core: Development #124 3421b63, and ROM 920408 (latest beta release): ❌
Even the latest development core #124 still has this problem. Thus, the Core with HW IEC support fixes it.

lydon42, 2024-09-01:
@Schwefelholz you can get a IEC HW Accel core for testing on [builder](https://builder.mega65.org/job/mega65-core/job/736-hardware-iec-accel/).
It seems the work in done in #736 does solves this problem.

Schwefelholz, 2024-09-01:
I confirm it's working for me as well using [64764c4](https://github.com/MEGA65/mega65-core/commit/6d764c4f97c13db2ce3eb88a6c6df70e5d9ac149) and ROM 920395 or later.
Thank you!

lydon42, 2024-09-01:
Leaving this open & staged, as 736 is not merged yet.

Thread 677 (2023-03-11):

HYPPO: add better disk image directory handling

lydon42, 2023-03-11:
Currently only the filename of a disk image attached is stored in the process structure. If an image was loaded from a subdirectory, it is never possible to restore it after a freeze.

In addition hyppo could also store some UID of the sd card, so the entries can be invalidated if the wrong disk is inserted. Or better not?

Related FREEZER issues:
 - https://github.com/MEGA65/mega65-freezemenu/issues/62
 - https://github.com/MEGA65/mega65-freezemenu/issues/63

lydon42, 2023-03-11:
Perhaps it is also possible to just store disk UID plus some pointer onto the disk? Not sure if this is feasible with FAT. Problem with path storage: those can get quite long...

lgblgblgb, 2023-03-12:
In theory at FAT level, directory can be identified with only a single number: the starting cluster of the given directory (if it's the root directory, the starting cluster simply the cluster number of the start of the root directory but there is nothing special in that on FAT32 - though it is on FAT12/16, but it's not scope here fortunately). There is not even needed to store the textual representation of the full path, as every directory should have '..' entries to be followed to query the path then if needed. The disadvantage of this, if someone wants to see the path, not only make it working. Then the mentioned '..' following should be done to get back the path (in reversed order) till hitting the root directory. I am not sure though, how HYPPO handles these things ...

lydon42, 2023-09-03:
closing in favor of #729

Closed 2023-09-03.

Thread 679 (2023-03-14):

Comprehensive screenshot support directly in the Matrix Mode debugger

dansanderson, 2023-03-14:
**Is your feature request related to a problem? Please describe.**
The `m65` command has a "screenshot" feature that operates by using the serial debugger to read and interpret VIC register state, reading VIC screen/colour/char memory based on registers, then rendering that data into a PNG file with a rendering routine internal to the tool. This is clever and very useful for some use cases. It has the disadvantage that the `m65` tool is responsible for emulating the VIC's render, and it does not reproduce all VIC rendering behaviors. For example, sprites are not yet supported.

Automated testing would benefit greatly if it could capture a complete VIC frame composite render as implemented by the core itself. For example, an automated test driven by a PC over a serial connection can set a breakpoint then request the rendered image data. A test can diff this image against an expected image and report discrepancies. Given the composite render from the hardware, such tests would catch unexpected changes caused by the core or ROM.

In general, a composite render off of the device would be more useful than `m65`'s internal render for all cases where screenshots are useful.

**Describe the solution you'd like**
Implement a Matrix Mode debugger command that breaks at the end of the current frame, then captures a complete composite render from the VIC and streams the image data in some easy but complete format. The format probably needs to describe at least the size and colour depth of the image, but it doesn't necessarily need to stream a container format like PNG. (The tool making the call can convert the raw format into the desired format.)

**Describe alternatives you've considered**
It's possible to extend the `m65` implementation to improve the fidelity of its internal render with the actual VIC render. This feels like a losing uphill battle, and is unlikely to reproduce bugs and oddities in the actual VIC implementation. Those oddities would be a highly useful target use case for this feature, e.g. to assess the impact of fixing a VIC bug on existing software titles.

lgblgblgb, 2023-03-14:
@dansanderson  I don't think it's possible. MEGA65-core itself is not an emulator (but a hardware), unlike an emulator it does NOT have the whole frame available anywhere/anytime. It creates/generates video signal on-the-fly, the max video info it has in any given time is one scanline, and even that is only there because (among other things) RRB needs to implement the raster rewrite buffer. There is not even FPGA BRAM to implement a full frame worth of video buffer, it would be somewhere around ~1.2Mbyte BRAM (given by the fact that max resolution is needed with 23 bit colour per pixel). What you suggest here is an emulator feature, not a hardware one what a core can implement. If I remember correctly something like 1Mbyte of BRAM the FPGA has _at all_ which is already not enough, and anyway needed to implement the 384K of "fast RAM" MEGA65 has and large amount of other structures like colour RAM, ethernet buffer, various other buffers, and so on.

dansanderson, 2023-03-14:
I understand that there isn't a frame buffer memory region that holds (or could hold) a complete frame of composite image data. I don't see why whatever generates the composite render with the beam couldn't also spit that data out the serial port for a single frame. If there are throughput issues, it could take its time to generate and send the full RAW image with the CPU paused. For example, it could fill a small buffer with a fraction of the frame, output it, then sample the next fraction, and so forth.

I'm completely naive when it comes to understanding the space remaining on the FPGA for new features, so maybe it's just too expensive a request for its utility. Maybe what I need is an external hardware test harness that pauses the CPU, captures a frame off the DVI output, and does something smart to normalize a low-res full-color image for testing purposes. (The same harness could generate test inputs on the I/O ports, etc.)

For some purposes, m65's emulated render may suffice; for others, Xemu screenshots may suffice. In this case I'm thinking about assessing impact of VIC bugs (and their fixes), which I would expect would require the actual composite hardware render.

lgblgblgb, 2023-03-15:
I guess, it's of course possible to use more time to transfer the content waiting several frames and transfer only a portion of the screen content as "rolling slice" or something while CPU is stopper Or: for example there can be a new feature added to read out the RRB buffer (maybe quickly stored to a buffer so slower transfer is still possible from there) so you have one scanline, and even if the serial speed is not enough to do in real time within one frame, it may can do eg every 10th scanline or so, then needs 10 frames to have every scanlines covered in an "interlaced" way. Surely the full frame is not available as a "frame buffer" what my key point was, even the full FPGA BRAM capacity is not enough for that probably, if we does not have _anything_ used it, which is of course not true, all MEGA65 memory is there (which is not "hyper RAM" aka "attic RAM" for sure) not even mentioning colour RAM, ethernet buffer, disk I/O buffers etc etc. IIRC the total BRAM capcity of A7 200T FPGA is around 1.5Mbyte or so btw. Full frame storage for 23 bits would require somewhere near 1.2Mbyte as far as I can guess, which is clearly not enough already even now, considering BRAM usage for the existing design not even counting future features (also please note that R2 models of MEGA65 uses the 100T FPGA which has even less BRAM btw).

gurcei, 2023-08-22:
This topic gives me flashbacks of earlier days where the fpga had some logic in it to spit out the screen contents over the ethernet port in order to received on a pc by Paul's custom vncserver program, then allowing a vnc-client to connect to his vncserver and see the screen contents (albeit somewhat slowly/sluggishly).

There's still remnants of this vhdl logic within the fpga, though its in a somewhat abandoned state. Paul had intentions of abandoning it, but as these remnants still linger on, maybe there's a slim chance it could be resuscitated and might allow for the ability to screenshot the matrix-mode screen too?

Not completely sure of the feasibility of this, but just thought I'd throw the idea out there :)

Thread 683 (2023-03-15):

MEGAFLASH: cartridge and slot 0 flashing overhaul

lydon42, 2023-03-15:
With the recent C64 alpha core that supports cartridges, it would be nice if the MEGA65 can boot a specific slot if a cartridge was detected.

This will be continued in #782

Plan:
- [x] add flag so one slot can flagged as the cartridge slot
  - ~flag can be put in position 32 of the name. This is never displayed.~
  - added as extra flags fields
  - lowest slot with flag wins!
- [x] detect cartridge on startup and select cartridge core slot instead of default slot to boot
  - $D67E & $60 != $60 means ROM cartridge inserted
- [x] add check for `MEGA65-Cart`: Ultimax mode plus `M65` at $8007
  - cartridge RAM can be found at $4008000
- [x] add C128 Cartridge detection
  - define extra core slot marker for possible future C128 core
  - actually implementing real C128 cartridge support might be difficult as EXROM/GAME are not bidirectional on the mainboard
- [x] add secure slot 0 flashing (crc32)
- [x] further secure slot 0 flashing
  - only allow UPGRADE0.COR using core flasher or upgrade0.prg
  - check for MEGA65 core in slot 1
- [x] ~add visual feedback if running core hash != slot 0 core hash?~
  - ~extra field in COR header needed for hash storage?~
  - even with this it is not possible to really determine if we have started the slot 0 flasher... so it can't be done.
- [x] ~~re-add detection for non Ultimax MEGA65 style cartridge (until we know what we are doing...)~~
- [x] add ability to change cartridge core flags and default boot slot in MEGAFLASH
  - [x] add edit screen between main menu and flashing
  - [X] change display of core and flash slot information (currently only slot 0)
  - [X] when flashing a core, display flags from file and allow change before flashing
  - ~~shortcuts for (un)set all?~~
- [x] add bringup flashing via JTAG that does not need user input
- ~~(perhaps) add warning if HICKUP.M65 is found in SD Card root (where?)~~

This branch also handles:
- [x] #684
- [x] #567
- [x] #697
- [x] #370
- [x] #617
- [x] #625
- [x] #783

lydon42, 2023-03-15:
kernel64.src:4114+ does check exactly for CBM80 at $8004, so checking MEGA65 at $8009 seems to be viable.

lydon42, 2023-03-17:
The `MEGA65` check is not really necessary, we can just do it the C128 way, not lowering /GAME and /EXROM and depending just on a memory signature.
So I will remove this again and rather exchange it with a C128 core detection.

lydon42, 2023-04-10:
[mega65-tools/dev#6ed6071](https://github.com/MEGA65/mega65-tools/commit/6ed6071233d4f73a6a03b62b895c973fe2f8b006) adds bit2core caps/flags features.

lydon42, 2023-04-30:
typo in the commit message: 85f387ef7f7929fba41b849a3788b21f08aff582

lydon42, 2023-05-02:
Current plan:
 - add CRC32 calculation to core integrated MEGAFLASH
 - allow Slot 0 Upgrade from within Core integrated MEGAFLASH

lydon42, 2023-05-04:
Sucessfull borken slot 0 recovery using etherload to push upgrade0.prg!
Everything needed is in latest build of this branch and mega65-tools development (ethload tool).

gardners, 2024-01-28:
Examining problems with R3 board.
Things as I discover them:
1. Hardware-accelerated RDID reading does not work. The old soft-ware based method does.
2. mhx_writef() seems to be going crazy sometimes. I can't, for example, reliably use the flash inspector, because it stops writing to the screen.
2.1. The problem seems to be mhx_saddr gets out-of-bounds somehow.
2.2. mhx_posy doesn't reach 25 by the time cursor is at bottom of screen to scroll, so scrolling doesn't happen, and it will advance past $07E8 and potentially start corrupting things.
3. erase_sector() checks sector size using variable addr, not the address_in_sector argument that is passed to it.  This might be causing the selection of the wrong flash sector size to erase, at least some of the time.
4. read_data() uses hardware-accelerated QSPI reading, which seems to not work on R3.

In short, the nexus of the problem seems to be that the R3 QSPI flash chip and the hardware-accelerated QSPI functions in sdcardio.vhdl don't seem to work together.

gardners, 2024-01-28:
For (2) above I have patches to the flash inspector to reset the mhx cursor to 0,0 which works around the problem.

Need to look more deeply into why the hardware-accelerated QSPI functions are failing on R3.  Likely need to setup a model of the QSPI flash chip under VHDL simulation, and see what is going on.  This will require considerable effort and attention which I may not be able to invest until after the blocking issues for R5/R6 are solved in 0.96, in particular the expansion port issues.

lydon42, 2024-07-02:
Continued in #782

Closed 2024-07-02.

Thread 689 (2023-04-16):

Strange blemishes/artifacts when using 640x400 16 colour bitplane graphics mode

gurcei, 2023-04-16:
**Test Environment (required)**
 - Platform: MEGA65
 - Core Commit: release 0.95 (batch2)
 - ROM Release: (i.e. 920377)

**Describe the bug**
Drawing graphics in 640x400 16-colour bitplane graphics mode results in mild blemishes on the screen

**To Reproduce**
Steps to reproduce the behavior:
Either play "Onion Cake and the Hungry Dinosaurs"
- https://files.mega65.org/?id=e15d97b6-af4d-47a0-969a-3a6691034bfd

Or play around with 640x400 16 colour mode directly in BASIC with:
`SCREEN 640, 400, 4`

And then try a few BASIC line, box, circle calls.

lydon42, 2023-05-10:
Example from #701
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

gurcei, 2023-05-12:
I've documented issues with drawing horizontal lines in various colours in this discord thread:
- https://discord.com/channels/719326990221574164/782759365064917065/1106523564326277160

Key insights were:
- Colours 0 to 7 draw fine regardless of which y position the horizontal line is on
- Colours 8 to 15 are problematic and they all share the following behaviour:
  - For y=0 to 5, they draw the horizontal line in the correct colour
  - For y=6, they lose bit3 of their colour index. I.e.:
    - orange becomes black
    - brown becomes white
    - lt red becomes red
    - dk grey becomes cyan
    - grey becomes purple
    - lt green becomes green
    - lt blue becomes blue
    - lt grey becomes yellow
  - For y=7, two orange horizontal lines are drawn on y=6 and y=7

stricq, 2023-07-14:
Yes, I've noticed this as well by modifying the Hopalong program on the demo disk to run in 640x400x16.  Colors 0-7 work fine, but colors 8-15 draw as different colors on approximately every 8th row.

ki-bo, 2023-07-15:
> Yes, I've noticed this as well by modifying the Hopalong program on the demo disk to run in 640x400x16. Colors 0-7 work fine, but colors 8-15 draw as different colors on approximately every 8th row.
>

Can you provide the modified sample program for reproduction?

dansanderson, 2023-07-16:
This is interesting:

```
5 screen 640,400,4
6 pen 9
10 for y=0 to 64
20 line 0,y,300,y
30 getkey a$
40 next y
50 screen close
```

Expected behavior: It draws a single brown horizontal line at the top of the screen. Each time you press a key, it draws another brown horizontal line one pixel below it, gradually drawing a brown rectangle.

Actual behavior: The first thing you see is a white line in row 0 and an orange line in row 1. That's just from the first `LINE` command, y=0. On the next keypress, y=1, both lines turn brown. y=2: now there's a white line on row 2 and an orange line on row 3. y=3: both lines turn brown. It's like this all the way down. (I don't see different behaviors every eight lines in this example.)

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

Reproduced here with core 683-cartflash,20230612.07,cae3b0b, ROM 920383.

dansanderson, 2023-07-16:
... Trying the other colors C, on the even lines I'm seeing C-8 on the intended line and orange (8) on the line below.

If I STEP 2 from Y=0 (draw even rows), I get C-8 on Y and 8 on Y+1. If I STEP 2 from Y=1 (draw odd rows), they're flipped, including the first line drawing 8 on line 0 and C-8 on line 1.

ki-bo, 2023-07-16:
Seems like this was already the case with batch 2 release core.

stricq, 2023-07-16:
`100 REM HOPALONG FRACTAL DEMO FOR MEGA65
110 REM STEPHAN KLEINERT, AUG 2020
120 :
125 MX=320:MY=200
130 POKE 0,65
150 PRINT"** HOPALONG FRACTAL FOR THE C65/M65 **"
160 PRINT"   S. KLEINERT, AUGUST 2020"
170 PRINT"WHILE RENDERING, PRESS ANY KEY TO ABORT"
180 PRINT"CURRENT FRACTAL AND START A NEW ONE, OR"
190 PRINT"PRESS Q TO QUIT."
200 PRINT:PRINT"PRESS ANY KEY TO START!"
210 GETKEY A$
220 GRAPHIC CLR
230 SCREEN DEF 1,1,1,4
240 SCREEN OPEN 1
250 SCREEN SET 1,1
255 BORDER 0
260 GOSUB 900
350 DO
360 N=0 : REM NUMBER OF POINTS
370 P=INT(RND(.)*15)+1 : REM CURRENT PEN
380 SCREEN CLR 0
390 PEN 0,P
400 A=-200+(INT(400*RND(3)))
410 B=-50+(INT(100*RND(3)))
420 C=-200+(INT(400*RND(3)))
430 X=0:Y=0
440 DO
450 N=N+1:IF N=3072 THENN=0:P=P+1:PEN 0,P:IF P=15 THEN P=0
460 NX = Y+SGN(X)*SQR(ABS(B*X-C))
470 NY=A-X
480 X=NX
490 Y=NY
492 IF X+MX < 0 OR Y+MY < 0 THEN 510
494 IF X+MX > 640 OR Y+MY > 400 THEN 510
500 DOT ABS(X+MX),ABS(Y+MY)
510 GET A$
520 LOOP WHILE A$=""
530 LOOP WHILE A$<>"Q"
540 SCREEN CLOSE 1
550 PALETTE RESTORE
560 PRINT"THANK YOU & HAVE A NICE DAY."
570 END
600 REM ORIGINAL 8 COLORS
610 PALETTE 1,0,0,0,0
620 PALETTE 1,1,0,12,3
630 PALETTE 1,2,15,0,9
640 PALETTE 1,3,0,6,15
650 PALETTE 1,4,8,0,9
660 PALETTE 1,5,12,15,1
670 PALETTE 1,6,15,0,15
680 PALETTE 1,7,4,3,12
690 PALETTE 1,8,12,11,5
700 RETURN
800 PALETTE 1, 0, 0, 0, 0
805 PALETTE 1, 1,15,11, 9
810 PALETTE 1, 2,15,12, 9
815 PALETTE 1, 3,15,14, 9
820 PALETTE 1, 4,15,15, 9
825 PALETTE 1, 5,12,15, 9
830 PALETTE 1, 6, 9,15, 9
835 PALETTE 1, 7, 9,15,12
840 PALETTE 1, 8, 9,15,15
845 PALETTE 1, 9, 9,12,15
850 PALETTE 1,10, 9, 9,15
855 PALETTE 1,11,10, 9,15
860 PALETTE 1,12,14, 9,15
865 PALETTE 1,13,15, 9,15
870 PALETTE 1,14,15, 9,12
875 PALETTE 1,15,15, 9,10
880 RETURN
900 PALETTE 1, 0, 0, 0, 0
905 PALETTE 1, 1,15, 0, 0
910 PALETTE 1, 2,15, 4, 0
915 PALETTE 1, 3,15, 9, 0
920 PALETTE 1, 4,15,13, 0
925 PALETTE 1, 5,15,15, 0
930 PALETTE 1, 6,10,15, 3
935 PALETTE 1, 7, 0, 8, 0
940 PALETTE 1, 8, 0, 8, 8
945 PALETTE 1, 9, 4,14,13
950 PALETTE 1,10, 8,12,14
955 PALETTE 1,11, 0, 0,15
960 PALETTE 1,12, 3, 0, 8
965 PALETTE 1,13,13, 7,13
970 PALETTE 1,14,15, 0,15
975 PALETTE 1,15,15,11,11
980 RETURN
`

dansanderson, 2023-07-16:
Correct, this is an old issue, not a recent regression.

gurcei, 2024-12-08:
I shared some thoughts on discord that possible cause might be a timing issue, getting through such a long pipeline of activity (8 sprites, 8 bitplanes):
- https://discord.com/channels/719326990221574164/977076334297743360/1315389556199260311

I've heard the vhdl gurus speak of using timing constraints to tighten up such things, but I'm not skilled enough in vhdl to know what to do.

Maybe other vhdl gurus in the community might have some idea on what could be done.

gurcei, 2024-12-10:
Ok, I tried removing the sprites from the pipeline to see if that helped resolve the issue, no it didn't, so it's not that.

In other news, I finally understand why I couldn't see the blemish pattern dddaaannn described in an earlier comment. He was in NTSC mode, and I was in PAL mode. Seems like the blemish pattern was different depending on that choice. I left a vid on discord of this:
- https://discord.com/channels/719326990221574164/977076334297743360/1316126421961412660

gurcei, 2024-12-21:
Making some good progress on this issue, some more details in this discord thread:
- https://discord.com/channels/719326990221574164/977076334297743360/1320031889775398912

The workaround/solution is still in a fairly early experimental phase and I'll try clean it up and test it out more thoroughly in the coming days.

gurcei, 2025-01-08:
Good news, the solution has been merged into development, will close this one off now :)

https://github.com/MEGA65/mega65-core/pull/850

Closed 2025-01-08.

Thread 694 (2023-04-29):

1351 (and MouSTer attached other mouses) exhibit jumps

gardners, 2023-04-29:
**Test Environment (required)**
You can use [MEGA65INFO](https://files.mega65.org?id=3eeb7d82-8bd7-44b7-82b6-cef29d123b0e) to retrieve this.
 - Platform: MEGA65
 - Core Commit: 61c36ef, but affects all since about 2016
 - ROM Release: N/A

**Describe the bug**
Using a 1351 (or MouSTer connected USB mouse) works fine, except that it jumps at regular intervals by about 32px. This is because the POT input is reading the 1351 as range ~ $00-$60, instead of ~$00-$7F.

**To Reproduce**
Steps to reproduce the behavior:
1. Plug in 1351 mouse (not Amiga mouse with 1351 emulation enabled, as that doesn't use the POT lines)
2. Load something that uses the mouse, and doesn't have a driver that compensates for this hardware bug, e.g., Mirage_BD's mod player / MEGAui examples.
3. Move mouse smoothly and you will observe the big jumps periodically. It is basically impossible to move the mouse cursor into the jumped regions.

**Expected behavior**
Mouse moves smoothly without skipping large slabs of the screen

**Screenshots**
Schnapps hasn't been ported to the MEGA65, and have no shot glasses, so no screen shots available

**Additional context**
The root cause looks to be that mouse_input.vhdl is so old it assumes CPU clock of 50MHz instead of 40.5MHz, which means that it counts too slowly (40.5MHz / 50 = 0.81MHz), which means that when it is counting the POT line up/down time on a 1351 type device that asserts the pot line after a carefully timed value, will be mis-read.  This is stopping the full range of values being read.

Since we see $60 instead of $80, fixing this slow counting should increase this to $60 x 50/40.5 = $76 or so, which hopefully will be enough. If not, further investigation will be required.

gardners, 2023-04-29:
Confirmed fixes bug in MIRAGE_BD's mod player and via testing of PEEKing the POT lines and also `MOUSE ON` command in BASIC65.
Should be back-ported to development

Closed 2023-04-29.

Thread 708 (2023-05-25):

ETH controller stops sending packets sometimes

ki-bo, 2023-05-25:
**Test Environment (required)**
You can use [MEGA65INFO](https://files.mega65.org?id=3eeb7d82-8bd7-44b7-82b6-cef29d123b0e) to retrieve this.
 - Platform: M65 R3
 - Core Commit: development 9f62d257
 - ROM Release: 920377

**Describe the bug**
When using mega65_ftp over ethernet, the transfer works fine but sometimes the packets sent are not seen on the wire anymore. This leads to the PC re-transmitting packets in an endless loop as it doesn't get its ACK packets anymore.

With the latest version of mega65_ftp in development, there is a timeout implemented. If the PC does not get any response from the MEGA anymore, it sends a special "ETH reset request" packet and the MEGA reset the ETH controller. This seems to help a bit, but the issue occurs again after some time.

It seems the issue is in the core, as it is confirmed the data in the eth tx buffer is correct and the tx trigger is also correctly executed. The eth reset workaround is not ideal as it leads to a stall until the timeout is reached.

It is not clear whether there is not activity on the wire at all or just malformed signals that are filtered out by the connected Ethernet equipment (switch/PC). In Wireshark at least, there is no packet at all seen from the MEGA if we run into this state. RX obviously continues to work as the MEGA reports duplicate packets all over (it receives re-transmissions for packets it already acknowledged before).

**To Reproduce**
Steps to reproduce the behavior:
1. Use mega65_ftp with ethernet from latest development branch
2. Transfer files to the SD card until you run into the hanging state
3. See the PC trying to reset the eth controller by sending reset requests after some seconds with no reply from the MEGA

**Expected behavior**
All packets should be sent out as expected

**Screenshots**
If applicable, add screenshots to help explain your problem.

**Additional context**
Add any other context about the problem here.

ki-bo, 2023-06-21:
Potentially fixed by this commit:
https://github.com/MEGA65/mega65-core/commit/23b2368dfc34e63c13e66b3c00d58d435bb30616

ki-bo, 2023-08-07:
Haven't seen this bug after heavy usage in the last weeks, and also don't see reports of it happening at the moment.
As the bug appeared very randomly and needs external Ethernet data transfers I won't write a test case for it. The wrong behaviour can't be triggered by known reproduction steps.

Closing this one.

Closed 2023-08-07.

Thread 714 (2023-08-01):

Flipping the FAST bit of D031 resets SCRNPTR inappropriately

dansanderson, 2023-08-01:
**Test Environment (required)**
You can use [MEGA65INFO](https://files.mega65.org?id=3eeb7d82-8bd7-44b7-82b6-cef29d123b0e) to retrieve this.
 - Platform: MEGA65
 - Core Commit: cae3b0b
 - ROM Release: 920384

**Describe the bug**
An update to any of the bits in the VIC-III mode register D031 triggers Hot Register updates to VIC-IV registers like SCRNPTR, even if the mode bits related to those registers have not changed. This is a problem for 80x50 mode, which relocates SCRNPTR to 4.0800. Certain immediate mode actions attempt to flip the FAST flag (bit 6) of D031 temporarily using `lda #%01000000; trb vic+49`, but this causes SCRNPTR to reset to 0.0800, with the effect of showing 80x50 characters at 0.0800: the screen as it appeared before switching modes plus half a screen of junk. Actions that cause this include `SPEED 1` (naturally), DOS commands, and ringing the bell (Ctrl-G or `PRINT CHR$(7)`).

Originally reported for the ROM: https://github.com/MEGA65/mega65-rom-public/issues/43

**To Reproduce**
Steps to reproduce the behavior:
1. Press ESC then 5 to enter 80x50 mode.
2. Press Ctrl-G to ring the bell.

**Expected behavior**
There should be a way to flip the FAST flag of D031 without resetting SCRNPTR. Ideally, the method that the ROM is using would not propagate a reset of SCRNPTR. An update to D031 would detect which bits have changed, and only propagate Hot Register changes related to those bits.

If there exists a way to do this please let me know and I'll update the ROM.

lydon42, 2023-08-01:
So essentially only set viciv_legacy_mode_registers_touched at D031 if something except viciii_fast_internal was set? That's a lot of comparisons... perhaps if we can trim it down to the registers that are really used in the hotreg update functions...

lydon42, 2023-08-03:
Fix does remove the problem.

lydon42, 2023-08-04:
There was some discussion on discord, that it might be bad to have a 1 bit exception for hotreg triggering and that we should keep the rule simple: **writing to a hotreg** does trigger the recalculation.

The other solution would be to change how the trigger handling works.

Currently every write to as hotreg sets the flag for recalculation, even when hotregs are disabled. So if you disable hotregs, then write to some trigger registers (_setting the recalc flag_) and then re-enable hotregs, this will trigger a recalculation immediately.

@lgblgblgb proposed that this behavior is changed instead, and that writing to hotregs, _while they are disabled_, does not trigger a recalc afterwards, when hotregs is enabled.

There are two ways to do this:
1) Clear the recalc flag when HOTREG bit goes from 0 -> 1. So enabling HOTREG will **never** trigger a recalc.
2) Clear the recalc flag when HOTREG bit goes from 1 -> 0. So you need to set HOTREG to 0 then to 1 to clear the flag and enable HOTREG again.

Why propose the second method? The first could potentially break programs that intentionally disable HOTREG, change a bunch of things, then enable HOTREG to apply at once. But I honestly don't see that anyone is doing that...

dansanderson, 2023-08-04:
Clarification from discussion: option #2 would reset the propagation flag for any write of 0 to HOTREG, so the procedure to change a hot reg without triggering propagation would be:

1. Set HOTREG to 0.
2. Update the VIC-II register, e.g. D031 FAST = ... This sets the hot reg propagation flag.
3. Write a 0 to HOTREG again. This clears the propagation flag.
4. Set HOTREG to 1. No propagation occurs because the flag is clear.

This preserves the (admittedly obscure) existing use case where setting HOTREG to 0, touching a hot register, then setting HOTREG to 1 triggers propagation. It's an unusual procedure, but it's an unusual use case, and overall I think the design is clean and easy to understand.

lgblgblgb, 2023-08-04:
@lydon42 Ok that makes sense. So the hotreg bit transition table now (I think, it would worth to have the manual with something like this to avoid any possible confusion):

HOTREG bit value transitions:

| old value | new value written | effect         |
|-------------|-------------------------|----------------|
|      1       |               0             | Disable hotregs |
|      0       |                1            | Enable hotregs, any possible trigger (stored during disabled state)  is processed then trigger is cleared |
|      0      |                0            | Clear possible pending trigger, so 0->1 transition won't cause to re-calc |
|     1      |                1            | No effect, hotregs will remained enabled |

lydon42, 2023-08-04:
The table is somewhat misleading... the current implementation (with the last commit) is:
- writing 1 to `HOTREG` sets `HOTREG`.
- writing 0 to `HOTREG` clears `HOTREG` and `viciv_legacy_mode_registers_touched`

lydon42, 2023-12-23:
Needs documentation?

dansanderson, 2024-01-25:
I believe HOTREG is accurately documented.

Closed 2024-02-24.

Thread 721 (2023-08-20):

MEGA65R4 core 3.5mm audio output stops and requires a power-off for 15 seconds to recover

gardners, 2023-08-20:
**Test Environment (required)**
MEGA65 R4

**Describe the bug**
Audio stops working on 3.5mm jack after some unknown time or situation.

**To Reproduce**
Leave MEGA65 R4 on for some time. Try to use 3.5mm audio, repeat until it doesn't work any more.

**Expected behavior**
Audio should be present, but isn't

**Screenshots**
[funnycat.gif not found]

**Additional context**
PGS has confirmed the bug, and will investigate it by adding access to ADC I2C registers. Probably something sets or something, and needs reseting.

ki-bo, 2024-02-24:
This one was reported to be fixed according to @gardners , closing

Closed 2024-02-24.

Thread 722 (2023-08-26):

Stuck in Onboarding after going there from Configuration

dansanderson, 2023-08-26:
**Test Environment (required)**
- Platform: MEGA65
- Slot 0: 683-cartflash,20230612.07,cae3b0b
- Slot 1: development,20230816.13,ea3508e

**Describe the bug**
I got stuck in Onboarding after going there from Configuration via "Exit and reboot to onboarding." Leaving Onboarding, pressing the reset button, and powering off and on all returned to Onboarding. I can enter the utility (Alt) and core (No Scroll) menus in this state.

I was able to remove the external microSD card, copy off data to a PC, then reformat the microSD card in the MEGA65 SD card utility. For SD card files, I selected the development core in slot 1. After reinstalling the ROM file and rebooting, it entered Onboarding one more time, then I was able to save and exit without issue.

I could then reproduce the issue by going back to Configuration, "Exit and reboot to onboarding." I would have called it a fluke except that I can reproduce it.

lydon42, 2023-12-10:
Fixed by not resetting at the end, but asking the user to power cycle.
This also avoids booting into the slot 0 core by accident.

Closed 2023-12-23.

Thread 726 (2023-08-29):

Fail faster when floppy drive is empty

dansanderson, 2023-08-29:
When the internal 3.5" floppy drive is mounted and does not contain a disk, an attempt to access the disk pauses for a few seconds. It would be an improvement to shorten this delay as much as possible.

This is especially true in the case where the MEGA65 is configured to auto-mount the floppy drive, and there is no disk in the drive when the computer is switched on. (Configuration Utility: Chipset > F011 Disk Controller = 3.5" Floppy Drive.) In this case, boot pauses before displaying the READY prompt.

ki-bo, 2024-01-05:
I just tried this again, and for me this is even worse:

`MOUNT
DIR`

will hang forever. I can hit RUN/STOP + RESTORE, then the cursor is gone. But in general, the error handling of the internal drive seems to be broken. This is already the case with a 0.95 release core btw.

lydon42, 2024-01-05:
This is something the to be refurbished d81_detach0/1 will do better, as it will include the option to directly mount the internal drive in the detach call.
See #628

ki-bo, 2024-01-05:
> This is something the to be refurbished d81_detach0/1 will do better, as it will include the option to directly mount the internal drive in the detach call. See #628

I am not sure if I can follow you. This issue is not about problems when switching between images and real floppy drive, but rather the general problem that the ROM locks up if you try to access the drive while there is no disk inserted. This already happens if you don't do `MOUNT` in Basic (or via Freezer) but already if you just set CONFIGURE to select the internal drive on boot-up.

ki-bo, 2024-01-05:
As the original Commodore ROM also locks up, and all MEGA65 ROMs I tried to far, makes me wonder whether the code has an issue behaving weird when reading without any disk inserted.

gardners, 2024-04-27:
@ki-bo and I have determined that the index hole and RDATA lines both are idle when there is no disk inserted. We can thus fail early if the motor is turned on, but no changes are noticed on either of those lines.

gardners, 2024-04-27:
floppy seems to be correctly marked as not present when motor is spinning, but RNF is not asserted immediately when trying to read a sector, when we know that no disk is inserted. As a result, the ROM still waits many seconds when starting up without a floppy in the drive if using the real drive is enabled by default.

gardners, 2024-04-28:
This little program can be used to help investigate:
```
10 POKE$FFD3080,$60                                                      
 20 SLEEP 1                                                               
 30 POKE$FFD3084,$00                                                      
 40 POKE$FFD3085,$01                                                      
 50 POKE$FFD3086,$01                                                      
 60 POKE$FFD3081,$40 : REM READ SECTOR                                    
 70 PRINTHEX$(PEEK($FFD3082));" ";HEX$(PEEK($FFD3083))                    
 80 IFPEEK($FFD3082)AND$80 THEN SLEEP 0.2: GOTO 70   
 ```

gardners, 2024-04-28:
It finishes quickly with a disk in, but takes ~1.5 seconds without a disk, and the RNF flag (bit 4 of $FFD3082) never gets set until after BUSY is cleared.

gardners, 2024-04-28:
Was not checking disk present flag during reads. This is likely to fix the problem

gardners, 2024-04-28:
Confirmed fixed.

gardners, 2024-05-02:
@ki-bo noticed a bug: Running DIR fails every other time now.
$D082 contains either 4 or 32, with 32 typically meaning it will work, and 4 that it will fail. But if run in a BASIC program loop it works everytime. So I am guessing it is about the timeout for disk detection triggering _after_ the last request has been serviced, and before the computer looks at the drive again.

Holding down F3 so that DIR runs continuously from BASIC prompt still has it fail every other time, though.

lydon42, 2024-05-27:
As this is still not the full fix, I just reverted the changes from development.

Thread 731 (2023-09-10):

VIC-III errata level register

dansanderson, 2023-09-10:
We currently offer VIC-III bug fixes that cause backwards compatibility issues with early MEGA65 software behind a register flag that is off by default: D07A.5. New software can enable the flag to get all the fixes; old software doesn't know about it and runs with old behavior that otherwise matches the C65 prototype. This has the problem that software written between two bug fixes may need old fixes enabled and new fixes disabled.

Based on SteerCo conversations, we think it might be better for an 8-bit register at $D08F to represent the "errata level," where each set of fixes is assigned to a new level. We don't expect to need more than 256 levels in the history of the project. This level is $00 at the boot state, so software will need to opt in to whatever level it is known to be compatible with, and won't be affected by future fixes.

dansanderson, 2024-01-19:
This is fixed in v0.96. I don't know how we want to tag or manage the issue while the release is in progress.

Closed 2024-06-05.

Thread 733 (2023-09-14):

TI drifts in NTSC mode

dansanderson, 2023-09-14:
**Test Environment (required)**
Platform: MEGA65
ROM Release: 920385
Core Commit: cae3b0b

**Describe the bug**
The TI timer variable counts inaccurately in NTSC mode.

**To Reproduce**
```
5 T=TI
10 ?TI-T:GOTO 10
```
Run this along with a stopwatch. In PAL mode, it matches. In NTSC mode, it drifts by about a second per minute.

**Additional context**
This was originally filed as https://github.com/MEGA65/mega65-rom-public/issues/78 to research whether the ROM is setting registers correctly. We fixed an issue where TOD50 was not being set correctly in NTSC mode, but this didn't fix the drift, and would not have adequately explained the drift anyway. I don't know enough about expected behavior of the CIA to know if this is a core issue, but I don't have any active leads on changes that could be made in the ROM, so I'm creating a corresponding core issue for further research.

lydon42, 2023-12-12:
Something seems to be wrong here... if I change NTSC/PAL with freezer, then do clr ti, I always end up with 193 in DD0E. This seems to be wrong.

lydon42, 2023-12-12:
And it's 50Hz vs. 60Hz, which means if you have the wrong TOD50 setting you should be loosing a just over a second every ten seconds (this is what I was seeing in my 14 sec RTC tick test).

dansanderson, 2023-12-12:
I only see references to CIA2 in the ROM code for TI, I don't know why.

lydon42, 2024-08-17:
The rom issue has been long fixed, so I guess we can close this, too.

dansanderson, 2024-08-17:
I believe we left this issue open to further investigate an underlying issue in the core with the CIA TOD50. The ROM has been fixed to use a different scaling constant for NTSC mode instead of flipping TOD50, so the BASIC TI is good.

In the other ticket I said, "I tried to make a version of this that set TOD50 based on the VIC_PAL register, and it didn't seem to make a difference. More research is needed to figure out why." It's possible I was just using it incorrectly, but I think I expected flipping TOD50 to fix this issue without an alternate scaling constant. /cc @johnwayner

Closed 2024-08-17.

Thread 751 (2023-12-02):

v0.96: Amiga mouse toggles right mouse button signal on mouse move

dansanderson, 2023-12-02:
**Test Environment (required)**
You can use [MEGA65INFO](https://files.mega65.org?id=3eeb7d82-8bd7-44b7-82b6-cef29d123b0e) to retrieve this.
 - Platform: MEGA65
 - Core Commit: development core near 20231014
 - ROM Release: 920377 / 920390

**Describe the bug**
The BASIC command RMOUSE reports right mouse button presses during mouse movement when an Amiga mouse is connected to ~~port 1~~ either port, and the port is correctly configured in Amiga mouse mode.

This can only be reproduced with the latest dev core and not release v0.95. It appears to be a regression since the last stable core release. It can be reproduced in both v0.95 stable ROM 920377 and latest ROM beta 920390, so it is specific to the core.

**To Reproduce**
Amiga mouse in port 1, Configuration set to Amiga mouse for port 1, "aggressive."

```
10 MOUSE ON,1
20 RMOUSE MX,MY,MB
30 PRINT MX,MY,MB
40 GOTO 20
```

Move the mouse, click the buttons.

Expected: third column stays 0 during mouse movement, adds 128 for left button and 1 for right button.

Actual: third column flickers 1 during mouse movement. Adds 128 for left button (correct) but does not notice right button (incorrect).

Can repro in port 2 also: make sure config for port 2 is set correctly, then change line 10 to `MOUSE ON,2`.

**Additional context**
Originally reported as ROM bug, but does not appear to be a ROM issue: https://github.com/MEGA65/mega65-rom-public/issues/90

As noted by @johnwayner:

> A key difference between the wiring of an Amiga mouse vs a 1351 is that the vertical pulse is connected to the same pin that a 1351's right mouse button is connected to. So it's not surprising that the right mouse button would appear to change when moving vertically.

gardners, 2024-01-18:
does this happen at the hardware level, i.e., can it be reproduced using assembly language, instead of BASIC commands?

dansanderson, 2024-01-18:
I concluded this was hardware based on the ROM code for RMOUSE, which is reading the buttons straight off of $DC00. My CIA-foo is weak but I believe it's storing $FF to $DC00, then reading $DC00 bit 0 (inverted) for right mouse button in port 1.

https://github.com/MEGA65/mega65-rom/blob/073435d9855506bb3d3e2151026799b76722bb32/b65.src#L17648

gardners, 2024-01-18:
It would be great if we can write a minimal assembly test for this, so that I can work against that. I'm also curious how long the transient is

dansanderson, 2024-01-18:
This does the trick:

```
!cpu m65
!to "rmouse.prg", cbm

bsout = $ffd2
CIA1_PRA   = $DC00

* = $2001

!8 $12,$20,$0a,$00,$fe,$02,$20,$30,$3a,$9e,$20
!pet "$2014"
!8 $00,$00,$00

    lda #147
    jsr bsout

loop:
    sei
    ldz CIA1_PRA    ;Set up port & read buttons
    lda #$ff        ;save kybd output lines (IRQ already disabled)
    sta CIA1_PRA    ;set to not read any kybd inputs
    lda CIA1_PRA+1
    and #%00010001  ;want left, right buttons only
    eor #%00010001  ;(invert, since low means button down)
    stz CIA1_PRA
    cli

    jsr write_hex
    lda #13
    jsr bsout
    jmp loop

write_hex:
    ; Writes A as two hex digits and a space
    ; Restores A
    pha
    lsr
    lsr
    lsr
    lsr
    and #15
    cmp #10
    bcc +
    adc #6
+   adc #'0'
    jsr bsout

    pla
    pha
    and #15
    cmp #10
    bcc +
    adc #6
+   adc #'0'
    jsr bsout

    lda #' '
    jsr bsout

    pla
    rts
```

[rmouse.prg.zip](https://github.com/MEGA65/mega65-core/files/13975505/rmouse.prg.zip)

gardners, 2024-01-18:
Is someone able to test bitstreams to determine at which commit it began happening? That would help to narrow it down.

Meanwhile, I am trying to look at mouse_input.vhdl to understand the root-cause.

gardners, 2024-01-18:
No need: The problem is that it uses the generated pot value, rather than reading the pot pin directly.

gardners, 2024-01-18:
Above commit is likely to fix the problem

ki-bo, 2024-01-18:
Just tested 3fc5d40 on R3a, but still I see the button state react on vertical mouse movement (Amiga mouse, conservative mode)

dansanderson, 2024-01-19:
Can we tag this for v0.96? (I don't have admin access to this repo.)

ki-bo, 2024-01-20:
> Can we tag this for v0.96? (I don't have admin access to this repo.)

done

johnwayner, 2024-01-20:
@gardners Perhaps I'm just missing something, but I don't see where `fa_up_out` (and friends) are actually mapped to anything outside of mouse_input.  `pota_x` (and friends) are used in iomapper, for example.

dansanderson, 2024-01-23:
This erroneous effect is no longer limited to port 1 now that the v0.96 core has repaired paddle/mouse movement on port 2. I can reproduce the right mouse button flicker on vertical movement in both ports. Hopefully that clarifies the issue.

gardners, 2024-01-26:
Confirmed that I can reproduce the problem using MouSTer set to Amiga mouse mode:
left button works as expected, but right button doesn't work, and instead responds to (I think) vertical motion of the Amiga-mode mouse.

gardners, 2024-01-26:
The processed fa_out from mouse_input was not being used.  Above commit attempts to remedy this.

gardners, 2024-01-26:
That commit has changed the behaviour of the right button detect, but not fixed it: It no longer changes with movement, but it also doesn't report the state of the right button.

gardners, 2024-01-26:
That commit stops the joy direction lines showing the raw Amiga mouse stuff on UP, DOWN, LEFT and RIGHT. But the 2nd mouse button is permanently stuck low, i.e., bit 0 for UP is 0, instead of floating at 1.

This means the problem is with reading the fx_potx line in mouse_input.

gardners, 2024-01-27:
So, the Amiga mouse doesn't have a pull-up on the right-button line. This means that it will read as always active on a C64, and a MEGA65 as well, since both implement the POT inputs without a pull-up. Apparently a work-around is to add a pull-up to the mouse.

See:

https://www.mssiah-forum.com/viewtopic.php?pid=13749

In terms of how we fix this in the MEGA65, there is no immediately clear solution.  This also explains why the right button always appears to be active on the Amiga mouse when plugged into a MEGA65.

gardners, 2024-01-27:
Work-around for now is to check for POT AX going low and high at some point. Only after we have seen both values on the POT AX line, do we make fa_up try to follow amiga right button on POT AX.

dansanderson, 2024-01-27:
I got ahold of a friend's Amiga mouse, the later [Escom Amiga 1900](https://www.ami64.com/product-page/amiga-technologies-escom-original-amiga-mouse). Works on original Amiga hardware, tested on an A3000.

On both cartflash-683 build #64 (without newer fixes) and latest 751-amiga-mouse-right-button-glitching: *no* X/Y movement, right mouse signal flickers on Y movement, clicking the right mouse button registers as X movement.

New discovery: mouSTer X/Y works on port 1 but *not* on port 2. On port 2, mouSTer is same as Amiga 1900 mouse on both ports.

I'll dig out a vintage tank mouse to compare.

gardners, 2024-01-28:
Meanwhile, I filed an issue on the MouSTer repo asking for optional pull-up on Amiga right and middle buttons, that would allow C64s and MEGA65s to read those buttons without requiring a special cable with pullup in it. https://github.com/willyvmm/mouSTer/issues/38

dansanderson, 2024-01-28:
Results of testing the #751 fix build 11, R5 board, core slot 1:
* 1351, ports in 1351 mode: fully functional; both ports
* Vintage Amiga mouse, ports in Amiga mode (aggressive): x/y works, both left and right buttons broken (no signal; RMOUSE reports 0); both ports
* mouSTer in Amiga mode, ports in Amiga mode (aggressive): x/y works, left button works (RMOUSE reports 128), right button broken (RMOUSE reports 0); both ports

Right button flicker fixed, no interference between x/y and buttons.

It sounds like vintage Amiga mouse left button not working is unexpected. It'd be worth me trying to confirm that this mouse's left button is functional. I don't have a working Amiga set up at the moment, so I'd have to do this with test equipment. I can try to look up the details on how the buttons work electronically, but someone can save me some time by explaining it.

gardners, 2024-01-28:
Thanks. The vintage Amiga mouse left button is a mystery, as connecting pins 6 and 8 should indeed cause it to trigger.  What resistance do you see between pins 6 and 8 with left button pressed?

dansanderson, 2024-01-28:
5.5 ohms.

lydon42, 2024-01-29:
Also check #742 and #754 against this branch!

gurcei, 2024-01-29:
I'm a little late to this party, trying to catch up with the thread above. Ok getting the sense this missing pull-up resister is a factor

Last night tried testing build #14, not sure if gardners wanted this one to be tested or he was still midway with changes. Anyway, will report back my results with it on my amiga-mode mouster. It was still behaving the same:
- left mouse button works fine
- right mouse button not working

I'm getting curious about this "adding a pull up resistor" approach. Wondering if I could solder up such a pull-up between two db9's (one female the other male) to be a "repair" dongle of sorts.

dansanderson, 2024-08-21:
The original right button flicker on mouse movement issue has been fixed and is in v0.96. Maybe we can open a new issue for the right mouse button not working, if that's also something we can fix. Resolving.

Closed 2024-08-21.

Thread 752 (2023-12-03):

CONFIG: boot to default core after exiting config

dansanderson, 2023-12-03:
**Is your feature request related to a problem? Please describe.**
When I cold boot to the Configuration utility (hold Alt while switching on power), it boots with core slot 0 and loads Configuration from there. When I exit the Configuration utility, it proceeds to complete the boot sequence with core slot 0. This is counter-intuitive for people who normally keep a newer MEGA65 core in slot 1 (i.e. the default boot slot).

**Describe the solution you'd like**
The Configuration utility should start the boot process from the very beginning when exiting, including core slot selection. This better meets user expectations, and doesn't require communicating any additional information to the user.

**Describe alternatives you've considered**

1. Prefer loading the Configuration utility from the default boot core slot if appropriately populated, such that when exiting Config it proceeds to boot with the same core that loaded Config. Booting into a potentially newer (and core-matched) version of Config by default might be a useful bonus. (IIRC you can force loading Config from a specific slot by by starting the core from the core selection menu then holding Alt, which would be a way to force loading Config from slot 0 if needed.)
2. Have Configuration (from slot 0) detect whether there is a MEGA65 core in slot 1 or 2, and communicate this fact during exit. For example, it could be a message on the exit screen ("Save settings and boot to core slot 0"), a prompt that offers to reboot into the core selection screen, or just always boot into the core selection screen when this state is detected. (I would not have Config *always* exit to core selection: that'd be confusing in the common case of a machine with only slot 0 populated.)
3. Make this a feature of the Alt utility menu ("4: Boot with the default core"), and have Config exit to this menu instead of continuing the boot sequence. (Not my favorite option just because the Alt menu looks a bit tech-y right now, but it's a relatively intuitive UI flow: you started Config from Alt menu, so Config returns to the Alt menu.)
4. No code changes. Document this behavior in descriptions of using core slot 1 (and maybe add an advisory to the Config documentation in the User's Guide), as required knowledge for people installing alternate MEGA65 cores.

**Additional considerations**

I know we're working on making upgrading slot 0 safer for people without JTAG adapters. Maybe at some point, the recommendation would be for most users to keep slot 0 up to date with the latest stable core. Installing a core in slot 1 would be a less common case (e.g. people running dev cores as daily drivers), and better justifies expecting the user to learn about advanced behaviors of the Alt menu utilities.

lydon42, 2023-12-23:
Booting to default core after config or onboard is to complicated to be implemented in all the utilities.

The easier solution is to ask the user to power cycle the system instead. This solution was implemented for the batch 3 release into config and onboard.

Please check.

Closed 2024-02-24.

Thread 753 (2023-12-04):

Dev Core build #73 / Cartflash #55, Freezer Exit Screen Corruption when D81 is mounted

KiDraDragon, 2023-12-04:
**Test Environment (required)**
 - Platform: MEGA65 R3
 - Core Commit: `4259566` / `C9AFE07`
 - ROM Release: `920377`, `920378`, `920380`, `920386`, `920388`, `920389`, `920390` tested

**Describe the bug**
Using Dev Core Build [#73](https://builder.mega65.org/job/mega65-core/job/development/73/) or Cartflash Core build [#55](https://builder.mega65.org/job/mega65-core/job/683-cartflash/55/) there is screen corruption when exiting the Freezer, when a D81 image was mounted and the directory listing listed via DIR, without executing a DIR command prior to mounting the image.

When using DIR in addition before (!) mounting a D81-image, then Freezer exits normally.

**To Reproduce**
Steps to reproduce the behavior:
1. Boot either mentioned core version
2. Mount any D81 image, e.g. MEGAPOLY.D81: BOOT > MOUNT"MEGAPOLY.D81" > DIR > Enter Freezer > Exit Freezer (F3)
or
1. Boot either mentioned core version
2. Have MEGA65.D81 present and automounted: BOOT > Enter Freezer > Exit Freezer (F3)

**Expected behavior**
Exiting Freezer should return to BASIC65 screen in a usable state.

**Screenshots**
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

**Additional context**
Two different SD-Cards (32gb Sandisk Ultra / Extreme) were used. One was wiped with Windows Tool Rufus.ie and prepared using the MEGA65 builtin tools. This SD-Card was populated with the MEGA65 formatter using the DEV-Core.

The other SD-Card was an in-use card and M65-Files were copied over via megaftp (ethernet). No difference in behavior between the two.

Discussion on Discord https://discord.com/channels/719326990221574164/1181168989855043644

johnwayner, 2023-12-05:
Some quick testing tonight seems to indicate that this was introduced in build 72 (https://builder.mega65.org/job/mega65-core/job/development/72/). Unfortunately there are a lot of changes in there.

johnwayner, 2023-12-05:
I was able to fix the problem by using a HICKUP from build 71 on 73's core.  And also reproduce the issue using 73's HICKUP on 71's core.  So I used git bisect to narrow down to the commit that caused the failing HICKUP: https://github.com/MEGA65/mega65-core/commit/1a91eb715f11e6c7f4b8a5f5c1b7cbae1dbbe57f

It seems to be the change from
```
!32 $ffd3000
!16 $0080
```
to
```
!32 $ffd3000
!16 $0100
```
Not sure why the F011 and SD card areas were added.  I think I'll leave this to others now :)

johnwayner, 2023-12-05:
Oh, I forgot to mention that I did some memory dump comparisons before and after the corruption.  Memory is pretty much totally obliterated with garbage after the corruption.  Even the ROM data is destroyed.  It's impressive :)

dansanderson, 2023-12-05:
Yes, I believe this is the suspect change, related to the freezer format change I mentioned. It was explained to me that it doesn't change the size of the file format because those bytes are already reserved in blocks of that size. That might be incorrect, or it might just be that the extra registers being restored has consequences that we haven't accounted for yet. The goal was to include the VIC-IV errata register (D08F) in the freezer data. Maybe we need to exclude some registers?

I didn't have a plan to account for older Freezer files that might have blank data in the newly included region. But that shouldn't be this specific issue because some can repro this starting from a fully wiped SD card formatted by the new core.

Maybe @gardners or @lydon42 can take a closer look when they get a chance?

lydon42, 2023-12-05:
In my memory freezer was changed to include the errata flags (essentially expanding the VIC save are to full 0x100 if I remember correctly).
Note that not showing computer frames around slot snapshots can result from having the old images on the SD card. The new format has more information in the files (also if I remember correctly).

We will get to checking freezer when we are done with r5 bringup. This has the highest priority right now, as without r5 test we can't start producing boards! So please check on your own if you are interested in helping, but don't pull @gardners away from working on r5 :)

johnwayner, 2023-12-07:
The issue is centered around unfreezing to FFD3081 (D081) which is part of F011: https://github.com/MEGA65/mega65-core/blob/7af2409563f37f35c718c4bf3da5282ebc26f207/src/vhdl/sdcardio.vhdl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

This register includes all sorts of stuff that mess with the buffers used to read data from the sd card.  I suspect that the results will vary a bit depending on what value is being written back to this location.  The usual result is that the following entries in the mem_list are not restored properly.  This includes all of chip ram (ROMs, included).

A possible fix I've tested briefly is to separately save $D08F into the scratch area at the beginning of the freeze and to unfreeze it in an post unfreeze handler for the viciv DMA entry (or any number of other places).  And, of course, the VICIV DMA entry must be  changed back to only copying $80 bytes so it doesn't get to D081.

I can put a pull request in for this change against the freezer project if you want.

johnwayner, 2023-12-07:
@dansanderson It might be prudent to address the saving of the errata flag and this particular issue now. Then, in a new feature issue, tackle determining what data from $D080-$D0FF should be saved -- and how to do save it.  It's not even clear to me what is even in $D090-$D0FF.  The book is light on details there and I haven't looked in the VHDL to find out.  Also, if we freeze more in this area, does the freezer become too specific to the normal Mega 65 I/O personality (vs other personalities)? I don't know.

dansanderson, 2023-12-07:
I agree, unfreezing only the errata register (D08F) is the safest change for now, and might be the only change needed for a while.

Here's the result of `make iomap.txt` in the development branch right now, excerpted from D080 to D0FF. Going just from the doc comments, it doesn't look like it's appropriate to unfreeze any of the other registers in this region.

```
C65 $D080 - F011 FDC control
C65 $D080.0-2 FDC:DS Drive select (0 to 7). Internal drive is 0. Second floppy drive on internal cable is 1. Other values reserved for C1565 external drive interface.
C65 $D080.3 FDC:SIDE Directly controls the SIDE signal to the floppy drive, i.e., selecting which side of the media is active.
C65 $D080.4 FDC:SWAP Swap upper and lower halves of data buffer (i.e. invert bit 8 of the sector buffer)
C65 $D080.5 FDC:MOTOR Activates drive motor and LED (unless LED signal is also set, causing the drive LED to blink)
C65 $D080.6 FDC:LED Drive LED blinks when set
C65 $D080.7 FDC:IRQ When set, enables interrupts to occur. Clearing clears any pending interrupt and disables interrupts until set again.
C65 $D081 FDC:COMMAND F011 FDC command register
C65 $D081.0 FDC:NOBUF Reset the sector buffer read/write pointers
C65 $D081.1 FDC:ALT Selects alternate DPLL read recovery method (not implemented)
C65 $D081.2 FDC:ALGO Selects reading and writing algorithm (currently ignored).
C65 $D081.3 FDC:DIR Sets the stepping direction (inward vs
C65 $D081.4 FDC:STEP Writing 1 causes the head to step in the indicated direction
C65 $D081.5 FDC:FREE Command is a free-format (low level) operation
C65 $D081.6 FDC:RDCMD Command is a read operation if set
C65 $D081.7 FDC:WRCMD Command is a write operation if set
C65 $D082 - F011 FDC Status A port (read only)
C65 $D082.0 FDC:TK0 F011 Head is over track 0 flag (read only)
C65 $D082.1 FDC:PROT F011 Disk write protect flag (read only)
C65 $D082.2 FDC:LOST F011 LOST flag (data was lost during transfer, i.e., CPU did not read data fast enough) (read only)
C65 $D082.3 FDC:CRC F011 FDC CRC check failure flag (read only)
C65 $D082.4 FDC:RNF F011 FDC Request Not Found (RNF), i.e., a sector read or write operation did not find the requested sector (read only)
C65 $D082.5 FDC:EQ F011 FDC CPU and disk pointers to sector buffer are equal, indicating that the sector buffer is either full or empty. (read only)
C65 $D082.6 FDC:DRQ F011 FDC DRQ flag (one or more bytes of data are ready) (read only)
C65 $D082.7 FDC:BUSY F011 FDC busy flag (command is being executed) (read only)
C65 $D083 - F011 FDC Status B port (read only)
C65 $D083.0 FDC:DSKCHG F011 disk change sense (read only)
C65 $D083.1 FDC:IRQ The floppy controller has generated an interrupt (read only). Note that interrupts are not currently implemented on the 45GS27.
C65 $D083.2 FDC:INDEX F011 Index hole sense (read only)
C65 $D083.3 FDC:DISKIN F011 Disk sense (read only)
C65 $D083.4 FDC:WGATE F011 write gate flag. Indicates that the drive is currently writing to media.  Bad things may happen if a write transaction is aborted (read only)
C65 $D083.5 FDC:RUN F011 Successive match.  A synonym of RDREQ on the 45IO47 (read only)
C65 $D083.6 FDC:WTREQ F011 Write Request flag, i.e., the requested sector was found during a write operation (read only)
C65 $D083.7 FDC:RDREQ F011 Read Request flag, i.e., the requested sector was found during a read operation (read only)
C65 $D084 FDC:TRACK F011 FDC track selection register
C65 $D085 FDC:SECTOR F011 FDC sector selection register
C65 $D086 FDC:SIDE F011 FDC side selection register
C65 $D087 FDC:DATA F011 FDC data register (read/write) for accessing the floppy controller's 512 byte sector buffer
C65 $D088 FDC:CLOCK Set or read the clock pattern to be used when writing address and data marks. Should normally be left $FF
C65 $D089 FDC:STEP Set or read the track stepping rate in 62.5 microsecond steps (normally 128, i.e., 8 milliseconds).
C65 $D08A FDC:PCODE (Read only) returns the protection code of the most recently read sector. Was intended for rudimentary copy protection. Not implemented.
GS $D08F - Set/get MISCIO:HWERRATA MEGA65 hardware errata level
GS $D09B - FSM state of low-level SD controller (DEBUG)
GS $D09C - Last byte low-level SD controller read from card (DEBUG)
GS $D09D - FDC-side buffer pointer high bit (DEBUG)
GS $D09E - CPU-side buffer pointer low bits (DEBUG)
GS $D09F.0 - CPU-side buffer pointer high bit (DEBUG)
GS $D09F.1 - EQ flag (DEBUG)
GS $D09F.2 - EQ flag inhibit state (DEBUG)
C65 $D0A0   C65 RAM Expansion controller
C65 $D0A0-$D0FF - Reserved for C65 RAM Expansion Controller.
C65 $D0A0-$D0FF SUMMARY:REC Reserved for C65 RAM Expansion Controller.
GS $D0E0.0-3 Select active UART for other registers
GS $D0E0.4 Enable loopback mode
GS $D0E0.5 Buffered UART master RX buffer high-water IRQ enable
GS $D0E0.6 Buffered UART master TX queue low-water IRQ enable
GS $D0E0.7 Buffered UART master IRQ enable
GS $D0E1 Buffered UART Status register / interrupt select register
GS $D0E1.0 Buffered UART enable interrupt on TX buffer low-water mark
GS $D0E1.1 Buffered UART enable interrupt on RX high-water mark
GS $D0E1.2 Buffered UART enable interrupt on RX byte
GS $D0E1.3 Buffered UART TX buffer full
GS $D0E1.4 Buffered UART RX buffer full
GS $D0E1.5 Buffered UART TX buffer empty
GS $D0E1.6 Buffered UART RX buffer empty
GS $D0E1.7 Buffered UART interrupt status
GS $D0E2 Buffered UART Read register (write to ACK receipt of byte)
GS $D0E3 Buffered UART Write register (write to send byte)
GS $D0E4 Buffered UART bit rate divisor LSB
GS $D0E5 Buffered UART bit rate divisor middle byte
GS $D0E6 Buffered UART bit rate divisor MSB
```

markkrueg, 2023-12-10:
I am seeing this same corrupt image on a fresh install of development core #73 in my slot 6 with a freshly built SD card from same core. Just booted up after going through initial setup and went into FREEZER.
![Uploading IMG_9117.jpg…]()

markkrueg, 2023-12-10:
I am seeing this same corrupt image on a fresh install of development core 73 in my slot 6 with a freshly built SD card from same core. Just booted up after going through initial setup and went into FREEZER.
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

johnwayner, 2023-12-10:
@markkrueg  The thumbnail frame corruption is a different issue, I believe.

FYI, I can no longer reproduce the freezer exit crash issue.  It would crash 100% of the time when I was working on a fix, but now it works every time.  I've removed the HICKUP.M65 and it's also not reported in MEGAINFO.  I've done total SD Card wipes using the built-in tool.  I've even tried applying a HICKUP that should force the issue to happen by writing $FF to $D081, and it's fine.

I don't get it.  it was all very predictable before.  I guess I was lucky to be in whatever state was causing it.  Maybe the contents of the sd card have to be just right?

johnwayner, 2023-12-10:
I found the issue with the thumbnail frames being corrupted: https://github.com/MEGA65/mega65-freezemenu/pull/72

lydon42, 2023-12-10:
I will add the freezer version to r5-bringup

lydon42, 2023-12-13:
fix has been merged

Closed 2024-02-24.

Thread 758 (2023-12-19):

Ethernet TX not working on some boards and core revisions

ki-bo, 2023-12-19:
**Test Environment (required)**
You can use [MEGA65INFO](https://files.mega65.org?id=3eeb7d82-8bd7-44b7-82b6-cef29d123b0e) to retrieve this.
 - Platform: MEGA65 R3a
 - Core Commit: c39f52e & 4259566 (development builds 72 and 73)
 - ROM Release: 920377 (unrelated)

**Describe the bug**
With the two mentioned core development builds mentioned above, my R3a board stopped sending the IPv6 TX beacons (which you can activate by hitting SHIFT+POUND). Sometimes, I still could see some of them in Wireshark, but in general this was broken. It turned out that TX functionality regressed in general. Some users with R3a still were able to use the Ethernet functionality with not issues using the same core, but I got several reports from other users seeing the same issue as I had.

**To Reproduce**
Steps to reproduce the behavior:
1. Power-up
2. Hit SHIFT+POUND
3. No IPv6 Beacon broadcast is visible on the network (use Wireshark to verify)

**Expected behavior**
The IPv6 beacon should be sent properly once every second.

**Additional context**
It seems this is related to the TX phase setting in the core. Default is '00', although the Ethernet tools and also the WeeIP stack software set this to '01' on initialisation anyway. Obviously, with many core builds in the past, both settings seemed to work fine. But now we start seeing that phase setting '00' is not working reliably all the time.

All users that had reported the issue to me also reported back that setting the TX phase manually to '01' fixes the problem (I can observe the same here). You can do that by doing `POKE $D6E5,$36`.

We should change the default of TX phase to setting '01' which was proven to work very reliably for everyone during the last year when we were developing the Ethernet tools.

lydon42, 2023-12-23:
As I remember from the conversations this means this should be fixed? So I set it to staged and leave it open for batch testing.

ki-bo, 2023-12-23:
> As I remember from the conversations this means this should be fixed? So I set it to staged and leave it open for batch testing.

Yes, I believe it should be fixed. However, as it only happened randomly for some builds, it will be harder to really do a test. We rather need to see whether it will happen again.

On the other hand, if the error showed, setting the phase to 01 always fixed it for whoever I was in contact with. So, I am quite confident this fix will do alright.

Closed 2024-02-24.

Thread 763 (2023-12-28):

QSPI: Busy flag ```sdio_busy``` is unreliable

0xa000, 2023-12-28:
**Test Environment (required)**
 - Platform: QMTECH Wukong Board
 - Core Commit: 93e2eb8
 - ROM Release: N/A

**Describe the bug**
The flag that indicates (amongst other things) if a hardware assisted QSPI operation is being executed is unreliable, that is, it can be set to '0' (false) even though a QSPI operation is in fact being executed.

Although all relevant QSPI hardware assisted operations update the ```sd_state``` signal and assign '1' to the ```sdio_busy``` signal, these changes only take effect after the VHDL process ends. Often, the value of ```sd_state``` at the time a hardware assisted operation is started is ```Idle```.

The state machine that handles ```sd_state``` is part of the same VHDL process that handles starting QSPI hardware assisted operations. The handler for ```sd_state``` equal to ```Idle``` assigns '0' to the ```sdio_busy``` signal. Since this VHDL code comes after the code that assigns '1' to the ```sdio_busy``` signal *in the same process*, the first assignment is effectively lost.

**To Reproduce**
Create a test application that executes a long running QSPI operation (for example, a 64K sector erase) and observe that the ```sdio_busy``` flag is never set to `1`. The busy flag can be observed by PEEK-ing $D680, bit 0.

**Expected behavior**
The value of the busy flag should be equal to '1' as long as a QSPI hardware assisted operation is being executed.

**Additional context**
In ```sdcardio.vhdl```, there is another piece of code that *could* reset the value of the ```sdcard_busy``` signal to '0'. At the moment I'm not certain if it will ever pose a problem, though. It's on lines 3791 -- 3795:
```
if last_sd_error /= x"0000" then
    sdio_error <= '1';
    sdio_busy <= '0';
    sd_state <= Idle;
end if;
```

gardners, 2024-05-29:
Consider addressing together with work on #766

lydon42, 2024-05-30:
The fix should be quite simple:
- remove setting sdio_busy in the fastio_write switch
- add set sdio_busy to all initial qspi stages in the state machine

lydon42, 2024-05-30:
Handling in 782-mflash-lowlevel, as we need this for MEGAFLASH refactoring.

lydon42, 2024-05-30:
Test with mflash.prg, replacing the delay loop in erase_sector with a sdio_busy wait loop, now results in a stable flash (r6, with attic cache).

gardners, 2024-05-30:
Let me know when done, so I can merge the change into my sdcard cache work on #766 as well. Thanks for tackling this.

lydon42, 2024-06-29:
I deem this fixed.

Closed 2024-06-29.

Thread 764 (2023-12-28):

QSPI: Some operations do not return to idle (CS# high, SCK high)

0xa000, 2023-12-28:
**Test Environment (required)**
 - Platform: QMTECH Wukong Board
 - Core Commit: 93e2eb8
 - ROM Release: N/A

**Describe the bug**
There are hardware assisted QSPI operations (ie. those implemented in ```sdcardio.vhdl```) that keep the chip select (CS#) line asserted (low). In other words, these operations do not finish the SPI transaction they started. Most notable is the QSPI read operation (0x53).

**To Reproduce**
Create a small test application that performs a hardware assisted read operation (0x53) and observe that the chip select line is still asserted (low). You will probably need an oscilloscope or custom VHDL to make this observation, as the chip select signal is not memory mapped at the moment, as far as I could tell.

**Expected behavior**
All hardware assisted QSPI operations should return to the SPI "idle" state at the end of the operation, by driving both CS# (chip select) and SCK (SPI clock) high.

**Additional context**
Interestingly, the SPI (not QSPI) implementation of the read operation does de-assert the chip select line, see ```sdcardio.vhdl``` line 4979 (state ```SPI_read_phase4```). The same statement, ie. ```qspicsn <= '1'```, could be added to state ```QSPI_read_phase4``` (line 4813 and further), where it is currently missing.

gardners, 2024-02-02:
see src/tools/sdstates.c for a tool that can be used to help debug these state errors:

gcc -Wall -o sdstates src/tools/sdstates.c && ./sdstates < src/vhdl/sdcardio.vhdl  > foo.dot
dot -Tpdf foo.dot  > foo.pdf && open foo.pdf

This reveals that the following state is a problem, which indeed looking at the code, it clearly is :)

```
     when QSPI4_write_phase2 =>
          if qspi_bit_counter = 0 then
            report "QSPI4: Sending byte $" & to_hstring(f011_buffer_rdata);
            qspi_byte_value <= f011_buffer_rdata;
          end if;
          -- XXX INCOMPLETE!
          sd_state <= Idle;
```

0xa000, 2024-02-02:
Ah, nice! Earlier I created dotty graph of only the QSPI related states, but I'll definitely check this out. However, the QSPI4_* states are not being used as far as I can tell. For writing, QSPI_qwrite_* is being used instead. See the VHDL around line 3100 where the various commands are handled.

Closed 2024-06-29.

Thread 773 (2024-01-20):

R5: Joystick misbehavior witnessed in several Intro Disk games

dansanderson, 2024-01-20:
**Test Environment (required)**
 - Platform: MEGA65 R5 board
 - Core Commit: release-0.96,20240119.17,99aeac5
 - ROM Release: 920391

Compared with MEGA65 R3A board, release-0.96,20240115.22,68aabb0, ROM 920391 using the same SD card.

**Describe the bug**
Several Intro Disk games are exhibiting joystick controller misbehavior, appearing as a "stuck" direction or fire button. Not all games are affected, and each game seems to be affected differently.

* Intro Disk 1: Blaster (port 2): Ship moves up to middle of the screen out of player control. Player can move left and right and fire, but cannot move down (as if "up" is stuck).
* Intro Disk 1: Pushem (port 2): Player can grab a piece with the cursor, but can't let go of the piece (as if "fire" is stuck).
* Intro DIsk 2: Battle Sparrow: Can start in one direction, but then ship no longer responds to movement or fire.
* Intro Disk 2: The Wall: Can change the direction once per play, but then wall can't change direction.
* Intro Disk 2: Zeha Goes Skiing: Can ski, but after crashing, can't press fire to restart game.

This does not appear to be related to Amiga mouse emulation settings. I tried both Amiga mouse mode and normal mouse mode, with no change.

I went back to the R3 board with the same SD card and the games behave correctly. I'm not using the exact same core build with the R3 board; I can try that next. They're very close though.

gardners, 2024-01-20:
$DC00 correctly responds to joystick inputs from BASIC.
Also from the title-screen of BLASTER it behaves properly.
But once BLASTER is running, indeed $DC00 shows $FE instead of $FF (tested on R5 board)
I'm suspecting the new bi-directional joystick port circuitry control

dansanderson, 2024-01-20:
I found a couple of additional failing cases on Intro Disk 3: Basic65 JnR Basecode, MEGABLOCKER, and Sub something.

Interestingly, Sub something got stuck then bailed with an error, so I could inspect the BASIC program and see what it was seeing. JOY(2) returned 155, which is outside the range of promised values for JOY(). Normally JOY returns 128 for fire + a normalized cardinal direction between 0 and 8. 155 AND 15 = 11. JOY is using a lookup table for the cardinal direction, so it's easy to imagine that an unexpected value at DC00 is accessing memory outside of the lookup table.

It sounds like a core fix is prudent, but if the ROM should be masking any bits here let me know.

gardners, 2024-01-20:
For BLASTER, the problem is that BLASTER itself writes $FE to $DC00 at $3746 - $374A. On R3 this didn't cause a problem, but it does explicitly ask for the up line of joy 2 to be held low, i.e., active.

gardners, 2024-01-20:
To patch BLASTER while it is running:
s3747 ff
from the matrix monitor.

dansanderson, 2024-01-20:
BASIC's JOY() does write FF to DC00 before reading. It does a bit of debouncing, so maybe that isn't working well with the bidi stuff, I dunno. https://github.com/MEGA65/mega65-rom/blob/073435d9855506bb3d3e2151026799b76722bb32/b65.src#L10792

gardners, 2024-01-20:
Similar issue for PUSHEM, which writes $EF to $DC00 and $DC01. Patching it during run can be done with:
s4362 ff
So again, this is a real bug in the program, that was not causing problems on R3 and earlier boards.

gardners, 2024-01-20:
Confirming the problem is _not_ with the ROM, but with prior software not handling the joystick ports correctly.

dansanderson, 2024-01-20:
I'll feel better about that explanation once we figure out whether the BASIC examples that are failing are doing something more unusual than just calling JOY(). If JOY() is returning unexpected values, then there's probably more the ROM needs to be doing.

gardners, 2024-01-20:
A simple program like this works fine:
10 PRINT JOY(2): GOTO 10

I'm going through the source code of battle sparrow to understand how it goes wrong.

gardners, 2024-01-20:
I'm suspecting the ROM does mess up the joystick lines sometimes.
This line in pot routine of basic65.src is almost certainly bad: Should instead just write $FF.

stx CIA1_PRA    ;restore keybd lines

Also in rmouse routine:

    stz CIA1_PRA    ;restore port for Kernel

Also in system.src, in ScanStopKey

    sta colm        ;watch out... .a=$7f...same as colms was...

gardners, 2024-01-20:
Making patched ROMs with fixes for the above suspicious routines:

sta colm does not affect behaviour of battle sparrow

gardners, 2024-01-20:
Hmm... also found that joy routine has a similar problem.  Trying to fix that next.

BATTLE SPARROW can indeed be fixed by patching the joy routine.

gardners, 2024-01-20:
This fix also works for THE WALL and ZEHA GOES SKIING

gardners, 2024-01-20:
The MEGA65 ROM can be patched to deal with this bug for those 3 BASIC programs, but the ASM programs will either need to be patched separately, _or_ we make bi-directional joystick port a protected feature, possibly under hardware errata register control, so that we don't have any backwards compatibility issues.

This is likely sensible, given that the need for bidirectional joystick ports is expected to be relatively rare.

gardners, 2024-01-20:
See https://github.com/MEGA65/mega65-rom/issues/62 for proposed fix for BASIC65 programs.

dansanderson, 2024-01-23:
ROM fix is implemented and released.

ML programs that mis-handle port directionality will stay broken in v0.96. Nothing left to do for this issue.

dansanderson, 2024-01-28:
Closing.

Closed 2024-01-28.

Thread 775 (2024-01-22):

Core 0.96 test: 1351 mouse is jittery in applications like MegaMOD and Sprite Editor in Freezer (but stable in BASIC)

MauriceMEGA65, 2024-01-22:
**Test Environment (required)**
MEGA65 Release 0.96 "Batch 3" Release Candidate
 - Core Commit: 68aabb0
 - ROM Release: 920392
 - R3A (batch1) hardware
 - Mouse is connected to port 1, and set to Normal Mode in config.

**Describe the bug**
1351 mouse pointer is jittery in applications like MegaMOD and Sprite Editor in Freezer, but seems OK in BASIC

**Expected behavior**
Stable mouse pointer, like when using an Amiga mouse

https://github.com/MEGA65/mega65-core/assets/75681098/11d42d48-2e66-400c-acd2-34618b8305dd

https://github.com/MEGA65/mega65-core/assets/75681098/640cfed1-3e62-41b7-a375-a58f40bc981b

https://github.com/MEGA65/mega65-core/assets/75681098/c150ccf1-0c3e-40b0-be11-0a7b5e6a57d8

**Screenshots**
See attached videos of MegaMOD, Sprite Editor and BASIC

**Additional context**
https://discord.com/channels/719326990221574164/1196590643007463459/1198582748340834304

gardners, 2024-01-27:
I've been thinking about how to fix this at the hardware level by adding hysteresis to 1351 read values. One option is to fix this in the 751- issue branch, while I have mouse_input.vhdl open for surgery. See #751

gardners, 2024-01-28:
That helps, but the jitter is actually over a range of 3 values, not 2.

gardners, 2024-01-28:
Meanwhile, I filed an issue on the MouSTer repo asking for optional pull-up on Amiga right and middle buttons, that would allow C64s and MEGA65s to read those buttons without requiring a special cable with pullup in it.

gardners, 2024-01-28:
Confirmed this fixes 1351 mouse jitter, provided that amiga mouse aggressive mode is turned off (which now also controls 1351 de-jittering at hardware level).

lydon42, 2024-08-09:
Looking at the commits, this has already gone into release-0.96.0

Closed 2024-08-09.

Thread 779 (2024-01-27):

Amiga mouse in port 1 interferes with keyboard

dansanderson, 2024-01-27:
**Test Environment (required)**
You can use [MEGA65INFO](https://files.mega65.org?id=3eeb7d82-8bd7-44b7-82b6-cef29d123b0e) to retrieve this.
 - Platform: MEGA65 R3 or R5
 - Core Commit: 683-cartflash,20240124.23,65b7373
 - ROM Release: 920377, 920394

**Describe the bug**
ROM 920377: When an Amiga mouse is connected to port 1 and the port is in Amiga mouse mode (aggressive or normal), moving the mouse causes crazy typing events.

ROM 920394: When an Amiga mouse is connected to port 1 and the port is in Amiga mouse mode (aggressive or normal), Run/Stop does not always interrupt a program.

**To Reproduce**
1. Connect an Amiga mouse to port 1.
2. In the Configuration menu, set port 1 to Amiga mode (aggressive or normal).
3. `10 PRINT "HI":GOTO 10`
4. `RUN`
5. Press Run/Stop.

Run/Stop should reliably stop the program the first time it is pressed. What's actually happening is sometimes Run/Stop doesn't do anything.

Disconnect the mouse and try again. Connect a 1351 mouse and try again. Run/Stop works without interference.

(If using a mouSter and wireless mouse, be sure to jiggle the mouse to make sure it is active. Wireless mice will intentionally disconnect when not moved to save battery.)

**Additional context**
It is likely that the symptoms are more mild with ROM 920394 because the new ROM keyboard scanner uses the hardware typing event queue instead of CIA lines for most things, but still uses CIA lines for things like detecting Run/Stop. This strongly suggests that an Amiga mouse on port 1 is simply interfering with CIA1 DC00 return values that overlap with CIA keyboard scanning.

Presumably there should be a way for the Amiga mouse driver to translate to 1351 signals more accurately, so as to not cause these issues.

dansanderson, 2024-01-27:
Not a regression, so not recommended for prioritization with the v0.96 release.

dansanderson, 2024-01-27:
I'm not able to reproduce this with the v0.95 core, so this is a regression.

dansanderson, 2024-01-27:
Paul says this is a fix, will verify: https://github.com/MEGA65/mega65-core/commit/226eebaec9b4b870bc94823173815ca83158a510

gardners, 2024-01-27:
See #751 for work on fixing Amiga mouse interference with keyboard etc.

lgblgblgb, 2024-01-29:
Not sure if it has anything to do with this issue: but during the weekend I had issues that freezer didn't reacted at all to any key, also the flasher the same way but _only_ in the core file selection part (it works before that step). Strangely enough I could type normally without any issue in ROM, both new (using hw accel kbd) and old, plus using a very old and new core as well (for the new ROM, obviously only a new core I could tested with). All my issues went away when I unplugged Amiga mouse from port 2 (not one though!), which seemed to cause all of these problems.

lydon42, 2024-01-29:
Do we need this issue open or can we close this because, as Paul wrote, work is being done in #751 ?

dansanderson, 2024-01-29:
They are distinct issues, so I would opt for keeping them both open, even if the same effort will fix both. I don't know for sure that keyboard interference and right mouse button flicker have the same cause, and a fix might not completely handle both.

lydon42, 2024-08-15:
Is there still a problem or not?

Thread 781 (2024-01-28):

A few modern C64 carts not detected as C64 carts by core selector

dansanderson, 2024-01-28:
**Test Environment (required)**
You can use [MEGA65INFO](https://files.mega65.org?id=3eeb7d82-8bd7-44b7-82b6-cef29d123b0e) to retrieve this.
 - Platform: MEGA65 R5
 - Core Commit: slot 0: 0828173c "Looping RC#67.4 test"

**Describe the bug**
Several modern ProtoVision carts intended for the C64 appear to the core selector as non-C64 carts. With a MEGA65 core flagged for M65 carts and the C64 core flagged for C64 carts, the ProtoVision carts are starting the MEGA65 core (and mostly not working with GO64 mode, but that's not the bug).

This is consistent across TM Ultra and Soul Force, both from ProtoVision, as well as l'Abbage de Morts on cartridge. These games all work with the C64 core if I select the core manually from the core select menu.

**To Reproduce**
1. Install MEGA65 and C64 cores, with a modern cartflash-derived 0.96 test core in slot 0.
2. Connect a ProtoVision Soul Force cart.
3. Power on.

Expected: C64 core starts, cart plays. Can confirm C64 core with Help key.

Actual: MEGA65 core starts, cart fumbles in GO64 mode. Can confirm MEGA65 core by entering the Freezer.

**Additional context**
Not a regression and not a v0.96 launch blocker, just noting for future reference. The easy workaround is to use the core selection menu to choose the C64 core, as in v0.95.

paich64, 2024-01-28:
Exact same issue / symptoms / workaround with the following modern cartridge games :

- Tiny Quest
- Robot Jet Action

lydon42, 2024-01-28:
Not a MEGAFLASH issue, this most probably is #778

gardners, 2024-01-30:
Can any of these failing carts be simulated using an Easy Flash 3? Otherwise I don't have them on hand to test. My gut feeling is that they might be external KERNAL based cartridges, which requires some skull-duggery to handle on the current R3-R6 hadware.

The fix for #778 requires testing by someone with one of the failing cartridges, to see if it fixes the problem with this issue.

paich64, 2024-01-30:
@gardners they were detected correctly with R3A batch 2 configurations (Mega65 core, rom, C64 core).

paich64, 2024-02-02:
The issue does not seem to be 100% fixed :

"Soulforce" and "Robot Jet Action" are now booted by the C64 core, BUT,
"Tiny Quest" keeps not booting with C64 core, but instead with Mega65 core.

MJoergen, 2024-02-08:
@paich64
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

Regarding the R3A status, what is the status using the previously released C64 V5 core? I'm interested in knowing whether or not this is a regression from V5 to V5.1.

paich64, 2024-02-08:
@MJoergen
there's definitely no regression with V5.1

- Tiny quest is now at @gardners home
- I still have Robot Jet Action so i could extensively test :

Using Latest MegaFlash core in slot 0 on **R3A** with **V5.1** in slot 2=> Robot Jet Action won't start
Using  Latest MegaFlash core in slot 0 on **R3A** with **V5.0**  in slot 2=> Robot Jet Action won't start

I even Reflashed very first MegaFlash core in slot 0 (the one which was delivered when autoboot cartridge was implemented) and **V5.0** in slot2 => Robot Jet Action won't start

I know the pattern is hard to capture but please,

1) remember my **R3A** used to be able to autoboot both "Robot Jet Action" and "Tiny Quest" with very first MegaFlash core using V5.0 alpha releases,  and overtime it started to stop being able to autoboot these 2 cartridges and also EF1 cartridges.

2) remember that on R3A they have always been recognized as C64 cartridges but they fail to boot.

combining 1) + 2) It's obvious to me that on R3A, there's no regression, simply my very own Mega65 R3A has problems with the cartridge port. **It's not the C64 core**, it's my R3A board which fails for an unknown reason.

Again, it used to be able to boot these 2 cartridges using V5.0 alpha releases and i'm pretty sure it could also boot these 2 cartridges with V5.0.

In order to ensure it's not related to the core, I have re-tested all V5.0 Alpha releases (since the very first one) and none of them will let me boot these 2 cartridges, while i had been able to boot them by the past.

So I confirm : V5.0 is OK, V5.1 is OK.
It's all related to my very own R3A board.

A few month ago a friend of mine has tested these cartridges on his on R3A and he could boot them with V5.0 while i could not with V5.0.

paich64, 2024-02-08:
@MJoergen when i get my second Mega65 (in June obviously) I hope you or @sy2002 will have some time to investigate what's wrong with my R3A. I know you'll be very busy with possible an Amiga Core, but if you can find time to debug the cartridge port of my R3A i will be more than happy to ship it to you or @sy2002.

sy2002, 2024-02-08:
@gardners Paul, you wrote this here in your above-mentioned comment:

> Tiny Quest seems to have a ROM with boot signature at $8000

Since we are talking about detecting a cartridge as C64 cartridge and start the dedicated C64 core (and not about "why is it not running on the MEGA65 core"): Can't we consider a cartridge as C64 cartridge as soon as you detected the boot signature at $8000?

You also wrote:

> but nothing visible at $A000 or $E000 by default, and pulls /EXROM low, and leaves /GAME high.

According to this blog http://blog.worldofjani.com/?p=879  EXROM low and GAME high means we have an 8k cartridge and you can only expect data in $8000 and not in $A000 or $E000.

So I am wondering: If we already detect a CBM80 signature in $8000, what hinders us to classify this cartridge as "C64 cartridge" and start the C64 core?

lydon42, 2024-02-08:
Talking  about this here? https://github.com/MEGA65/mega65-core/blob/e98485bc3af22a2527bc39509af28b9e1adae1d7/src/utilities/megaflash.c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

gardners, 2024-02-09:
For me at least, some of the time it does seem to be detected as a C64 cart, but fails to start completely in M65 core at least (I don't have a C64 core configured to boot on my machine right now).

But I have seen both black screen, and partial-start screen of Tiny Quest (looks like C64 start screen with some extra messages).

paich64, 2024-02-09:
@gardners this is what's supposed to happen on screen when Tiny Quest cartridge is booting  :

https://github.com/MEGA65/mega65-core/assets/6482872/58c08d5b-5236-4488-b4d8-ef404beed523

lydon42, 2024-02-09:
MEGAFLASH can show you what it detects. If you interrupt autoboot by holding NO SCROLL, and then press HELP for the version info, the "secret" F1 key shows you extra boot information (i.e. the state of EXROM/GAME at the very start of MEGAFLASH, it's current state, and what ROM memory shows at the location that hold CBM80, cbm or m65)

sy2002, 2024-02-09:
@gardners Can you do the test that @lydon42 describes 10 times in a row or so and share the result?

lydon42, 2024-02-09:
Yes, it was decided that if there is CBM80 at $8004, regardless of the state of EXROM/GAME, a C64 cartridge is assumed.

I don't have that cartridge, so I can't tell you how it detects.

lydon42, 2024-02-09:
Copied from discord for documentation (posted by AmokPhaze101):

on R5 with _683-cartflash_ #71:
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

on R3A with _683-cartflash_ #71:
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

R5 shows ROM area all zero and EXROM/GAME high ($60 in D67E), R3A shows some marker bytes at $8004 (but it's CBM00 not 80!), and EXROM low ($20 in D67E)

gardners, 2024-02-10:
Powering on with Tiny Quest in R5 board (unpatched) 10x gives the same partial-boot 10x. This is on 20231212.19 / c6fb6d6 (r5-bringup) branch, because that's what I have flashed right now.

This is with the cartridge port break-out board fitted, which might affect some timing.

Without the break-out board:  3x boot to BASIC65, 7x same partial-boot progress. Again, with c6fb6d6.

I'll have time a bit later to flash a newer bitstream.

Will try with head of 781-c64-carts via JTAG next, however.

gardners, 2024-02-10:
I'm not convinced that we have been controlling cart_ctrl_dir correctly.  Will test if the above fix allows things to work correctly.

sy2002, 2024-02-10:
@gardners Sounds promising, Paul! Thank you.

gardners, 2024-02-10:
oh, ok. TinyQuest doesn't work on C64 core? Do you know why not?
I'll focus on stabilising the behaviour of the cartridge detection, then.

gardners, 2024-02-10:
Hmmm.. not entirely sure how the cartridge clock was being generated before. In simulation at least, it was simply not ticking.
Argh! 781-c64-carts seems to be based on some weird branch history. It is quite similar to development, but not merged. I'll have to re-base it.
This doesn't clear up the mystery of how on earth DOTCLOCK was ticking on real hardware, however.

gardners, 2024-02-10:
ok, that's weird: Fixing the dotclock to work under simulation has it not ticking in hardware. Ah: It was expecting it in MHz, not Hz. Making consistent in Hz, as elsewhere.

gardners, 2024-02-11:
MEGA65 R1 cartridge support has been purged as it complicates things a fair bit, and is realistically no longer required on this reasoning from me:

I don't like deprecating old targets, but I also don't see that the 3 R1 boards produced are likely to be used with carts, due to: (1) their fragility (SD card is via blue-wire, for example); (2) 1 of 3 boards is locked in my cupboard; (3) the other 2 are also unlikely to be updated to recent releases due to their primary value being historical.

gardners, 2024-02-11:
/IO1 and /IO2 activate under simulation, but not on real hardware. Suspect still an issue with driving the buffer IC, most likely the direction line.

gardners, 2024-02-11:
Actually, it is working now: I can see /IO1 going low when required.

gardners, 2024-02-11:
Writing to $DE00 from hardware is causing /IO1 to go low.  Confirm that R/W also goes low at that time.
/IO1 and R/W are aligned to the clock.
Is it possible that we don't have a long enough hold time, and thus the value being written might not be latched properly by the cartridge.  According to: https://www.princeton.edu/~mae412/HANDOUTS/Datasheets/6502.pdf there is a minimum write hold time of 60ns, and 20ns for read.  Fixing that should hopefully help.

gardners, 2024-02-11:
Need to implement sub-cycle phase management to implement the differential read and write hold times.

gardners, 2024-02-11:
Also R/W and address have hold requirements of at least 30ns.

gardners, 2024-02-11:
The Tiny Quest cart itself uses a 74LS04N and 74LS173AN, as described here:
https://www.hackup.net/2019/07/bank-switching-cartridges/

In short, it definitely needs setup and hold times for things, as the 74LS173 will latch the data lines some tens of ns after the positive clock edge. Right now, we have the clock exactly synchronised with the data, and thus of course things go badly, because by the time the clock edge has been seen, by definition, the data lines are no longer showing the value.

Holding the data lines (and /IO1 and /IO2 since they can be required for decoding a write in the cartridge circuit) for half an 8MHz dotclock period will give us a delay of ~64ns, which is just about perfect based on the 6502 data sheet requirements.

gardners, 2024-02-11:
With the hold time implemented, its now being a bit weird:
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

Output changes each time, as well. Other key thing is mostly its the upper nybl of the data that is zeroed out each time.

Anyway, there is clearly something wrong still, and the changing data may or may not in fact be all that's happening, i.e., suggesting that the cartridge is not latching the address.

Actually, with the Tiny Quest cartridge, because it uses a discrete 74LS173, I can probe the latched lines directly, and see if it is in fact latching things or not.

gardners, 2024-02-11:
Confirmed by probing the board that with the hold time fixes that the 74LS173AN does latch the bank number.

So the problem must be with reading from the EPROM.  That relies on R/W being high and /ROML being low.

gardners, 2024-02-11:
Writing a little BASIC loop that reads the ROM continuously and shows the hex over the top of itself on the screen, I can see that the lower nybl values change, while the upper nybls are broadly stable, often clamped to 0.

gardners, 2024-02-11:
Without hold time fix, it looks like latching doesn't happen with the 74LS173AN, as expected.
So now to find and fix whatever the problem with reading the ROM is.  The test bed does not currently test that, nor does it model the dir and en lines for the various signals.  Next step is to expand it to do exactly that.

gardners, 2024-02-11:
Note that this cartridge design can disable itself by setting bit 3 of $DE00. After that it requires /RESET to go low to re-enable itself.
Info on the cartridge here (in German): https://www.hackup.net/2019/07/bank-switching-cartridges/
I've seen that happening sometimes on boot during testing.

gardners, 2024-02-11:
With R/W and /IO1 on cart port delayed by 125ns, I'm still not reading anything.  But the $DE00 writes to select banks now seems to be working fine. So I'm guessing that the problem is now isolated to reading from the ROM.

sy2002, 2024-02-11:
Hi @gardners - WOW! This is a thorough analysis and debugging session. Thank you for sharing each step, very interesting and helpful for me to read and to follow.

Just to give you another "impulse" - because for me personally, sometimes "debugging by thinking about the DIFF" helps :-)  Here is the thought:

Why could it be, that on an R3/R3A board the cartridge detection works fine and stable, while on an R5 board it does not? Can there be other reasons than the ones you described? For example - why would the hold time issue not be an issue on the R3/R3A? And why would we care for /IO1 and /IO2 when all that @lydon42 needs is "CBM80" at $8000?

lydon42, 2024-02-14:
> "CBM80" at $8000

It's CBM80 at $8004, and just for completeness: this is the autostart marker the C64 KERNAL looks for, a cartridge needs to pull down EXROM/GAME or no memory is mapped. We just doing this as we can access cartridge ROM without EXROM/GAME being low, and because there are weird cartridges out there not doing this properly.

Also note that an Ultimax mode cartridge does not need (nor will have) this marker **at all**, as ROMH replace KERNAL at $E000, and so the autostart is not done by looking for this marker, but because the reset vector is replaced by the cartridge ROMH.

gardners, 2024-02-17:
The above commits get all simulation-based tests passing, but Tiny Quest is still refusing to work. I did reduce the hold time for writes from ~120 to ~60 ns. Will try increasing it back.

gardners, 2024-02-18:
No change. All reads return $00, which strikes me as suspicious. I'm thinking that I have messed up something with the data direction / enable stuff, or general plumbing of the input vs output versions of the cartridge port data lines.

gardners, 2024-02-18:
Yes, there is something fruity going on: Writing $01 to $401DE00 causes all successive reads to read back as $01.

sy2002, 2024-06-22:
@paich64 @lydon42 @gardners Gentlemen, as I plan to release the C64 V5.1 core that will support R6 boards very soon (my current ETA is Friday, June 28th), it looks like I need to add something to the core's FAQ, right?

@paich64 can you confirm that 2024 users of the MEGA65 will still run into this problem here:

"A few modern C64 carts are not detected as C64 carts by core selector"

While users of older machines (or older CORE #0) will not have this probem, right?

I need to figure out what will I document in the FAQ, i.e. is there a planned fix up and coming, or is there even a better CORE #0 available, etc.

This is clearly a regression where new users have a worse experience than old users, so proper documentation is important here.

gardners, 2024-06-22:
The complication here is that the cartridge port is more compatible, but that the detection of cartridges has suffered some regressions, that we hope will get resolved in a future core update. In the meantime, the workaround is to start the C64 core manually.

Something like that?

sy2002, 2024-06-22:
@gardners I like this. And since I will probably not touch the C64 core and documentation for quite a while after the release (probably for more than a year from now on): Can I in my FAQ point to some documentation / Wiki / something that people can have a look at in future, how to upgrade CORE #0 etc. Is there a Wiki page or an Article on Filehost or something? In worst case, I could add a pointer to this issue to my documentation and tell them to search Discord, etc.

FYI: This is how the FAQ looks like: https://github.com/MJoergen/C64MEGA65/blob/V5.1-release/FAQ.md

paich64, 2024-06-22:
@sy2002 ***@***.***> to me the R6 cartridge port is running even better
than on R5 as far as i can tell.
All my real cartridges are working perfectly with R6 (including EasyFlash,
EasyFlash 3, KungFu Flash). I even have 2 custom made cartridges which
would not start on R5 and that are running perfectly on R6.
So to me, I consider the R6 as better compared to R5.
Now of course it's only based on my very own game cartridges.
Olivier.

Le sam. 22 juin 2024 à 13:06, sy2002 ***@***.***> a écrit :

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

paich64, 2024-06-22:
Let me clarify : I really mean that not only all my cartridges now run on
R6 but also, the Mega65 detects all of them and autoboots the C64 core.
But again I only have 12 game cartridges. But all in all to me,  R6 > R5 >>
R3A when it comes to auto booting C64 cartridges and being able to run C64
Cartridges with the C64 core.

Le sam. 22 juin 2024 à 16:08, olivier bernhard ***@***.***>
a écrit :

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

lydon42, 2024-06-22:
https://mega65.atlassian.net/l/cp/KT0gV88D

dansanderson, 2024-06-23:
We believe this is working well enough to resolve the issue. Thanks for the hard work getting this completed!

Closed 2024-06-23.

Thread 782 (2024-01-28):

MEGAFLASH: refactor low level flashing interface

lydon42, 2024-01-28:
In this issue we combine all the low level changes that are still needed to make MEGAFLASH work again with non-r3a+ boards.

This means: support different QSPI flash chips, support flashing and CRC32 calculation without Attic RAM, hardware acceleration, and other convenient feature that could not been added to Release 0.96 with #683

Generic goals:
- [x] fix mega65r3 (non-A) flashing (different QSPI)
- [x] fix mega65r2 flashing (should work, untested)
- [x] fix all the boards (nexys, wukong) flashing (different QSPI, no Attic RAM)
- [x] use hwaccel for integrated flasher
- [x] make atticram switchable for standalone version
- [x] make bitbash switchable for standalone version
- [x] visual feedback for verify step (progress and border)
  - [x]  ~~make border flash optional? I like flashing borders...~~
- [x] make hlflash interface check all return codes
- [x] edit slot flags requires attic ram
  - ~~either fix this or~~ disable function without attic

Sub-Issues:
- [ ] #592
- [x] #522
- [x] #711
- [x] #762
- [x] #763
- [x] #764

Optional:
- [ ] #750

lydon42, 2024-05-23:
Next Steps:
- remove attic RAM requirement  for whole core caching, perhaps  using $50000 as a 64k sliding cache instead (lydon)
- enable crc32 calc without having to use the 512byte buffers already used by flashing and sdcard reading, perhaps by making it use $40000 and 32bit offset pointers (lydon)
- abstract lowlevel qspi interface and making most of the rest of qspicommon.c obsolete (0xa000)

lydon42, 2024-09-21:
merged into development

Closed 2024-09-21.

Thread 785 (2024-02-10):

HYPERRAM: production_test fails with release-0.96 candidate

lydon42, 2024-02-10:
While adapting r3_production_test to the new boards by rewriting it into production_test (see [mega65-tools#190](https://github.com/MEGA65/mega65-tools/issues/190)), HyperRAM kept failing on both r3a an r5 boards.

I adapted test_585 (old HyperRAM problem issue) to include the cache invalidation the production test does, but 585 behaves more stable by giving a good result nearly every time. But it did also fail on me (might be a false positive due to the  state the machine was in at the moment -- alternating between test_585 and production_test via rapid etherload pushes).

Switching HyperRAM from the default slow_cache_enable to 0 does improve success rate. With slow_cache_enable and slow_cache_advance_enable it will fail every time.

SDRAM test works as expected on r5.

So it seems we do have some problem with HypeRAM.

I did test versions before the 683-cartflash merge, and they behave the some, so there is no regression from this side, as far as I can tell.

markkrueg, 2024-02-10:
Happening 100% of my production_test runs on my r3 batch 2. Zero failures running test_585.prg (over 10 runs so far).
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

markkrueg, 2024-02-10:
I'm not sure if this is meaningful; but if I run production_test, see FAIL HyperRAM, then hit reset button and immediatly run test_585 then it fails every time.  I can only run test_585 successfully on a clean power cycle where I have NOT run production_test. Using "etherload.osx -4 -r test_585.prg"
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

lydon42, 2024-02-11:
Since 0.95 the meaning of the end of 64MB area starting at 8MB has changed for HyperRAM: 0xbfffffx is used by some registers used for debugging.

The r3_production_test used to poke 0xbfffff2 to bust the line cache of HyperRAM, and now this seems to break HyperRAM in various ways.

We need to fix the tests (over in mega65-tools) and perhaps add some information about the memory area here.

markkrueg, 2024-02-11:
All tests working perfectly now using updated versions provided by @lydon42.
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

Closed 2024-02-11.

Thread 787 (2024-02-13):

CONFIGURE: MAC address typed in is not correctly mangled

lydon42, 2024-02-13:
It seems that while typing in a MAC address in the config tool, the  address is not set correctly to unicast local (first octet x2, x6, xA, xE -- (mac[0] | 0x02) & 0xfe), but instead the third bytes high nybble is changed in some other way. And you only see it after you change the page.

The MAC randomizer works as it should.

Change configure so that mac address only allows 2,6,a,e in the low nybble of the first octet. Make it that the user directly sees this change and does not have to change config pages.

lydon42, 2024-02-13:
Entering 11-11-1A, press U, and you get 12-11-3A. The change of 11 to 12 is the one expected, the change of the third byte should not happen.
If you enter 11-11-1A, then switch pages, you will get 11-11-3A, so the **required** change is **not** done.

lydon42, 2024-02-13:
Checked ethernet.vhdl: here nothing is changed on the numbers that are put into it.

M3wP, 2024-02-24:
I have found the bug causing the value of "3A" to appear.  However, limiting the user input for the first byte's low nybble is a new functional requirement.  I need further information to clarify the request.  Should I simply limit the user to inputting only those characters ('2', '6', 'A', 'E') or change any other input as per the routine to convert the value to LOCAL ADMIN UNICAST?  I believe at this stage that only allowing specific data would be best but the cause of input failure may not be immediately obvious to the user.  There is currently no mechanism for the configure program to indicate an input rejection nor a means of noting acceptable input other than the help page and tips.

M3wP, 2024-02-24:
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

Perhaps this is a solution but the extra "buttons" are selectable even though they do nothing...

Closed 2024-05-25.

Thread 788 (2024-02-13):

CONFIGURE: POWER-CYCLE screen has color issue on VGA only

markkrueg, 2024-02-13:
**Test Environment (required)**
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

**Describe the bug**
When exiting CONFIGURE you see the new-ish "POWER-CYCLE" screen. This is showing up very oddly -- almost unreadable blue on blue colors -- on VGA displays. Here is my MEGA65 with DVI display on left and VGA on right.
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

**To Reproduce**
Steps to reproduce the behavior:
MUST BE USING VGA DISPLAY
1. Hold ALT at boot
2. Choose 1. CONFIGURE MEGA65
3. Complete configuration and save.
4. See "POWER-CYCLE" screen as shown in my screenshot.

**Expected behavior**
"POWER-CYCLE" screen colors should be similar on DVI and VGA outputs and should be readable.

lydon42, 2024-02-14:
Yeah, I can confirm, for me the HDMI switches off and VGA gets a weird color.

M3wP, 2024-02-24:
Hmm...  I'm looking at this and from what I can see, there is nothing in configure that should be causing it.  At the moment, I believe that the problem probably lies in the hyppo save logic.  To confirm this I need to know if the same issue arises when you simply select Done | Exit Without Saving | OK?

lydon42, 2024-04-09:
My observations:
- startup in NTSC mode
- change nothing in configure
- select SAVE & EXIT
- screen goes blank, then switches to PAL
- displays "POWER CYCLE"

This is obviously a error, if I change nothing, nothing should change with my display. And it shouldn't change settings anyway, as the power cycle will take care of loading the new configuration.

M3wP, 2024-04-10:
Updated configure to 1.04.

[mega65_config_1_04.zip](https://github.com/MEGA65/mega65-core/files/14926914/mega65_config_1_04.zip)

I am not getting the issue with this version and the batch release core.  Please advise if I need to test a different scenario or if this update addresses the issue.

M3wP, 2024-04-10:
[mega65_config_1_04.zip](https://github.com/MEGA65/mega65-core/files/14926982/mega65_config_1_04.zip)

I believe this update should address this issue.  Please advise if this is the case.

M3wP, 2024-04-10:
Oh!  I should note that the bug causing the issue is actually in Hyppo in the syspart_trap syspart_configsector_apply_trap.  If this trap is expected to function correctly, it will need be bug-checked.

lydon42, 2024-05-25:
The hyppo part looks correct to me. The problem is the data that is copied to DE00.

It seems that hypervisorApplyConfig calls copySessionOptionsToSectorBuffer, which copies from optSessBase=$C200 to DE00. But if I set a breakpoint and inspect C200, I can only see FF in the first 16 bytes. This explains why the apply will set D06F to Cx instead of 8x, which results in the problem.

Checking C200 directly at the start of configure also shows the wrong values. One would assume that the optSessBase will be the values that one can see in the display of configure, but this seems not to be the case.

lydon42, 2024-05-25:
It seems optSessBase is no really set by anything and contains garbage. M3wP agrees that this might be an artifact from the past. Changing optSessBase to point at the same as optDfltBase will also fix the problem.
```
optDfltBase	=	$C000
;optSessBase	=	$C200
optSessBase     =       optDfltBase
```

There is **no problem in HYPPO**.

I will apply the change that disables apply now, as it is no longer needed. I will also add the optSessBase change with a comment explaining why, so that we remember in the future.

lydon42, 2024-05-25:
latest development core has the fix.

Closed 2024-05-25.

Thread 793 (2024-03-05):

Direct drive audio DAC has unusual stepwise behaviors in a test case

dansanderson, 2024-03-05:
Core: release-0.96,20240224.00,3c10488
Hardware: MEGA65 R5
Audio output: 3.5mm jack

I don't know if the direct drive audio DAC registers are intended to be useful, but I thought I'd mention this in case it's indicative of a larger problem.

Here is a short BASIC program:

```basic
10 clrbit $d711,7
15 poke $d6f8,0
20 x&=$80
30 poke $d6f9,x&
40 vsync 100
50 poke $d6f9,0
60 vsync 200
70 get a$
80 if a$=chr$(29) then x&=x&+1
90 if a$=chr$(157) then x&=x&-1
100 print chr$(147);hex$(x&)
110 goto 30
```

This generates a pulse wave at the video mode's refresh rate, a low buzzing noise, in the left audio DAC channel. Pressing cursor left and cursor right adjusts the MSB of one of the sample values (the other sample being 0000), which affects the volume of the noise. Assuming the DAC registers take a 16-bit signed value, the expected behavior is to produce a smooth volume gradient through the values, silent at 00/FF, loudest at 80, and a smooth transition both ways.

The actual behavior is unusual, stepwise, and appears to change under conditions I haven't identified. Messing with the audio mixer's LEFT DIGI setting before running the program appears to produce consistent but incorrect behavior:

* E1 to FF gradually decreases the volume to silent. (ok.)
* 00 to E0 gradually increases the volume. (should start getting quieter after 80.)
* E0 to E1 is a sudden drop in volume.

I get different stepwise behavior immediately after a cold boot without touching the mixer, and it differs each time as if based on uninitialized register values. Just one example:

* 80: silent, but 7F and 81 are loud
* 99 to 9A: sudden drop in volume

I noticed different step points, e.g. D5 to D6, on different boots, but consistent behavior during a single power-on session.

(The character of the crudely generated pulse wave sometimes changes when crossing the sign barrier but this is OK, probably just a subtle change in pulse width due to how I'm generating it.)

I have not yet tried the R3 board or HDMI audio out.

markkrueg, 2024-03-13:
Another way to reproduce the distortion:
Consistently reproduced on R3A with Release 0.96 core:
1) Set to 8580 SID, stereo, amp OFF
2) Boot DEMO disk 1
3) Select 3-Music, 2 DUAL SID COMPO, RETURN
4) Allow X-FILES to play.

Very obvious (not subtle) distortion will be aparent at about:
1 minute 38 seconds

It will continue randomly after this point.

It occurs on both HDMI and 3.5mm analog.

I have tested @MassiveBattlebotsFan pull request and the problem is gone. I have not had any problems with this fix in any other game or demo I have tested.

Closed 2024-04-30.

Thread 802 (2024-05-13):

SDRAM controller intermittant problems

gardners, 2024-05-13:
SDRAM fails with test program sometimes.
Suspect that command to set SDRAM latencies doesn't always work, so it has latency set one cycle wrong, and timing requirements are then not met at full speed.

Attached test program fails sometimes
[attictest.prg.gz](https://github.com/MEGA65/mega65-core/files/15292336/attictest.prg.gz)

Failing test runs can look like this:
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

gardners, 2024-05-13:
The two failing outputs are either:
1. a shift by 2 bytes, which since the SDRAM is DDR means 1 cycle. This is the latency difference between the default and requested mode of operation.
2. First byte of an 8-byte block is wrong. This is likely when the SDRAM is not yet set to the higher clock speed, but is driven at the higher speed, and thus the first byte isn't ready yet (first byte has tighter timing than the subsequent bytes, if I remember the data sheet correctly):

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

Another form the failure can take is that some bits of first byte in a row of 8 are stuck high or low.  Again, this looks like a variation of (2) above. Actually, it is reading the image of the same bit from another byte, in some cases byte 2 of the row of 8, suggesting that it is reading a bit too late in the DDR if the SDRAM has been put into the correct latency mode (which can't be assumed).

In terms of things that trigger changes between PASS and FAIL behaviour:

1. Soft resets don't change the status of passing or failing: 10 in a row failing case. 10 in a row passing case.
2. Power cycles can toggle pass/fail status.
3. Pushing a bitstream via JTAG can toggle status.

The above is consistent with the SDRAM controller attempting to set the latency mode on bitstream start up, but not on reset button press.  This makes sense, because SDRAM controller does not have a /RESET input. Maybe it should?

gardners, 2024-05-13:
Trying software induced reset of SDRAM chip by writing to $C000000 doesn't work (although SDRAM controller does report that it is trying to reset when this occurs).

gardners, 2024-05-13:
Note that the "slow mode" for the SDRAM controller only changes the read latency -- it doesn't change the SDRAM clock from 162MHz to 81MHz -- which is why if the Mode Register Set operation fails, that the test continues to fail.
In principle, if we dropped the clock speed of the SDRAM in half as well, it should just magically work.

gardners, 2024-05-13:
SDRAM is directly clocked from 162MHz clock via an ODDR primitive, not that it should matter.

gardners, 2024-05-13:
Things that might be worth trying:
1. Send Mode Register Set command multiple times in a row, to make sure there are no set up time problems with the bits of the command.
2. Allow switching between latching read data on +ve or -ve edge of 162MHz clock.
3. Check that we output signal updates on falling edge of 162MHz clock (or that the ODDR is inverting it), so that setup and hold times for the SDRAM lines are met.
4. Try adjusting phase of SDRAM clock (clock162m) from 207 degrees to something else. Ideally make it run-time adjustable.  Actually its currently 180 degrees according to clocking.vhdl.  This will require enabling MMCM_ADV dynamic reconfiguration: See https://docs.amd.com/v/u/en-US/ug362.

gardners, 2024-05-13:
Commit above should allow (2).

gardners, 2024-05-13:
Goals for tonight: (1) Test the above. (2) Drop clock from 162 to 81MHz and see if that fixes it, if so, check whether it is writing or reading that is failing.

gardners, 2024-05-17:
With the above we have 8 settings that can be explored.
With the SDRAM controller in the "failure" mode, setting $01 seems to allow correct writing, while $02 seems to allow correct reading. Those two settings switch the clock phase on the 162MHz clock connected to the SDRAM controller.

This points to an issue during writing in terms of the underlying problem.

(Note that if the problem is with write timing latching, this would explain why writing to the configuration register is not always working.)

Now trying to get it into the passing state, to see how these affect it in that situation.

Ok, in the passing state, reading works fine with $02, and writing with $05.  Reading with $05 in the passing state works, but with an extra cycle of delay on the read data.

Common theme: Switching the clock phase between reading and writing helps. Now, what's weird is that bit 2 of this value should switch whether we latch reads on rising or falling edge of the clock, so we shouldn't need to switch the clock phase... but it doesn't. So there is some other thing going on here.

Anyway, I'm adding the ability to add an extra cycle of latency to the read side, so that in the passing state it should be possible to have a single setting that works for both read and write.  If that works, then I can look at having a flag that allows swapping clock phase between read and write. With those two things, it should be possible to have the SDRAM work correctly in both states. This would then just require a bit of boot-strap code that determines the correct timing setting on boot.

I'd still like to figure out why it doesn't reliably configure into one or the other state, however.

gardners, 2024-05-17:
The above commits should allow automatic inversion of the clock when writing via bit 4 of $C000000.
But first to test the previous commit for adding the extra read latency when required.

gardners, 2024-05-17:
Using the above new bitstream, I wrote the following program to detect which configurations in $C000000 work:

```
0 G=-1                                                                   
 10 C=$C000000                                                            
 20 S=$8000000                                                            
 30 FORCC=0TO63:POKE C,CC                                                 
 50 FORI=0TO15:POKES+I,I:NEXTI                                            
 60 REM  FORI=0TO15:PRINTRIGHT$(HEX$(PEEK(S+I)),2);" ";:NEXTI             
 70 REM PRINT                                                             
 80 FORI=0TO15:IFPEEK(S+I)=ITHENNEXTI                                     
 90 IFI<16THEN GOTO 999                                                   
 100 FORI=0TO15:POKES+I,128+I:NEXTI                                       
 110 FORI=0TO15:IFPEEK(S+I)=128+ITHENNEXTI                                
 120 IFI<16THEN GOTO 999                                                  
 130 PRINTHEX$(CC)                                                        
 140 IFG=-1THENG=CC                                                       
 999 NEXTCC                                                               
 1000 POKEC,G                                                             
 1010 PRINT"USING CONFIG ";HEX$(G)
 ```

 This suggests that several settings work, at least on this boot (not sure if it is a fail or pass mode case).

gardners, 2024-05-18:
I've then had to patch attictest.prg, as to bust the cache it writes to ADDR + something, which means for the end part of the test, it writes to the $Cxxxxxx where the SDRAM controller is treating any write as setting the configuration.
I should also make the config writes only work at a specific address, e.g., $EFFFFFF, to minimise this kind of error.

gardners, 2024-05-18:
It looks that previous run was with it in the "pass" state. With it in the fail state, no combination passes the 2nd half of the test, where we write different values over the 16 byte range to check.

Okay.... I just somehow flipped the "fail" mode to "good" mode.  Poked $D7FE to $10, $30, $00 and $10. But not sure if it is that sequence that did it or not. Anyway, this needs further investigation to figure out what is going on.

gardners, 2024-05-18:
Reproduced by poking $D7FE,$00 and then $D7FE,$10

@lydon42 's sdram test program then passes.

The only other change here is that I poke $C000000 twice. But that shouldn't make a difference.

Ah, okay, so actually it is that $D7FE must have $10, not $30.  Just that single POKE $D7FE,$10 before running the SDRAM settings program is enough to make it work in the "fail" state now, it seems.

gardners, 2024-05-18:
Now trying loading the bitstream many times, running @lydon42 's SDRAM test, and if it fails, running my updated SDRAM settings program that does $D7FE,$10 first, to see if we get reliable SDRAM passing.

sdram_settings3.prg:
```
0 G=-1                                                                   
 5 POKE$D7FE,$10                                                          
 10 C=$C000000                                                            
 20 S=$8000000                                                            
 30 FORCC=0TO63:POKE C,CC                                                 
 50 FORI=0TO15:POKES+I,I:NEXTI                                            
 60 REM  FORI=0TO15:PRINTRIGHT$(HEX$(PEEK(S+I)),2);" ";:NEXTI             
 70 REM PRINT                                                             
 80 FORI=0TO15:IFPEEK(S+I)=ITHENNEXTI                                     
 90 IFI<16THEN GOTO 999                                                   
 100 FORI=0TO15:POKES+I,128+I:NEXTI                                       
 110 FORI=0TO15:IFPEEK(S+I)=128+ITHENNEXTI                                
 120 IFI<16THEN GOTO 999                                                  
 130 PRINTHEX$(CC)                                                        
 140 IFG=-1THENG=CC                                                       
 999 NEXTCC                                                               
 1000 POKEC,G                                                             
 1010 PRINT"USING CONFIG ";HEX$(G)        
```

Patched attictest.prg:
1. Added line `2117 BEND`
2. Added line `3015 IF B>=$C000000THENB=B-$4000000`

Run 1 - Was in FAIL state, but running sdram_settings3.prg fixed it.  Used $C000000 value $09 (but many others (more than the 4 in run 2) were indicated as likely good. I wasn't expecting changes in the list of good configs, so didn't write them down).
Run 2 - Was in FAIL state, but running sdram_settings3.prg fixed it. Used $C000000 value $09 (but three others were also indicated as likely to be good).
Run 3 -  Was in FAIL state, Configs $09, $1A, $29 and $3A indicated as likely good. Config $09 worked.
Run 4 -  Was in FAIL state, Configs $09, $1A, $29 and $3A indicated as likely good. Config $09 worked.
Run 5 -  Was in FAIL state, Configs $09, $0D, $1A, $1E, $29, $2D, $3A and $3E indicated as likely good. Config $09 worked. Also tried $3E for fun, and that worked, too.

gardners, 2024-05-18:
Above commit makes config $09 default. While that synthesises, continuing to test with previous bitstream:

Run 6 - Was in FAIL state, Configs $09, $0D, $1A, $1E, $29, $2D, $3A and $3E indicated as likely good. Config $09 worked.
Run 7 - Was in FAIL state, Configs $09, $0D, $1A, $1E, $29, $2D, $3A and $3E indicated as likely good. Config $09 worked.
Run 8 - Was in FAIL state, Configs $09, $0D, $1A, $1E, $29, $2D, $3A and $3E indicated as likely good. Config $09 worked.
Run 9 - Was in FAIL state, Configs $09, $0D, $1A, $1E, $29, $2D, $3A and $3E indicated as likely good. Config $09 worked.
Run 10 - Was in FAIL state, Configs $09, $1A, $29 and $3A indicated as likely good. Config $09 worked.
Run 11 - Was in FAIL state, Configs $09, $0D, $1A, $1E, $29, $2D, $3A and $3E indicated as likely good. Config $09 worked.
Run 12 - Was in FAIL state, Configs $09, $1A, $29 and $3A indicated as likely good. Config $09 worked.

12/12 is pretty good :)

gardners, 2024-05-18:
Still waiting for that bitstream, but running the old hyperram test program.
It is reading $AE instead of $AA for some bytes when doing the size probe, typically around the ~35MB mark.
Read stability test looks good.
Mis-write test is also good so far.
Checkerboard test looking good, too.
Oddly after running checkerboard test SDRAM size probe is now consistently fine ???

gardners, 2024-05-18:
Okay, new bitstream is cooked. Testing attictest2.prg on repeated bitstream loads...

Run 1 - Instant pass :)
Run 2 - Instant pass :)
Run 3 - Instant pass :)
Run 4 - Instant pass :)
Run 5 - Instant pass :)
Run 6 - Instant pass :)
Run 7 - Instant pass :)
Run 8 - Instant pass :)
Run 9 - Instant pass :)
Run 10 - Instant pass :)
Run 11 - Instant pass :)
Run 12 - Instant pass :)

So let's look at what config $09 actually means:
1. Bits 0 and 1 mean the SDRAM clock is inverted compared with what we had before.
2. Bit 2 is clear, so we don't latch on falling edge.
3. Bit 3 is set, so we have 1 cycle of extra latency for reads.
4. Bit 4 is clear, so we don't invert clocks on write.

Basically we have flipped the SDRAM clock and removed the need for all the inverted clock stuff that we had.  So why did this not work originally? Still some questions remain.

gardners, 2024-05-18:
Now I need others to test on their R5/R6 boards...

gardners, 2024-05-18:
Hmm... Here's my theory as to what might be going on: We were latching on the opposite side of the clock, and thus it was marginal timing as to whether the data arrived a cycle early or not, causing the appearance of the SDRAM maybe not having accepted the latency count via the configuration set command.  It's still not totally satisfying, however, as we might expect to see some jitter between reads.

gardners, 2024-05-18:
$FFD37FE must be $10, not $14 for SDRAM now, else some failures occur. The difference is that $14 enables the cache. So we have some bug with the slow RAM cache with SDRAM still.  That said, the SDRAM without cache is not so much slower than the HyperRAM with cache. But it would still be good to get this working.

Hmm... or maybe I have tickled some other problem.

Okay, so there is still some problem: Even addressed bytes seem to be ok, but odd addressed bytes are being smeared between successive odd addresses it seems. e.g.:

```
.sc000000 9

.m8000000
:08000000:00000000000000000000000000000000

.s8000001 ff

.m8000000
:08000000:00B70000000000000000000000000000

.s8000001 0 0 ff

.m8000000
:08000000:004800B7000000000000000000000000

.s8000001 0 0 0 0 ff

.m8000000
:08000000:0000004800B700000000000000000000
```

(not $48 and $B7 are complementary in binary)

But is this happening during read or write?

Changing from config $09 to $02 after the write allows us to read back the $FF correctly. So I'm suspecting it is on the read side.

```
.sc000000 9

.s8000000 0 0 0 0 0 0 0 0 0 0 0 0 0 0

.m8000000
:08000000:00000000000000000000000000000000

.s8000001 ff

.m8000000
:08000000:00B70000000000000000000000000000

.sc000000 2

.m8000000
:08000000:00FF0000000000000000000000000000
```

BUT in config 2, we can't write anything.

Configs 9 and 2 differ effectively in which side of the clock writes and commands happen on, because flipping bits 0,1 and 3 inverts both the clock phase, and the phase on which reads occur.

This means that the bit for switching whether clock phase is flipped during writes _should_ be working around exactly this problem. But it's not.

If we are issuing commands on wrong side of the clock, then the incorrect command can be latched, including config register set commands.  However, we'd expect then that reads and writes would go missing. Well, we are seeing writes go missing in some situations of this...

Configs 2 and 9 _should_ have identical read timing, but clearly don't:
```
.sc000000 2
.M8000000
:08000000:11223344556677889900000000000000
...
.sc000000 9
.M8000000
:08000000:11623344552E77889900000000000000
```

Config 9 writes fine, but doesn't read fine.
Config $D = config 9, with read phase switched, and indeed it fixes the reading:

```
.sc000000 d
.M8000000
:08000000:11223344556677880000000000000000
```

It should only affect reading, and not writing. And this time at least, it does.
Config $D is working with $FFD37FE = $10, as expected.

Passes the attictest2.prg

gardners, 2024-05-18:
Updating sdram_settings4.prg to check odd address behaviour:
```
0 G=-1                                                                   
 5 POKE$D7FE,$10                                                          
 10 C=$C000000                                                            
 20 S=$8000001                                                            
 30 FORCC=0TO63:POKE C,CC                                                 
 40 IFCCAND3=2 OR CCAND3=1THEN NEXT CC                                    
 50 FORI=0TO15:POKES+I,I*17:NEXTI                                         
 55 FORI=0TO15:Z=PEEK($9000000+I):NEXT:REM BUST CACHE                     
 60 REM FORI=0TO15:PRINTRIGHT$(HEX$(PEEK(S+I)),2);" ";:NEXTI              
 70 REM PRINT                                                             
 80 FORI=0TO15:IFPEEK(S+I)=I*17THENNEXTI                                  
 90 IFI<16THEN GOTO 999                                                   
 100 FORI=0TO15:POKES+I,64+I*17:NEXTI                                     
 105 REM FORI=0TO15:PRINTRIGHT$(HEX$(PEEK(S+I)),2);" ";:NEXTI             
 106 REM PRINT                                                            
 110 FORI=0TO15:IFPEEK(S+I)=((64+I*17)AND255)THENNEXTI                    
 120 IFI<16THEN GOTO 999                                                  
 130 PRINTHEX$(CC)                                                        
 140 IFG=-1THENG=CC                                                       
 999 NEXTCC                                                               
 1000 POKEC,G                                                             
 1010 PRINT"USING CONFIG ";HEX$(G)
```

It now recommends config $D instead of config $9.

hyperramtest.prg also likes config $D better. Read stability etc now happy with the cache enabled :)

gardners, 2024-05-18:
Now to try many runs and make sure it always works...

Run 1 - good
Run 2 - good
Run 3 - BAD!

The smearing of bits between the successive odd bytes cannot be resolved by any configuration.

Tellingly, the 2 byte offset is happening again here, so I am still very much of the view that the root cause here is that the configuration register set command is not being accepted.

Try issuing config register set twice in a row, so that the values are stable on the SDRAM bus, even if it is latching on wrong clock half?

gardners, 2024-05-18:
That change is synthesising, but let's see how often this problem is occurring

4 more good runs in a row.
1 bad
2 good
1 bad
...

Let's see if the new bitstream helps.

gardners, 2024-05-18:
With the new bitstream:
15 good run (and showing many more viable options: $02, $0d, $11, $1e, $22, $2e, $31, $3D
(sometimes it has $e and $1d instead? or was that my imagination)
In each case, config $2 was selected as the one to use. Updating VHDL to default to that.

gardners, 2024-05-18:
Now doing repeated runs to confirm function, with attictest2.prg

7 consecutive run(s) passed, just using default config $2.
1 fail. No configs work. Odd addresses are having their bits spread between successive clocks again.

Changing read latching between positive to negative edge does not resolve the problem this time.
Will begin investigating why using writes to $C000000 isn't able to resolve it via repeated configuration of the SDRAM.

gardners, 2024-05-18:
Okay, for the first time, I have flipped the SDRAM from fail to pass state, without resetting the FPGA:

```
.sc000000 2d

.M8000000
:08000000:2D2D2D2D000102032D2D2D2D08090A0B

.sffd37fe 14

.M8000000
:08000000:000102030405060708090A0B0C0D00F

.s8000000 99

.M8000000
:08000000:990102030405060708090A0B0C0D00F
```

How and why?

gardners, 2024-05-18:
Get it to boot in fail state again, and then try to reproduce the mode fix.

Ah, but the new bitstream has also built. So let's test performance again...
20 consecutive pass runs

Okay, so that looks good.

Let's disable the $Cxxxxxx debug register, so that test programs can't mash it.

gardners, 2024-05-18:
Something is still sensitive for timing, as the first commit above consistently fails SDRAM test.
The 2nd commit above is to resolve this by making it configurable initially, but then allowing $Cxxxxxx to ignore writes after that, thus forcing the logic to still be in there.

lydon42, 2024-07-28:
commit c1ded009c896300a256ec5609af0d8e2b7e5e7bc does a few things that seems to make slow mode more stable. fast still seems to be problematic.

Thread 822 (2024-08-21):

Observation of odd behaviour of paddles

gurcei, 2024-08-21:
While working on sea wolf, I've been trying two paddle pairs in both control ports 1 and 2 (giving 4 paddles).

The game behaves fine on the c64-core with these 4 paddles, and also on a real c64.

However, on the mega65-core (I'm on cia_oneshot,20240820.05,4f64494, which was branched from development branch from commit#0b5312c0a8).

- On some (rare?) power ons, feel like there's a mixup in which button in the paddle pair is for which paddle. E.g. paddleA can't fire, but paddleB seems to fire on behalf of paddleA.
- For most other power-ons, the fire button mixup isn't a problem
- But on every power-up, I see:
  - 1st pair on control port 1: paddleA works fine, but paddleB's movement is a bit haphazardous. Sometimes it listens to the paddle movements, sometimes it doesn't, or only goes halfway across the screen even though the paddle is fully steered one direction
  - 2nd pair on control port 2: both paddleA and paddleB work fine here

gurcei, 2024-08-23:
Ok, seem to have gotten a work-around for the glitchy paddle B on control port1 playing sea-wolf with MEGA65 core.

Going to m65 config, if I turn off the "1351 de-jitter" settings here, the problem goes away:
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

Ok, nice, I'm happy to let this be a temporary workaround for now and save me any further digging... 😄

A more ideal solution would be to dive deeper into the logic within "mouse_input.vhdl" and understand why this hysteresis/de-jitter stuff is screwing up this paddle...

...but I'm out of steam 😄

gurcei, 2024-08-29:
Another observation on this point:

> On some (rare?) power ons, feel like there's a mixup in which button in the paddle pair is for which paddle. E.g. paddleA can't fire, but paddleB seems to fire on behalf of paddleA.

The mixup I observed today was interesting and differed from the explanation above:

- While playing original sea wolf on the MEGA65, the fire buttons for the paddle-pair on port1 seem to have been mixed up with the fire buttons of the paddle-pair on port2
- I then noticed that if I played my 4-player paddle version of sea-wolf, the problem seemed to go away...

Strange... On a real C64, both versions work normally. Feel like something might be amiss on powerup in relation to the paddles (maybe my 4-player version toggles between paddle settings so frequently, it cleans up the problem in some way I haven't fathomed yet).

ki-bo, 2024-09-01:
I think if you change the DDR or port pins of a CIA it takes some time until those changes take effect. Can it be that in 40MHz mode the CPU is just much faster and configuration is too close to reading the data pins? Can you try adding some delay between those?

All this is assuming that you do change the DDR/port configuration of the CIA, though. If that is not the case, then this is probably some other issue.

lydon42, 2024-09-07:
The problem with the paddle on port 1 is most likely fixed by #828

Will you debug the fire button issue further?

gurcei, 2024-09-09:
Okidoke, will test the paddle port 1 misbehaviour matter today.

As for the fire button issue, not sure when I can look into it, but I hope to at some stage.

gurcei, 2024-09-10:
Ok, I've given build [development#125](https://builder.mega65.org/job/mega65-core/job/development/125/) for the https://github.com/MEGA65/mega65-core/issues/828 fix a try now.

I've turned de-jitter settings back on in config, and yes, it has repaired my issue on port 1 - paddle B, it now moves smoothly with the de-jitter config setting turned on, thanks :)

So yep, the only remaining part of this ticket is that fire button issue, will try assess that next

gurcei, 2024-09-10:
Ah ok, in the original sea wolf, I've noticed that if I tweak this line, I can make paddle movement work properly:

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

So according to the C64 ref manual (and I'll attach a screenshot of a related slide from sea wolf disassembly video):

- When DC00.7 = 0 and DC00.6 = 1, then we've connected port1 paddles to the ADCs
- When DC00.7 = 1 and DC00.6 = 0, then we've connected port2 paddles to the ADCs
- When DC00.7 = 1 and DC00.6 = 1, this behaviour hasn't been defined...

Aah, but while playing sea wolf on a real C64 (with original game, without my tweak above), I noticed the following:
- The game plays fine with paddles plugged into port 1
- If I plug in paddles into port 2, I can move the submarines, but I can't fire any missiles

So this is giving me the impression that when DC00.7 = 1 and DC00.6 = 1, then both port1 and port2 paddles have been connected to the ADCs at the same time :D

So to me, this seems to be an oversight (mild bug) in the original game. Hmm, whether we want to replicate such an odd use-case for DC00.7 and DC00.6 in the MEGA65, I'm unsure.

Part of me feels like folks that want to preserve such quirks can rely on the C64 core. Then again, if this matter impacts many paddle games (I don't think there are many), then perhaps that might provide some incentive to add logic like this into our mega65 core too.

Perhaps other paddle games worth checking in relation to this might be other early release titles from HAL Laboratory like "Rally" and "Pinball Spectacular"... I'll see if they suffer similar problems...

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

gurcei, 2024-09-10:
Had a quick play of **Pinball Spectacular** on my c64:
- Doesn't have this problem. It only works with paddles on port1. I tried switching to paddles on port2 midway in a game, it ignored any paddle input from port2.

I tried "**Le Mans**" next on my c64:
- Doesn't have this problem. It only works with paddles on port1. I tried switching to paddles on port2 midway in a game, it ignored any paddle input from port2.

Ok, so this problem seems to be unique to sea wolf only...

gurcei, 2024-09-10:
Closing this as "Won't fix".

Closed 2024-09-10.

Thread 824 (2024-08-22):

Keys No Scroll/Tab/Alt/Help/F9 also read as joystick port 1 input

dillof, 2024-08-22:
Tested on an R6 mainboard with the latest official release 0.96 3c10488, the keys from the last keyboard column are also read as joystick port 1 input. This is both in BASIC and when directly reading from the CIA.

This does not happen on an R3 mainboard, at least with core version 0.95 93d55f0.

You can easily test it with the following BASIC program by pressing any of the affected keys:

```basic
10 PRINT"{clear}"
20 PRINT"{home}";JOY(1);"  ",JOY(2);"  "
30 GOTO 20
```

Since it also happens when reading the CIA ports directly, I think it's a core issue, not a ROM issue.

ki-bo, 2024-09-01:
I was running into the exact same issue when implementing MEGASPUTM for Maniac Mansion. As on the C64, the CIA port bits are used for both keyboard scanning and for joystick input. If you really want to be sure that you only see joystick port lines pulled to low, all keyboard matrix lines need to be pulled HIGH during that scan. That way, a CIA input of LOW will really result from a joystick port input. The problem now is that the C65 had more keys than a C64, so the 8 bits for the matrix scan were not sufficient anymore. Commodore therefore decided to use 9 bits for the matrix scan. The 9th bit is used from port E of the C65 UART: You need to also control bit 1 of port E. $d607 is the data port and $d608 is the DDR. Once you make sure to set that port bit to OUTPUT and HIGH during the scan, the additional keys in the keyboard matrix will not be able to produce a LOW input anymore (which will provide a mismatch with joystick input).

Please be aware that switching the outputs between LOW and HIGH will take some latency to take effect, to don't just do that immediately before reading the inputs. Be sure to provide some time to let those CIA configuration settle.

ki-bo, 2024-09-01:
Maybe re-test your example with the following amendment:

`15 POKE$D607,2:POKE$D608,2`

This will set bit 1 of UART port E to HIGH and OUTPUT, and you should not see any mismatch anymore. Maybe the JOY scan in ROM should be adapted to have this bit pin controlled during the scan. But the hardware part seems to work as documented.

dillof, 2024-09-01:
Yes, that works, thanks.

dansanderson, 2024-09-01:
I have created corresponding issues for the ROM and documentation, so we can fully describe what a joystick controller needs to do at some point.

I gather that there are no changes needed to the core for this, so I'll resolve this issue. Please re-open if I'm missing a need for a core change.

Closed 2024-09-01.

Thread 826 (2024-08-29):

Allow DMA src/dst addresses to cross MB boundaries

ki-bo, 2024-08-29:
Tested with 0.96 release core

A DMA job filling or copying data does not update its configured MB part of the src/dst address during job execution. For example, if a copy job crosses a MB boundary for its src address from $81fffff to $8200000 it will actually jump back to $8100000.

lgblgblgb, 2024-08-30:
Is this a bug? I remember when I wrote the emulation of this, and Paul said, this is the desired behaviour to be wrapped within the 1Mbyte region, ie DMA cannot cross 1 Mbyte boundary by design. Well, "IIRC" ...

lydon42, 2024-08-30:
Good point @lgblgblgb
@gardners also mentioned that this is a protection so that a DMA job does not cross from  $FExxxxx to $FFxxxxx.
So perhaps we should keep this as it is, as protecting against this overflow is a rather special check and would effect other address ranges, like $BExxxxx to $BFxxxxx (end of 64MB Attic RAM) or $8Exxxxx to $8Fxxxxx (end of 16MB Cellar RAM).

lgblgblgb, 2024-08-30:
Also there can be corner cases when something other depends on it, ie, doing a DMA job at the end of an 1Mbyte "slice" (right at the end) with chained jobs, so if MB is updated the next DMA "sub-job" in the chain will experience different MB setting which was not the case before.

ki-bo, 2024-08-30:
After discussion with @gardners we propose to add another DMA option to disable the 1MB limit for the current job.
- This will not introduce backwards compatibility issues with existing code
- That option will be ignored in HYPPO context to not impact security

lydon42, 2024-09-04:
Moving this to near future, is it no release requirement.
Steering Group has approved the implementation as a DMA option.

lydon42, 2024-09-09:
Steering Group decided to include the global option bit (4 votes for global bit plus job option, 2 votes for job option only, 2 abstains).

So please also implement the global option bit in $D703.

Closed 2024-09-14.

Thread 828 (2024-09-06):

POT lines jittering in bit 1

ki-bo, 2024-09-06:
Core 0.96

Attaching a 1351 mouse to either port, the POT lines should only jitter in bit 0, but with a MEGA65 core, they jitter in both bits 0 and 1.
Using the same hardware with C64 core shows the expected jitter. The problem is that most mouse driver implementations don't expect jitter in bit 1 and behave very unstable in their movements. Some implementations (like BASIC65 MOUSE ON) use a special way to handle old sampled values that are remembered, but those just work due to limiting themselves to a lower resolution which should not be the case.

Use this test program on a C64 core and the MEGA65 core to reproduce:
```
10 X=PEEK(54297) AND 254 : Y=PEEK(54298) AND 254
20 PRINT X,Y : GOTO 10
```

On C64 core, the printed numbers stay stable. On MEGA65, they jitter quite a lot. This is not just related to BASIC, but also is reproducible if the values are read with a machine language program.

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

ki-bo, 2024-09-07:
The jitter is indeed in bit0 (expected) _and_ in bit1 (unexpected). There is a de-jitter function in the core that can eliminate the bit1 jitter, thus making the mouse usable for regular mouse driver implementations known from the C64. This had an issue with vertical movements in port 1, which was just a copy/paste error in the VHDL. The above commit fixes this so 1351 mice should perfectly work now at least with the de-jitter option enabled.

Closed 2024-09-07.

Thread 845 (2024-11-19):

TeensyROM cart won't boot to menu when delaying boot through core select menu

dansanderson, 2024-11-19:
The [TeensyROM](https://github.com/SensoriumEmbedded/TeensyROM?tab=readme-ov-file) utility cartridge can load its menu in GO64 mode with MEGA65 core v0.95, but is not detected with core v0.96.

I confirmed this on an R3 mainboard. v0.95 is not available for the R6 mainboard, and I don't need it to be. I'm noting the difference between the two cores in case it helps identify a reason why TeensyROM is not currently working with the MEGA65 core.

Repro:
1. Power off the MEGA65.
2. Connect TeensyROM to the expansion port.
3. Hold No Scroll, power on. In core menu, select MEGA65 core v0.96.

Expected: Boots to GO64 mode, opens TeensyROM menu.
Actual: Boots to MEGA65 mode.

Repeat with MEGA65 core v0.95. It performs the expected behavior.

Both the working case with core v0.95 and the non-working case with core v0.96 were using ROM 920408, so it's not expected to be a difference in the ROM startup procedure.

----

We're interested in TeensyROM working with the MEGA65 core because 1) it's neat that some features already work with GO64 mode, and 2) we'd like to someday have a MEGA65 branch of the menu software, USB MIDI features, etc. Getting this working with the latest core on an R6 board will help us test features that may rely on R6-exclusive bidi I/O.

We're also interested in TeensyROM working with the C64 core. As of C64 core v5.1, TeensyROM is not detected as a cartridge and does not boot to the menu. This is a separate issue and not expected to be related to this one. https://github.com/MJoergen/C64MEGA65/issues/143

dansanderson, 2024-11-19:
Thanks to Amok I already have an update, related to a comment on the other C64MEAG65 thread:

If I disable the C64 core auto-boot by updating its properties in the core selection menu, such that no core is the target of C64 cart auto-boot, powering on with TeensyROM connected will boot the MEGA65 core *and* it correctly detects it, boots to GO64 mode, and runs the menu successfully.

So this is not necessarily a MEGA65 core regression, just an oddity of the boot sequence when booting the MEGA65 core manually from the core selection menu. As per the C64MEGA65 thread, this may be related to reset timing: the core select menu causes too much time to pass for the TeensyROM to boot properly. Maybe the fixes discussed on the other issue are sufficient for this.

dansanderson, 2024-11-19:
Actually I'm just going to close this. If we think of a behavior that the MEGA65 core should have to better accommodate TeensyROM I'll file a new issue.

Closed 2024-11-19.

Thread 857 (2025-01-16):

[nexys4ddr-widget] Recent development seems to be stuck in ROM startup

lydon42, 2025-01-16:
The recent development builds of mega65-core (at least140, perhaps also 138 and up) seem to be stuck in ROM startup (blue screen, no prompt).

We need to find out which commit did break things for nexys.

lgblgblgb, 2025-01-16:
Maybe I'm totally off now, but this reminds me a very similar Xemu issue back to then: https://github.com/lgblgblgb/xemu/issues/395

However that was a CIA emulation problem/inaccuracy in Xemu which caused that: I wouldn't think this is the case here, that CIA implementation in the core breaks only with the Nexys board but not otherwise. Anyway, I guess I add this comment just in case. If it doesn't help, feel free to delete this comment of mine to reduce the noise :)

geir-straume, 2025-01-17:
On my Nexys A7, development build 132 is the latest that works. This is with ROM V920395.
Builds 134-141 just get stuck on the blue screen. (I could not find any build 133.)

lydon42, 2025-03-09:
It seems the thing is stuck in reset, I see it going through FA16 again and again (which is the address stored in ($FFFE). So there must be something in the reset process that does not work out as it should.
Testing with 920408.
Could it be something from the IEC branch that does not work out anymore, as the nexys does not have a IEC port?

0xa000, 2025-03-11:
On the QMTECH Wukong board, a core build from commit 347143a (Mar 9) also hangs on a blue screen without a prompt.

0xa000, 2025-03-11:
Ok, it seems I've found a one line fix.

0xa000, 2025-03-11:
I suppose it would be a good idea to check if all the other IEC related signals behave as a IEC port with nothing connected to it when not generating the hardware IEC component. Otherwise the DOS might still run into issues, I guess. However, I've tried mounting a D81 and loading a PRG from it, and that at least seems to work fine.

Closed 2025-03-16.

Thread 895 (2025-05-15):

Automatic core select not working with some C64 cartridges

deftmega, 2025-05-15:
**Test Environment**
You can use MEGAINFO from within FREEZER to obtain this information
(long press RESTORE to enter FREEZER, then press HELP to start MEGAINFO)
 - Platform: r6
 - Core Commit: 20250422.09.aaf4542
 - ROM Release: ROM not involved

**Bug**
MSSIAH and MAGIC FORMEL cartridges (C64 carts) do not trigger automatic core selection

**To Reproduce**
Steps to reproduce the behavior:
1. Switch OFF MEGA65
2. Insert cartridge
3. Switch ON MEGA65
4. See _no_ blue LED
5. C64 core was not triggered
6. See error

**Expected behavior**
C64 core should autoboot. MSSIAH runs if C64 core is manually started.

**Additional context**
Why did I exactly borrow the MSSIAH cartridge to you @lydon42 ?! :D

lydon42, 2025-05-16:
Because so I could determine if it works like a cartridge. Answer: it does not.

Please provide extra debug: enter MEGAFLASH, press HELP for MEGAINFO, press F1 for cartridge debug output. Paste here.

Expected output is $d67e 60 (now 60), which means that neither EXROM nor GAME were low. I also don't expect a signature in 8004, as the MSSIAH wants to be tickled the right way.

So: we won't support that, because it makes no sense to make a special exception for one cartridge nobody actually uses.

lydon42, 2025-05-16:
This is a duplicate of #161

Closed 2025-05-16.

Thread 899 (2025-06-12):

CIA timers leak/tear to 0xFFFF when they underflow

gurcei, 2025-06-12:
**Test Environment (required)**
 - Platform: MEGA65R3
 - Core Commit: 11fcb6d (2025-05-20) (latest development branch)
 - ROM Release: (i.e. 920413)

**Describe the bug**

There appears to be a bug in our CIA timer implementation that lets the underflow case of the timer (counts down from 0 to 0xFFFF) to be potentially visible to the end user.

**To Reproduce**

I'd suggest connecting m65dbg to the hardware over jtag, and then:

1. Set CIA2 Timer A to a very low value to count down from, e.g.: 0x001, with `s ffd3d04 01 00`
2. Check what Timer A value you read back from CIA by typing: `pmw ffd3d04`
3. Now hold down your ENTER key, to repeat the last pmw command multiple times.
4. Observe that you will see values of either `0001` or `0000` most of the time
5. ...but sometimes you will see values like `ff00`, which hint that this underflow has become visible for a fraction of a second...

**Expected behavior**

I've shared some thoughts about it in this discord thread:
- https://discord.com/channels/719326990221574164/807955369224568912/1382492354467856404

Inside `cia6526.vhdl`, I feel like we can assure that 0xffff is always hidden from the end user.

There will be some blowback effects by repairing this, as the current rom has formed a dependency to this wrong behaviour to get out of a tight assembly loop that monitors CIA2 TimerA upon bootup. This can be repaired later in the rom though, and I provide the following suggested approach to resolving this matter:

- Modify vhdl to avoid timer showing 0xFFFF
  - confirm that this will cause existing rom to lock-up on blue screen on startup
- Modify rom with johnwayner's suggested tweak
  - confirm that this resolves the blue-screen lockup issue
- check that this change doesn't impact the issue fredrikr raised about the SLEEP command:
  - https://github.com/MEGA65/mega65-rom-public/issues/37
  - I.e., we can run that little BASIC program test case he shared for 72 or more minutes and see if SLEEP locks up

gurcei, 2025-06-12:
Ok, final step, run fredrikr's little basic test program for more than 72 minutes and assure it doesn't freeze up:
```
10 print int(ti)
20 sleep 10
30 goto 10
```

Yes, checking about 80 minutes later, I see it still ticks away every 10 seconds:

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

This amount of 856 seconds seems to equate to 865/60 = 14 minutes, which is roughly the time that probably passed since that 72 minute wrap-around moment.

So all good in this regard too.

I think the solution is good to go.

Closed 2025-07-27.

Thread 909 (2025-07-14):

Proposal for RRB object drawing using the DMA controller

gardners, 2025-07-14:
**Is your feature request related to a problem? Please describe.**
This is part of a series of issues considering an extension to the DMA controller to make RRB objects more powerful and easier to use.

**Describe the solution you'd like**

See below for my shamelessly LLM-collated summary of our current thinking.

**Describe alternatives you've considered**
Do nothing.

**Additional context**
No action to be taken until further stakeholder consultation.

# 🚀 Proposal: DMA Controller Enhancement – RRB Object Drawing Mode

## 🎯 Motivation

The MEGA65’s DMA controller supports high-speed memory transfers and chaining for advanced graphics. The VIC-IV’s Raster Rewrite Buffer (RRB) enables complex mid-raster text-mode rewriting for effects like split screens, overlays, and smooth scrolling.

**Problem:**
Today, building and managing Screen RAM / Color RAM layouts for RRB effects requires CPU-heavy work:

- Placing RRB tokens into Screen RAM in the right locations
- Managing multiple RRB playfields safely on a single screen
- Inserting terminating GOTOX tokens correctly
- Avoiding accidental erasure of unrelated screen regions

**Goal:**
Add a new **RRB Object Drawing Mode** to the DMA controller that can *autonomously* render structured RRB objects into Screen RAM and Color RAM, respecting bounds and supporting multiple playfields.

This dramatically reduces CPU overhead for games and demos using complex text-mode overlays.

---

## ⚙️ Overview of RRB Object Drawing Mode

A new DMA mode is proposed, which:

✅ Draws structured “RRB objects” from memory into Screen RAM and Color RAM
✅ Allows arbitrary placement via DMA chaining
✅ Supports automatic GOTOX insertion at end of each row
✅ Supports bounded regions per line to avoid overwriting other playfields
✅ Supports multiple objects per DMA chain

---

## 📐 RRB Object Memory Layout

An **RRB object** in memory is structured as follows:

Offset Content Bytes

0 Rows (height in text lines) 1 byte
1 Columns (width in text columns) 1 byte
2+ Character data: 4 bytes each
- Screen RAM data (16 bits)
- Color RAM data (16 bits)

(note this means that the data is screen 0, screen 1, colour 0, colour 1 for each character, beginning with the top row, left to right, and then the following rows.)

Example object in memory:

| Offset | Value (Example)                    |
| ------ | ---------------------------------- |
| 0      | 2 (rows)                           |
| 1      | 3 (columns)                        |
| 2–5    | Screen + colour for top left char      |
| 6–9    | Screen + colour for top middle char      |
| 10-13    | Screen + colour for top right char      |
| 14-17    | Screen + colour for bottom left char      |
| 18-21   | Screen + colour for bottom middle char      |
| 22-25    | Screen + colour for bottom right char     |
---

## 🗺️ DMA Job Parameters in RRB Drawing Mode

When the DMA controller is in RRB Object Drawing Mode:

| Field              | Description                                             |
|---------------------|---------------------------------------------------------|
| Source Address      | Address of RRB Object definition in memory (allows multiple identical objects to be easily drawn)            |
| Destination Address | Encodes screen X, Y position for upper-left corner in pixels (MSBs of each in the BANK byte of the address, LSBs in the lower 16-bits of the destination address).     |

The controller uses configured screen layout info to calculate where to place each cell in Screen RAM and Color RAM.

---

## 🏗️ DMA Mode Configuration (Set Once)

Global DMA configuration for this mode includes:

Enable RRB drawing mode: option 0x21
Disable RRB drawing mode: option 0x22
✅ Screen RAM Base Address  (options 0xA4 -- 0xA7)
✅ Color RAM Base Address  (options (0xA8 -- 0xA9)
✅ Screen Geometry:
  - Number of rows/columns visible  (options 0xAA, 0xAB)
  - chars per line in RAM (including space for RRB metadata / padding)  (options 0xAC, 0xAD)
✅ **First and Last _Character_ Offset per Row:**
  - Defines the *reserved area* within each row for RRB tokens   (options 0xAE and 0xAF)
  - Supports multiple RRB playfields on a single screen safely

---

## 🖋️ Drawing Behavior

For each RRB object draw command:

1. Decode destination address → target X, Y in pixels
2. Read Rows, Columns from source address
3. For each cell:
   - Compute RAM offset from screen geometry
   - Write Screen RAM and Color RAM values (16 bits each)

✅ Uses bytes-per-row config to handle off-screen padding correctly
✅ Obeys first/last offsets to avoid overwriting unrelated playfields

---

## 🏁 Automatic Line Termination

At end of the chained RRB object writes:

✅ DMA controller writes a **terminal GOTOX token** immediately after the last-used token on each affected row
✅ Fills or preserves remaining bytes up to configured *last offset* with 1px wide chars (to prevent wrap-around of 1024 limit on RRB offset)

This ensures:

- RRB parsing knows where to stop
- Unused space remains safe
- Multiple RRB playfields coexist cleanly

---

## ⚡ Multi-Playfield Support Example
Screen RAM Line:
| Normal Text | ... | [First Offset] -> RRB tokens written here -> [GOTOX] -> [Fill up to Last Offset] | Rest |

By setting **first and last offsets**, multiple independent playfields can live on the same screen rows without collisions.

---

## 🔗 Integration with DMA Chaining

Each RRB object draw is one DMA job in a chain. DMA lists can:

✅ Chain together arbitrary numbers of RRB objects
✅ Control where each object lands on screen by destination address
✅ Support complex multi-layered graphics without CPU rewriting of screen memory

---

## 🧩 Benefits

- 🚀 *Massive CPU offload* for graphics compositing
- 🎨 *Pixel-precise placement* of RRB objects
- 🗂️ *Safe multi-playfield support*
- ⚡ *Automatic line termination and fill*
- ✅ *Integration with existing DMA chaining for complex scenes*

---

## 🏗️ Suggested Hardware Implementation Notes

- DMA FSM parses new RRB Object Drawing mode
- Computes RAM addresses from screen geometry
- Inserts GOTOX automatically
- Manages first/last offsets per line for safe multi-playfield writes
- Fully compatible with existing DMA chaining structure

---

## 📜 Summary

This proposal introduces an advanced **RRB Object Drawing Mode** to the MEGA65 DMA controller, enabling *hardware-accelerated*, *modular*, *multi-playfield* graphics in text modes with minimal CPU work. No more fiddling with composing RRB tokens in code: Just tell the system where you want your almost arbitrary set of objects drawn.

It is fully backward-compatible with existing DMA modes while greatly increasing flexibility and power for games, demos, and creative applications.

gurcei, 2025-07-14:
Just to repeat a comment I had on discord, of having mulled over why I felt some reservations. I think it's because I was hoping out of this, we could also get some wins for petscii object blitting too, which is purely in char-based units.

So maybe all this talk of pixel-based units feels like a very rrb-centric win is being focused on, and maybe the simple petscii object win will get lost in this.

I've had a read of your proposal above, I think I get the gist of it, I think it sounds like a good thing that will help RRB-usage a lot, but I feel the simple petscii object use-case (in char-units) is presently neglected with this proposal.

My worry here is, putting the needs of the more complex RRB use-case before the (I suspect much simpler) petscii-object use case might be cart before the horse.

Maybe there might be merits in getting that simpler petscii-blitting scenario working first (a bonus if it could crop to a viewport), and then build upon that with functionality needed for the rrb use-case.

Some other questions I had on the proposal:

1) supporting multiple "playfields"
  - what are 'playfields'?
  - Are they the columns of off-screen char data relating to a single seam object? (to manage its movement along the y-axis?)

2) respecting "bounds"
  - is this meaning the bounds of the screen?
  - or the bounds of a viewport?
  - or both?

3) Allows arbitrary placement via "DMA chaining"
  - how is arbitrary placement achieved via 'DMA chaining'?
  - after reading the full proposal, it seems more like 'DMA chaining' was suggested as a means to chain the drawing of multiple rrb objects in one hit?

4) "2+ Character data 4 bytes each"
  - I see from the example given that screen+colour data is interleaved per seam char.
  - What is the win with having it arranged that way?
  - Would it be better if it was simply the block of screen data first, followed by the colour data next?
  - That way, it just needs to trigger two chained dma calls to draw them?

5) DMA Job Params: Destination Address usage
  - So you'd re-purpose this dest-address field to relate to X,Y position (in pixels) of the object, and then the controller figures out where to place things based on the current screen configuration
  - One downside I see here is that you are locking this blitting action to refer solely to blitting of an rrb object to the screen
  - This might then neglect the possibility that a dev might want to blit objects to a double buffer first (a use-case close to my heart when it comes to my hopes of blitting simple petscii objects)

6) The proposal doesn't make mention of other duties the dma controller would need to do to achieve this pixel-based x,y control of the rrb object. From my recent foray at drawing such rrb objects, I saw other duties are needed to be done, such as:
  - terminate the initial gotox chars of the prior y-location of the object (so it is no longer visible there)
  - achieve the desired char y-position by converting the given y (in pixel units) into char units
  - achieve the pixel-perfect y-position by calculating the mod(y, 8) offset and applying it to the initial gotox char's "fcm_yoffs" field
    - Also fiddle with the initial gotox char's "rowmask_flag" and "rowmask" fields to assure no crud from unwanted char data appears
    - I found I also had to repeat a copy of the last y-row twice, for the case that this last row's chardata has scrolled down due to "fcm_yoffs", so this 'lost' part has to be drawn in this repeated row, with tweaked values for gotox fields like "fcm_yoffs_dir", "fcm_yoffs", "rowmask_flag" and "rowmask".
  - apply the desired x-position into the initial gotox char's "gotox_pos" field (for the y-rows where it will be visible now)

Ok, so that's a lot of extra stuff to manage, probably not the usual "bread-and-butter" stuff a dma chip would handle, but ok, sure, we can do it, and get a nice win for RRB-usage.

Given that we'd be prepared to go these lengths to get that win for RRB though, it still makes me feel like the smaller win of just getting a blitting action working for a simple petscii object (with viewport cropping too if possible) might be a quicker low-hanging fruit win to aim for first (which this more ambitious rrb-object use-case can benefit from later too).
