MEGA65/mega65-core/docs/images/iomapper.pdf

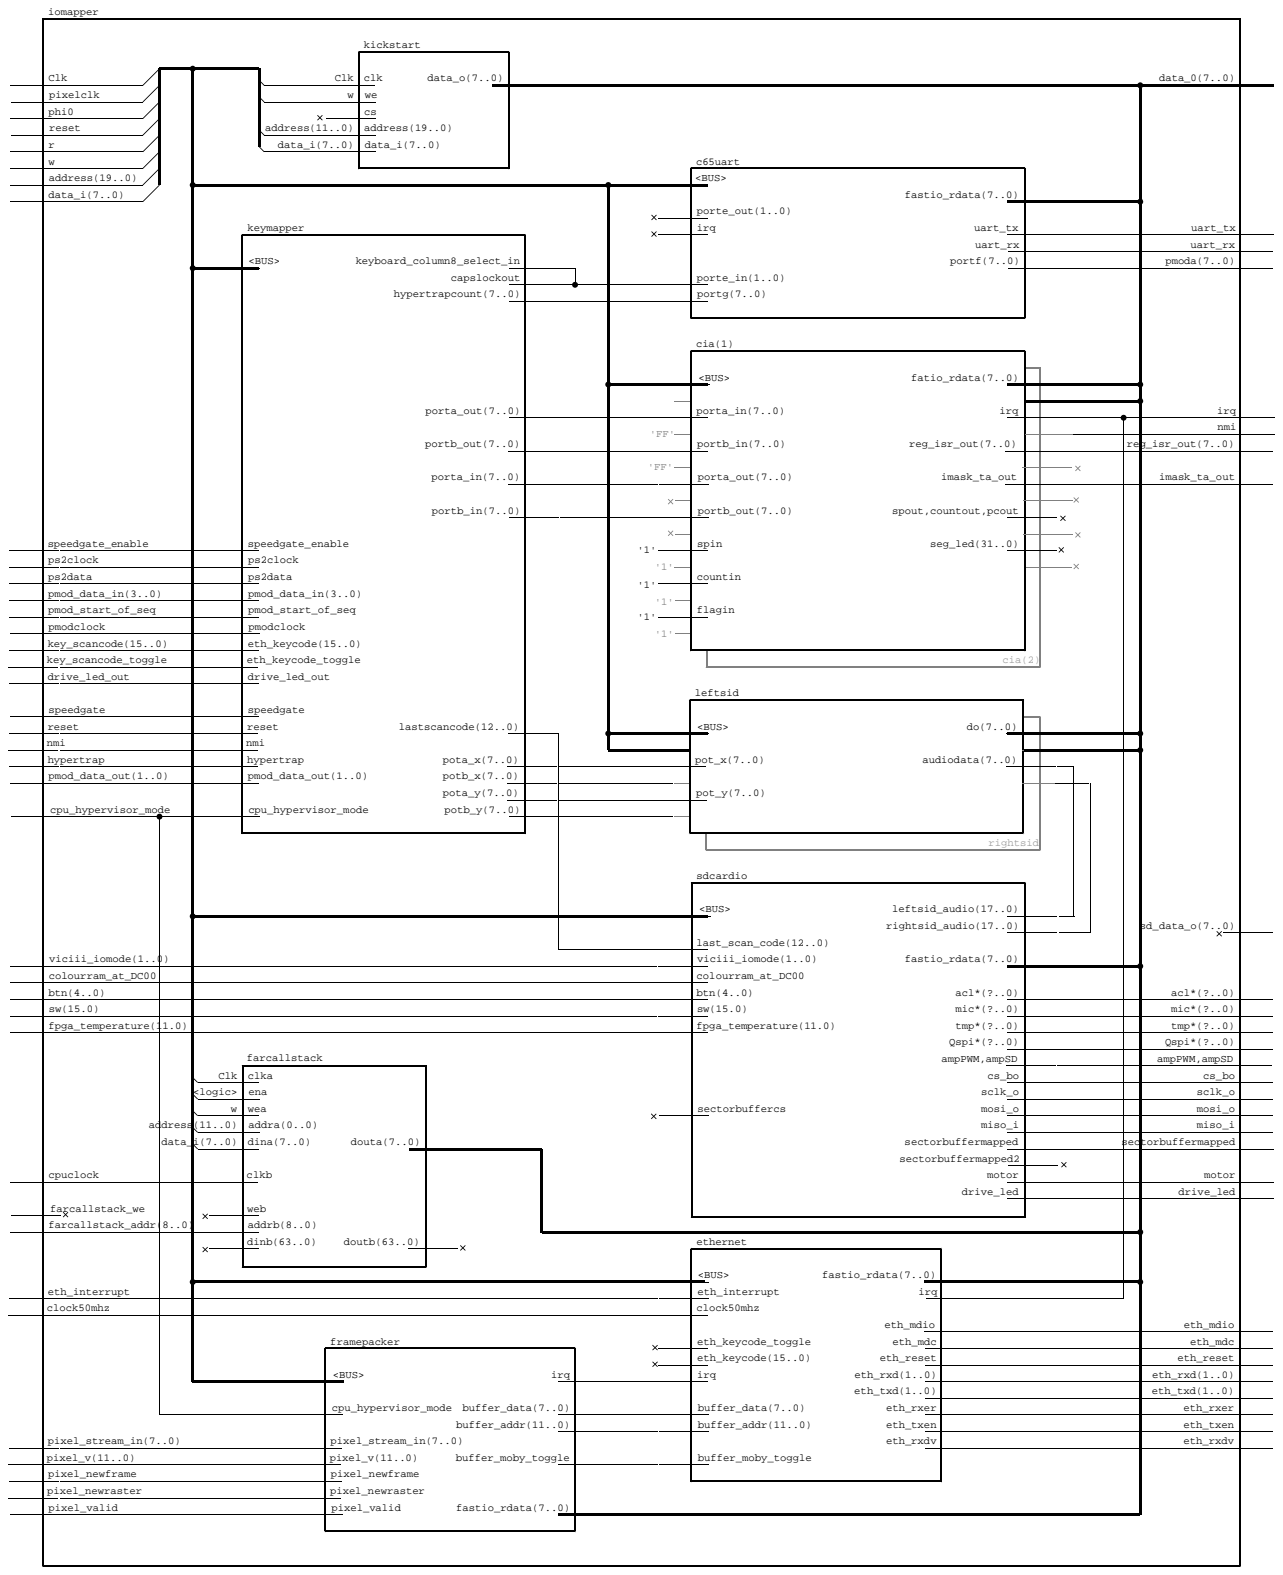
[picture p6: page 1]
sclk_o; mosi_o; miso_i; speedgate_enable; ps2clock; ps2data; pmod_data_in(3..0); pmod_start_of_seq; pmodclock; eth_keycode(15..0); eth_keycode_toggle; drive_led_out; <BUS>; porta_out(7..0); data_0(7..0); acl*(?..0); tmp*(?..0); mic*(?..0); Qspi*(?..0); iomapper; kickstart; c65uart; fastio_rdata(7..0); uart_tx; uart_rx; porte_in(1..0); portg(7..0); cia(1); reg_isr_out(7..0); imask_ta_out; porta_in(7..0); portb_in(7..0); spin; countin; flagin; irq; leftsid; pot_x(7..0); audiodata(7..0)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

spout,countout,pcout
