MEGA65/mega65-core/docs/images/machine.pdf

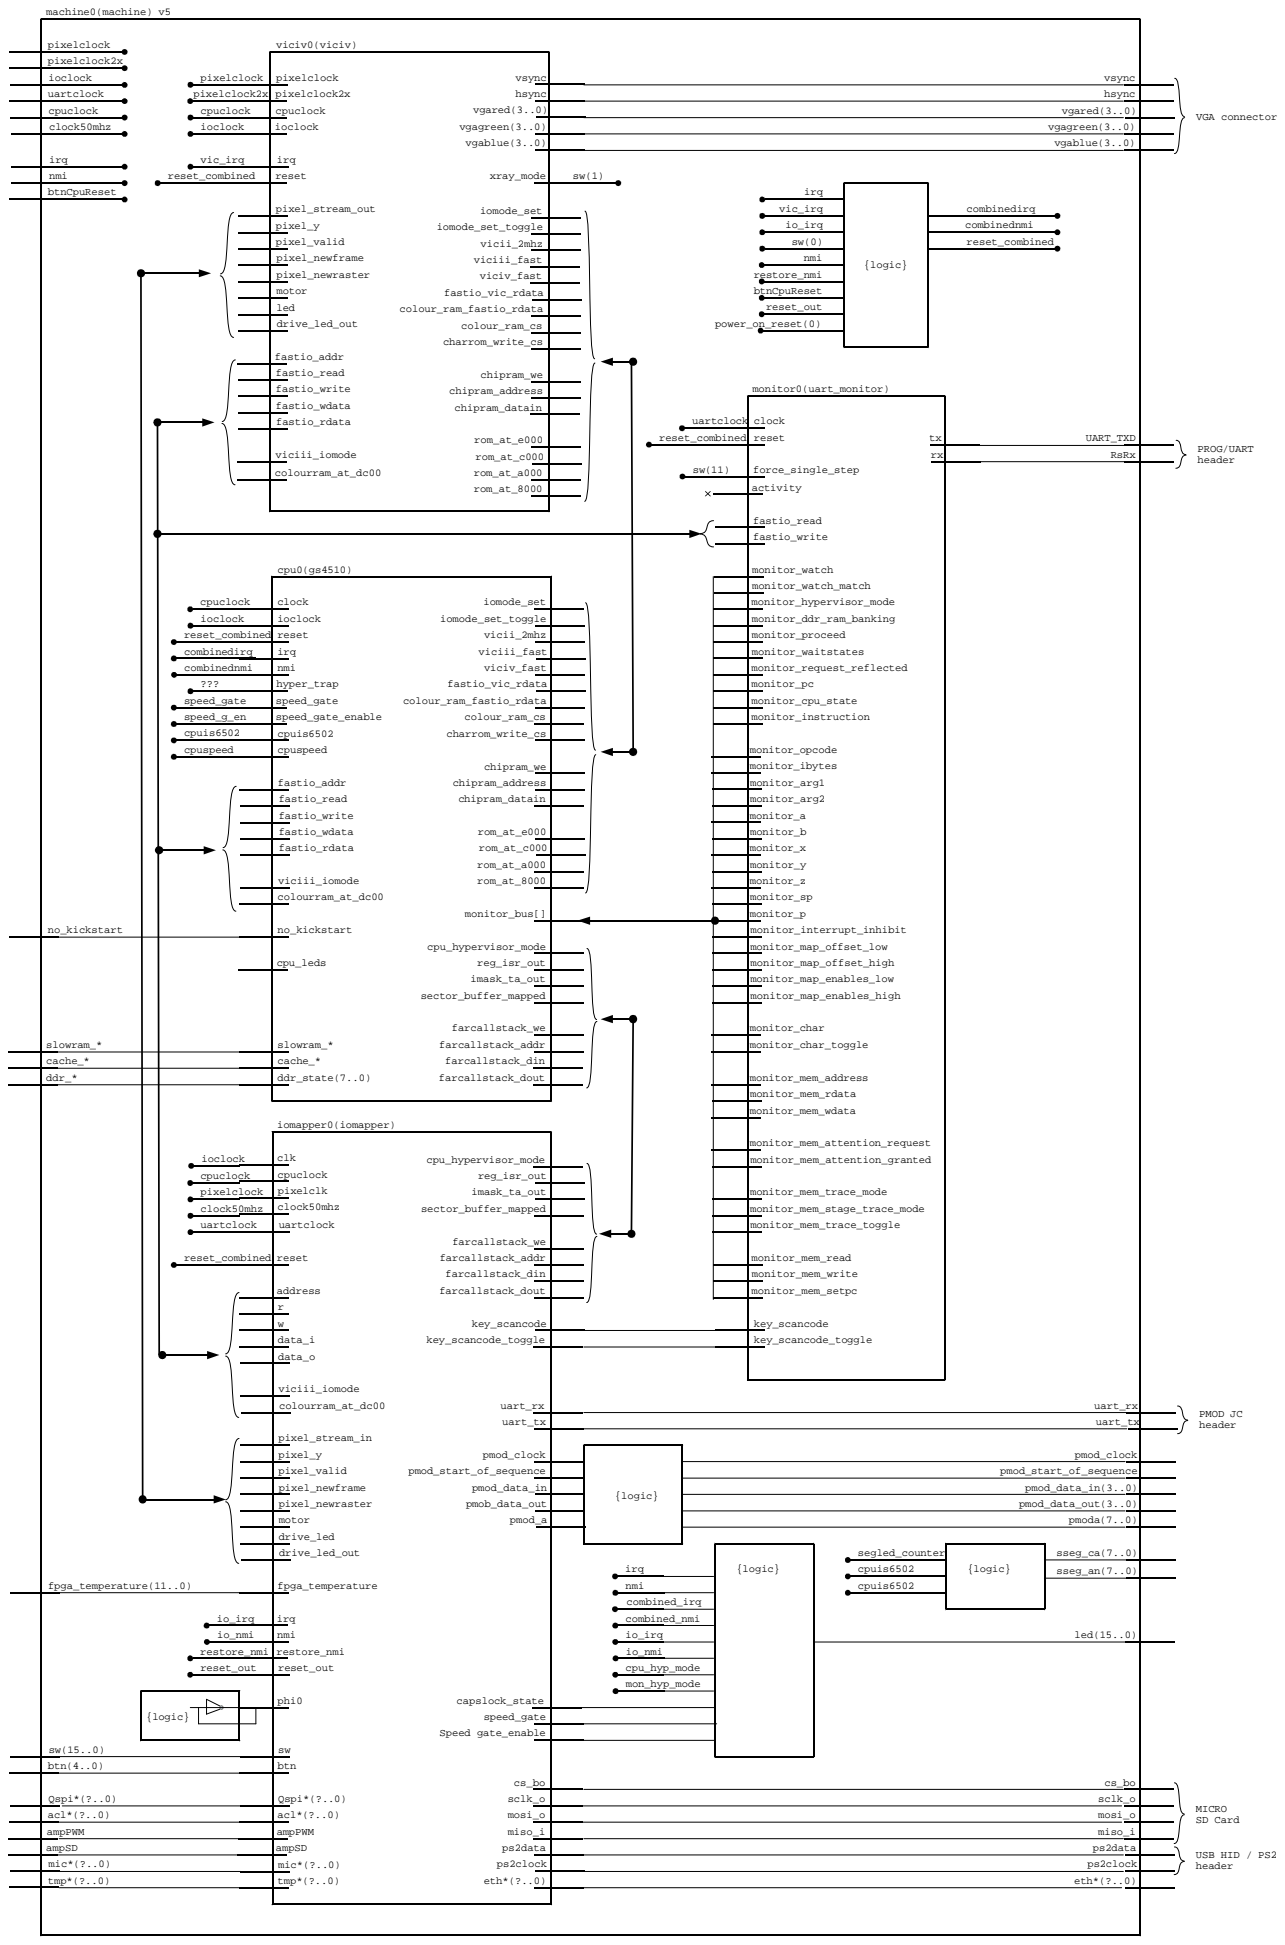
[picture p7: page 1]
pixel_newraster; ddr_*; slowram_*; cache_*; vgared(3..0); vgagreen(3..0); vgablue(3..0); hsync; vsync; UART_TXD; RsRx; sclk_o; mosi_o; miso_i; pixel_stream_out; pixel_y; pixel_valid; pixel_newframe; motor; led; drive_led_out; fastio_addr; fastio_read; fastio_write; fastio_wdata; fastio_rdata; chipram_we; chipram_address; pixelclock; pixelclock2x; cpuclock; iomode_set; rom_at_e000; chipram_datain; vicii_2mhz; viciii_fast; viciv_fast; fastio_vic_rdata; colour_ram_fastio_rdata; colour_ram_cs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
