MEGA65/mega65-core/docs/images/monitor.pdf

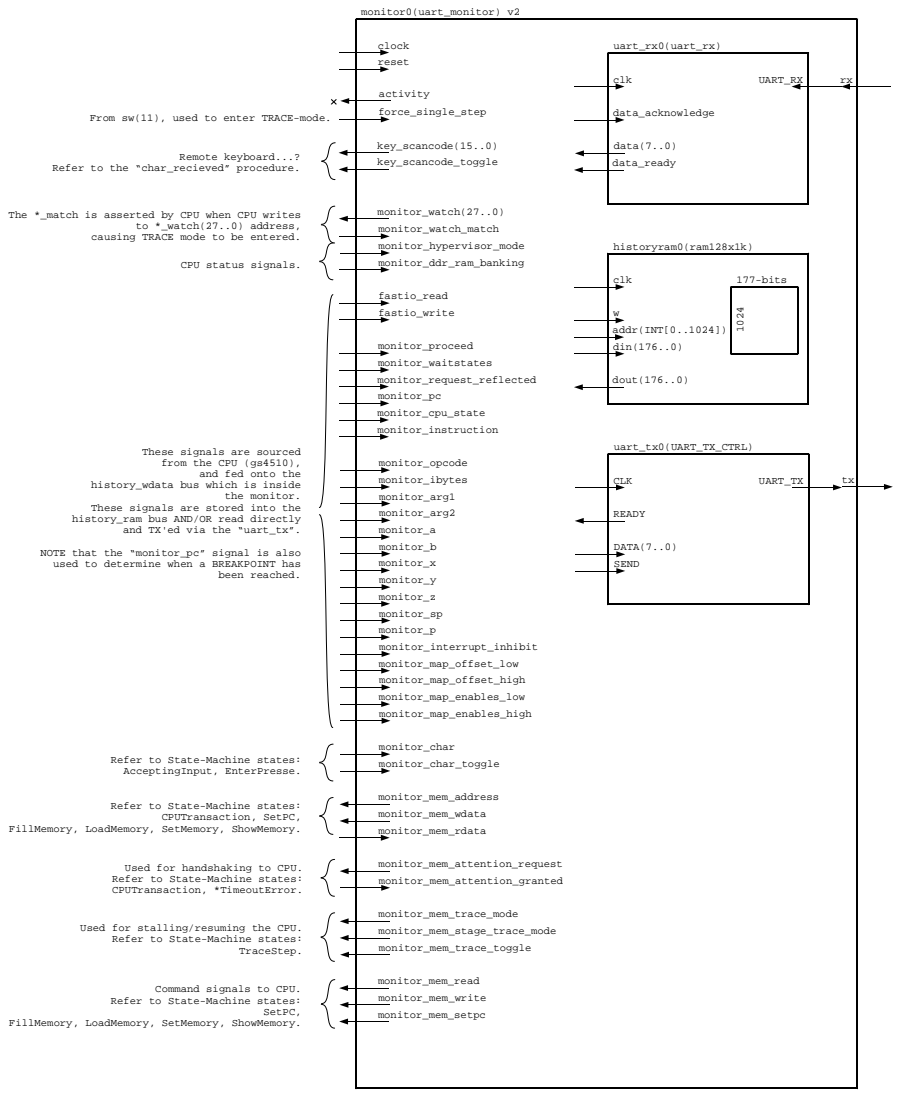
[picture p8: page 1]
fastio_read; fastio_write; key_scancode_toggle; key_scancode(15..0); monitor0(uart_monitor) v2; monitor_char; clock; force_single_step; reset; monitor_char_toggle; monitor_proceed; monitor_waitstates; monitor_request_reflected; monitor_hypervisor_mode; monitor_ddr_ram_banking; monitor_pc; monitor_cpu_state; monitor_instruction; monitor_watch(27..0); monitor_watch_match; monitor_opcode; monitor_ibytes; monitor_arg1; monitor_arg2; monitor_a; monitor_b; monitor_x; monitor_y; monitor_z; monitor_sp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

From sw(11), used to enter TRACE-mode.

Refer to the “char_recieved” procedure.

The *_match is asserted by CPU when CPU writes

causing TRACE mode to be entered.

CPU status signals.

These signals are sourced
from the CPU (gs4510),

and fed onto the

history_wdata bus which is inside

These signals are stored into the
history_ram bus AND/OR read directly

and TX'ed via the “uart_tx”.

NOTE that the “monitor_pc” signal is also
used to determine when a BREAKPOINT has

Refer to State-Machine states:
AcceptingInput, EnterPresse.

FillMemory, LoadMemory, SetMemory, ShowMemory.

Used for handshaking to CPU.
CPUTransaction, *TimeoutError.

Used for stalling/resuming the CPU.

Command signals to CPU.
