MEGA65/mega65-core/docs/images/container.pdf

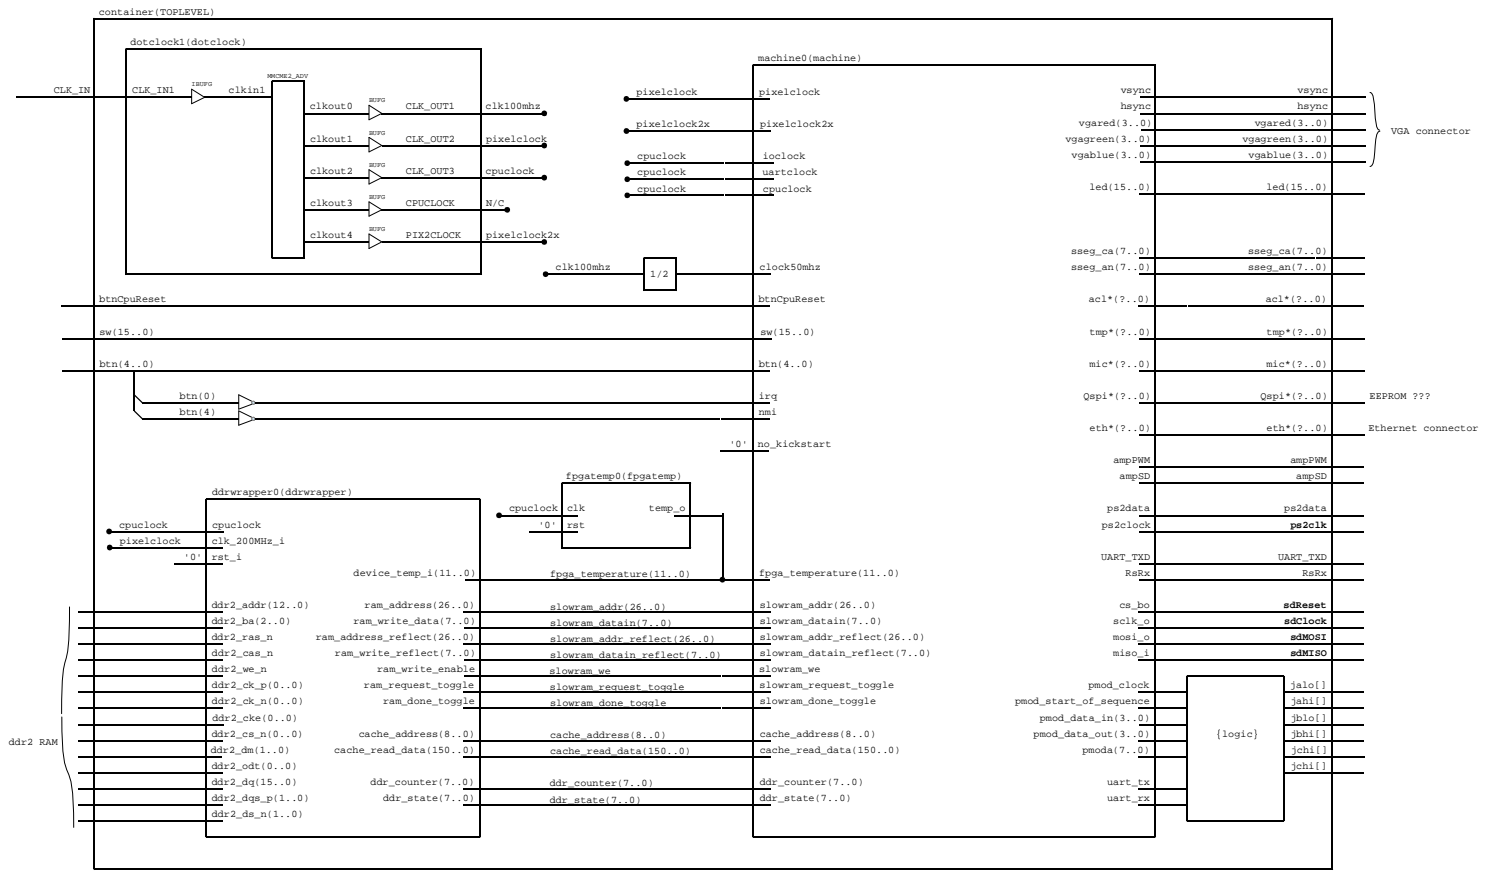
[picture p9: page 1]
ddr_counter(7..0) ddr_state(7..0); slowram_addr_reflect(26..0) slowram_datain_reflect(7..0); slowram_addr(26..0); slowram_we slowram_request_toggle slowram_done_toggle; slowram_datain(7..0); cache_address(8..0) cache_read_data(150..0); vgared(3..0) vgagreen(3..0) vgablue(3..0); hsync; vsync; ampPWM ampSD; ps2data ps2clock; UART_TXD RsRx; cs_bo sclk_o mosi_o miso_i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
