MEGA65/mega65-core/cpu6502.ucf

net "CLK_IN" loc = "E3" | IOSTANDARD "LVCMOS33"; #100MHz clock on Nexys4 board
net "irq" loc = "U8"; #SW1
net "reset" loc = "R7"; #SW2
