MEGA65/mega65-core/(commit log)

2018-10-02 Fix the pixel shift of characters and the locking issue when overflowing the input buffer in matrix mode
    [rain.vhdl]
2018-10-03 try to fix rapid retriggering of C= + TAB key combination on PS/2 keyboards
    [iomapper.vhdl]
2018-10-03 C= + ALT now behaves correctly
    [iomapper.vhdl]
2018-10-03 remove deprecated frame control logic from VIC-IV.
2018-10-03 use the genlock X raster reset instead of following HSYNC for matrix mode display.
    [machine.vhdl, rain.vhdl]
2018-10-04 try to fix matrix mode keyboard input
    [keymapper.vhdl, machine.vhdl]
2018-10-04 fix rotation of characters in matrix mode.
    [rain.vhdl]
2018-10-04 try to fix horizontal stretch at left edge of matrix mode display.
    [machine.vhdl]
2018-10-04 provide native 800 pixel counter for uart monitor to get correct character widths
    [machine.vhdl]
2018-10-04 try to fix glitches in matrix mode display.
    [rain.vhdl]
2018-10-04 fix more problems with matrix mode display
    [rain.vhdl]
2018-10-04 try to fix character rendering bug in matrix mode
    [rain.vhdl]
2018-10-04 try to make regular keyboard input work in uart monitor
2018-10-04 fix typo in Verilog file
    [monitor_ctrl.v]
2018-10-04 fix more junk column pruning problems.
    [rain.vhdl]
2018-10-04 shift matrix display right a little, simplify logic for filtering junk columns
2018-10-04 disable UART input to monitor when matrix mode is enabled.
2018-10-04 attempt to fix colourising of memory dump data.
    [rain.vhdl]
2018-10-04 update monitor_save to use new memory dump format from uart monitor
2018-10-05 add dummy UART RX and TX in verilog for simulation
2018-10-05 fix simulation using verilog uart_monitor and implement many secure mode requirements
    [buffereduart.vhdl, gs4510.vhdl, iomapper.vhdl, machine.vhdl, monitor_ctrl.v, monitor_top.v, sdcardio.vhdl]
2018-10-05 fix problem with disappearing matrix mode
    [rain.vhdl]
2018-10-05 try to fix shift+right/down keyboard scanning race condition
    [matrix_to_ascii.vhdl]
2018-10-05 fix bugs with enter/exit from secure mode activating and closing matrix mode triage.
    [gs4510.vhdl, machine.vhdl]
2018-10-05 fix logic to cancel matrix mode after ACCEPT or REJECT
    [gs4510.vhdl, machine.vhdl, monitor_ctrl.v, monitor_top.v]
2018-10-05 tweak secure mode instruction blinking, fix cancel matrix mode logic
    [monitor_ctrl.v, rain.vhdl]
2018-10-06 try to fig bug in blinking ACCEPT/REJECT instruction banner
    [rain.vhdl]
2018-10-06 try to fix matrix mode cancelling logic
    [gs4510.vhdl, monitor_ctrl.v]
2018-10-06 debug matrix mode clearing problems.
    [gs4510.vhdl]
2018-10-06 fix blinking header of secure mode triage
    [rain.vhdl]
2018-10-06 more fixing secure compartment triage header highlighting
    [rain.vhdl]
2018-10-06 fix rotated keyboard scan columns on real keyboards.
    [mega65r1.xdc]
2018-10-06 fix left and up c65 key mappings on real keyboards
    [keyboard_to_matrix.vhdl]
2018-10-06 restore skip_bytes to normal when OSK is off.
    [rain.vhdl]
2018-10-06 don't double add the extra row when working out skip_bytes
    [rain.vhdl]
2018-10-07 make note of remaining keyboard scanning problems
    [keyboard_to_matrix.vhdl]
2018-10-07 fix ASCII key map error for (
    [matrix_to_ascii.vhdl]
2018-10-07 try to fix keyboard scanning on R1 PCB
    [mega65r1.xdc]
2018-10-07 begin implementing raster buffer to de-jitter pixels on output dotclock
    [machine.vhdl, pixel_driver.vhdl]
2018-10-07 rework pixel_driver to avoid multiple drivers on raddr
    [pixel_driver.vhdl]
2018-10-07 fix testing of pixel driver raster buffer
    [pixel_driver.vhdl]
2018-10-08 more work on raster buffer to de-jitter pixel output
    [pixel_driver.vhdl]
2018-10-09 try to fix pixel driver bug
    [pixel_driver.vhdl]
2018-10-09 try to fix black screen bug from pixel driver
    [pixel_driver.vhdl]
2018-10-09 revert pixel driver clock domain handling back to when it worked, hopefully.
    [pixel_driver.vhdl]
2018-10-13 begin refactoring video pipeline to simplify and correct variable pixel rates
    [machine.vhdl, pixel_driver.vhdl]
2018-10-13 lots more work towards 50/60 switchable pixel driver
2018-10-13 try to debug fifo problems.
    [pixel_driver.vhdl]
2018-10-14 get 50/60hz pixel driver all mostly working.
2018-10-14 try to wait until FIFO has enough in it before reading to fix funny artefacts.
    [pixel_driver.vhdl]
2018-10-14 invert hsync, remove redundant pipeline delay.
    [frame_generator.vhdl]
2018-10-14 various fixes to 50/60hz frame output
    [pixel_driver.vhdl]
2018-10-14 tweak test bench for pixel driver to help track down various bugs
2018-10-14 simplify logic and fix typo
    [pixel_driver.vhdl]
2018-10-14 more simplifying and plumbing VIC-IV video frame logic into new pixel_driver
2018-10-14 more reworking towards new pixel_driver
    [machine.vhdl, rain.vhdl, visual_keyboard.vhdl]
2018-10-14 and more fixing for new pixel_driver
    [machine.vhdl]
2018-10-14 and yet more plumbing fixes. Plumbing now looks complete, if not necessarily correct
    [iomapper.vhdl, machine.vhdl, pixel_driver.vhdl]
2018-10-15 fix chargen scaling
2018-10-15 fix stuck matrix mode with new pixel_driver
    [rain.vhdl]
2018-10-15 fix more scaling and display bugs
    [visual_keyboard.vhdl]
2018-10-15 try to fix visual_keyboard problems
    [visual_keyboard.vhdl]
2018-10-15 make border and chargen line up again
2018-10-15 try to fix visual keyboard display
    [visual_keyboard.vhdl]
2018-10-15 try to fix matrix mode header display with new pixel_driver
    [rain.vhdl]
2018-10-15 fix width of matrix mode characters
    [rain.vhdl]
2018-10-17 fix colour/reverse control code ASCII decoding
    [matrix_to_ascii.vhdl]
2018-10-17 add default palette, and fix reading under simulation
    [ghdl_ram32x1024.vhdl]
2018-10-17 add dummy uart monitor so that simulation can have running CPU again
2018-10-26 don't reset sd_sector when resetting SD card
    [sdcardio.vhdl]
2018-10-26 add extra delay stage to x_zero and y_zero of frame_generator to improve timing closure
2018-10-26 add drive stage to fifo_running signal to improve timing closure
2018-10-28 correct clock names for false paths
    [nexys4ddr.xdc]
2018-10-28 try to hand-modify dotclock100 to provide 120MHz clock for pixel driver
2018-10-28 fix more cross-domain problems
    [pixel_driver.vhdl]
2018-10-28 move reset_counter to 100mhz domain
    [pixel_driver.vhdl]
2018-10-28 pixeltest remaining timing violations due to cross-domain fixed.
    [frame_generator.vhdl, pixel_driver.vhdl]
2018-10-28 update nexys4ddr target for improved pixel driver
2018-10-28 debug video output via leds
2018-10-28 fix pixel toggle bug
    [frame_generator.vhdl]
2018-10-28 ignore timing to/from LEDs and switches
2018-10-28 actually fix pixel togel generation
    [frame_generator.vhdl]
2018-10-28 Fix 50Hz mode pixel driver
    [pixel_driver.vhdl]
2018-10-29 raddr is no longer used.
    [pixel_driver.vhdl]
2018-10-29 rework test pattern and allow enabling from VIC-IV
    [machine.vhdl, pixel_driver.vhdl]
2018-10-29 try to fix vga and lcd output bugs
    [nexys4ddr.vhdl, pixel_driver.vhdl]
2018-10-30 fix some pixel_fifo bugs
    [pixel_driver.vhdl, pixel_fifo.vhdl]
2018-10-30 simplify and fix problems with pixel_driver and new pixel_fifo
    [pixel_driver.vhdl, pixel_fifo.vhdl]
2018-10-31 try to fix false_path list
    [nexys4ddr.xdc]
2018-10-31 add drive stage to c65uart signals that cross clock domain
2018-10-31 switch nybls of alpha blend background colour around to the correct way around
2018-10-31 set xcounter delay on powerup
2018-10-31 increase range of alpha delay, and set correctly for PAL/NTSC modes
    [ghdl_alpha_blend.vhdl]
2018-11-01 begin fetch for next raster line as soon as we are sure it can't catch up with output of current raster line
2018-11-05 try to fix raster buffer of chargen data handling
2018-11-05 try to fix early fetching and rendering of chargen data
2018-11-08 virious fix ups for clock change.
    [frame_generator.vhdl, machine.vhdl, nexys4ddr.vhdl, pixel_driver.vhdl]
2018-11-08 try to improve timing of ethernet video frame buffer
2018-11-11 fix bitrate divisor calculation for serial monitor (out by one error)
    [monitor_ctrl.v]
2018-11-11 begin fixing mega65r1 pcb target for 40MHz CPU and re-factored video clock logic
    [mega65r1.vhdl, nexys4ddr.vhdl]
2018-11-11 more work on mega65r1 target fixing for new video clocking etc
    [mega65r1.vhdl]
2018-11-12 double-buffer chargen raster rendering, so that fetch can begin near beginning of line.
2018-11-12 pre-prime chargen y position to fix double-printing of top pixel of first row of chars.
2018-11-13 disable automatic read of sector on end of reset of SD card
    [sdcardio.vhdl]
2018-11-13 fix lcd pixel clock and rename old 100MHz pixel clock signals to 80MHz
    [frame_generator.vhdl, machine.vhdl, pixel_driver.vhdl]
2018-11-14 go back to default pin power/slew settings
2018-11-14 try to fix raster buffer pixel clock / fifo read/write bugs recently introduced
    [frame_generator.vhdl, machine.vhdl, nexys4ddr.vhdl, pixel_driver.vhdl]
2018-11-14 get rid of old wrong clock40 signal at top level (use 40mhz cpuclock instead)
    [nexys4ddr.vhdl]
2018-11-14 use lcd vsync for both 50 and 60 hz
2018-11-14 fix LCD panel sync polarities and clock drive strengths
    [frame_generator.vhdl, nexys4ddr.xdc, pixel_driver.vhdl]
2018-11-14 fix various LCD panel output problems.
    [frame_generator.vhdl, pixel_driver.vhdl]
2018-11-14 revert LCD height back to correct value
    [frame_generator.vhdl]
2018-11-15 adjust pipeline delay for LCD video placement problems.
    [pixel_driver.vhdl]
2018-11-15 try to fix phase relationship of lcd clock and data
    [nexys4ddr.vhdl]
2018-11-16 try to fix LCD pixel jitter in 60Hz mode
    [nexys4ddr.vhdl]
2018-11-16 revert to inverted 40MHz clock for LCD
    [nexys4ddr.vhdl]
2018-11-18 make separate n4ddr+widget board target
2018-11-18 add missing file for widget board target, and fix upper input lines
    [nexys4ddr-widget.vhdl]
2018-11-18 update nexys4.vhdl to match n4ddr version with changes for 40MHz CPU and fixed pixel clocks
    [nexys4.vhdl]
2018-11-18 try to fix problems with visual keyboard
    [machine.vhdl, visual_keyboard.vhdl]
2018-11-19 make interrupts take 7 cycles
2018-11-19 fix multiple driver by charging for interrupt time in correct place.
    [gs4510.vhdl]
2018-11-19 try to filter out clicks when SID voices turn on rapidly.
2018-11-19 tweak channel on/off filter
2018-11-19 make sure env_counter can't over/under flow
2018-11-20 don't charge 7 cycles for interrupts when at full speed (was breaking full speed operation)
2018-11-20 fix and rationalise utility menu short-cut key checks
2018-11-21 try to follow existing file chain when writing
2018-11-21 fix following existing cluster chain of file
2018-11-22 fix double-increment of F011 sector buffer offset when writing.
    [sdcardio.vhdl]
2018-11-22 fix advancing of F011 sector buffer during writing
    [sdcardio.vhdl]
2018-11-23 begin working on highspeed CPU tracer over ethernet
2018-11-24 make sure there are no brackets in git version string to mess up jenkins
2018-11-24 put renamed file into the correct directory
    [asym_ram.vhdl]
2018-11-25 fix more removal of brackets from git version string
2018-11-26 improve output. fix instruction address jitter based on opcode
2018-11-26 fix more PC jitter based on opcodes
2018-11-29 set default compare raster for raster interrupts to a real raster line.
2018-11-29 try to get raster interrupts on raster $137 working again.
2018-11-29 allow raster interrupts to properly trigger during vertical flyback
2018-11-30 move vsync back in the correct direction
    [pixel_driver.vhdl]
2018-11-30 begin working on raster interrupt-based D018 timing tests
2018-12-01 delay screen_ram_base address by one raster line to match VIC-II
    [vicii.cfg]
2018-12-01 simplify out-of-frame blanking of VGA signal.
2018-12-01 try to fix badline / phi_pause interaction problems
    [gs4510.vhdl]
2018-12-01 try to fix processor instability at 1mhz (presumably when paused)
    [gs4510.vhdl]
2018-12-02 more work trying to fix cpu mis-behaviour when CPU is at 1mhz
    [gs4510.vhdl]
2018-12-04 implement -F single frame display
2018-12-13 add p and n commands to switch between pal and ntsc video modes
2018-12-13 switch to C64 video mode when switching to c64 memory map
2018-12-15 fix logging of VIC-IV badline and raster advances
    [ethernet.vhdl]
2018-12-15 add missing CPU pause logic for raster/badline reporting over ethernet
    [ethernet.vhdl]
2018-12-15 add missing logic to flap raster_toggle
    [ethernet.vhdl]
2018-12-19 work around CPU glitching in uart monitor. begin implementing loading in C65 mode
2018-12-19 make badline and 6502 interrupt cycle stealing run-time selectable
2018-12-20 fix jitter in NTSC matrix mode
2018-12-22 allow adjusting $D011 smooth scrolling mid-frame
2018-12-22 fix chargen start / badline raster number calculation
2018-12-24 apply Kenneth's fix to CPU glitching when poked by monitor interface
    [gs4510.vhdl]
2018-12-24 synthesise 30MHz LCD pixel clock using clock240 and BUFG. fix synthesis errors
    [nexys4.vhdl, nexys4ddr.vhdl]
2018-12-24 fix type of userport_in and _out signals
    [iomapper.vhdl]
2018-12-24 update clock definitions in MEGA65r1 PCB target to catch up with clocking changes
2018-12-27 run multiple tests per frame if the CPU is fast enough to do it.
2018-12-27 work towards reducing jitter.
2018-12-28 drive /RESET low when detecting a MEGA65 extra joystick pseudo-cartridge to supply the GND for the joysticks.
    [expansion_port_controller.vhdl]
2018-12-29 improve horse sprite frames
2018-12-31 pull in updated MEGA65 fdisk that creates larger freeze slots
2019-01-01 get unfreeze to cycle through all the sectors (but not actually DMA into place or post-fix each region)
2019-01-01 don't advance DMA destination until after reading sector
2019-01-01 add note that we need to post-fix mounted D81 image
2019-01-01 actually write contents of slot to file in download_slot()
2019-01-02 fix various bugs with downloading freeze slots
2019-01-02 add missing read waitstate to palette RAMs
    [gs4510.vhdl]
2019-01-03 try to solve palette RAM reading waitstate problem
    [gs4510.vhdl]
2019-01-03 Always M65 IO mode while in the hypervisor (partly so we can DMA over video registers during un-freeze)
2019-01-03 de-ambiguate function names in freeze routine
2019-01-03 display first sector of slot in getslot command
2019-01-03 reduce palette read wait states to correct value
    [gs4510.vhdl]
2019-01-04 use 4mbit/sec and de-duplicate read requests to speed up virtual D81 access
2019-01-07 make JMP/JSR ($nnnn) / ($nnnn,X) not have 8-bit wrap-around bug when in 4510 mode
    [gs4510.vhdl]
2019-01-08 de-duplicate ASCII key press events
2019-01-11 fix bugs in VNC via ethernet. Some problems remain with right border
    [vncserver.c]
2019-01-11 fix auto-doc of CIA registers into iomap.txt
    [cia6526.vhdl]
2019-01-11 try to fix CIA problems on boot
    [cia6526.vhdl]
2019-01-12 fix CS line generation for thumbnail generator.
    [iomapper.vhdl]
2019-01-12 try to fix thumbnail generation bug
    [framepacker.vhdl]
2019-01-12 fix multiple simultaneous CS assertion between c65uart and thumbnail generator
    [iomapper.vhdl]
2019-01-12 sample first pixel on line for thumbnail, to make sure we get 80 samples per row
2019-01-13 implement de-packer for RLE packer
2019-01-14 work around thumbnail generator address conflict problem
    [framepacker.vhdl, iomapper.vhdl]
2019-01-14 pllumb missing last_hypervisor_mode signal in framepacker to suppress thumbnail updating while in hypervisor mode
    [framepacker.vhdl]
2019-01-15 fix calculation of freeze slot address and add trap to get number of slots
2019-01-16 add audiomixer bypass to test SID audio problems
    [audio_complex.vhdl, iomapper.vhdl]
2019-01-20 extend IO settle delay to avoid keyboard problems at 40MHz
    [gs4510.vhdl]
2019-01-20 try to fix CPU glitching when writing to $D02F at 40MHz on ethernet instruction log packet boundries
    [gs4510.vhdl]
2019-02-08 fix some bugs in reading from I2C bus
2019-02-08 now seem to be able to read I2C registers
2019-02-09 implement writing to I2C registers
2019-02-15 fix binding for dummy signals for portg
    [iomapper.vhdl]
2019-02-15 fix some syntax errors. now runs in GHDL
    [vfpga_clock_controller_pausable.vhdl]
2019-02-20 fix keyboard scanning default mode
    [iomapper.vhdl]
2019-02-20 add drive stage to math config register to improve timing closure
2019-02-20 add false path for framepacker moby toggle to improve timing closure
2019-02-20 enforce CS lines to prevent bus stomping
    [sdcardio.vhdl]
2019-02-20 fix problems with vfpga register memory mapping
    [gs4510.vhdl, iomapper.vhdl]
2019-02-20 fix CS logic for sd card controller
    [sdcardio.vhdl]
2019-02-21 work on fixing memory mapping of sector buffer bugs
    [ghdl_ram8x4096_sync.vhdl, sdcardio.vhdl]
2019-02-21 fix memory mapping of vfpga and SD card
    [sdcardio.vhdl]
2019-02-22 switch to 8-bit oriented overlay IP supplied by theotim
2019-02-25 remove SDSC card support. fix freeze slot size calculation
2019-02-25 fix calculation of freeze slot addresses
2019-02-25 update freeze menu to having working saving/loading from other slots
2019-02-28 reset bitplane data fetch etc at right border edge instead of left of display to ensure enough time for bitplane 7
    [bitplanes.vhdl]
2019-02-28 fix bounds check for GHDL simulation
    [framepacker.vhdl]
2019-02-28 add extra debug to help track down bitplane problems
    [bitplane.vhdl, bitplanes.vhdl]
2019-02-28 revert some allegedly only syntactical differences in XDC file
    [mega65r1.xdc]
2019-03-01 auto-detect zwischen erste und zweite SD Karten
2019-03-01 try to solve instability when allowing SD card switching
2019-03-01 more fixes for SD card selection logic
    [iomapper.vhdl]
2019-03-01 give SIDs 2MHz clock instead of 1MHz clock to fix out-by-octave problem
    [iomapper.vhdl, machine.vhdl]
2019-03-09 Try fix of bitplanes first line card position.
    [bitplanes.vhdl]
2019-03-09 Further try fixing bitplanes y start
    [bitplanes.vhdl]
2019-03-09 reset buffer at beginning of scan line.
    [bitplanes.vhdl]
2019-03-09 Revert vertical adjustment for bitplanes
    [bitplanes.vhdl]
2019-03-10 Trying to fix horizontal lines.
    [bitplanes.vhdl]
2019-03-10 Further bitplane fix experiments.
    [bitplanes.vhdl]
2019-03-10 Set bitplane fetch offset at the end of the last line, restart bitplane read buffer the beginning of the current line.
2019-03-10 Fixing right end of the bitplanes.
    [bitplanes.vhdl]
2019-03-10 Fix that only one pixel is skiped in column 0.
    [bitplanes.vhdl]
2019-03-10 More bitplane fixes: - revert proper bitplane width - try some change what is odd and what is even
    [bitplanes.vhdl]
2019-03-11 try to fix single-write after multi-write SD card bug
    [sdcardio.vhdl]
2019-03-11 add clusters command to show cluster chains
2019-03-17 fix overflow errors for simulation
    [dpram8x4096.vhdl]
2019-03-17 add missing file for internal 1541
    [internal1541.vhdl]
2019-03-17 fix bounds error problems with internal 1541 RAM
    [dpram8x4096.vhdl]
2019-03-17 fix synthesis with initial internal 1541 work
    [internal1541.vhdl]
2019-03-17 add missing chipselect signal for M65 side of internal 1541 ROM
    [driverom.vhdl, internal1541.vhdl]
2019-03-17 fix more multiple driver problems / dpram failing to tristate
    [dpram8x4096.vhdl]
2019-03-18 move 1541 ROM/RAM shared memory areas to avoid address conflict with colour RAM
    [iomapper.vhdl]
2019-03-21 update iomap.txt and correct labelling of $D60D register bits
    [c65uart.vhdl]
2019-03-24 update DMA register descriptions for user guide
2019-03-24 fix some register description comments for user's guide
    [gs4510.vhdl]
2019-03-24 more userguide comment fixes
    [gs4510.vhdl]
2019-03-29 work towards bringing up MEGAphone PCB
2019-03-29 fix pin assignments for VGA. Fix VGA frame timing for 60Hz 800x600
    [te0725.xdc]
2019-03-29 plumb in UART serial port and SD card interfaces
2019-03-29 now synthesises on TE0725 for MEGAphone r1 PCB (but with only VGA and serial UART working)
2019-03-30 work on providing correct cycle strobe to internal 1541 based on CPU speed
    [c65uart.vhdl, driverom.vhdl, internal1541.vhdl, iomapper.vhdl, machine.vhdl]
2019-03-30 fix multiple drivers of data read into 1541 CPU
    [internal1541.vhdl]
2019-03-30 add missing signals for previous commit
    [internal1541.vhdl]
2019-03-31 try inverting IRQ and NMI sense for internal 1541
    [6502_timing.v, 6502_top.v, internal1541.vhdl]
2019-04-01 try to correct pin assignments for SD card interface on MEGAphone
    [te0725.xdc]
2019-04-01 try to fix VIC-III DAT when V400 + INT bits are set
    [gs4510.vhdl, machine.vhdl]
2019-04-01 fix stupid bit picking error in previous commit.
    [gs4510.vhdl]
2019-04-01 fix comment about interlace mode with DAT
    [gs4510.vhdl]
2019-04-01 flip pins for SD card interface for MEGAphone to try to fix it.
    [te0725.xdc]
2019-04-02 begin adding pin prober for MEGAphone PCB
2019-04-02 plumb all yet-to-be-allocated pins on the TE0725 board to pin prober interface
2019-04-02 fix incorrect type for fpga pin array
2019-04-02 correct IO voltage for dummy pins, begin adding pins for 8MB Hyper RAM.
    [te0725.xdc]
2019-04-02 fix dummy pins for pinprober to fix io placer problems
    [pinprober.vhdl, te0725.xdc]
2019-04-02 fix pin probe array width
2019-04-02 try to fix dummy pins
    [te0725.xdc]
2019-04-02 resolve multiple drivers in hyperram
    [hyperram.vhdl]
2019-04-02 try to fix synthesis of pinprober with missing pins
    [te0725.xdc]
2019-04-02 add timeout to HyperRAM reads to avoid bus deadlock if no response
    [hyperram.vhdl]
2019-04-08 try to fix sd card pinout
    [te0725.xdc]
2019-04-09 mask out upper address bits when talking to each hyperram die
2019-04-15 fix compilation of nexys4ddr-widget target
    [nexys4ddr-widget.vhdl]
2019-04-16 add missing expansion ram signl for targets without HyperRAM
    [mega65r1.vhdl, nexys4.vhdl, nexys4ddr.vhdl]
2019-04-23 make pin prober work on any slow address to simplify things.
2019-04-24 plumb I2C bus #1 to JD/JC spare pins on PMOD connectors
2019-04-27 rename KICKSTART to HYPPO/HYPPOBOOT to avoid any risk of trademark claims against the project
    [gs4510.vhdl, iomapper.vhdl, machine.vhdl, mega65r1.vhdl, megaphoner1.vhdl, nexys4.vhdl, nexys4ddr-widget.vhdl, nexys4ddr.vhdl]
2019-04-29 fix missing pin
2019-04-30 map I2C bus 1 on MegaPhone r1 target. Strip out pin prober as no longer required.
    [megaphoner1.vhdl, megaphoner1.xdc]
2019-04-30 swap I2C bus 1 SDA and SCL. Plumb modem1 lines.
    [megaphoner1.vhdl, megaphoner1.xdc]
2019-05-01 improve I2C bus scanning test utility.
2019-05-01 add comment for swap line on I2C busses
    [sdcardio.vhdl]
2019-05-07 begin implementing C program to scan I2C busses
2019-05-07 get the i2clist program minimally running.
2019-05-08 implement display of first 16 registers of detected IO devices
2019-05-08 improve i2clist debug program output.
2019-05-08 begin implementing controller for i2c peripherals on the MEGAphone
2019-05-08 fix memory mapping address
    [iomapper.vhdl]
2019-05-08 fix various errors in i2c_wrapper integration
    [i2c_wrapper.vhdl, iomapper.vhdl]
2019-05-08 add debug output to I2C peripherals memory map area
2019-05-08 fix i2c peripheral CS line generation
    [iomapper.vhdl]
2019-05-08 fix several auto-documentation comments in VHDL
    [iomapper.vhdl]
2019-05-08 debug and fix problems with reading from I2C peripherals memory mapped registers.
    [i2c_wrapper.vhdl, iomapper.vhdl]
2019-05-08 fix synthesis and add note to simulation/synthesis problem.
    [gs4510.vhdl]
2019-05-09 fix initial state of last_busy to allow i2c peripheral scan to start on reset
    [i2c_wrapper.vhdl]
2019-05-09 read more I2C peripherals
2019-05-09 try to fix i2c peripheral scanning to stop it getting stuck after one iteration.
    [i2c_wrapper.vhdl]
2019-05-09 read more registers from I2C devices
2019-05-09 read registers of more I2C devices
2019-05-09 fix read_register() to actually select the register to read from.
    [i2clist.c]
2019-05-09 begin implementing writing to I2C registers
2019-05-09 try implementing writing to I2C registers in i2clist.
2019-05-09 try to fix reading I2C peripherals
    [i2c_wrapper.vhdl]
2019-05-09 begin implementing utility to display I2C device status
2019-05-09 Updated I2C status program
2019-05-09 use correct address for displaying RTC time of day.
    [i2cstatus.c]
2019-05-09 auto-generate state list for I2C peripheral scanning. Handle each IO expander register pair separately.
2019-05-09 fix problems with i2c device mapping and auto-generation
    [i2c_wrapper.vhdl]
2019-05-09 fix enabling auto-increment of register numbers for accelerometer.
    [i2c_wrapper.vhdl]
2019-05-09 try to fix reading and writing registers of various I2C peripherals.
    [i2c_wrapper.vhdl]
2019-05-09 try to fix I2C peripheral scanning bug for IO expanders.
    [i2c_wrapper.vhdl]
2019-05-10 try to fix reading of IO expander registers
    [i2c_wrapper.vhdl]
2019-05-10 enable and show ADC and accelerometer status.
2019-05-10 determine whether the IO expander read problems are I2C errors, or actual wrong data.
    [i2c_wrapper.vhdl]
2019-05-10 fix i2c addresses for IO expanders (had decimal as hex. face slap.)
    [i2c_wrapper.vhdl]
2019-05-10 fix bug when writing to I2C IO expander #0
    [i2c_wrapper.vhdl]
2019-05-10 tweak I2C timing
2019-05-10 try again to fix writing to first IO expander register
    [i2c_wrapper.vhdl]
2019-05-10 fix setting up I2C device register. show button status
    [i2cstatus.c]
2019-05-10 try to fix writing to first i2c io expanderr.
    [i2c_wrapper.vhdl]
2019-05-10 swap IO expander 0 and 2, so that we can avoid the I2C writing bug.
    [i2c_wrapper.vhdl, i2cstatus.c]
2019-05-11 plumb joypad and buttons on MEGAphone. Implement joyswap and OSK toggle key functions.
2019-05-11 try to fix display of OSK
    [c65uart.vhdl, frame_generator.vhdl, machine.vhdl, visual_keyboard.vhdl]
2019-05-11 fix multiple driver problem
    [c65uart.vhdl]
2019-05-11 try to fix OSK pixel counting logic, to get OSK to display again.
    [frame_generator.vhdl, machine.vhdl, pixel_driver.vhdl, visual_keyboard.vhdl]
2019-05-12 use VGA frame signal, not LCD one in VIC-IV
2019-05-12 fix start of frame detection in VIC-IV when using pixel_driver as frame generator
2019-05-12 fix more problems with frame signal handling with pixel_driver and OSK.
2019-05-12 fix reseting of xcounter in OSK
    [visual_keyboard.vhdl]
2019-05-12 fix megaphoner1 target building.
    [megaphoner1.vhdl]
2019-05-12 enable some debugging which confirms OSK is being painted. so why doesn't it appear?
    [visual_keyboard.vhdl]
2019-05-13 de-glitch i2c IO expander inputs on buttons
    [i2c_wrapper.vhdl]
2019-05-13 make glitch rejection on IO expanders even stronger.
    [i2c_wrapper.vhdl]
2019-05-13 begin debugging the power control IO expander
2019-05-13 try to fix lcd_display_enable signal to OSK.
    [pixel_driver.vhdl, visual_keyboard.vhdl]
2019-05-14 more work debugging I2C IO expander input glitching
    [i2c_wrapper.vhdl, i2cstatus.c]
2019-05-14 fix plumbing for MEMS microphones
    [megaphoner1.vhdl]
2019-05-14 more work on OSK fixing.
    [frame_generator.vhdl, visual_keyboard.vhdl]
2019-05-15 try to fix glitching on joypad and button inputs of I2C IO expanders.
    [i2c_wrapper.vhdl]
2019-05-15 correct MEMS microphone pins.
    [megaphoner1.xdc]
2019-05-15 work on debugging FPGA pin assignments
2019-05-15 fix various problems with OSK display
    [visual_keyboard.vhdl]
2019-05-15 make pin IDs easier to decode on the oscilloscope
2019-05-15 fix pin_id indicating pin number
    [pin_id.vhdl]
2019-05-15 de-bounce black buttons for RESTORE and OSK toggle.
2019-05-15 rework end of line truncation in OSK display.
    [visual_keyboard.vhdl]
2019-05-15 fix OSK panning upwards
    [visual_keyboard.vhdl]
2019-05-15 fix many bugs in visual keyboard and simplify.
    [c65uart.vhdl, iomapper.vhdl, machine.vhdl, visual_keyboard.vhdl]
2019-05-16 attempt to fix display of OSK when it ends at pixel >= 799
    [visual_keyboard.vhdl]
2019-05-16 try to fix remaining display glitches for horizontally centred OSK
    [visual_keyboard.vhdl]
2019-05-16 fix smooth panning up for OSK
    [visual_keyboard.vhdl]
2019-05-16 try to fix debounce/glitching on OSK toggle button
    [c65uart.vhdl]
2019-05-16 work on debugging I2C glitches
    [i2cstatus.c]
2019-05-16 correct pin assignment for micdata0
    [megaphoner1.xdc]
2019-05-16 delay sample point for MEMS microphones to try to fix noise.
    [audio_complex.vhdl]
2019-05-16 fix clock30 generation code
    [megaphoner1.vhdl]
2019-05-16 fix another synthesis error
    [megaphoner1.vhdl]
2019-05-16 fix pin assignments for PWM audio output
    [megaphoner1.xdc]
2019-05-16 try to fix headphone out pin assignments
    [megaphoner1.xdc]
2019-05-16 tcl doesn't allow # comments at ends of lines
    [megaphoner1.xdc]
2019-05-16 fix pin conflicts for MEGAphone r1
    [megaphoner1.vhdl, megaphoner1.xdc]
2019-05-17 fix more pin assignments for megaphone
    [megaphoner1.vhdl, megaphoner1.xdc]
2019-05-17 fix even more pin assignments
    [megaphoner1.xdc]
2019-05-17 simplify pin-prober for TE0725 board, and make indicate all 84 GPIOs without exception
2019-05-17 fix indication of remaining pins
    [te0725.xdc]
2019-05-17 plumb modem slots 1 and 2
2019-05-17 add code to initialise I2C registers on boot.
2019-05-17 fix initialisation of I2C peripherals
2019-05-17 pull up I2C bus for touch screen interface
2019-05-18 try lower I2C bus speed to fix glitching on IO expander
    [i2c_master.vhdl, i2c_wrapper.vhdl]
2019-05-20 try to improve signal integrity of the LCD pixel clock with fast slew and 24mA drive
2019-05-20 add target for testing pin slew rates
2019-05-21 try swapping touch SDA/SCL
    [megaphoner1.xdc]
2019-05-21 restore regular LCD height to fix letter boxing.
    [frame_generator.vhdl]
2019-05-21 revert touch SDA/SCL pin assignments.
    [megaphoner1.xdc]
2019-05-21 plumb LCD PWM to spare FPGA pin.
2019-05-21 add missing signal for lcd_pwm
    [megaphoner1.vhdl]
2019-05-21 fix lcd_pwm to be output only signal
    [machine.vhdl, sdcardio.vhdl]
2019-05-21 more fixing LCD_PWM to be output only
    [iomapper.vhdl]
2019-05-21 fix auto-detection of MEGAphone I2C peripherals during reset.
2019-05-23 work around temporary fix for screen brightness control by leaving IO expander pin set to input.
2019-05-23 increase frequency of LCD brightness PWM signal.
2019-05-23 temporarily connect touch digitiser I2C to debug I2C port.
2019-05-23 remove pull-ups on touch I2C interface, now that we have external pull-ups
2019-05-23 reconnect touch panel I2C lines
2019-05-24 try to debug PWM brightness control for LCD panel.
2019-05-24 fix names of i2c peripheral interface bus lines
    [megaphoner1.xdc]
2019-05-24 try to fix i2c_perif_* signals by adding default value for inout lines.
    [megaphoner1.vhdl]
2019-05-24 more trying to fix i2c perif lines
    [machine.vhdl]
2019-05-24 add extra test target for debugging XDC pin constraints.
2019-05-25 increase LCD panel PWM frequency to hundreds of KHz to try to avoid audible acoustic artefacts.
    [sdcardio.vhdl]
2019-05-25 try to make I2C initialisation more robust.
2019-05-25 go back to 1KHz PWM for LCD panel, and think about how we can fix the acoustic noise on the PWM switching
    [sdcardio.vhdl]
2019-06-03 fix power on problem for megaphone LCD
2019-06-03 give hypervisor time for I2C to get organised before initialising. speed up I2C bus to help.
2019-06-03 try to fix touch interface recovery from error condition (e.g., when touch interface has been powered off, and then back on again)
2019-06-05 fix touch screen calibration values on boot.
    [sdcardio.vhdl]
2019-06-05 fix register number offset when writing to amplifier registers.
    [i2c_wrapper.vhdl]
2019-06-05 get pin ready for power control.
2019-06-07 enable writing to I2C io expander that hosts the buttons.
2019-06-08 try to fix headphone and speaker plumbing problems
    [audio_complex.vhdl, iomapper.vhdl, machine.vhdl]
2019-06-09 test i2s speaker output bug: check if problem was zero samples.
    [audio_complex.vhdl]
2019-06-09 fix sync edge detection in i2s_transceiver
    [audio_complex.vhdl, i2s_transceiver.vhdl]
2019-06-09 route I2S bit clock to MCLK pin of ssm2518
2019-06-09 tie i2s_bclk high to set 16 cycles per sample
2019-06-09 begin implementing simple SSM2518 audio driver for debugging.
2019-06-10 fix typo in signal name
    [megaphoner1.vhdl]
2019-06-10 blink LED in time with attempted tone
2019-06-10 use 64 BCLK cycles per sample when generating i2s clock
2019-06-10 fix scaling of samples
2019-06-10 fix generation of i2s clock with 64 ticks per sample.
    [i2s_clock.vhdl]
2019-06-10 try single bit sample rotating through each bit position to test SSM2518 output
2019-06-10 reconnect actual SDATA to pin
2019-06-11 try to fix problems with reading I2C inputs.
    [i2c_wrapper.vhdl]
2019-06-11 more work on trying to filter incorrect value reads from I2C IO expanders
2019-06-12 set I2C speaker driver registers sensibly on boot
2019-06-12 reduce default volume to safe level with faulty powersupplies
2019-06-15 begin implementing target for MEGA65 r2 pcb
2019-06-15 more work on updating pins for r2 PCB
2019-06-15 finish updating pin definitions in XDC file.
2019-06-15 fix FPGA part for mega65r2 pcb
2019-06-15 fix some pin assignments and remove unconnected interfaces for MEGA65 R2 target
    [mega65r2.vhdl, mega65r2.xdc]
2019-06-15 add dummy signals for keyboard on m65 r2 pcb for now.
2019-06-15 fix another incorrect pin
    [mega65r2.xdc]
2019-06-15 fix stereo output pin assignment
    [mega65r2.xdc]
2019-06-15 fix typo in xdc file
    [mega65r2.xdc]
2019-06-15 fix incorrectly assigned pins
    [mega65r2.xdc]
2019-06-17 remove RESET via RESTORE since freezemenu can do reset, and it avoids accidentally reseting instead of getting freeze menu
    [keymapper.vhdl]
2019-06-17 try to fix rule for making .bit files for case with and without pregenerated monitor_mem.v
2019-06-17 fix updating RESTORE key to only do freeze or restore
    [keymapper.vhdl]
2019-06-20 adjust i2cstatus test program
2019-06-20 adjust pin probe test target
2019-06-22 begin implementing simple test target for M65R2 PCB debugging
2019-06-25 fix pin assignments for serial console on MEGA65 R2 target
    [mega65r2.xdc]
2019-06-25 elevate widget board interface to outside of design, so that we can easily swap in MEGA65R2 keyboard interface
    [iomapper.vhdl, keyboard_complex.vhdl, machine.vhdl, nexys4ddr-widget.vhdl]
2019-06-25 tweak M65R2 PCB test program
2019-06-27 pull new keyboard controller into test framework and begin debugging.
2019-06-27 track down and fix incorrect pin assignments for keyboard GPIOs
    [mega65r2.xdc, testr2.xdc]
2019-06-27 fix phase loop logic for m65r2 keyboard controller
    [mega65kbd_to_matrix.vhdl]
2019-06-27 fix writing keyboard matrix bits >7
    [mega65kbd_to_matrix.vhdl]
2019-06-27 add pin identification debug for SD card
2019-06-27 switch SD card busses around so full-size is primary.
2019-06-27 sample keyboard input on opposite clock phase to shifting data out.
2019-06-27 slow down keyboard interface to try to fix glitching
    [mega65kbd_to_matrix.vhdl]
2019-06-27 add missing pin to SD card probing
    [testr2.xdc]
2019-06-27 try to fix SD card CD line problem
    [mega65r2.xdc]
2019-06-27 simplify drive led signal export
2019-06-28 more work on making drive LED work on r2 keyboard.
2019-06-28 C65 original LED colour is green, not red
2019-06-28 fix keyboard LED control and bit order bugs.
    [mega65kbd_to_matrix.vhdl]
2019-06-28 invert default left and up key state.
    [mega65r2.vhdl]
2019-06-28 fix timing issue with keyboard RX
    [mega65kbd_to_matrix.vhdl]
2019-06-28 disable on-screen floppy drive LED
2019-06-28 fix more typos etc in tracking down keyboard protocol issues
    [mega65kbd_to_matrix.vhdl]
2019-06-28 plumb direct line keys in to R2 PCB target.
2019-06-28 fix remaining problem with RETURN & DELETE key special case handling
    [mega65kbd_to_matrix.vhdl]
2019-06-29 fix synthesis problems caused by M65R2 PCB refactoring
    [megaphoner1.vhdl]
2019-06-29 fix mega65r1 target also for M65R2 refactor
    [mega65r1.vhdl]
2019-06-29 fix new pin number for A15 on cartridge port
    [mega65r2.xdc]
2019-06-29 add generic to identify different targets. try to fix intermittant read problems with cartridges in R2
    [cputypes.vhdl, expansion_port_controller.vhdl, gs4510.vhdl, machine.vhdl, mega65r2.vhdl]
2019-06-29 fix cartridge port clocking: make dotclock ~8MHz, and phi2 ~1MHz
    [expansion_port_controller.vhdl]
2019-06-29 try to fix cartridge_enable line control
    [gs4510.vhdl]
2019-06-29 try to fix cartridge EXROM and GAME line reading
    [expansion_port_controller.vhdl, mega65r2.vhdl]
2019-06-30 fix internal floppy drive for 40MHz clock
    [crc1581.vhdl, mfm_bits_to_bytes.vhdl, mfm_decoder.vhdl, mfm_gaps.vhdl, mfm_gaps_to_bits.vhdl, mfm_quantise_gaps.vhdl, sdcardio.vhdl]
2019-06-30 fix signal for hyperram
    [mega65r2.vhdl]
2019-06-30 begin reworking hyperram to use externally provided implementation
    [hyperram.vhdl]
2019-06-30 make mono/stereo/mirrored stereo controls work in MEGA65 CONFIG, and set default audio mixer levels for R2 PCB
2019-06-30 try to find cause of hr_clk_p pin not assignable error
    [mega65r2.vhdl, mega65r2.xdc]
2019-07-01 begin implementing MEGA65 R2 I2C peripherals
2019-07-01 add missing hram controller
    [hyper_xface.v]
2019-07-01 implement differentiated I2C peripherals for MEGA65R2 board
2019-07-01 begin documenting address space for I2C peripherals
2019-07-01 fix more synthesis errors and other work towards MEGA65R2 RTC working
    [iomapper.vhdl, mega65r2_i2c.vhdl]
2019-07-01 try renaming hr_clk_p signal to avoid synthesis error
    [mega65r2.vhdl, mega65r2.xdc]
2019-07-01 fix hyperram pin assignment problem
    [mega65r2.vhdl, mega65r2.xdc]
2019-07-01 try to fix writing to I2C peripherals
    [mega65r2_i2c.vhdl]
2019-07-01 try to fix problem with writing to I2C peripherals on M65R2
    [mega65r2_i2c.vhdl]
2019-07-01 connect M65R2 I2C peripherals to other I2C bus for debugging
2019-10-21 add missing enum definition for more targets.
    [megaphoner1.vhdl, nexys4ddr-widget.vhdl, nexys4ddr.vhdl]
2019-10-21 add missing generic values for target selection
    [nexys4ddr-widget.vhdl, nexys4ddr.vhdl]
2019-10-22 fix some synthesis errors for n4ddr target
    [nexys4ddr.vhdl]
2019-10-22 Fix some synthesis error for n4, similar to n4ddr.
    [nexys4.vhdl]
2019-10-22 plumb signals to modem 1 (nearest edge of PCB) for megaphone r1
2019-10-22 fix hyperram lack of negative clock
    [megaphoner1.vhdl]
2019-10-22 add reset line to hyperram interface in megaphone r1 target
    [megaphoner1.vhdl]
2019-10-22 add missing hyperram signals for megaphonee target
    [megaphoner1.vhdl]
2019-11-01 implement fake reset sequence to cartridge port.
    [expansion_port_controller.vhdl]
2019-11-01 Fix issues #94 and #95
    [gs4510.vhdl]
2019-11-01 don't probe $DF00 on startup (only was needed for R1 PCB)
2019-11-01 try reducing bit stream load rate from 66 to 33 for Nexys4DDR+widget board
2019-11-01 Make 32-bit ADC and SBC use C flag. Issue #96
    [gs4510.vhdl]
2019-11-01 add test program for pulseoximeter on buffered uart
2019-11-01 try to fix buffered UART RX buffer empty flag handling
    [buffereduart.vhdl]
2019-11-01 fix documentation of SPL
    [gs4510.vhdl]
2019-11-01 work on MEGAphone r2, including power down control
2019-11-01 add missing power_down plumbing
    [gs4510.vhdl, machine.vhdl, megaphoner1.vhdl]
2019-11-01 begin creating smoothed ADC readings from I2C wrapper
2019-11-01 plumb volume knob levels into audio mixer and LCD PWM generator
2019-11-01 fix various problems with volume knobs
    [i2c_wrapper.vhdl, iomapper.vhdl, sdcardio.vhdl]
2019-11-01 fix more errors with volume knob plumbing
    [audio_complex.vhdl]
2019-11-01 add volume wheels and touch status to i2cstatus display
2019-11-01 actually turn floppy motor on
2019-11-01 Fix CIA timer b counting modes #104
    [cia6526.vhdl]
2019-11-01 fix stupid error #104
    [cia6526.vhdl]
2019-11-01 try to fix n4ddr board keyboard problem
    [nexys4ddr.vhdl]
2019-11-01 revert incorrect fix for N4DDR keyboard input
    [nexys4ddr.vhdl]
2019-11-01 fix ethernet clock for N4DDR target (40->50MHz)
    [nexys4ddr.vhdl]
2019-11-01 try to fix stuck eth_mdio line
    [ethernet_miim.vhdl]
2019-11-01 move internal 1541 drive emulation memory mapping so that it doesn't clash with ethernet buffer
    [iomapper.vhdl]
2019-11-01 fix typo with fast key.
    [machine.vhdl]
2019-11-01 add joystick driven pointer for i2c status program
2019-11-01 feat(hyppo): port to kickass on development branch
    [KickAss.cfg]
2019-11-01 found inverted "clearing" of f_wgate line #110
    [sdcardio.vhdl]
2019-11-01 correct documentation of $D6E0.6
    [ethernet.vhdl]
2019-11-01 implement switching between 1kb and 2kb ethernet frames for debug streams
2019-11-01 begin reworking auto-documentation of ethernet commands
    [ethernet.vhdl]
2019-11-01 fix two ethernet documentation lines
    [ethernet.vhdl]
2019-11-01 use unused fourth IO mode to make it easier to map the ethernet frame buffer
    # Conflicts:
    # iomap.txt
2019-11-04 try to once-for-all fix keyboard glitching
    [keymapper.vhdl]
2019-11-04 try something simple to improve widget board keyboard scanning
2019-11-04 increase clock to widget board scanner
2019-11-11 correct size of MEGAfloppies to 64MiB.
    [dos.asm, sdcardio.vhdl]
2019-11-11 fix error in MEGAfloppy detection
    [dos.asm]
2019-11-11 fix typo in meega floppy signal names
    [sdcardio.vhdl]
2019-11-11 fix field width when setting disk image offsets
    [sdcardio.vhdl]
2019-11-13 Implement dual-drive support for D81 image attachment. Issue #116
    [dos.asm, freeze.asm, main.asm]
2019-11-13 fix setting sector number for drive 1 d81 image, accessing 2nd disk image. Issue #116
    [dos.asm, sdcardio.vhdl]
2019-11-13 fix stupid error with D81/DMD image handling in $D68B
    [sdcardio.vhdl]
2019-11-20 Updated freeze menu to latest version with real floppy mount fixes.
2019-11-28 try to fix erasure of last physical raster of chargen
2019-11-28 make chargen end raster delay counter variable via $D07D for debugging.
2019-11-28 correct end of chargen delay to 3 raster lines
2019-11-28 try 640x480 60Hz NTSC simulation mode with more exact timing.
2019-11-28 begin implementing phi2 clock pulse output from video frame generator.
2019-11-28 add 40mhz clock inputs to pixel driver
2019-11-28 fix some problems with phi2 generation
    [frame_generator.vhdl]
2019-11-28 adjust frame positions for 50 and 60hz video modes.
2019-11-28 more finetuning frame positions.
2019-11-28 try to get rid of horizontal line at bottom of 60hz screen
2019-11-28 move 50hz char display up a bit.
2019-11-28 try to shove screen left a bit to correct centreing.
    [pixel_driver.vhdl]
2019-11-28 shift 60hz display down somewhat.
2019-11-28 try to use HDMI PAL/NTSC video modes more correctly.
    [pixel_driver.vhdl]
2019-11-28 fix problems with last commmit
    [pixel_driver.vhdl]
2019-11-28 and really fix it
    [pixel_driver.vhdl]
2019-11-28 fix problems with 60Hz video mode on route towards using 27MHz PAL/NTSC modes
    [pixel_driver.vhdl]
2019-11-28 first cut at moving to HDMI compatible video modes.
2019-11-28 begin reworking mega65r2 target to use HDMI video modes
    [ethernet.vhdl, iomapper.vhdl, machine.vhdl, mega65r2.vhdl]
2019-11-28 try to use exactly 720x480 60Hz
2019-11-28 try to synchronise green pattern to frame output
2019-11-28 fix HSYNC position for 50Hz mode
    [pixel_driver.vhdl]
2019-11-28 use only 27MHz pixel clock in frame generator
2019-11-28 begin simplifying frame generator and pixel driver to use new clock relationships
2019-11-28 get video frames in 576p PAL/NTSC pretty much right
2019-11-28 begin adapting mega65 machine to use modified pixel driver setup
2019-11-28 move megaphone and mega65 targets to new video driver stuff
2019-11-28 fix synthesis error with new video driver
    [megaphoner1.vhdl]
2019-11-28 debug blank display with real targets and new video driver.
2019-11-28 try to fix pixel output during HSYNC bug
    [frame_generator.vhdl]
2019-11-28 fix a typo in signal name
    [pixel_driver.vhdl]
2019-11-28 fix more errors and clean out some deprecated signals
    [pixel_driver.vhdl]
2019-11-28 fix timing for PAL50 mode
    [pixel_driver.vhdl]
2019-11-28 fix hsync timing for PAL50 mode
    [pixel_driver.vhdl]
2019-11-28 simplify PAL/NTSC switching logic
2019-11-28 find and fix hsync plumbing problem.
    [pixel_driver.vhdl]
2019-11-28 fix VGA60 mode plotting signal clocked latching
    [pixel_driver.vhdl]
2019-11-28 more tweaking video frame position
2019-11-28 keep trying to debug video output problems
    [machine.vhdl]
2019-11-28 more debugging video output problems
    [pixel_driver.vhdl]
2019-11-28 fix some clock plumbing for N4DDR-widget target
    [nexys4ddr-widget.vhdl]
2019-11-28 reverse some debug output, now that video display is working again
    [pixel_driver.vhdl]
2019-11-28 recalculate border positions when switching PAL/NTSC, except when in hypervisor mode
2019-11-28 revert fast-tracking blue channel on VGA for debug
    [machine.vhdl]
2019-11-28 try to fix matrix mode terminal display problems.
    [machine.vhdl, rain.vhdl]
2019-11-28 fix problem with OSK display of pressed keys: left edge was wrongly placed
    [visual_keyboard.vhdl]
2019-11-28 fix problem with last commit
    [visual_keyboard.vhdl]
2019-11-28 try to fix shimmer in matrix mode.
    [rain.vhdl]
2019-11-28 try to de-shimmer matrix mode in PAL
2019-11-28 Black out front and back porches for better VGA mode handling. Issue #114
    [frame_generator.vhdl, machine.vhdl, pixel_driver.vhdl]
2019-11-28 fix copy-pasta. Issue #114
    [pixel_driver.vhdl]
2019-11-28 Try to improve vertical and horizontal centring. Issue #114
    [frame_generator.vhdl, pixel_driver.vhdl]
2019-11-28 more tweaking frame positions
2019-11-28 try to get HDMI I2C interface working
2019-11-28 switch lines for HDMI SCL and SDA
2019-11-28 correct pin assignment for HDMI SCL
    [mega65r2.xdc]
2019-11-28 can talk to 7511 I2C bus. Issue #127
2019-11-28 try to switch HDMI packet memory etc back to HDMI side for use after initialising
2019-11-28 speed up I2C communications for 7511 digital video driver
2019-11-28 further speed up 7511 I2C comms
2019-11-28 tweak 7511 I2C register setup based on Mike Field's implementation
2019-11-28 fix LS_OE pin assignment for digital video output
    [mega65r2.xdc]
2019-11-28 fix digital video clock and DE signal generation
    [mega65r2.vhdl]
2019-11-28 refactor pixel driver etc to produce more closely to HDMI compliant modes
2019-11-28 fix redundant multiple driver
    [pixel_driver.vhdl]
2019-11-28 fix pin assignments for m65r2 board
    [hdmidebug.xdc]
2019-11-28 try to fix PAL and NTSC frames so that C65 BASIC raster interrupts run again.
    [pixel_driver.vhdl]
2019-11-28 keep simplifying working HDMI driver
2019-11-28 further simplifying HDMI driver
2019-11-28 even more simplifying HDMI driver
2019-11-28 simplify the HDMI driver even more
2019-11-28 further HDMI driver simplification to use externally supplied 27mhz pixelclock
2019-11-28 fix 720x576@50Hz mode timing for both VGA and HDMI
    [pixel_driver.vhdl]
2019-11-28 add HDMI driver source files to MEGA65r2 target
2019-11-28 fix timing for 720x480x60Hz VGA and HDMI output
    [pixel_driver.vhdl]
2019-11-28 begin merging in HDMI output driver
2019-11-28 begin impplementing setting of the HDMI device name in packet memory.
2019-11-28 remove duplicate driver for HDMI SCL/SDA lines
2019-11-28 fix compilation problems with N4DDR-widget target after incorporating HDMI output
    [nexys4ddr-widget.vhdl]
2019-11-28 adjust sprite Y position / raster offset when switching PAL/NTSC
2019-11-28 fix horizontal image placement in new HDMI-friendly video modes
    [frame_generator.vhdl, pixel_driver.vhdl]
2019-11-28 add extra files for Hamster's SPDIF driver
2019-11-28 Fix thumbnail sampling to 80 pixels per raster. #114
    [framepacker.vhdl]
2019-12-01 Fixing nexys4 target for hdmi video integration (clock changes).
    [nexys4.vhdl]
2019-12-01 More fixes for Nexys4 target.
    [nexys4.vhdl]
2019-12-01 More nexys4 target fixes.
    [nexys4.vhdl]
2019-12-02 Try to fix mega65r1 target.
    [mega65r1.vhdl]
2019-12-21 fix errors in previous commit. #141
    [gs4510.vhdl]
2019-12-21 try to fix reading and writing RAM via VDC interface. #141
    [gs4510.vhdl]
2019-12-21 try to fix multiple driver for shadowram with VDC interface. #141
    [gs4510.vhdl]
2019-12-21 try to fix multiple drivers etc. #141
    [gs4510.vhdl]
2019-12-21 Fix writing to RAM via VDC registers. #141
    [gs4510.vhdl]
2020-01-03 Try to limit register behaviour change to track down CPU stability issues. #141
    [gs4510.vhdl]
2020-01-03 Add potential missing flag "accessing_cpuport <= '1';", #141.
    [gs4510.vhdl]
2020-01-03 Some fixes for the vhdl implementation. #141
    [gs4510.vhdl]
2020-01-04 Fix another place of vdc to viciv address translation. #138
    [gs4510.vhdl]
2020-01-04 Try the address increment when writing to $D601 in the case the re-mapping happens.
2020-01-04 Try another alternative fix for the auto increment when writing D601. #141
    [gs4510.vhdl]
2020-01-04 Fix syntax error. #141
    [gs4510.vhdl]
2020-01-05 Fixing VDC block operation counter. #141
    [gs4510.vhdl]
2020-01-05 Trying to skip first byte when writing VDC block operations. #141
    [gs4510.vhdl]
2020-01-05 Likely proper fix of the offset issue. #141
    [gs4510.vhdl]
2020-01-06 Trying disable changes to track down freezer operation issues. #141
    [gs4510.vhdl]
2020-01-06 Ok, last change seemed to fix the freezer issues. Let enable VDC for testing. #141
    [gs4510.vhdl]
2020-02-21 work on debugging onboard I2C peripherals for M65R2. #163
    # src/vhdl/hdmidebug.vhdl
    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
2020-02-21 swap FPGA SCL/SDA around. #163
    [mega65r2.xdc]
2020-02-21 make it possible to control I2C reset line. #163
    [mega65r2_i2c.vhdl]
2020-02-21 add debug control of I2C control lines. #163
2020-02-21 also allow debug swapping of I2C control lines. #163
    [mega65r2_i2c.vhdl]
2020-02-21 add more debug support to M65R2 I2C stuff. #163
2020-02-21 connect M65R2 I2C peripherals to correct bus. #163
    # src/vhdl/mega65r2.vhdl
    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
    [mega65r2.vhdl]
2020-02-21 swap FPGA I2C pins. again. #163
    [mega65r2.xdc]
2020-02-21 Track down and fix I2C bus access problems. #163
    # src/vhdl/test_i2c.vhdl
    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
    [mega65r2_i2c.vhdl]
2020-02-21 fix mega65r2_i2c.vhdl transaction problems. #163
    # Makefile
    # src/vhdl/i2c_master.vhdl
    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
    [i2c_master.vhdl, mega65r2_i2c.vhdl]
2020-02-21 #163 add missing include after merge.
    [i2c_master.vhdl]
2020-02-21 Fixing vga_hdmi synthesis error #141.
    [mega65r2.xdc]
2020-02-21 Revert "Fixing vga_hdmi synthesis error #141."
    This reverts commit 3ec8eb5e9d604f0852791a5e0df286d1b27d16cb.
    [mega65r2.xdc]
2020-02-29 link mega65-libc for i2cstatus program.
2020-02-29 use mega65-libc in i2cstatus
    # src/utilities/i2cstatus.c
    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
2020-02-29 correct TOD division. #106
    [cia6526.vhdl]
2020-03-01 correct CIA TOD 50Hz signal trim for 40.625MHz CPU clock. #106
    # src/vhdl/iomapper.vhdl
    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
    [iomapper.vhdl]
2020-03-16 add missing signal. #153
    [sdcardio.vhdl]
2020-03-16 fix typos etc. #153
    [sdcardio.vhdl]
2020-03-16 fix double-declared interface. #153
    [iomapper.vhdl]
2020-03-16 add missing signal directions. #153
    [mega65r2.vhdl]
2020-03-16 ... and the one I missed. #153
    [sdcardio.vhdl]
2020-03-16 fix startupe2 synthesis problem. #153
    [sdcardio.vhdl]
2020-03-16 fix QSPI flash pin assignments for M65r2 target. #153
    [mega65r2.vhdl, mega65r2.xdc]
2020-03-16 show manufacturer and device ID. #153
2020-03-16 fix qspi plumbing for N4DDR-widget target. #153
    [nexys4ddr-widget.vhdl]
2020-03-16 fix qspi db signal type. #153
    [nexys4ddr-widget.vhdl]
2020-03-16 disable STARTUPE2 to try to debug problems. #153
    [sdcardio.vhdl]
2020-03-16 fix signal type. #153
    [iomapper.vhdl]
2020-03-16 try to fix STARTUPE2 instantiation. #153
    [hdmidebug.vhdl]
2020-03-16 backout STARTUPE2 in hdmidebug target to confirm it is problem. #153
    [hdmidebug.vhdl]
2020-03-16 re-insert corrected STARTUPE2 instantiation. #153
    [sdcardio.vhdl]
2020-03-16 fix auto-documentation for QSPI flash bit-bash interface. #153
    [sdcardio.vhdl]
2020-03-16 try moving STARTUPE2 to top level to fix QSPI clock control. #155
    [iomapper.vhdl, machine.vhdl, nexys4ddr-widget.vhdl, nexys4ddr-widget.xdc, sdcardio.vhdl]
2020-03-16 try to track down source of failure for qspi clock in n4ddr+widget target. #155
    [nexys4ddr-widget.vhdl]
2020-03-16 begin rework to put boundary scan in separate thread. #155
    # src/tools/monitor_load.c
    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
2020-03-16 Fix switched SO/SI for QSPI flash interface. #149
    [sdcardio.vhdl]
2020-03-16 get talking to the QSPI flash via SPI working. #149
    # src/utilities/qspitest.c
    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
2020-03-16 scan QSPI flash for available bitstream slots. #156
2020-03-16 implement check for whether slot is completely empty. #156
2020-03-16 implement filename extension filter in directory scan. #156
2020-03-16 make display of current flash use nicer. #156
2020-03-16 backout non-working JTAG->SPI config stuff. #156
2020-03-16 fix starting bitstream from QSPI slot #0. #156
2020-03-16 black screen when reconfiging FPGA. Prepare infrastructure for reflashing slots. #156
2020-03-16 implement erasing flash slot before writing. fix compiler warnings. #158
2020-03-16 fix various problems when erasing and writing flash slots. #158
2020-03-16 work on debuggin reconfig reading of current boot address. #156
    # src/vhdl/hdmidebug.xdc
    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
2020-03-16 swap CS/RW lines around to correct orientation. #156
    [reconfig.vhdl]
2020-03-16 use correct slice of reg_num. #156
    [hdmidebug.vhdl]
2020-03-16 pull only correct value out from ICAPE2. #156
    [hdmidebug.vhdl, reconfig.vhdl]
2020-03-16 correct plumbing into reconfig of ICAPE2 register number. #156
    [sdcardio.vhdl]
2020-03-16 fix icape2_reg initialisation. #156
    [sdcardio.vhdl]
2020-03-16 flip bit order when reading ICAPE2 register values. #156
    [reconfig.vhdl]
2020-03-16 add flash menu to shadowram on power up, and run it when required. #156
    # vivado/mega65r2.xpr
    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
2020-03-16 don't ask if there is no reason to continue booting with current bitstream. #156
2020-03-16 Fix detection of whether flash slot 1 is valid or not. #156
2020-03-16 fix formatting of messed up flash slot message. #156
2020-03-16 add option to erase flash slots. #156
2020-03-16 fix display when erasing slots. fix nul at end of -erase slot- message. #156
2020-03-16 try to fix false positives for thinking slot 1 is corrupt. #156
2020-03-16 fix check for whether slot 1 is empty or not. #156
2020-03-16 more investigation of flash menu erroneously claiming slot 1 not empty. #156
2020-03-16 really fix checking slot 1 is empty or not ;) #156
2020-03-16 fix problems entering flash menu if there are no corrupt flash slots. #156
    [main.asm]
2020-03-16 show info from COR file on flash slots. #156
2020-03-16 begin switching megaflash to use hypervisor-compatible file access. #156
2020-03-16 implement convoluted access to reflash slot 0. #156
2020-03-16 remove ESC temporary debug entry to flash menu. #156
2020-03-16 try to fix auto-starting bitstream from slot 1. #156
2020-03-16 Trying to fix mega65r1 synthesis #156
    [mega65r1.vhdl]
2020-03-16 Fixing more qspi issues. #156
    [megaphoner1.vhdl, nexys4.vhdl]
2020-03-16 fix someproblems with MEGA65R1 target. #179
    [mega65r1.vhdl]
2020-03-16 add pin assignments for QSPI flash for M65R1. #179
2020-03-25 fix memory map preparation for OpenROM. #188
    # src/hyppo/main.asm
    # src/hyppo/main.asm
    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
    [main.asm]
2020-03-28 add missing signals. #186
    [keyboard_to_matrix.vhdl]
2020-03-28 fix typo in last. #186
    [keyboard_to_matrix.vhdl]
2020-03-28 try to fix up/left shift glitching. #186
    # src/vhdl/matrix_to_ascii.vhdl
    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
    [matrix_to_ascii.vhdl]
2020-03-28 even more up/left shift glitch supression. #186
    [matrix_to_ascii.vhdl]
2020-03-28 implement multiple further measures to prevent UP/LEFT shift glitching. #186
    [keyboard_complex.vhdl, keyboard_to_matrix.vhdl, matrix_to_ascii.vhdl]
2020-03-28 invert sense of UP/LEFT for auto-shift. #186
    [matrix_to_ascii.vhdl]
2020-03-28 Remove some debug code, correct some merge issues. #156
    [main.asm]
2020-03-29 fix scrolling of HYPPO messages. #190
    [main.asm]
2020-03-29 change flash menu key to NO SCRL to avoid race condition on startup. #190
    [main.asm]
2020-03-29 fix probable cause of external microSD card not working. #164
    [mega65r2.xdc]
2020-03-29 try to waggle other microSD card slot pins. #164
2020-03-29 use 24mA drive strength on uSD CS line. #164
2020-03-29 revert back to default drive strength etc, now MAX10 isn't cross driving. #164
    [hdmidebug.xdc, mega65r2.xdc]
2020-03-29 try to correct plumbing for 2nd SD card clock etc. #164
    [iomapper.vhdl, machine.vhdl, mega65r2.vhdl]
2020-03-29 fix syntax error. #164
    [iomapper.vhdl]
2020-03-29 add missing signal for 2nd SD clock. #164
    [machine.vhdl]
2020-03-29 try to fix pin placement error. #164
    [mega65r2.vhdl, mega65r2.xdc]
2020-04-01 fix selecting alternate flash slots. #185
2020-04-06 fix plumbing for keyboard complex in hdmidebug. #189
    # vivado/hdmidebug_gen.tcl
    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
    [hdmidebug.vhdl]
2020-04-06 plumb ASCII keyboard to UART TX as keyboard loopback test for hdmidebug target. #189
2020-04-06 fix type cast. #189
    [hdmidebug.vhdl]
2020-04-06 fix clock to UART TX. #189
    [hdmidebug.vhdl]
2020-04-06 fix clock plumbing for keyboard test #189
    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
    [hdmidebug.vhdl]
2020-04-06 tweak UART TX baud rate. #189
2020-04-06 fix which bit we clear when CAPS LOCK is active. #189
    [matrix_to_ascii.vhdl]
2020-04-06 invert sense of CAPS LOCK key for ASCII key parser on mega65r2 target. #189
    [mega65r2.vhdl]
2020-04-06 fix inversion of CAPS LOCK for ASCII keyboard scanner and bucky key vector. #189
    [matrix_to_ascii.vhdl, mega65r2.vhdl]
2020-04-06 Make external microSD interface take priority over the internal SD card slot. #195
2020-04-06 try to fix oscillating state of column 9 keys. #197
    [keymapper.vhdl]
2020-04-06 re-swap default bus in flash menu given we just switched the physical buses. #176 #195
2020-04-06 try to fix defaulting to external SD card bus. #176 #195
    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
    [main.asm, mega65r2.vhdl]
2020-04-07 Fixing merge isse. #156
    [matrix_to_ascii.vhdl]
2020-04-08 fix some messages for flash menu. #190
    [main.asm]
2020-05-24 Add logic to slow down hyperram accesses enough to be traceable via JTAG boundary scan. #165
2020-05-24 make LED and HDMI colours reflect HyperRAM status. #165
2020-05-24 tried switching LED and hr_d[0] around to confirm it isn't my logic at fault. #165
2020-05-24 put LED and hr_d[0] back. #165
2020-05-24 work on fixing MEGAphone r1 target, and debugging hyperram. #165
    [megaphoner1.vhdl]
2020-05-24 fix more typos in MPr1 target. #165
    [megaphoner1.vhdl]
2020-05-24 implement framework for running multiple hyperram transactions during testing. #165
2020-05-24 fix duplicate PULLUP statement. #165
    [hdmidebug.xdc]
2020-05-24 try to fix read transactions on HyperRAM. #165
    [fakehyperram.vhdl, hyperram.vhdl]
2020-05-24 tri-state hr_d when waiting for read. Fix read command fields. Always use memory address space. #165
    [hyperram.vhdl]
2020-05-24 try to fix multiple driver bugs. #165
    [hyperram.vhdl]
2020-05-24 fix more multiple driver problems. #165
    [hyperram.vhdl]
2020-05-24 try to debug hyperram plumbing issue. #165
    [hyperram.vhdl]
2020-05-24 more work on debugging HyperRAM problems. #165
    [hyperram.vhdl]
2020-05-24 fix multiple drivers and implement simple 8 byte cache for hyperram. #165
    [hyperram.vhdl]
2020-05-24 fix hyperram multiple drivers for data ready strobe. #165
    [hyperram.vhdl]
2020-05-24 debug problems with hyperram transactions. #165
    [hyperram.vhdl]
2020-05-24 connect correct clock to hyperram. #165
    [mega65r2.vhdl]
2020-05-24 revert to using internal hyperram now that it is talking to us. #165
    [mega65r2.xdc]
2020-05-24 fix latching of reading hyperram requests. #165
    [hyperram.vhdl]
2020-05-24 add missing ; #165
    [hyperram.vhdl]
2020-05-24 fix setting write latency. #165
    [hyperram.vhdl]
2020-05-24 try to fix read latency problems. #165
    [hyperram.vhdl]
2020-05-24 fix width of byte_phase. #165
    [hyperram.vhdl]
2020-05-24 try to debug hyperram problems. #165
    [hdmidebug.vhdl]
2020-05-24 fix some typos etc. #165
    [hyperram.vhdl]
2020-05-24 try to fix out-by-one-byte error when reading from Hyperram. Make rwds tri-stateable when debugging. #165
    [hyperram.vhdl]
2020-05-24 fix write preamble for hyperram. #165
    [hyperram.vhdl]
2020-05-24 fix timing on closing hyperram write transactions. #165
    [hyperram.vhdl]
2020-05-24 fix clock handling between hyperram jobs. #165
    [hyperram.vhdl]
2020-05-24 fix synthesis problem with reading signal. #165
    [hyperram.vhdl]
2020-05-24 clean up and fix logic for waiting for RWDS during read. #165
    [hyperram.vhdl]
2020-05-24 fix byte retrieval and stashing into cache for hyperram. #165
    [hyperram.vhdl]
2020-05-24 Fix cache bugs and make cache 2-way associative. #165
    [hyperram.vhdl]
2020-05-24 End hyperram writes defensively to prevent repeated writes to ADDR+2. #165
    [hyperram.vhdl]
2020-05-24 try talking to hyperram on PMOD ports to debug problem writing odd addresses. #165
    [mega65r2.xdc]
2020-05-24 implement run-time switchable odd-byte fixes. #165
    [hyperram.vhdl]
2020-05-24 revert to on-board hyperram. #165
    [mega65r2.vhdl, mega65r2.xdc]
2020-05-24 fix multiple drivers. #165
    [hyperram.vhdl]
2020-05-24 adding conf reg writes broke hyperram. trying to fix. #165
    [hyperram.vhdl]
2020-05-24 more trying to fix the problems that came when adding write to config regs. #165
    [hyperram.vhdl]
2020-05-24 add missing typecasts. #165
    [hyperram.vhdl]
2020-05-24 select linear mode when writing config registers and other small fixes. #165
    [hyperram.vhdl]
2020-05-24 begin fixing end of write sequences to not tick clock as CS released. #165
    [hyperram.vhdl]
2020-05-24 begin implementing short-circuit fast-path for reading hyperram cache from slow_devices. #165
    [cputypes.vhdl, hyperram.vhdl]
2020-05-24 implement remaining parts of short-circuit hyperram cache reading. #165
    [hyperram.vhdl]
2020-05-24 plumb in new short-circuit cache for hyperrram into slow_devices. #165
2020-05-24 plumb in short-circuit cache for hyperram in slow_devices for M65R2 target. #165
    [mega65r2.vhdl]
2020-05-24 fix bug in short-circuit hyperram cache update. #165
    [hyperram.vhdl]
2020-05-24 fix extra latency when writing and make adjustable. #165
    [hyperram.vhdl]
2020-05-24 fix extra latency for hyperram writes. #165
    [hyperram.vhdl]
2020-05-24 make it easier to re-probe hyperram to support debugging timing latencies etc. #165
2020-05-24 fix disabling of cache. #165
    [hyperram.vhdl]
2020-05-24 fix various problems with write cache, more to go. #165
    [hyperram.vhdl]
2020-05-24 more work on fixing problems with write buffers for hyperram. #165
    [hyperram.vhdl]
2020-05-24 fix many more bugs with write buffers for hyperram. #165
    [hyperram.vhdl]
2020-05-24 try to fix non-cached hyperram writes. #165
    [hyperram.vhdl]
2020-05-24 fix end of hyperram command timing for conf write and fix problems with timing compression. #165
    [hyperram.vhdl]
2020-05-24 fix many more problems with timing optimisation for hyperram. #165
    [hyperram.vhdl]
2020-05-24 try to fix chopped last byte of hyperram write command. #165
    [hyperram.vhdl]
2020-05-24 and another missing file from unstable.
    [hdmi_i2c.vhdl]
2020-05-24 add more missing files. Fix mis-merged changes. #165
    [hdmi_spdif.vhdl, hyperram.vhdl, tb_spdif_out.vhd, tb_timebase.vhd]
2020-05-24 revert hyperram to get rid of broken timing optimisation stuff. #165
    [hyperram.vhdl]
2020-05-24 release hyperram from reset and enable cache by default. #165
    [hyperram.vhdl]
2020-05-24 get split clock setting more or less working for hyperram command issue. #204
    [hyperram.vhdl]
2020-05-24 add missing , #204
    [mega65r2.vhdl]
2020-05-24 fix ddr phase for hyperram writes. #204
    [hyperram.vhdl]
2020-05-24 fix hyperram readwat clock phase. #204
    [hyperram.vhdl]
2020-05-24 fix inter-transaction T_RWR enforcement for hyperram. #204
    [hyperram.vhdl]
2020-05-24 test hyperram slow devices request acknowledgement logic. #204
2020-05-24 try to fix hyperram latency setup. #204
    [hyperram.vhdl]
2020-05-24 begin implementing runtime switching between 40mhz/80mhz hyperram control. #204
2020-05-24 fix bugs with runtime adjustable hyperram 40/80mhz clocking. #204
    [hyperram.vhdl]
2020-05-24 fix clocking when doing slow 40mhz hyperram transactions. #204
    [hyperram.vhdl]
2020-05-24 use correct phase of read clock when latching hyperram reads. #204
    [hyperram.vhdl]
2020-05-24 fix error in last commit. #206
    [framepacker.vhdl]
2020-05-24 Try to fix NTSC raster number indication and raster interrupts. #181 #201
2020-05-24 add missing assignments. #206
    [framepacker.vhdl]
2020-05-24 try to fix slow hyperram read clock phase. #165
    [hyperram.vhdl]
2020-05-24 fix timing at end of slow hyperram writes. #165
    [hyperram.vhdl]
2020-05-24 fix short clock in the middle of slow hyperram reads. #165
    [hyperram.vhdl]
2020-05-24 more hyperram fast clock control fixes. #165
    [hyperram.vhdl]
2020-05-24 fix remaining obvious waveform problems with hyperram fast clock. #165
    [hyperram.vhdl]
2020-05-24 fix initial hyperram CR0 write timing to work by fast or slow. #165
    [hyperram.vhdl]
2020-05-24 rework update-cache-on-write to avoid mult drivers. #165
    [hyperram.vhdl]
2020-05-24 fix multiple driver by invalidating cache lines on write. #165
    [hyperram.vhdl]
2020-05-24 revert to defaulting to 40MHz hyperram transfers. #165
    [hyperram.vhdl]
2020-05-24 try higher drive current to improve HyperRAM timing. #165
2020-05-24 try to fix 40mhz hyperram read timing and conf reg writing. #165
    [hyperram.vhdl]
2020-05-24 fix writing to hyperram config registers. #165
    [hyperram.vhdl]
2020-05-24 fix hyperram job accept latching. #165
    [hyperram.vhdl]
2020-05-24 try fixing phase when reading data from hyperram. #165
    [hyperram.vhdl]
2020-05-24 revert to internal hyperram. #165
    [mega65r2.xdc]
2020-05-24 fix signal name. #165
    [mega65r2.vhdl]
2020-05-24 fix copy-pasta errors in 2nd HyperRAM support. #165
    [hyperram.vhdl]
2020-05-24 try switching primary and secondary HRAMs #165
2020-05-24 revert HRAM 0 and 1 positions #165
    [mega65r2.vhdl]
2020-05-24 identify and fix cache consistency bug. #165
    [hyperram.vhdl]
2020-05-24 fix updating read cache when writing. #165
    [hyperram.vhdl]
2020-05-24 update current cache line when writing also. #165
2020-05-24 fix multiple driver and other bugs. #165
    [hyperram.vhdl]
2020-05-24 try to fix slow ram reading of first byte in row. #165
    [hyperram.vhdl]
2020-05-24 increase hyperram drive strength to reduce error rate at 80MHz. #165
    [hyperram.vhdl]
2020-05-24 fix plumbing for 2nd HyperRAM. #165
    [hyperram.vhdl]
2020-05-24 make byte0 delay fix runtime controllable. #165
    [hyperram.vhdl]
2020-05-24 fix mixed up hyperram latency controls. #165
    [hyperram.vhdl]
2020-05-24 invert read phase enable for hyperram2 #165 external hyperram has wire-line latency, so need for the shift.
    [hyperram.vhdl]
2020-05-24 plumb in control for keyboard LEDs #208
2020-05-24 fix errors in c65uart.vhdl
    [c65uart.vhdl]
2020-05-24 fix bugs with hypereram schedular feeding stale addresses. #165
    [hyperram.vhdl]
2020-05-24 fix hyperram 0/1 select bugs and improve debug output #165
    [hyperram.vhdl]
2020-05-24 fix some more problems accessing 2nd hyperram and stale address use #165
    [hyperram.vhdl]
2020-05-24 try to fix slew and drive for external hyperram. #165
    [mega65r2.xdc]
2020-05-24 short-circuit reads from from in-progress block read #165
    [hyperram.vhdl]
2020-05-24 fix block read merging etc corner cases. #165
    [hyperram.vhdl]
2020-05-24 fix multiple driver problem #165
    [hyperram.vhdl]
2020-05-24 try to reverse hyperram problems introduced in ee981cc
    [hyperram.vhdl]
2020-05-24 fix non-cached writes to hyperram #165
    [hyperram.vhdl]
2020-05-24 fix some bugs with non-cached access. #165
    [hyperram.vhdl]
2020-05-24 fix non-cached reads and writes. #165
    [hyperram.vhdl]
2020-05-24 fix multiple driveres and collect optimisation enable flags. #165
    [hyperram.vhdl]
2020-05-24 fix another multiple-driver issue. #165
    [hyperram.vhdl]
2020-05-24 fix intermittent write bug in hyperram #165
    [hyperram.vhdl]
2020-05-24 fix typo with 16-bit access #165
    [hyperram.vhdl]
2020-05-24 first cut at write chaining #165
2020-05-24 fix bugs with chained writes and cache coherence. #165
    [hyperram.vhdl]
2020-05-24 begin implementing VIC-IV data fetch interface. some bugs remain #165
    [hyperram.vhdl]
2020-05-24 fix bugs with VIC access and latching requests when busy. #165
    [hyperram.vhdl]
2020-05-24 fix simulation in ghdl #165
    [cputypes.vhdl, fake_reconfig.vhdl, i2c_master.vhdl, iomapper.vhdl, sdcardio.vhdl]
2020-05-24 fix hyperram simulation in cpu_test target #165
    [hyperram.vhdl]
2020-05-24 add drive stage to data from hyperram to VIC-IV #165
2020-05-24 add drive stage to vdc_mem_addr* to improve timing #165
2020-05-24 add drive stage for signals from VIC to hyperram #165
2020-05-24 add extra drive stage to VDC address resolution to improve timing closure #165
2020-05-24 more work on fixing faster hyperram chained write etc logic #165
    [hyperram.vhdl]
2020-05-24 fix VIC-IV vs CPU transaction contention bugs. #165
    [hyperram.vhdl]
2020-05-24 use drive stage for cache updates to improve timing closure #165
2020-05-24 replace ipcore dotclock with more accurate and slightly lower pixelclock #165
    [ddr.csv]
2020-05-24 add extra drive stage for VIC-IV hyperram request toggle #165
2020-05-24 fix clearing of cache valids during writes #165
    [hyperram.vhdl]
2020-05-24 fix pre-fetching chaining between blocks #165
    [hyperram.vhdl]
2020-05-24 fix multiple drivers for chained prefetching #165
    [hyperram.vhdl]
2020-05-24 fix multiple driver. #165
    [hyperram.vhdl]
2020-05-24 make slow_devices CPU prefetch logic switchable #165
2020-05-24 fix bug in slow device prefetch logic in CPU #165
    [gs4510.vhdl]
2020-05-24 test slow device prefetch logic #165
2020-05-24 fix problems with linear read optimisations #165
    [hyperram.vhdl]
2020-05-24 fix another corner case with hyperram prefetch #165
    [hyperram.vhdl]
2020-05-24 enable slow device prefetch logic by default #165
2020-05-24 add extra drive stage to improve timing closure #165
2020-05-24 fix MMCM chain order to keep in frequency range #165
    [clocking.vhdl]
2020-05-24 replace a forgotten slow piece of logic. #165
    [hyperram.vhdl]
2020-05-24 allow disabling of chained prefetches #165
2020-05-24 fix type in last commit. #165
    [hyperram.vhdl]
2020-05-24 fix various cache update bugs #165
    [hyperram.vhdl]
2020-05-24 fix more cache coherency bugs #165
    [hyperram.vhdl]
2020-05-24 fix multiple driver #165
    [hyperram.vhdl]
2020-05-24 more work on multiple driver fixing #165
    [hyperram.vhdl]
2020-05-24 remove byte0_fix logic, which is no longer required #165
    [hyperram.vhdl]
2020-05-24 fix signal widths #165
    [hyperram.vhdl]
2020-05-24 log VIC-IV accesses, disable chained writes on external hyperram #165
2020-05-24 make current_cache_line export controllable #165
2020-05-24 fix bugs in cache update on write logic #165
    [hyperram.vhdl]
2020-05-24 fix more cache coherence on write bugs #165
    [hyperram.vhdl]
2020-05-24 fix when both write buffers point to same row #165
    [hyperram.vhdl]
2020-05-24 implement debug interface for force-feeding chipset DMA replies #165
2020-05-24 add test for chipset dma #165
2020-05-24 add debug facility for chipset DMA fetches #165
2020-05-24 fix chipset DMA address calculation bug #165
    [hyperram.vhdl]
2020-05-24 pull in fixed i2c_master and provide explicit clock rates all round #138
    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
    [hdmi_i2c.vhdl, i2c_master.vhdl, i2c_wrapper.vhdl, iomapper.vhdl, mega65r2_i2c.vhdl, sdcardio.vhdl]
2020-05-24 Fixing some i2c issues by manual pull them from #138 branch.
2020-05-24 More fixing for merge issues #165.
    [sdcardio.vhdl]
2020-05-24 fix more copy pasta #138
    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
    [i2c_wrapper.vhdl, mega65r2_i2c.vhdl, sdcardio.vhdl]
2020-05-24 Fixing more merge conflicts #165.
    [iomapper.vhdl]
2020-05-24 More merge fixes #165.
    [iomapper.vhdl]
2020-05-24 Add missing clock_frequency change to audio_complex #165.
    [audio_complex.vhdl]
2020-05-24 Still trying to fix synthesis issues. #165
    [audio_complex.vhdl]
2020-05-24 Fixing megaphoner1 target. #165
    [megaphoner1.vhdl]
2020-05-31 Implement FDC "auto tune" which seeks to requested track automatically #129
2020-05-31 fix formatting for 6502 instruction addressing modes #227
    [gs4510.vhdl]
2020-05-31 make unstable illegal opcodes trap to hypervisor #227
    [gs4510.vhdl]
2020-06-01 implement registers for audio DMA channels #228
2020-06-01 relayout audio dma regs. plumb data fetching and sample writing. #228
2020-06-01 add debug register to count audio dma fetches #228
2020-06-01 fix synthesis errors. document audio DMA registers #228
    [gs4510.vhdl]
2020-06-01 fix multiple drivers
2020-06-01 fix multiple drivers #228
    [cputypes.vhdl, gs4510.vhdl]
2020-06-01 implement calculation and writing of audio dma mixed samples #228
2020-06-02 more work on audio DMA #228
2020-06-02 add simple example that tickles GHDL bug #228
    [ghdl_bug.vhdl]
2020-06-02 try to figure out what is going wrong with GHDL simulation #228
    [ghdl_bug.vhdl, gs4510.vhdl, main.asm]
2020-06-03 add flag to disable audio DMA #228
2020-06-03 add audio DMA enable check to another spot #228
2020-06-03 prevent audio DMA retriggering forever. initialise all signals #228
    [gs4510.vhdl]
2020-06-03 more work trying to track down ghdl simulation/traceback problems #228
    [ghdl_bug.vhdl, machine.vhdl]
2020-06-03 prevent audio dmas from saturating the bus #228
    [gs4510.vhdl]
2020-06-03 allow reset to always break out of audio DMA #228
    [gs4510.vhdl]
2020-06-04 improve debug signals for audio dma #228
2020-06-04 make sure audio dma can happen when CPU at full speed #228
2020-06-04 enable audio dma during fast CPU mode #228
2020-06-04 fix floppy access timeout edge cases #228
    [sdcardio.vhdl]
2020-06-05 fix decrementing of audio dma block timeout #228
    [gs4510.vhdl]
2020-06-05 fix multiple driver #228
    [gs4510.vhdl]
2020-06-05 fix audio dma state machine logic bug #228
    [gs4510.vhdl]
2020-06-05 make audio dma writes run-time switchable #228
2020-06-05 more instrumenting disabling of audio dma writes #228
2020-06-05 work around GHDL bug with records #228
    [gs4510.vhdl]
2020-06-05 fix multiple drivers. #228
    [gs4510.vhdl]
2020-06-05 more multiple driver fixes #228
    [gs4510.vhdl]
2020-06-06 fix audio dma combinatorial/sequential separatin #228
    [gs4510.vhdl]
2020-06-06 fix many audio dma bugs #228
    [gs4510.vhdl]
2020-06-06 fix more bugs in audio dma scheduling #228
    [gs4510.vhdl]
2020-06-06 keep working on audio dma logic cleanup #228
2020-06-06 further work on fixing audio dma problems #228
    [gs4510.vhdl]
2020-06-06 finally get audio dma scheduling working #228
2020-06-06 direct plumb audio output from CPU dma engine to audio_complex #228
2020-06-06 remove audio dma test #228
2020-06-06 more plumbing to hook up the audio DMA output #228
2020-06-06 fix problem with audio dma channels getting stuck off #228
    [gs4510.vhdl]
2020-06-06 try to fix PC adjust when servicing audio DMA jobs #228
    [gs4510.vhdl, main.asm]
2020-06-06 make PC adjust runtime tweakable for audio dma #228
2020-06-06 document and improve PC adjust logic for audio DMA #228
2020-06-06 don't allow audio DMA in hypervisor mode. #228
2020-06-07 disable audio dma test #228
2020-06-07 fix audio DMA channels 1 - 3 #228
    [gs4510.vhdl]
2020-06-07 pull in updated HYPPO from unstable #228
    [dos.asm, main.asm]
2020-06-07 pull in hyppo improvements from unstable #228
    [constants.asm, process_descriptor.asm, syspart.asm]
2020-06-07 fix bug in dos_readfile() #228
    [dos.asm]
2020-06-07 fix 8-bit sample formats for audio dma #228
    [gs4510.vhdl]
2020-06-07 make sample signedness and cpu dma audio mixer bypass runtime selectable #228
2020-06-07 fix signed enable for 8-bit samples #228
    [gs4510.vhdl]
2020-06-07 allow run-time selection of PWM/PDM audio encoding #228
2020-06-07 disable audio DMA when freezing
2020-06-08 tighten up hardware reset #228
    [main.asm]
2020-06-08 add audio dma reflect debug registers #228
2020-06-08 rework audio DMA in CPU to use spare cycles #228
    [gs4510.vhdl]
2020-06-08 use all spare cycles for background DMA #228
2020-06-08 note when background DMA cycles occur #228
2020-06-08 more trying to fix background DMA #228
    [gs4510.vhdl]
2020-06-08 do background DMA whenever shadow ram bus is idle #228
2020-06-08 fix background DMA scheduling problems #228
    [gs4510.vhdl]
2020-06-08 try to fix bus jam #228
    [gs4510.vhdl]
2020-06-08 revert some things to try to get it working again #228
    [gs4510.vhdl]
2020-06-09 readd lost end-of-sample detection #228
2020-06-09 ... and sample looping #228
2020-06-09 fix repeating samples #228
    [gs4510.vhdl]
2020-06-09 fix audio dma signed sample select bit #228
    [gs4510.vhdl]
2020-06-09 fix audio dma channel mixing #228
    [gs4510.vhdl]
2020-06-09 rework all audio system to use signed samples #228
    [audio_complex.vhdl, audio_mixer.vhdl, cputypes.vhdl, debugtools.vhdl, gs4510.vhdl, i2s_transceiver.vhdl, iomapper.vhdl, machine.vhdl]
2020-06-09 fix mixing of signed audio sources #228
    [audio_mixer.vhdl]
2020-06-09 fix audio mixer calculation. #228
    [audio_mixer.vhdl]
2020-06-09 fix backgroound DMA ready detection #228
    [gs4510.vhdl]
2020-06-09 fix audio mixer with signed audio sources #228
    [audio_mixer.vhdl]
2020-06-09 more work on background DMA logic debugging #228
2020-06-09 fix latency for background DMA when code in shadow #228
    [gs4510.vhdl]
2020-06-09 improve background DMA latency #228
2020-06-09 disable DMA audio on reset #228
    [main.asm]
2020-06-09 stop CPU going crazy at low speed with background DMA #228
2020-06-10 fix audio dma channels 1-3 and vol calc #228
    [gs4510.vhdl]
2020-06-10 fix audio mixer volume application #228
    [audio_mixer.vhdl]
2020-06-10 improve audio dma channel status info for ch1-3 #228
2020-06-10 make audio saturation runtime switchable #228
2020-06-10 make it possible to switch audio dma left/right for debug #228
2020-06-10 fix freezing regression #228
    [task.asm]
2020-06-11 fix CPU hardware multiplier #228
    [gs4510.vhdl]
2020-06-12 fix OPL sample clock logic #232
    [opl2.v]
2020-06-12 add debug for OPL sample clock #232
2020-06-14 latch sample values for DMA audio to remove glitches #228
    [gs4510.vhdl]
2020-06-14 add pure sine wave generation for audio DMA #228
2020-06-14 advance DMA address during sinewave playback #228
2020-06-14 fix typo in sine table #228
    [gs4510.vhdl]
2020-06-21 fix latching of keyboard register values #238
    [c65uart.vhdl]
2020-06-23 make ADV HDMI reset run-time controllable
    [hdmi_i2c.vhdl]
2020-06-23 add more debugging for HDMI reset logic
    [hdmi_i2c.vhdl]
2020-06-24 work on fixing n4ddr-widget target
    [nexys4ddr-widget.vhdl, nexys4ddr-widget.xdc]
2020-06-24 begin working on support for wukong FPGA board
2020-06-24 plumb more dummy interfaces for wukong bare board
2020-06-24 more wukong board plumbing fixes
2020-06-24 more plumbing for wukong board
2020-06-24 get empty wukong board target synthesising
2020-06-24 more work on getting wukong board with 50MHz clock working
2020-06-25 begin importing direct DVI/HDMI output stuff for wukong board
2020-06-25 work towards getting hdmi output on wukong board
2020-06-25 plumb up hdmi audio feeder for wukong board
2020-06-25 make HDMI encoder options run-time switchable #138
2020-06-25 try to get serial uart interface working #138
2020-06-25 try swapping serial UART lines #138
    [wukong.xdc]
2020-06-25 try reenabling M65 core on wukong board #138
2020-06-26 more work trying to get HDMI output on Wukong board #138
2020-06-26 test phase of 135MHz inverted clock #138
    [clocking50mhz.vhdl, wukong.xdc]
2020-06-26 try inverting HDMI pairs #138
    [wukong.xdc]
2020-06-26 try another way to invert HDMI signals #138
    [wukong.xdc]
2020-06-29 implement nybl sample size #228
2020-06-29 implement panning support for audio DMA #228
2020-06-29 more trying to make wukong board HDMI work #138
2020-06-29 update audio DMA documentation #228
2020-06-29 tighten up joystick cartridge detection
    [expansion_port_controller.vhdl]
2020-07-05 correct extraction of slices in fast divider #248
    [fast_divide.vhdl]
2020-07-05 fix problems with divider plumbing #248
    [gs4510.vhdl]
2020-07-05 fix resetting of divider #248
    [gs4510.vhdl]
2020-07-05 fix divide by zero handling #248
    [fast_divide.vhdl]
2020-07-07 fix serial write hypervisor call
    [main.asm]
2020-07-10 sample vertically more often in PAL for thumbnail #206
2020-07-13 fix bugs in 16-bit hyperram access
    [hyperram.vhdl]
2020-07-13 add 2nd write side buffer for hyperram to avoid losing writes #165
    [hyperram.vhdl]
2020-07-13 fix various remaining hyperram caching things #165
    [hyperram.vhdl]
2020-07-16 begin importing Adam's HDMI driver #138
2020-07-16 fix thumbnail Y stepping coefficients #172
    [framepacker.vhdl]
2020-07-16 try to fix SD card pinout on Wukong board
    [wukong.xdc]
2020-07-16 fix audio clock generation for 50MHz input clock #138
    [audio_clock.vhdl]
2020-07-16 fix MMECME2 setup for digital audio clock. #138
    [audio_clock.vhdl]
2020-07-16 make keyboard inputs high by default on wukong board
2020-07-16 add timing exceptions for wukong board #138
2020-07-16 fix hyppo crash when D81 can't be mounted #250
    [main.asm]
2020-07-16 fix microSD pinout for wukong board
    [wukong.xdc]
2020-07-17 disable expansion port lines for wukong board which has no port #138
2020-07-17 fix cartridge enable/disable logic
    [gs4510.vhdl]
2020-07-17 convert HYPPO to use ACME assembler #260
2020-07-17 fix bugs during port to ACME #260
    [dos.asm]
2020-07-17 fix display of messages and util menu with ACME #260
    [main.asm]
2020-07-18 try slow slew and low drive strength in case problem is reflection #145
    [mega65r2.xdc]
2020-07-22 fix latex comment symbol escapes
    [c65uart.vhdl, gs4510.vhdl]
2020-08-01 add missing ; #264
    [sdcardio.vhdl]
2020-08-03 add extra drive stage on ether TX to prevent glitching #145
    [ethernet.vhdl]
2020-08-03 try to fix eth TX phase 3 #145
    [ethernet.vhdl]
2020-08-03 fix eth rx phase delay logic #145
    [ethernet.vhdl]
2020-08-03 fix writing high byte of eth RX info #145
    [ethernet.vhdl]
2020-08-03 try a BUFG on ether clock to fix errors #145
    [mega65r2.vhdl]
2020-08-03 remove old eth clock driver #145
2020-08-04 allow independently resetting ethernet PHY from state machine #145
    [ethernet.vhdl]
2020-08-04 try to improve ethernet TX soft reset #145
    [ethernet.vhdl]
2020-08-04 update XDC and part number for M65R3 board #265
2020-08-04 fix part number #265
    [mega65r3.xdc]
2020-08-04 add lots of missing plumbing signals #265
    [mega65r3.vhdl]
2020-08-04 more plumbing fixes #265
    [mega65r3.vhdl]
2020-08-04 fix signal name in XDC #265
    [mega65r3.xdc]
2020-08-05 fix plumbing issues #266
    [mega65r2.vhdl, mega65r2.xdc, mega65r3.vhdl]
2020-08-05 fix switch plumbing
2020-08-05 fix more plumbing #266
    [mega65r2.xdc, mega65r3.xdc]
2020-08-05 invert sw sense and support backwards compatible reset button for MAX10 link #266
    [mega65r2.vhdl, mega65r3.vhdl]
2020-08-06 invert sw14/15 sense for MEGA65 boards #266
    [machine.vhdl]
2020-08-06 reenable reset button in backwards compatibility mode #266
2020-08-06 fix M65R3 target #266
    [mega65r3.vhdl]
2020-08-06 don't allow selecting slots > 3 on A200T targets #268
2020-08-06 fix dip switch sense on M65R3 #266
    [mega65r3.vhdl]
2020-08-08 resolve multiple drivers for cartridge enable
    [gs4510.vhdl]
2020-08-08 enable cartridges on reset
    [main.asm]
2020-08-08 fix cartridges on R2 and R3 PCBs
    [main.asm]
2020-08-08 make LED on mainboard user controllable
2020-08-09 fix reloading of boot logo
    [main.asm]
2020-08-09 fix slot numbers and positions for R3 / A200T targets #266
2020-08-09 try to fix M65R3 internal speaker plumbing #266
    [mega65r3.vhdl, mega65r3.xdc]
2020-08-10 add audio amplifier to M65R3 I2C register map #266
2020-08-10 fix messed up generate statement #266
    [iomapper.vhdl, mega65r3_i2c.vhdl]
2020-08-10 fix overlapping cycle numbers #226
    [mega65r3_i2c.vhdl]
2020-08-10 fix mapping of I2C peripherals in M65R3 target #266
    [iomapper.vhdl]
2020-08-10 fix reading of M65R3 I2C audio amplifier #266
    [mega65r3_i2c.vhdl]
2020-08-11 fix visiblity of 2nd 128bytes of M65R3 I2C registers #266
    [mega65r3_i2c.vhdl]
2020-08-11 implement USE_LOCAL_GHDL, whitespace, #274
    a build option, the default is to download/build/use the submodule for ghdl.
    to use your locally installed ghdl, use "USE_LOCAL_GHDL=1"
    NOTE: that this patch is currently untested as I dont have ghdl installed,
    and when the Makefile attempts to compile ghdl, I get the error:
    ```
    Sorry, you need GNAT to build GHDL. See the README
    (gnatmake executable is: gnatmake)
    Makefile:142: recipe for target 'ghdl/build/bin/ghdl' failed
    make: *** [ghdl/build/bin/ghdl] Error 1
    ```
    so, the correctness of this patch is only inferred due to similarity to the USE_LOCAL_ACME
2020-08-11 fix more with M65R3 I2C setup #266
    [mega65r3_i2c.vhdl]
2020-08-11 fix digital video audio clocking #266
    [mega65r3.vhdl]
2020-08-11 fix mmcm warning #226
    [mega65r3.xdc]
2020-08-11 try to solve serdes incompatible clock problem #266
    [clocking.vhdl]
2020-08-12 don't wait forever for M65R3 I2C register writes #266
2020-08-12 fix bugs with Ocean cart emulation
    [gs4510.vhdl]
2020-08-13 fix old label #277
    [targetsetup.asm]
2020-08-13 add missing cputypes pullin #277
    [c65uart.vhdl]
2020-08-13 work on framework for accessible keyboard input #257
2020-08-13 fix synthesis errors #257
    [c65uart.vhdl, iomapper.vhdl, machine.vhdl, visual_keyboard.vhdl]
2020-08-13 honour accessible keyboard enable/disable flag and other fixes #257
    [accessible_keyboard.vhdl, c65uart.vhdl, iomapper.vhdl]
2020-08-13 hide selected row when selecting a column. fix out by 1. #257
    [accessible_keyboard.vhdl]
2020-08-13 try to make thumbnail frame reset more robust #206
    [framepacker.vhdl]
2020-08-13 fix silly error with instrumentation #206
    [framepacker.vhdl]
2020-08-13 hopefully fix PAL thumbnails once and for all #206
    [framepacker.vhdl]
2020-08-14 re-enable ocean cart stuff and fix ethernet 200mhz clock domain #266
    [gs4510.vhdl, mega65r2.xdc]
2020-08-15 try again to fix clock200 / ethclock / cpuclock async #266
    [mega65r2.xdc]
2020-08-15 also fix cross-domain in other direction #266
    [mega65r2.xdc]
2020-08-15 fix inverted IEC lines #266
    [mega65r3.vhdl]
2020-08-15 actually invert IEC line control for R3 #266
    [mega65r3.vhdl]
2020-08-15 fix more timing closure problems #266
    [mega65r3.xdc]
2020-08-15 try to flip IEC lines back to the right way around #266
    [mega65r3.vhdl]
2020-08-15 begin to plumb in SRQ line for R3 PCB #266
2020-08-15 try to fix M65R3 digital audio out #266
    [mega65r3.vhdl]
2020-08-15 fix multiple driver #266
    [machine.vhdl, mega65r3.xdc]
2020-08-15 re-invert CLK, DATA on R3 #266
    [mega65r3.vhdl]
2020-08-16 instrument CPU to track down timing problems #266
    [gs4510.vhdl, machine.vhdl, mega65r2.vhdl, mega65r3.vhdl]
2020-08-17 fix CPU frame/cycle counting bugs #266
    [gs4510.vhdl, machine.vhdl]
2020-08-17 count both PHI cycles and CPU usable cycles per frame #266
2020-08-17 correctly reset cycle counters #266
    [gs4510.vhdl]
2020-08-17 more fixing cycle counters #266
    [gs4510.vhdl]
2020-08-17 fix IEC signal driving logic for R3 PCB as well #266
    [mega65r3.vhdl]
2020-08-17 fix stupid typo #266
    [machine.vhdl]
2020-08-18 fix silly error #145
    [ethernet.vhdl]
2020-08-19 correctly unblock and use freed RX buffer when eth blockage is cleared #145
    [ethernet.vhdl]
2020-08-19 simplify eth reset control #145
    [ethernet.vhdl]
2020-08-19 more trying to fix eth rx buffer handling #145
    [ethernet.vhdl]
2020-08-19 avoid double-write problems to $D6E1 #145
    [ethernet.vhdl]
2020-08-20 use bufg on ethernet clocks to try to fix problems. #145
    [clocking.vhdl]
2020-08-20 switch $D6EF debug register function #145
2020-08-20 fix false paths for M65R2/R3 targets for ethernet #145
    [mega65r2.xdc, mega65r3.xdc]
2020-08-22 add missing file #266
    [audio_clock100.vhdl]
2020-08-22 insert ReadAbort phase for hyperram #280
2020-08-25 add missing keyboard firmware ID registers for N4ddr-widget #271
    [nexys4ddr-widget.vhdl]
2020-08-25 add missing IEC SRQ line plumbing for N4ddr-widget board
    [nexys4ddr-widget.vhdl]
2020-08-26 make sure eth packet length gets written to correct buffer #145
    [ethernet.vhdl]
2020-09-02 fix ASR A not setting C flag. #282
    [gs4510.vhdl]
2020-09-03 add missing signal #145
    [ethernet.vhdl]
2020-09-03 fix stupid error #145
    [ethernet.vhdl]
2020-09-04 cross-domain fix eth tx reset lines #145
    [ethernet.vhdl]
2020-09-04 try to fix eth rx frame length writing problem #145
    [ethernet.vhdl]
2020-09-04 finally fix the ethernet frame length recording bug? #145
    [ethernet.vhdl]
2020-09-11 add missing then #283
    [gs4510.vhdl]
2020-09-11 fix iec_bus_active plumbing bug #283
    [machine.vhdl]
2020-09-11 fix another plumbing bug #283
    [iomapper.vhdl]
2020-09-13 debug HDMI audio problems #138
    [mega65r3.vhdl]
2020-09-13 LED to debug 48KHz audio rate #138
2020-09-13 fix multiple driver #138
    [mega65r3.vhdl]
2020-09-16 fix bugs with DMAgic IO flag for copy
    [gs4510.vhdl]
2020-09-21 begin implementing DMA-assisted line drawing #290
2020-09-21 fix bugs in hardware line drawing DMA #290
    [gs4510.vhdl]
2020-09-21 fix bug with DMA line drawing #290
    [gs4510.vhdl]
2020-09-21 fix another typo and group security signal assignments together. #192
    [gs4510.vhdl]
2020-09-21 D81 mount should disable the real floppy for the drive selected. #192
    # src/hyppo/dos.asm
    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
2020-09-21 Try to skip unused close when doing hyppe attach d81. #192
    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
    [dos.asm]
2020-09-21 Partial revert. Fixed Hyppo Trap issues by save/resore $CE00-$CEFF while executing the traps. #192
    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
    [dos.asm]
2020-09-21 Fix the CPU speed assumption. #192
    # src/vhdl/gs4510.vhdl
    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
    [gs4510.vhdl]
2020-09-21 Updating F011 related registers to avoid conflict with new autotune register bits. #192
    # src/vhdl/sdcardio.vhdl
    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
    [sdcardio.vhdl]
2020-09-21 Fix wrong expression. #192
    [sdcardio.vhdl]
2020-09-21 import hard floppy timeout from unstable #217
    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
    [sdcardio.vhdl]
2020-09-21 $D689 bit 4 allows switching internal and external drives #217
    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
2020-09-21 fix read-back of selected drive #217
    [sdcardio.vhdl]
2020-09-21 Porting some fixes from the original #165 branch. #192
    [sdcardio.vhdl]
2020-09-21 Fixing virtual F011 write. #138
    [virtual_f011.asm]
2020-09-21 Revert "Debug F011 virtual write. #138"
    This reverts commit ef479aa6bfc4d8b7a17a7aeec980da4581603377.
    [virtual_f011.asm]
2020-09-22 plumb through 2nd drive motor and select #192 #138
2020-09-22 disable block reads in hyperram controller due to unresolved bug #165
    [hyperram.vhdl]
2020-09-24 make sprite pointer continuous monitoring run-time switchable #293
2020-09-25 fix clock162 signal name
    [megaphoner1.vhdl]
2020-09-28 fix version.sh script, mistake corrected, #291
    i used the branchname "origin/branchname" but this does not exist in repo.
    needed to use just "branchname"
    also removed a debug printline
2020-09-29 try to constrain hyperram IO pin delays #280
2020-09-29 more work on buffered uart refactor for 8 uarts #295
2020-09-29 fix plumbing for reworked buffereduart #295
    [iomapper.vhdl]
2020-09-29 more fixes for buffereduart rework for megaphone target #295
    [megaphoner1.vhdl]
2020-09-29 fix places still using 16 bit timer divisor for baud rate #295
    [monitor_ctrl.v]
2020-09-29 no debug uarts connected on megaphone r1/2 pcb #295
2020-09-29 further remote plumbing for modem debug uarts #295
2020-09-29 fix multiple driver #298
    [gs4510.vhdl]
2020-09-29 fix M65R3 target following buffered uart refactor #295
    [mega65r3.vhdl]
2020-09-29 begin adding test target for buffered uart #295
2020-09-29 add test file for buffered uart #295
2020-09-29 correctly mark buffers empty on power on #295
    [buffereduart.vhdl]
2020-09-29 reset buffers on reset. report internal state for simulation #295
    [buffereduart.vhdl]
2020-09-29 fix rx_byte_stale logic #295
    [buffereduart.vhdl]
2020-09-29 actually set UART divisors #295
2020-09-29 use correct UART pair for loopback testing #295
2020-09-29 add test case for receiving a byte into empty buffer #295
2020-09-29 fix RX buffer byte presentation when buffer WAS empty #295
    [buffereduart.vhdl]
2020-09-29 fix more bugs with serial buffer handling #295
    [buffereduart.vhdl]
2020-09-29 fix lowwater and highwater buffer flags #295
    [buffereduart.vhdl]
2020-09-29 fix more buffer memory access scheduling bugs #295
    [buffereduart.vhdl]
2020-09-29 fix presenting received byte on empty buffer #295
    [buffereduart.vhdl]
2020-09-29 switch BT RX/TX lines around the right way #295
2020-10-01 tweak UART debug output
2020-10-01 more work on testing buffered uart #295
2020-10-01 fix util menu with openrom
    [main.asm]
2020-10-02 fix some problems identified by HDMI protocol analyser #138
    [pixel_driver.vhdl]
2020-10-02 fix checksum in audio info frames #138
2020-10-02 fix scheduling of AVI info frames #138
2020-10-02 actually fix audio info frame checksum #138
2020-10-02 try to debug why analyser sees no PAL frames #138
2020-10-02 fix both VGA and HDMI HSYNC position #138
    [pixel_driver.vhdl]
2020-10-02 fix VSYNC position in PAL #138
    [pixel_driver.vhdl]
2020-10-02 disabled mangled GCP info frames on R2 #138
2020-10-03 try to implement SPD info frames #138
2020-10-03 disable 4 joystick cartridge by default to avoid risk of triggering C65 diag programme
    [expansion_port_controller.vhdl]
2020-10-03 improve SPD frames #138
2020-10-03 fix bug with joy cart disabling and debug
    [expansion_port_controller.vhdl]
2020-10-03 try to fix current_cache_line_update_flags dual clock
    [hyperram.vhdl]
2020-10-03 audio switchable between 48KHz and 44.1KHz. Fix Fs copy-pasta #138
    [audio_clock100.vhdl, c65uart.vhdl, mega65r3.vhdl]
2020-10-03 fix centring of VGA PAL display #138
    [pixel_driver.vhdl]
2020-10-03 fix typo in 48KHz default change #138
    [audio_clock100.vhdl]
2020-10-03 swap RX/TX lines for LoRa modules #295
    [megaphoner1.xdc]
2020-10-03 switch R2 to 48K audio sample rate #138
2020-10-04 try to fix R2 audio sample rate #138
    [spdif_encoder.vhdl]
2020-10-04 try to fix R2 HSYNC/VSYNC polarity #138
    [hdmi_i2c.vhdl]
2020-10-04 make meaningless change to try to stop triggering vivado bug #138
    [spdif_encoder.vhdl]
2020-10-04 swap RX/TX for modem bays #295
    [megaphoner1.xdc]
2020-10-04 try to fix ADV7511 audio N/CTS ratio to sample rate #138
    [hdmi_i2c.vhdl, spdif_encoder.vhdl]
2020-10-04 invert HDMI VSYNC on R2 #138
    [mega65r2.vhdl]
2020-10-05 swap PCM OUT/IN lines for m.2 bays #295
    [megaphoner1.xdc]
2020-10-07 stop endless uart retrigger when RX low #295
2020-10-07 add Hyperram pin timing constraints to M65R3 target #165
2020-10-08 switch Modem bay 2 PCM TX/RX lines #295
2020-10-08 plumb floppy LED and IR led #295
2020-10-09 try to fix I2C read glitching #295
    [i2c_wrapper.vhdl]
2020-10-09 count number of read loops, so we can know when its safe to read I2C #295
2020-10-23 allow raster interrupts based on X position
2020-11-19 drop I2S clock to avoid clock jitter #305
    [i2s_clock.vhdl]
2020-11-28 work around MMCM placement problem on N4
    [nexys4.xdc]
2020-11-28 fix target ID of N4 board
    [nexys4.vhdl]
2020-11-30 make raster rewrite double buffering switchable #312
2020-12-01 fix drive select logic #307
    [sdcardio.vhdl]
2020-12-01 don't mount D81 image when configured to use internal drive #307
2020-12-12 hook up EDID I2C bus for digital video port
2020-12-12 fix mapping of EDID block on R3 target
    [edid_i2c.vhdl, iomapper.vhdl]
2020-12-13 fix signal name #317
    [mega65r3.vhdl]
2020-12-13 try to fix mother board dip switch setting DVI/DVI+audio mode #317
    [mega65r3.vhdl, sdcardio.vhdl]
2020-12-13 plumb MAX10 FPGA revision through, fix FPGA_DONE pin control to MAX10 etc #317
    [c65uart.vhdl, iomapper.vhdl, machine.vhdl, mega65r3.vhdl]
2020-12-13 rework MAX10 communications protocol to use only 3 lines #317
    [mega65r3.vhdl]
2020-12-13 fix pixelclock name #317
    [mega65r3.vhdl]
2020-12-13 support old MAX10 bitstreams that drive reset line simply #317
    [mega65r3.vhdl]
2020-12-14 fix problems with new MAX10 protocol running with old MAX10 #317
    [mega65r3.vhdl]
2020-12-14 improve handling of legacy mode MAX10 reset #317
    [mega65r3.vhdl]
2020-12-14 fix MAX10 sync interval #317
    [mega65r3.vhdl]
2020-12-14 fix problems with MAX10 communications protocol #317
    [mega65r3.vhdl, sdcardio.vhdl]
2020-12-14 fix syntax error #317
    [mega65r3.vhdl]
2020-12-14 fix multiple driver #317
    [mega65r3.vhdl]
2020-12-18 use buffered UART receiver for serial monitor interface #7
2020-12-18 add uart_rx_buffered.vhdl to projects #7
2020-12-18 add verilog wrapper fir uart_rx_buffered.vhdl #7
2020-12-18 use uart_rx_buffered instead of uart_rx #7
2020-12-18 fix bugs in buffered uart rx #7
2020-12-18 fix problems with MAX10 communications #317
    [mega65r3.vhdl]
2020-12-18 work around possible vivado bug causing max10 cpuclock to not tick #317
    [mega65r3.vhdl]
2020-12-19 fix buffered UART read address #7
2020-12-19 revert mega65r3 top level to before MAX10 new protocol to get back to working digital video #317
    [mega65r3.vhdl]
2020-12-19 try to fix no HDMI output problem again #317
    [mega65r3.vhdl]
2020-12-19 invert DONE signal disable signal #317
    [mega65r3.vhdl]
2020-12-19 fix errors with refactored max10 protocol module #317
    [max10.vhdl, mega65r3.vhdl]
2020-12-19 fix synthesis errors #317
    [max10.vhdl, mega65r3.vhdl]
2020-12-19 fix plumbing bug for max10 module #317
    [max10.vhdl]
2020-12-19 correct register description #317
    [sdcardio.vhdl]
2020-12-19 fix max10 protocol vector length #317
    [max10.vhdl]
2020-12-19 reconnect max10 reset button logic #317
2020-12-20 make reset line from max10 readable #317
    [iomapper.vhdl, machine.vhdl, max10.vhdl, mega65r3.vhdl, sdcardio.vhdl]
2020-12-20 debug capture of reset line #317
    [max10.vhdl]
2020-12-20 fix fall-back to old max10 protocol #317
    [max10.vhdl]
2020-12-20 deglitch reset from max10 #317
    [max10.vhdl]
2020-12-20 reconnect reset by default #317
    [mega65r3.vhdl]
2020-12-22 fix inverted DVI select signal #317
    [mega65r3.vhdl]
2020-12-22 allow y_chargen_start to be relocated mid-frame #326
2020-12-26 switch pins around to match new MAX10 programme with better backwards compatibility #317
2020-12-26 swap max10_tx/rx lines #317
    [max10.vhdl, mega65r2.vhdl, mega65r3.vhdl]
2020-12-27 implement HELP to reset video mode in on-boarding #329
    [onboard.c]
2020-12-27 fix formatting of function key hints in onboard.c #329
    [onboard.c]
2020-12-27 fix clearing onboarding flag #329
    [onboard.c]
2021-01-04 fix length of dirent struct to include attribute byte #333
    [main.asm]
2021-01-04 make dirent length calculation fail-safe #333
    [main.asm]
2021-01-04 fix trimming of FAT file names #333
    [dos.asm]
2021-01-04 fix dos_closeall() to actually clear the file descriptors #333
    [dos.asm]
2021-01-04 fix trimming of . from end of filenames #333
    [dos.asm]
2021-01-06 fix LDZ $nnnn opcode $AB
    [gen_dis.c]
2021-01-07 fix cd .. when cluster in .. entry is 0 for root dir
    [dos.asm]
2021-01-08 add missing auto-doc for some F011 registers
    [sdcardio.vhdl]
2021-01-10 put main board LED back under software control
2021-01-13 floppy error LED blinks red, but motor stays green #335
    [mega65kbd_to_matrix.vhdl]
2021-01-18 fix alternate palette selection to go through RRB as it should #342
    [bitplanes.vhdl, sdcardio.vhdl]
2021-01-22 Adding blink led - define CLK_IN as IN
2021-01-22 Blink led on pixelclock
2021-01-23 Fixing signals - blink on v_hdmi_hsync
    [megaphoner4.vhdl, megaphoner4.xdc]
2021-01-24 fix DMA audio documentation
    [gs4510.vhdl]
2021-01-30 try to fix CRT emulation
    [pal_simulation.vhdl]
2021-02-01 pause DMA for pending audio DMA fetches #228
2021-02-01 fix handling of $D054 on exit from HYPPO
    [main.asm, task.asm]
2021-02-01 fix handling of CRT emulation mode in HYPPO
    [main.asm, syspart.asm, task.asm]
2021-02-01 fix sense of signal for audio enable in onboard.c
    [onboard.c]
2021-02-08 delay writes to $DD00 to correct cycle as for 6502 @ ~1MHz #341
    [cia6526.vhdl, gs4510.vhdl, iomapper.vhdl, machine.vhdl]
2021-02-08 fix error in dd00 delay logic #341
    [cia6526.vhdl]
2021-02-22 Update megaphoner4.xdc
    Current pinout
2021-02-23 update pin out for MphR4 board #366
2021-02-23 use LVDS not TMDS33 on TE0725 that has 1.8V VCC_AUX #366
2021-02-23 more trying to fix MphR4 differential signalling #366
    [megaphoner4.xdc]
2021-02-23 get 1.8v differential signalling working #366
2021-02-28 begin implementing unbuffered track write #230
2021-02-28 fix generation of MFM bit sequence #230
    [mfm_bits_to_gaps.vhdl]
2021-02-28 fix problems with MFM encoding test bed #230
    [mfm_bits_to_gaps.vhdl]
2021-02-28 fix problems in mfm encoding test bed #230
    [mfm_bits_to_gaps.vhdl]
2021-02-28 get MFM encoding test bed producing MFM bit stream #230
2021-02-28 work towards plumbing MFM encoder to decoder #230
2021-02-28 fix MFM encoding error. Now generates correct MFM bitstream #230
    [mfm_bits_to_gaps.vhdl]
2021-03-01 hook up MFM encoder to unbuffered format #230
2021-03-01 add missing then keyword
    [mega65r3.vhdl]
2021-03-01 fix multiple driver, begin hooking up sector write to real drives #230
    [sdcardio.vhdl]
2021-03-01 make IEC bus CPU speed clamp run-time selectable
2021-03-14 copy hyperram timing constraints from R3 board #165
2021-03-16 fix american english use in auto documentation comments
    [sdcardio.vhdl]
2021-03-31 try to fix hyperram fast command mode
    [hyperram.vhdl]
2021-03-31 revert back to fast_cmd off for hyperram by default
    [hyperram.vhdl]
2021-04-25 debug ethernet frame rx handling logic
2021-04-25 try fixing eth buffer mishandling
    [ethernet.vhdl]
2021-04-27 split ADQ execute stage in two for better timing closure
2021-04-27 fix more Q instructions
    [gs4510.vhdl]
2021-05-01 work on fixing Q instructions #378
    [gs4510.vhdl]
2021-05-12 Added keyboard extended scancodes to fix issue: Some USB / PS/2 Keyboards use different scancodes #384
    [ps2_to_matrix.vhdl]
2021-05-13 Added support for right shift key via extended scancode to fix issue: https://github.com/MEGA65/mega65-core/issues/384
    [ps2_to_matrix.vhdl]
2021-05-13 begin working on simple HDMI output test for R3 boards
2021-05-26 fix logic error in WGATE handling #230
    [sdcardio.vhdl]
2021-05-29 add debug counters for format track activity #230
2021-06-05 fix floppy format state machine lock-up #230
    [sdcardio.vhdl]
2021-06-05 emulate floppy index hole in simulation #230
2021-06-06 improve debug output for floppy track formatting #230
2021-06-06 fix 0-9 to select alternate roms #395
    [main.asm]
2021-06-06 fix floppy format state machine bugs #230
    [mfm_bits_to_gaps.vhdl, sdcardio.vhdl]
2021-06-14 allow DMA line mode for copy mode, and for both src and dst addr via option codes #401
2021-06-20 fix $D6AC SYNC flag #230
    [mfm_decoder.vhdl]
2021-06-22 make FDC unbuffered track formatting bug compatible with C65 F011 #230
    [crc1581.vhdl, mfm_bits_to_gaps.vhdl, mfm_decoder.vhdl]
2021-06-22 fix F011 bug-compatible delayed latching of clock byte #230
    [mfm_bits_to_gaps.vhdl]
2021-06-26 fix floppy byte latching logic for track formatting #230
    [mfm_bits_to_gaps.vhdl, sdcardio.vhdl]
2021-06-26 set F011 busy flag during track formats #230
2021-06-26 debounce floppy index hole sensor #230
2021-06-26 fix f_index line monitoring #230
    [sdcardio.vhdl]
2021-06-27 fix typo in mfm_decode #230
    [mfm_decoder.vhdl]
2021-06-27 cover missing cases in select #230
    [sdcardio.vhdl]
2021-07-07 #352: MEGAFLASH: Make use of a new 'model_id' field within core header to assess suitability of .cor file chosen for flashing (#413)
    * #352: Removed superfluous field that nobody seemed to care about from version string
    called: 'number of commits since branching from branch "ghdl-crash-20200604"'
    * #352: Moving to newer version of openroms that has d81 image loading support
    * #352: fixed up compiler warnings in megaflash
    - replaced $(warning) lines in Makefile with $(info) instead
    * #352: added some debug niceties
    * #352: changes to megaflash to assess model-id field
    * #352: Added in TheChief's patch for fixing the slot0 flash backdoor
    - Cleaned up the indentation across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
    [main.asm]
2021-07-18 switch SD card bus for N4DDR target so configure writes to correct place #422
    [nexys4ddr-widget.vhdl]
2021-07-22 Add HYPPO call to fetch block descriptor into task space, the structure hold image file name of mount for drive 0 and 1. #425
2021-07-27 #422: Saving CONFIGURE settings under nexys (#428)
    * - If all the submodule-update-init stuff is getting on your nerves, you can now use "make DO_SMU=0 <targetname>", or add an "export DO_SMU=0" into your ~/.bashrc file.
    - Added a few extra args to the compilation of mega65_config to help me debug in m65dbg with the outputted vice label file (mega65_config.lbl).
    * #422: Reverting commit #ba08a4ea58984d61c42b202b9708387e95585df7
    * #422: reverted 1b268acbf324e62ca263c416e4402646d7af4835
    * #422: Add workaround for nexys4 boards to use sd-card bus 0 for writing the config data
    * #422: Try setting interrupt-disable flag and adding a delay, to see if it helps nexys4 boards
    [main.asm, nexys4ddr-widget.vhdl]
2021-08-05 fix palette for banner on first boot #430
    [main.asm]
2021-08-10 de-glitch gap_valid #230
2021-08-10 fix "only reads end of a sector" bug #230
    [sdcardio.vhdl]
2021-08-10 fix double-stepping through bytes when writing sectors to floppy #230
    [sdcardio.vhdl]
2021-08-10 fix stuck at start of sector write bug #230
    [sdcardio.vhdl]
2021-08-11 fix bugs in sector write CRC calculation #230
    [sdcardio.vhdl]
2021-08-11 fix more sector writing CRC calculation errors #230
    [sdcardio.vhdl]
2021-08-12 remove autotune for FDC as it causes problems during formatting #230
    [sdcardio.vhdl]
2021-08-13 reimplement auto track stepping for sector ops only #230
2021-08-14 Fix problems mounting 'MHZ.D81' (#431)
    * Fixed a problem with mounting 'MHZ.D81'. Seemed to be unhappy with the letter 'Z' :)
    [sdfat.asm]
2021-08-15 fix floppy write immediate RNF logic #230
    [sdcardio.vhdl]
2021-08-15 fix another real floppy RNF logic error #230
    [sdcardio.vhdl]
2021-08-16 fix issue 200 in mega65-user-guide
    [c65uart.vhdl]
2021-08-23 don't charge for branches taken at 3.5MHz+ #436
2021-08-23 fix consistency of reading D81 write-protect flags #435
    [sdcardio.vhdl]
2021-08-23 fix writeprotect handling of drive 0 #435
    [dos.asm]
2021-08-24 fix 45GS02 cycle counts for BIT instructions and JSR #436
    [gs4510.vhdl]
2021-08-24 fix race condition and add extra byte buffer for format #436
    [mfm_bits_to_gaps.vhdl]
2021-08-25 fix stashing of MFM byte clock bits #436
    [mfm_bits_to_gaps.vhdl]
2021-08-25 fix assembly of MFM bytes for writing #436
    [mfm_bits_to_gaps.vhdl]
2021-08-26 possible fix for #432
    [bitplanes.vhdl]
2021-08-29 revert to DD on reset #438
    [sdcardio.vhdl]
2021-08-30 potential fix for loading of deleted '?ICKUP.M65' file (#440)
    [dos.asm]
2021-09-05 fix typo messing up #439
    [dos.asm]
2021-09-05 fix bugs in track auto-formatter #438
    [sdcardio.vhdl]
2021-09-05 fix more CRC bugs in track auto-formatter #438
    [sdcardio.vhdl]
2021-09-05 fix header crc of subsequent sectors #438
    [sdcardio.vhdl]
2021-09-05 fix bug formatting tracks without sector gaps #438
    [sdcardio.vhdl]
2021-09-09 fix bugs with write precomp logic #438
    [mfm_bits_to_gaps.vhdl]
2021-09-10 fix no gaps bit select, set default write precomp #438
    [sdcardio.vhdl]
2021-09-10 implement and use track info blocks, longer track-lead-in #438
2021-09-11 fix wrong clock byte for track info header #438
    [sdcardio.vhdl]
2021-09-11 fix more bugs with track info block writing #438
    [sdcardio.vhdl]
2021-09-11 check CRC of track info block #438
2021-09-11 fix bug with port track info block transition #438
    [sdcardio.vhdl]
2021-09-11 fix missing signal #438
    [sdcardio.vhdl]
2021-09-11 add sector count to Track Info Block #438
2021-09-12 Quick attempt to fix a problem with megaflash's 'erase slot' option
2021-09-15 spotted an edge-case bug in megaflash
2021-09-17 Fix to make saving of CONFIGURE settings to SD card bus 0 at NEXYS boards work. (#445)
    Related to issue #422.
2021-10-17 fix adcq carry (not neg) and bp-ind-z-idx Z adding
    [gs4510.vhdl]
2021-11-01 Squashed commit of the following:
    commit 8e7fbda0d8750e7e877ffd211b445e230b33471e
    Author: Gurce Isikyildiz <Gurce.Isikyildiz@resmed.com.au>
    Date: Mon Nov 1 22:50:22 2021 +1100
    Tweaks to positioning/spacing/wording of onboarding text
    - based on feedback from from Maurice on this github ticket:
    https://github.com/MEGA65/mega65-user-guide/issues/332
    ...and follow-on convo in discord:
    https://discord.com/channels/719326990221574164/805492126128930846/904687341707362314
    [onboard.c]
2021-11-02 fix BITQ N and V flags
    [gs4510.vhdl]
2021-11-03 attempt to fix #465
    [iomapper.vhdl]
2021-11-03 fix overflow in $D610 key buffer #465
    [iomapper.vhdl]
2021-11-03 fix LSRQ deadlock, fix flags of Q shifting opcodes
    [gs4510.vhdl]
2021-11-19 version where bitstream is generated, old stuff still works, but Qops still fail
    [gs4510.vhdl, main.asm]
2021-11-20 fixed timing for nexys4ddr and mega65r3 targets (no additional violations)
    [debugtests.asm, gs4510.vhdl]
2021-12-20 Try a fix by always reading the next line data.
    [bitplanes.vhdl]
2021-12-20 Try to fix the fine grain offset when rendering high rest bitplanes.
    [bitplanes.vhdl]
2021-12-21 Trying to fix fine line offset adjustments.
    [bitplanes.vhdl]
2021-12-21 Testing switching interlaces lines.
2021-12-30 fixes #502 Q-Op BP-ind-Z-idx msbs extra simulate-gcc-build target, add all .asm to hyppo deps fix src/hyppo/constants.asm access mode
    [constants.asm, gs4510.vhdl]
2022-01-01 debug RLL encoder byte ingestion #442
2022-01-01 fix more RLL encoder byte ingestion bugs #442
    [rll27_bits_to_gaps.vhdl]
2022-01-01 fix RLL sync mark and 10 bit sequence encoding #442
    [rll27_bits_to_gaps.vhdl]
2022-01-01 fix RLL/MFM decoder selection #442
    [mfm_decoder.vhdl]
2022-01-01 fix RLL gap quantising bug #442
    [rll27_quantise_gaps.vhdl]
2022-01-01 fix truncated track lead-in #442
    [sdcardio.vhdl]
2022-01-01 fix latching of bytes in RLL encoder #442
    [rll27_bits_to_gaps.vhdl]
2022-01-01 switch to MFM during TIB write #442
2022-01-01 fix various bugs with TIB / RLL encoding #442
    [sdcardio.vhdl]
2022-01-01 fix senstivity on MFM/RLL decode selection #442
    [mfm_decoder.vhdl]
2022-01-01 more sensitivity list fixes #442
    [sdcardio.vhdl]
2022-01-01 fix DxWP flag descriptions
    [sdcardio.vhdl]
2022-01-01 fix sid_filters for external shared filter table memory #447
2022-01-01 fix signal name for 8580 1MHz clock #447
    [sid_6581.vhdl]
2022-01-01 allow simultaneous reset+feed to crc #442
    [crc1581.vhdl]
2022-01-01 reenable RLL/MFM encoding switch #442
2022-01-01 more plumbing fixes for 8580 #447
    [sid_6581.vhdl]
2022-01-01 more 8580 SID plumbing fixes #447
    [sid_6581.vhdl]
2022-01-01 fix CRC calc when formatting sector bodies #442
    [sdcardio.vhdl]
2022-01-01 fix missing plumbing for TIB sector count #442
    [sdcardio.vhdl]
2022-01-01 fix timing error when writing to real floppies #442
    [mfm_bits_to_gaps.vhdl, rll27_bits_to_gaps.vhdl]
2022-01-01 implement DMA-assisted reading of floppy flux #442
2022-01-01 add missing DMA floppy wait to FSM list #442
    [gs4510.vhdl]
2022-01-01 fix floppy gap width mismatch #442
    [sdcardio.vhdl]
2022-01-01 remove constant drivers for verilog included SID voices #447
2022-01-01 implement $D706 for MAPped DMA lists #454
2022-01-01 Dropping in @M3wP's latest copy of 'mega65_config.s'
    (The previous one got screwed up by Git)
2022-01-01 try to fix/work around $FFs in floppy DMA read bug #442
    [gs4510.vhdl]
2022-01-01 begin implementing cell calculator and test bed
2022-01-01 allow >64KB DMA for reading whole tracks via DMA #442
2022-01-01 try to fix floppy read DMAs #442
    [gs4510.vhdl, machine.vhdl]
2022-01-01 try to fix TIB CRC error #442
    [sdcardio.vhdl]
2022-01-01 allow dma-driven raw floppy flux writing #442
2022-01-01 fix doc comments #442
    [sdcardio.vhdl]
2022-01-01 revert CPU DMA floppy writing ability #442
    [machine.vhdl]
2022-01-01 add timeout for CPU DMA floppy reading #442
2022-01-01 add missing brackets
2022-01-01 allow dipsw4 to select between slot1 or 2 on boot #443
2022-01-01 find and fix bug with hardware QSPI reading #464
    [ghdl_8580_voice_stub.vhdl, sdcardio.vhdl]
2022-01-01 implement QSPI SPI write hardware support #464
2022-01-01 fix bug with SPI write acceleration #464
    [sdcardio.vhdl]
2022-01-01 re-enable user warning for flashing slot 0 #464
2022-01-01 release SD from reset before using hardware SPI #464
2022-01-01 fix dipswitch interlock #464
    [main.asm]
2022-01-01 fix logic error #464
    [main.asm]
2022-01-01 try to fix #470
    [sdcardio.vhdl]
2022-01-01 more fixing disk image writing #470
    [sdcardio.vhdl]
2022-01-01 fix bug with write-enable of D65 images #470
    [dos.asm]
2022-01-01 fix setting mega floppy flag for 2nd drive #470
    [dos.asm]
2022-01-01 fix driving of QSPI data bit #464
    [sdcardio.vhdl]
2022-01-01 add missing state labels for QSPI4 writes #464
    [sdcardio.vhdl]
2022-01-01 try to de-glitch QSPI lines #464
    [sdcardio.vhdl]
2022-01-01 try to fix qspi tristate logic #464
    [iomapper.vhdl, machine.vhdl, mega65r3.vhdl, sdcardio.vhdl]
2022-01-01 fix read-back of QSPIDB tristate #464
    [sdcardio.vhdl]
2022-01-01 fix stupid error #464
    [mega65r3.vhdl]
2022-01-01 begin adapting to new SPI interface #464
2022-01-01 QSPI clk glitches if written via $D6CC, but not $D6CD !?!? #464
    [sdcardio.vhdl]
2022-01-01 fix qspi write incorrect command byte #464
    [sdcardio.vhdl]
2022-01-01 fix order of declarations #464
    [sdcardio.vhdl]
2022-01-01 fix state name #464
    [sdcardio.vhdl]
2022-01-01 work on generalised hardware accelerated SPI #464
2022-01-01 fix bug in hw accel SPI sector read, work on sector write #464
    [sdcardio.vhdl]
2022-01-01 fix hw qpsi page write OE/tristate bug. implement sector erase #464
    [sdcardio.vhdl]
2022-01-01 fix QSPI write OE bug #464
    [sdcardio.vhdl]
2022-01-01 fix problems with QSPI sector erase commands #464
    [sdcardio.vhdl]
2022-01-01 fix hw qspi page write bug #464
    [sdcardio.vhdl]
2022-01-01 implement SPI WREN command, tweak CS release logic #464
2022-01-01 use more SPI hardware acceleration calls #464
2022-01-01 implement more SPI hardware acceleration #464
2022-01-01 add SPI hw fetch of CFI block #464
2022-01-01 fix error following sending of SetCR1 command #464
    [sdcardio.vhdl]
2022-01-01 skip dummy bytes for page program #464
    [sdcardio.vhdl]
2022-01-01 fix missing clock tick during program writes #464
    [sdcardio.vhdl]
2022-01-01 fix bugs with $6C write 16 bytes command #464
    [sdcardio.vhdl]
2022-01-01 make $D6CE combined qspi data + clock reg for DMA-driven tests #464
2022-01-01 instrument reset sources #474
    [c65uart.vhdl, iomapper.vhdl, machine.vhdl]
2022-01-01 fix $6B = SPI read CFI block #464
    [sdcardio.vhdl]
2022-01-01 add missing signal def #474
    [c65uart.vhdl]
2022-01-01 fix phase of SPI reading #464
    [sdcardio.vhdl]
2022-01-01 fix missed clock tick with $9F command #464
    [sdcardio.vhdl]
2022-01-01 fix release of send cmd byte only #464
    [sdcardio.vhdl]
2022-01-01 deglitch reset signals #474
    [machine.vhdl]
2022-01-01 more monitor interface reset deglitch #474
    [machine.vhdl]
2022-01-01 remove remaining SPI conditional code #464
2022-01-01 fix speed reports for slots >0 #464
2022-01-01 fix restoration of $d651 during unfreeze #477
    [constants.asm, freeze.asm, syspart.asm]
2022-01-01 ensure no half-finished commands post QSPI probe #464
2022-01-01 debug why flash menu not loading slot #464
2022-01-01 fix inverted sense of dip switch 4 for slot 1/slot 2 boot #464
2022-01-01 fix flashing on R3A boards that work #464
2022-01-01 fix monitor reset #474
    [machine.vhdl]
2022-01-01 debug flash problem with R3A board #464
2022-01-01 Restore X before using it in dos_selectdrive and dos_cdroot.
    Fixes #478.
    [dos.asm]
2022-01-01 Clear the correct file descriptor entry in dos_get_free_descriptor.
    [dos.asm]
2022-01-01 Close the correct file descriptor entry in trap_dos_closefile.
    [dos.asm]
2022-01-01 Have trap_dos_geterrorcode return error code of prior trap_dos_setname.
    Neither hypervisor_setup_copy_region nor dos_setname set dos_error_code. They both just return the error code in A.
    [dos.asm]
2022-01-01 Signal if trap_dos_cdrootdir fails.
    When the SD card partition in X does not exist, clear the C flag.
    [dos.asm]
2022-01-01 Don't leak a file descriptor in dos_chdir.
    [dos.asm]
2022-01-01 Don't switch partition if dos_chdir leads to the root directory.
2022-01-01 more work on hypervisor test framework #492
2022-01-01 Fix synthesis for nexys4ddr-widget #464
    [nexys4ddr-widget.vhdl]
2022-01-01 fix "cannot CHDIR to /" error
    [dos.asm]
2022-01-01 KickAss is no longer used by core, removing old version #157
    [KickAss.cfg]
2022-01-01 fix loading of low address #497
    [gs4510.vhdl]
2022-01-01 refactor partition cdroot error handling #497
    [dos.asm, main.asm]
2022-01-01 fix for hickup problem found in #497, plus dos_findfirst/next cleanup
    [dos.asm, gs4510.vhdl, main.asm]
2022-01-01 track stack pushes and analyse when RTSing #492
2022-01-01 work towards implementing DMA #492
2022-01-01 begin implementing DMA address calc #492
2022-01-01 add DMA src addr calculation #492
2022-01-01 implement DMA copy and fill #492
2022-01-01 allow chained DMA requests #492
2022-01-01 update symbol lists following DMA operations #492
2022-01-01 fix DMA address calculation bugs #492
2022-01-01 try to avoid glitching on floppy write #472
    [sdcardio.vhdl]
2022-01-01 avoid inference of flip-flop on f_wdata #472
    [sdcardio.vhdl]
2022-01-01 buffer RDATA to try to reduce read glitching #472
    [sdcardio.vhdl]
2022-01-01 de-bounce F_RDATA #472
2022-01-01 Disable CPU raw floppy flux writing to try to track down F_WRITE glitch #472
    [machine.vhdl]
2022-01-01 add debug to check for wdata glitches #472
    [machine.vhdl, mfm_bits_to_gaps.vhdl, sdcardio.vhdl]
2022-01-01 fix selection of unbuffered formatting #472
    [sdcardio.vhdl]
2022-01-01 Try to fix mega65r2 setup after merge of hwsc branch.
    [mega65r2.vhdl]
2022-01-01 Fixing QSPI issue for nexys4 as well, as result of merging hwsc.
    [nexys4.vhdl]
2022-01-01 invert sense of head select bit #509
    [sdcardio.vhdl]
2022-01-01 Revert "invert sense of head select bit #509"
    This reverts commit 4198035899e21097f3907e29f00e6f34f33bf5b4.
    [sdcardio.vhdl]
2022-01-02 correctly plumb 8580 SID voices #447
    [sid_6581.vhdl]
2022-01-02 fix CRITICAL WARNINGs during synth #447
    [c65uart.vhdl, gs4510.vhdl, sid_6581.vhdl]
2022-01-02 fix plumbing typo #447
    [sid_6581.vhdl]
2022-01-02 fix more multiple-driver critical warnings while debugging #447
    [c65uart.vhdl, gs4510.vhdl]
2022-01-02 Fix clock frequency to 8580 #447
    [sid_6581.vhdl]
2022-01-02 Fix synth error for #477
    [sid_6581.vhdl]
2022-01-02 fix 8580 silence #447
    [sid_voice_8580.v]
2022-01-02 fix max slot # display
2022-01-04 fix various problems with audio DC offset subtraction #512
    [audio_mixer.vhdl]
2022-01-04 fix some audio DC tracking bugs #512
    [audio_mixer.vhdl, cputypes.vhdl]
2022-01-04 fix failing audio DC offset tracking bug #512
    [audio_mixer.vhdl]
2022-01-05 more work on audio DC offset correction #512
    [audio_mixer.vhdl, cputypes.vhdl]
2022-01-05 improve timing closure following fixing clocks #516
    [ethernet.vhdl, mega65r3.vhdl]
2022-01-05 fix multiple driver #516
    [ethernet.vhdl]
2022-01-05 fix signed value processing #512
    [audio_mixer.vhdl]
2022-01-05 switch to Antti-style serialiser #516
2022-01-05 fix timing issues by splitting output add step #505
    [fast_divide.vhdl]
2022-01-05 fix silly errors #516
    [serialiser_10to1_selectio.vhdl]
2022-01-06 require 8 cycles of RESET low from serial monitor #474
    [machine.vhdl]
2022-01-06 spontaneous reset still happens. Increase thres to 16 cycles #474
    [machine.vhdl, monitor_ctrl.v]
2022-01-06 correct XDC cross-clock domain descriptions for new clock names #516
    [mega65r3.xdc]
2022-01-06 different drive LED colours for flop0,1 and SD. Silent SD option #518
2022-01-06 add missing decl #518
    [sdcardio.vhdl]
2022-01-06 fix more missing decls #518
    [machine.vhdl]
2022-01-07 fix verify address for slot >0 #516
2022-01-07 fix audiomixer settings in onboarding
    [onboard.c]
2022-01-07 fix reading dc_offset_enable from $d63c #512
    [c65uart.vhdl]
2022-01-07 fix erasing of slots #516
2022-01-07 don't clamp audio when dc_offset tracking is disabled #516
2022-01-07 fix message after flashing/erasing a slot. #516
2022-01-07 further instrument spontaneous reset #474
    [c65uart.vhdl, iomapper.vhdl, machine.vhdl]
2022-01-07 add missing ; #516
    [audio_mixer.vhdl]
2022-01-07 make sure every last scrap of dc offset track can be disabled #516
2022-01-07 add missing decl #474
    [iomapper.vhdl]
2022-01-08 more hunting spurious resets #474
    [machine.vhdl, monitor_ctrl.v]
2022-01-08 rework uart monitor reset logic #474
    [monitor_ctrl.v]
2022-01-08 deglitch CPU reset button #474
2022-01-08 more mega65r2 target fixes.
    [mega65r2.vhdl]
2022-01-08 More fixes for nexys4ddr-widget target.
    [nexys4ddr-widget.vhdl]
2022-01-18 Revert "DEBUG BUILD WITH DIPSW3 TEST DISABLED -- DO NOT KEEP"
    This reverts commit cbd91e507659b006c60918889b5411430dc27a69.
    [sdcardio.vhdl]
2022-01-18 fix various minor problems #447
    [sid_6581.vhdl, sid_voice_8580.v]
2022-01-22 add DMA mode to directly sample SID at 44.1KHz for debug #447
2022-01-25 use new regatbel doc format to make legends shorter
    [ethernet.vhdl, gs4510.vhdl, sdcardio.vhdl]
2022-02-05 fixing regtable docstrings for CIAs
    [cia6526.vhdl]
2022-02-13 fix 32bit ptr next op bug #535
    [gs4510.vhdl]
2022-04-15 attempt to suppress dog-leg at start of DMA drawn lines #401
2022-04-15 skip first 2 instead of 1 pixels when line drawing #401
    [gs4510.vhdl]
2022-04-15 fix stupid typo causing skip pixels to be infinite #401
    [gs4510.vhdl]
2022-05-04 Vfat fixes (#539)
    * - mega65-config: Allow F4 to move to next page
    * mega65-config: described purpose of F2/F4 on help page
    * Removing lfn avoidance logic, so I can assess how it really performs presently
    * Fixed an issue with incorrect lfn length being recorded
    * Got rid of the broken and un-necessary null-terminator
    (it was being added in the middle of lfn's anyway)
    * Tried enforcing uppercase names on dir-entries in order to get a match
    (not very successful)
    * trying to save space so that the freezer stuff doesn't corrupt
    (think it was due to my additions to hypervisor making it go over 16kb)
    * if advancing direntry changes sector, assure we read the next sector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
    [constants.asm, dos.asm, main.asm, task.asm]
2022-05-15 make MAX10 reset line reading more robust in the face of comms glitches
    [max10.vhdl]
2022-05-15 disable reset in HDMI output to prevent video glitching
    [mega65r3.vhdl]
2022-05-15 provide single initial reset to video output modules
    [mega65r3.vhdl]
2022-05-16 double-buffer RTC register reads to eliminate glitching
    [mega65r3_i2c.vhdl]
2022-05-18 fix grove i2c port names
    [mega65r3.xdc]
2022-05-18 add grove i2c source and fix CS plumbing
    [grove_i2c.vhdl, iomapper.vhdl]
2022-05-19 debug grove I2C CS
2022-05-19 fix multiple drivers in grove_i2c
    [grove_i2c.vhdl, iomapper.vhdl]
2022-05-21 remove higher-level driving of grove I2C
2022-05-21 fix reading from grove RTC
    [grove_i2c.vhdl]
2022-05-22 make grove I2C address run-time adjustable
2022-05-22 fix reading of grove I2C address
    [grove_i2c.vhdl]
2022-05-22 tidy up grove I2C access
2022-05-22 test harness for grove i2c
2022-05-22 strip old stuff out of test harness for grove i2c
2022-05-23 fix r/w flag in grove I2C
    [grove_i2c.vhdl]
2022-05-28 If holding down ESCAPE key on cold power-up, perform an early endless loop (#547)
    * If holding down HELP key on cold power-up, perform an early endless loop in hyppo, to allow for early debugging of hyppo issues
    * Only do my forced read the sector if:
    - We are advancing to the next direntry
    - The carry flag of the dos_file_advance_to_next_sector() call is set
    (if it is clear, then the sector advance attempt errored out)
    * using RUN-STOP instead of HELP (haven't tested on hardware yet)
    * Switch to ESCAPE key instead
    (as RUN-STOP is used by BASIC ROM to jump to monitor)
    [dos.asm, main.asm]
2022-06-07 Hyppo fix (#568)
    * - un-ignoring iomap.txt, as people find that a useful reference
    - reverted recent change in hyppo's 'freeze.asm' (removal of D02F knock) which was impacting exit out of freezer
    - trying to avoid touching HICKED register during un-freezing DMA calls, to prevent accidental HICKED message on resets
    - updated freezer menu's version to 0.1.6 (to avoid recent versioning confusion between filehost and github repo)
    * - reverted my attempt to fix accidental-HICKED-via dma issue in vhdl
    - instead, will attempt to avoid touch the HICKED register during un-freezing process in 'freeze.asm'
    * added a comment on why the code was re-instated and why it warrants further investig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
    [freeze.asm]
2022-06-07 fix: hyppo should run in dvi mode for compability
    $D61A.1 needs to be set to enable DVI-ONLY mode, not cleared.
    Refs: #552
    [main.asm]
2022-06-07 go back to connecting RTC I2C
2022-06-09 fix: keyboard led register tags where not unique
    Needed for manual, will go into it with next master merge.
    Refs: mega65-user-guide#137
    [c65uart.vhdl]
2022-06-09 fix: keyboard led regtags need splitting
    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
    [c65uart.vhdl]
2022-06-10 fix phase of reading grove RTC
    [grove_i2c.vhdl]
2022-06-13 try to fix grove RTC I2C communications error
    [grove_i2c.vhdl]
2022-06-13 Hyppo & makedisk cluster-traversal edgecase fixes (#578)
    * attempt to fix hyppo edge-case when last direntry on end of cluster
    * another attempt to fix the edge-case
    * added in latest fixes to MAKEDISK
    * Welcome back iomap.txt! ;)
    * updated freezer submodule to include fix to assure all sectors of new d81/d65 images are cleared
    * added TheChief's fix to issue #575 in mega65-freezemenu submodule
    - also removed 'iomap.txt' as somebody has already added it in dev branch
    * Added in johnwayner's infinite-loop fix to mega65-freezemenu submodule
    [dos.asm]
2022-06-13 make new I2C controller for grove RTC
2022-06-13 plumb i2c read address through
2022-06-14 debug grove I2C reading problems
    [grove_i2c.vhdl]
2022-06-14 begin implementing inline DMA jobs #580
2022-06-14 fix fix for #530
    [gs4510.vhdl]
2022-06-15 don't ack last byte to fix write-after-read
    [i2c_controller.vhdl]
2022-06-16 try to fix grove detection logic
    [grove_i2c.vhdl]
2022-06-16 fix inline DMA PC address #580
    [gs4510.vhdl]
2022-06-16 fix which registers we check for grove detection
    [grove_i2c.vhdl]
2022-06-17 use LGB's shorter resetpalette routine
    [main.asm]
2022-06-17 fix typos etc with PETSCII keyboard scanner #582
    [iomapper.vhdl]
2022-06-19 implement mounting D64-sized images using D81 sector addressing #531
2022-06-19 fix typos in d64 offset calculation #531
    [sdcardio.vhdl]
2022-06-19 pull in and fix 1571 support from d64_support branch #531
    [sdcardio.vhdl]
2022-06-19 implement D64/D71 size checks and image mounting in HYPPO #531
2022-06-19 fix out of range branch
    [dos.asm]
2022-06-19 re-add missing signals to HD TIB reader #442
    [sdcardio.vhdl]
2022-06-21 Implement the 50/60Hz TOD flag for CIA #587
2022-06-22 fix: type in external RTC DOW regatble docstring
    [grove_i2c.vhdl]
2022-06-22 fix: corrected hyppo_getversion docs
    [dos.asm]
2022-06-22 fix: bit 7 of DC0E/DD0E is actually 50Hz select
    i.e. if it is 1, system is in 50Hz mode, 0 means 60Hz
    [cia6526.vhdl]
2022-06-22 Corrected typo related to register D6E5 in ethernet.vhdl (#565)
    [ethernet.vhdl]
2022-06-22 Fix CIA6526 register description
    Fix cut'n paste error in CIA6526 register description which eventually finds its way into the user-guide through the automatic table generator code parser.
    [cia6526.vhdl]
2022-06-22 fix register description DC0F.7 CIA2:TODEDIT to CIA1:
    [cia6526.vhdl]
2022-06-23 Let hyppo erase process block early (rather than later, as it was wiping out the attached d81) - Also updated to latest mega65-freezemenu repo, to get the fix for missing disk image names in freezer 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
    [main.asm]
2022-07-01 actually don't check s3 during probe, or it prevents boot
2022-07-01 fix eth_rx_buffers_free calculation #523
    [ethernet.vhdl]
2022-07-01 fix inverted free buffer count #523
    [ethernet.vhdl]
2022-07-01 remove undocumented keys for flashing slots 1 --3, debug entry into flash menu
2022-07-04 ignore eth_rxdv during frames #523
2022-07-05 optimise clocks for low jitter to try to reduce ethernet problems #523
    [clocking.vhdl]
2022-07-05 set BANDWIDTH to HIGH to further reduce clock jitter #523
    [clocking.vhdl]
2022-07-11 fix preamble detection at 10mbits #523
    [ethernet.vhdl]
2022-07-11 fix buffer handling error for debug RX frames #523
    [ethernet.vhdl]
2022-07-11 fix sending of frames at 10mbits #523
    [ethernet.vhdl]
2022-07-12 work on ethernet simulation test bed #523
2022-07-12 eth RX debug always at full sample rate #523
2022-07-31 minor tweak to fix joystick 3's 'sticky' movement issue
    [expansion_port_controller.vhdl]
2022-08-15 fix synthesis for neotrng #600
    [mega65r3.xdc, neotrng.vhdl]
2022-08-17 fix: reformat all C sources
    [floppystatus.c, gen_dis.c, i2clist.c]
2022-08-22 fix: change date display to new common format #542
    [onboard.c]
2022-08-22 feat: new fdisk version with better population control
    - rescan of sdcard bus
    - display which card is being destroyed
    - populate from user defined slot, or skip
2022-08-22 fix: cleanup keys that enter flasher and utility menu #589
    - refactor flasher slot display
    - added HELP version menu to flasher
    - key cleanup
    [keyboard.asm, main.asm]
2022-08-23 fix: leap year check was wrong (year is -1900) #540
    [onboard.c]
2022-08-28 fix: remove unused code from d64/d81 handling #531
    [sdcardio.vhdl]
2022-08-31 fix: vic-iv raster irq incorrectly triggered twice #604
    VIC-IV physical raster interrupts were not edge triggered on ycounter. They already triggered before ycounter is incremented, leading to raster interrupts being triggered twice: at the beginning of a raster line and at its end.
2022-09-01 fix: move components nearer to ports #603
    [mega65r2.xdc, mega65r3.xdc]
2022-09-10 fix: megaflash - convert version string to PETSCII (case mixup)
2022-09-14 mostly display changes to flashers #612
    - add version to jtagflash
    - attic ram check for (jtagflash and megaflash)
    - lots of message reformatting (flasher)
    - don't show files starting with ~ or _ in COR list
    - better formatting in verbose QSPI probe (jtagflash)
2022-09-14 fix(freezer): slot number display
2022-09-15 fix(mega65_config): config did fail to save on exit, RTC enhancements
    - Fix bug in saving chipset values (handle date field)
    - Try to handle the case where the FGPA is configured from JTAG,
    preventing normal reconfiguration
    - Do not update the RTC value (hour, min, sec) after entering a
    value for that sub-field
    - Auto-advance to the next RTC sub-field when entering data in
    the last column of a sub-field
2022-09-17 Xilinx FPGA has no direct access to /POWEROFF line
2022-09-17 refactor DVI output to use correct serialisers and clocks
    [megaphoner4.vhdl, megaphoner4.xdc]
2022-09-17 switch display output to PAL for test
2022-09-17 resurrect TE0725 pin mapping tool
2022-09-17 finish debugging pin assignments of te0725
2022-09-17 update pin assignments in XDC and top
2022-09-17 get megaphone r4 test synthesising with correct XDC
    [megaphoner4.xdc]
2022-09-17 try to fix displaced LCD image
    [megaphoner4.vhdl]
2022-09-17 fix inverted LCD red bits
    [megaphoner4.xdc]
2022-09-17 try another bit pair in red channel to fix banding
    [megaphoner4.xdc]
2022-09-17 revert LCD display enable, as there was no image
    [megaphoner4.vhdl]
2022-09-18 setup UART link between FPGA boards, relaying OrangeCrab control for now
2022-09-18 fix more megaphone r4 plumbing
    [megaphoner4.vhdl]
2022-09-18 fix signal name for megaphoner4
    [megaphoner4.xdc]
2022-09-18 exclude v1541 from megaphone target, but include megaphone i2c peripherals
2022-09-18 MEGAphoneR4 don't drive I2C peripherals on shared bus with Crab
2022-09-18 don't do megaphone r1 i2c setup on megaphone r4
2022-09-24 repeatedly send eth frame #523
2022-09-24 fix: make hyppo_configsector_apply set CIA TOD50 #615
    [syspart.asm]
2022-09-26 fix(hyppo): streamline and fix d81attach calls for D64 #620
    [dos.asm, main.asm]
2022-09-26 fix(flasher): make selection of erase entry more deterministic #616
    also cleanup of onboard and qspi stuff #618
    [onboard.c]
2022-10-02 set target for MEGAphone R4 in slow devices
2022-10-02 prevent glitching of eth rx buffer CS #523
    [ethernet.vhdl]
2022-10-02 when eth rx queue empty, point CPU buffer correctly #523
    [ethernet.vhdl]
2022-10-02 record ID of TXd frame #523
2022-10-03 fix and test ethernet RX buffer handling #523
    [ethernet.vhdl]
2022-10-03 force resynthesis after broken build #523
    [ethernet.vhdl]
2022-10-03 integrate latest freezer changes (mount and d64 enhancements)
2022-10-03 fix(extRTC): fixes 19h problem #591
    Correct DOW (internal 0-6, external Grove 1-7).
    Correct 12/24h flags (internal has 24 flag, external 12 flag).
    Enhanced I/O documentation.
    [grove_i2c.vhdl, mega65r3_i2c.vhdl]
2022-10-03 fix(d81attach): d81check missed to close the file on error #620
    [dos.asm]
2022-10-03 documentation fixes, update iomap.txt
    [sdcardio.vhdl]
2022-10-04 feat(MEGAFLASH): refuse to erase slot 0 #624
2022-10-08 fix(MEGAFLASH): reduce size and add extra security #624
    This has a lot of size reduction by making verbose output and
    flash inspector a compile time option. In addition display code
    was refactored and size optimised.
    Erase slot will now ask for a extra confirmation, as slot
    flashing also does.
    From the Slot flashing confirmation screen you can now press
    ESC or RUN/STOP to return to slot selection.
    Slot 0 flashing has been removed at all possible places. Also
    the secret slot 0 flash in the integrated flasher is gone. From now
    flashing will require jtagflash.
    In addition the extra jtagdebug.prg target was added, which is
    jtagflash.prg with all the inspector and slot 0 erasing allowed.
2022-10-08 fix(megaflash): strict cor signature check #624
    only allow MEGA65 core in slot 0
2022-10-09 cleanup-merge: fixed one iomap typo in CIA
    [cia6526.vhdl]
2022-10-17 correct typo in memory map doco
    [iomapper.vhdl]
2022-11-01 fix #634 by making all RAM writable by hypervisor
    [freeze.asm, gs4510.vhdl]
2022-11-01 fix plumbing of eth remote key presses into keyboard_complex #633
    [ethernet.vhdl, iomapper.vhdl]
2022-11-02 fix starting and running ETHLOAD.M65 on ethernet hyper trap #633
    [task.asm]
2022-11-04 accept frames after noticing arrival, not before #633
2022-11-04 clear eth TX IRQ only when sending a frame #633
2022-11-05 rework magic frame detection to not overwrite buffers #633
    [ethernet.vhdl]
2022-11-05 reset ethernet on reset #633
    [main.asm]
2022-11-05 purge waiting ethernet frames when triggering etherload #633
2022-11-05 fix swapped register names for MAP
    [machine.asm]
2022-11-06 attempt hard fix for #636
    [ethernet.vhdl]
2022-11-06 fix eth reset sequence to prep for etherload #633
    [main.asm]
2022-11-11 fix synthesis errors #637
    [mega65kbd_to_matrix.vhdl]
2022-11-12 begin implementing I2C transactions #637
2022-11-12 correct SDA/SCL plumbing #637
    [mega65kbd_to_matrix.vhdl]
2022-11-12 fix uart TX control for keyboard detection debug #637
2022-11-12 restore filtering of keyboard type detect announce #637
2022-11-12 implement failing I2C traffic test for MK-II keyboard #637
2022-11-12 fix activation of MK-II keyboard code #637
    [mega65kbd_to_matrix.vhdl]
2022-11-13 instrument and begin testing for I2C activity #637
2022-11-13 fail test when I2C regs not read #637
2022-11-13 fix repeated start during I2C register read #637
    [i2c_slave.vhdl, mega65kbd_to_matrix.vhdl, pca9555.vhdl]
2022-11-13 fix U1 initialisation sequences #637
    [mega65kbd_to_matrix.vhdl]
2022-11-13 implement a test for matrix being correct when no key pressed #637
    [kb_matrix_ram.vhdl, mega65kbd_to_matrix.vhdl]
2022-11-13 implement test for correct function when a key is pressed #637
    [mega65kbd_to_matrix.vhdl, pca9555.vhdl]
2022-11-13 make i2c xfers safer #637
2022-11-13 fix ACK of port reads #637
    [mega65kbd_to_matrix.vhdl]
2022-11-13 fix problems with I2C ACK #637
    [i2c_slave.vhdl, mega65kbd_to_matrix.vhdl]
2022-11-14 implement uart bitbash control for keyboard interfae #637
2022-11-14 fix selection of bitbash mode #637
    [mega65kbd_to_matrix.vhdl]
2022-11-15 use FPGA to push SDA & SCL high due to high capacitance of MK-II KBD PCB #637
2022-11-15 try reducing I2C drive strength to approx pull-up #637
2022-11-15 talk to just one of the I2C expanders for testing #637
2022-11-21 revert to only MK-I keyboard in mega65kbd_to_matrix
    [mega65kbd_to_matrix.vhdl]
2022-11-22 begin fixing build issues with stale nexys4ddr target #637
    [mk2_to_mk1.vhdl, nexys4ddr.vhdl]
2022-11-22 show keyboard model detection on LED 13 #637
2022-11-22 make ESC to ignore flash menu work when QSPI flash is broken #637
2022-11-25 fix drive led flash bug #637
    [mk2_to_mk1.vhdl]
2022-11-27 rework hdmi_test_r3 target for video output for expansion board #638
2022-11-27 get 8x overdrive of resistor DAC sort of running #638
2022-12-09 swap E and <- keys for MK-II revB keyboard
    [mk2_to_mk1.vhdl]
2022-12-11 allow FDC cable to be used as make-shift input device
2022-12-16 tri-state SD card slots when not being used
2022-12-18 fix display width of composite video, begin reworking HSYNC #638
    [frame_generator.vhdl, pixel_driver.vhdl, tb_pixel_driver.vhdl]
2022-12-23 rework composite sync generation #638
    [frame_generator.vhdl, pixel_driver.vhdl]
2022-12-23 add logic to select odd/even 15KHz interlace frame #638
2022-12-24 fix cv_sync glitching #638
    [pixel_driver.vhdl]
2022-12-24 progress towards correct VBLANK PAL syncs #638
    [pixel_driver.vhdl]
2022-12-24 actually capture 2 fields = 1 frame #638
2022-12-24 fix 15khz VSYNC after rework #638
    [pixel_driver.vhdl]
2022-12-24 fix glitching of 15KHz SYNC on exiting VSYNC #638
    [pixel_driver.vhdl]
2022-12-24 fix remaining 15khz sync glitches #638
    [pixel_driver.vhdl]
2022-12-28 fix tristating when CS low #638
    [ghdl_ram32x1024_sync.vhdl]
2022-12-28 fix bugs with 15KHz buffered raster output #638
    [pixel_driver.vhdl]
2022-12-28 plumb composite video through to expansion board #638
2022-12-29 further debug missing composite pixel data #638
    [pixel_driver.vhdl]
2022-12-29 composite luma pixel data fixed by adding debug? #638
    [pixel_driver.vhdl]
2022-12-29 fix black level during VSYNC #638
    [pixel_driver.vhdl]
2022-12-29 fix inverted interlace fields #638
    [pixel_driver.vhdl]
2022-12-29 try to fix over-wide active area of rasters #638
    [pixel_driver.vhdl]
2022-12-29 begin plumbing R3 expansion board and composite out into R3 #638
2022-12-29 reduce left trim for composite dimming fix #638
    [pixel_driver.vhdl]
2022-12-29 fix R3 synthesis errors #638
    [mega65r3.vhdl, mega65r3.xdc]
2022-12-29 fix clamped luma #638
    [mega65r3.vhdl]
2022-12-29 fix pixel width adjustment for 720H vs 640H #638
    [pixel_driver.vhdl]
2022-12-30 check if interlace fields should be inverted #638
    [pixel_driver.vhdl]
2022-12-30 switch which field we display if non-interlaced #638
2022-12-30 make 108 px delay not be shortened by X scaling #638
    [pixel_driver.vhdl]
2022-12-30 fix stupid logic error #638
    [frame_generator.vhdl]
2022-12-30 speed up video simulation by shortening frames #638
    [pixel_driver.vhdl, tb_pixel_driver.vhdl]
2022-12-30 further shorten sim frames and capture 2 whole fields #638
    [pixel_driver.vhdl, tb_pixel_driver.vhdl]
2022-12-30 fix PAL HSYNC odd/even selection #638
    [frame_generator.vhdl]
2022-12-30 fix glitches with PAL composite sync #638
    [pixel_driver.vhdl]
2022-12-30 fix and simplify PAL composite sync #638
    [frame_generator.vhdl, pixel_driver.vhdl]
2022-12-31 work towards correcting NTSC composite timing #638
    [frame_generator.vhdl, pixel_driver.vhdl, tb_pixel_driver.vhdl]
2022-12-31 NTSC even field timing now correct #638
    [frame_generator.vhdl, pixel_driver.vhdl]
2022-12-31 fix remaining interlaced NTSC timing #638
    [pixel_driver.vhdl]
2022-12-31 correct errors in PAL composite timing #638
    [pixel_driver.vhdl, tb_pixel_driver.vhdl]
2022-12-31 fix NTSC test pattern and interlace offset #638
    [pixel_driver.vhdl]
2022-12-31 fix PAL SYNC generation #638
    [pixel_driver.vhdl]
2022-12-31 allow switching of mono and interlace in test #638
2022-12-31 fix PAL interlace timing after disturbance for fake progressive #638
    [pixel_driver.vhdl, tb_pixel_driver.vhdl]
2022-12-31 fix error in NTSC luma calculation #638
    [pixel_driver.vhdl]
2023-01-01 rework chroma calculations to use signed values #638
    [pixel_driver.vhdl]
2023-01-01 further rework colour sine table calculations to integer #638
    [pixel_driver.vhdl, tb_pixel_driver.vhdl]
2023-01-01 invert PAL V on every other line #638
    [pixel_driver.vhdl]
2023-01-01 work around wrong PAL colour phases #638
    [pixel_driver.vhdl]
2023-01-01 fix overflow of chroma #638
    [pixel_driver.vhdl]
2023-01-01 fix PAL colour burst angle #638
    [pixel_driver.vhdl]
2023-01-02 prevent some chroma induced spots at start of rasters #638
    [pixel_driver.vhdl, tb_pixel_driver.vhdl]
2023-01-02 fix further chroma glitches in composite out #638
    [pixel_driver.vhdl]
2023-01-02 do gamma pre-correction of RGB #638
    [pixel_driver.vhdl]
2023-01-02 invert PAL phase alternation every field #638
    [pixel_driver.vhdl]
2023-01-02 fix missing video bug. revert colour invert #638
    [pixel_driver.vhdl]
2023-01-04 fix chroma scaling #638
    [pixel_driver.vhdl]
2023-01-04 try to fix PAL V inversion for non-interlace mode #638
    [pixel_driver.vhdl]
2023-01-04 allow disabling of gamma pre-correction #638
    [pixel_driver.vhdl]
2023-01-16 fix: multi-sector sd card write omits last sector #646
    [sdcard.vhdl]
2023-01-17 begin creating target for QMTECH A200T + carrier board #642
2023-01-17 Add QMTech A200T and K325T board support with ZYJZGW daughter board.
    These boards have a powerful FPGA and provide somewhat limited
    extensions, such as VGA, HDMI, stereo jack, some GPIO, some switches,
    LEDs and buttons, and 3 PMOD connectors.
2023-01-17 fix slicing of Q for NEGQ
    [gs4510.vhdl]
2023-01-21 swap sd and sd2 busses for megaphone4
    [megaphoner4.vhdl]
2023-01-21 fix pin assignments for bodge SD card for MP4
    [megaphoner4.xdc]
2023-01-21 move bodge SD bus to correct pins for MP4
    [megaphoner4.xdc]
2023-01-21 pull in m3wp's audio DMA fixes #651
    [gs4510.vhdl]
2023-02-11 fix mix-up of two rx eth frames when buffers are full
    [ethernet.vhdl]
2023-02-28 (#669) Fix issues reported with internal sd-card
    [main.asm]
2023-03-12 add note about HyperRAM RevD errata problem
    [hyperram.vhdl]
2023-03-12 fix plumbing of char rom rdata #676
    [gs4510.vhdl]
2023-03-12 more plumbing fixes #676
    [gs4510.vhdl, machine.vhdl]
2023-03-12 fix build errors from #673
    [mega65r2.vhdl, nexys4ddr.vhdl]
2023-03-12 fix region setup/cleanup for charrom freezing #676
    [freeze.asm]
2023-03-12 switch mega65-freezemenu to the new development branch
2023-03-15 feat(megaflash): add cartridge core slot autoboot #683
2023-03-19 fix documentation errors, update iomap.txt
    [ethernet.vhdl, gs4510.vhdl]
2023-03-25 fix boot with utlimax mode cartridges (megaflash can't run without ROM) #683
    [main.asm]
2023-03-26 more work towards vivado project for R4 board
2023-03-27 fix R4 plumbing issues
    [mega65r4.vhdl, mega65r4.xdc]
2023-03-27 more plumbing synthesis fixes for R4
    [mega65r4.vhdl]
2023-03-27 fix more R4 XDC issues
    [mega65r4.xdc]
2023-03-27 remove pwm_l/_r from R4
2023-03-28 fix inverted reset button sense
    [mega65r4.vhdl]
2023-03-29 fix hdmi_enable signal plumbing
    [mega65r4.vhdl, mega65r4.xdc]
2023-03-29 more fixing reset plumbing
    [mega65r4.vhdl]
2023-03-29 try to really fix reset problems
    [mega65r4.vhdl]
2023-04-01 fix freq to SDRAM
    [sdram.vhdl]
2023-04-01 fix snyth bugs for empty SDRAM controller
    [mega65r4.vhdl, sdram.vhdl, sdram_controller.vhdl]
2023-04-10 begin reworking for R4 RTC
    [iomapper.vhdl, mega65r4_i2c.vhdl]
2023-04-10 feat(MEGAFLASH): add slot caps/flags display and boot selection #683 enables slot 0 flashing (r3a only!) #625 adds default slot selection #370
2023-04-12 try to fix synthesis errors
    [mega65r4.vhdl, mega65r4.xdc, sdram_controller.vhdl]
2023-04-13 add CS for M65R4 I2C peripherals
2023-04-14 fix writing of month field
    [mega65r4_i2c.vhdl]
2023-04-14 try to fix R4 RTC register remapping
    [mega65r4_i2c.vhdl]
2023-04-15 begin working on test bed for SDRAM controller etc
2023-04-15 fix SDRAM pipelined read behaviour
    [is42s16320f_model.vhdl]
2023-04-15 start fixing simulation errors for SDRAM model
    [is42s16320f_model.vhdl]
2023-04-15 fix many syntax errors
    [is42s16320f_model.vhdl]
2023-04-15 rework to remove intermediate SDRAM interface.
    [is42s16320f_model.vhdl, sdram_controller.vhdl]
2023-04-15 fix SDRAM init sequence
    [is42s16320f_model.vhdl, sdram_controller.vhdl]
2023-04-16 fix SDRAM model to return to IDLE after PRECHARGE
    [is42s16320f_model.vhdl]
2023-04-16 fix errors in SDRAM model
    [is42s16320f_model.vhdl]
2023-04-16 fix read/write latch signal handling
    [sdram_controller.vhdl]
2023-04-17 fix SDRAM model writing and controller driving
    [is42s16320f_model.vhdl, sdram_controller.vhdl]
2023-04-17 fix SDRAM model read latency
    [is42s16320f_model.vhdl]
2023-04-18 fix DQM handling errors
    [sdram_controller.vhdl]
2023-04-18 fix errors plumbing joystick outputs
    [machine.vhdl, mega65r4.vhdl]
2023-04-18 more joystick output plumbing fixing
    [machine.vhdl]
2023-04-18 fix XDC for joystick outputs
    [mega65r4.xdc]
2023-04-21 fix problems with eth buffer $Dxxx mapping #693
    [gs4510.vhdl, iomapper.vhdl]
2023-04-21 fix more colour RAM vs eth buffer CS issues #693
    [gs4510.vhdl]
2023-04-21 fix stupid typo #693
    [gs4510.vhdl]
2023-04-21 fix inverted IEC line drivers
    [mega65r4.vhdl]
2023-04-21 fix plumbing of joystick output lines
    [iomapper.vhdl]
2023-04-22 debug frame VSYNC lock
2023-04-22 fix frame toggle signal capture for video lock
2023-04-23 also fix writing to VIC-IV etc in $FFD2xxx #693
    [gs4510.vhdl]
2023-04-23 compute exact PAL frame synchronisation
2023-04-23 calculate exact NTSC upscale frame lock figures
2023-04-23 fix typo in NTSC upscale frame dimensions
2023-04-23 NTSC frames slightly too long
2023-04-23 further fine tune NTSC frame VLOCK
2023-04-23 more work trying to get NTSC frame timing exact
2023-04-24 fix more cross-domain pressures
2023-04-25 add comment for audio DAC power down
2023-04-25 plumb test tone 200Hz to I2S DAC feed
2023-04-25 switch VDAC clock based on video mode
2023-04-26 make I2C output for R4 signed
2023-04-26 fix plumbing errors for audio DAC for R4
    [mega65r4.vhdl]
2023-04-26 add missing audio_bick pin to R4 XDC
    [mega65r4.xdc]
2023-04-26 fix errors for R4 upscaler plumbing
    [mega65r4.vhdl]
2023-04-26 fix horror timing bug for upscaler on R4
    [mega65r4.vhdl]
2023-04-27 fix CDC for ethernet on R4
    [mega65r4.xdc]
2023-04-27 fix signed/unsigned audio output on R4 3.5mm audio
2023-04-28 make PAL upscaler frame timing run-time adjustable for debug R4
2023-04-29 more fine-tuning PAL upscaled frame timing
2023-04-29 fix bugs with R4 bi-directional joystick operation
    [iomapper.vhdl, machine.vhdl, mega65r4.vhdl, mega65r4.xdc]
2023-04-29 fix mouse clock reference #694
    [machine.vhdl, mouse_input.vhdl]
2023-04-29 fix eth CDC false paths for R3
    [mega65r3.xdc]
2023-04-29 fix(qspicommon): fix slot 0 flashing on old flash chips #638
2023-04-29 fix some plumbing problems to SDRAM
    [mega65r4.vhdl, sdram_controller.vhdl]
2023-04-30 fix bug with SDRAM debug register access
    [sdram_controller.vhdl]
2023-04-30 add extra read latency cycle to SDRAM controller. Fix 8/16 bit write interface
    [sdram_controller.vhdl]
2023-04-30 add missing cycle of read latency to SDRAM model
    [is42s16320f_model.vhdl]
2023-04-30 fix cas latency handling
    [is42s16320f_model.vhdl]
2023-04-30 fix bugs in SDRAM model. all unit tests currently passing
    [is42s16320f_model.vhdl]
2023-04-30 fix(hyppo): clear key from keybuffer in dipsw3 check #683
    [main.asm]
2023-05-01 fix(hyppo): corrected clear key for dipsw3 check #683
    [main.asm]
2023-05-01 feat(megaflash): add slot 0 flashing with extra security #625 #683 - add fast crc32 with tables (won't work in hyypo, to less space!) - UPGRADE0.PRG for secure slot 0 flashing (with hardwired UPGRADE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
    [joyflash.c, qspijoy.c]
2023-05-03 fix SDRAM output hold and setup constraint calculation
    [mega65r4.xdc]
2023-05-03 fix(megaflash): need to erase more to ensure slot 1 boot #625 #683
2023-05-03 relax timing and fix bug with sdram cache line handling
    [mega65r4.xdc, sdram_controller.vhdl]
2023-05-03 fix(megaflash): empty slot detection was wrong #683
2023-05-03 fix bug with silent cache advance/retreat prefetches
    [sdram_controller.vhdl]
2023-05-04 fix(submodules): switch to development of freezemenu, fix libc bugs #683
2023-05-04 fix bugs in SlowRAMPrefetch read path
    [gs4510.vhdl]
2023-05-04 try to relax SDRAM DQ timing for faster synth and to fix write problems
    [mega65r4.xdc]
2023-05-04 add extra tRCD cycle to prevent corrupted rows on reads sometimes
    [sdram_controller.vhdl]
2023-05-05 enable slow prefetch by default now bug is fixed
    [gs4510.vhdl]
2023-05-05 Revert "try removing one READ_WAIT cycle"
    This reverts commit f3f52a148add15b581c00c11e05cf167709db427.
    [sdram_controller.vhdl]
2023-05-05 fix bug with SDRAM strobe shortening
    [sdram_controller.vhdl]
2023-05-05 allow easy switching to hyperram
2023-05-05 switch back to SDRAM
2023-05-06 help debug eth tx CPU glitch bug
    [gs4510.vhdl]
2023-05-06 attempt fix for #696
    [cpusim.asm, gs4510.vhdl]
2023-05-06 also fix source of extraneous cpu_arrests #696
    [ethernet.vhdl]
2023-05-06 fix RTC array size
    [mega65r4_i2c.vhdl]
2023-05-06 fix 1351 NTSC timing typo
    [pixel_driver.vhdl]
2023-05-06 more mouse NTSC timing synth fixes
    [machine.vhdl]
2023-05-07 restore MEGA65 name check for slot 0 flash
2023-05-07 enabling some missing devices in eth I/O personality #693
    [iomapper.vhdl]
2023-05-09 fix syntax error in xdc file (missing space in statement)
    [mega65r3.xdc, mega65r4.xdc]
2023-05-09 fix(neoTRNG): remove use less set_disable_timing lines #600
    [mega65r3.xdc, mega65r4.xdc]
2023-05-09 fix(neoTRNG): only toggle consume flag on read if changed #600
    [gs4510.vhdl]
2023-05-10 feat(neoTRNG): add NOTRDY flag for RNG #600
    neoTRNG takes 250-350 cycles to sample 8 bit of entropy. This
    provides access to the bit that shows that the next number is
    not ready yet.
    Usage:
    rngnotrdy: BIT $D7FE
    BMI rngnotrdy
    LDA $D7EF
2023-05-11 Fix bad characters in xdc file (#702)
    [mega65r3.xdc]
2023-05-12 fix timing issues with hyperram after mega65r4-bringup merge hyperram needs more delay than sdram TODO: if we get switchable extension ram, this needs to be run-time!
2023-05-13 fix reading of sdram/hyperram flag
    [gs4510.vhdl]
2023-05-26 reverse out slow clock runtime select
    [mega65r4.vhdl]
2023-06-06 fix another copy pasta
    [mega65r4_i2c.vhdl]
2023-06-14 feat(megaflash): add check for MEGA65 core in slot 1 #683
2023-06-18 feat(util-build): add specific cc65 configs for utilties #683
    This makes the size check somewhat superflous, as cl65 will
    check the memory segmetns while building. The new util-core.cfg
    takes the space HYPPO uses into account and places BSS and
    STACK above HYPPO.
    [util-core.cfg, util-std.cfg]
2023-06-19 fix(megaflash): change M65 Cart detect and add more debug info #711 M65 at $4008007 will now always try to start a MEGA65 core. change slot 0 confirmations text to match current methof #683
2023-06-20 fix(megaflash): show slot 1 warning if there is no MEGA65 core in it #683
2023-06-20 fix using eth_tx_trigger from wrong clock domain in eth tx fsm
    [ethernet.vhdl]
2023-07-19 fix #712: c65 style memory mapping does not match c65 behaviour
    [gs4510.vhdl]
2023-08-09 reverting commit 4a76bee: don't enable interlace mode implicitly when V400 is activated #638
    This is breaking some hdmi monitors that can't deal with the switch to interlace mode.
2023-08-10 fix writing to eth tx buffer via mapped $d800 is broken #719
    [ethernet.vhdl]
2023-08-14 remove unnecessary (and wrong) mapping of d800 to colram in cpu (this is already handled by vic) #719
    [gs4510.vhdl]
2023-08-16 Complete D619 PETSCIIKEY implementation
    * Repair PETSCII lookup tables
    * Do not emit events for non-character key presses
    * Return $FF on empty queue, so as not to collide with PETSCII $00
    * Tweak repeat timing to match ROM 920385's soft repeat
    [iomapper.vhdl, matrix_to_ascii.vhdl]
2023-08-16 (#713) Fix long delay to openrom (#717)
    * fixed issue with it looping for too long
    * if no MEGA65.ROM on sd-card, try boot to openrom instead
    ---------
    [main.asm]
2023-08-31 fix tools#167: keep process control block on ethernet hyperrupt
    fixes https://github.com/MEGA65/mega65-tools/issues/167
    this is to keep information about currently mounted file (for example after exiting mega65_ftp) so freezer will be able to restore it when unfreezing later.
    [task.asm]
2023-09-11 Repair bucky key wiring directions
2023-09-19 feat(megaflash): refactor megaflash to not use ROM print part 1 #683
    This is the first part of a major overhaul of the MEGAFLASH code.
    It does build, but it does currently NOT FLASH, so don't use it!
2023-09-23 Repair mouse and paddle in port 2
    The CIA routing of peripheral port analog pins to SID1 was incorrectly wired to CIA PORTB, when it should have been PORTA. Also, the SID selection was backwards: SID1 is "potr", peripheral port 1 is "pota".
    I double-checked that we want to label SID1+2 as the "right" SIDs, so swapping "potl" for "potr" is the correct change.
    [c65uart.vhdl, iomapper.vhdl]
2023-09-24 Fix occasional unwanted key repeats (#739)
    [matrix_to_ascii.vhdl]
2023-09-24 New errata level mechanism; char attr fix is errata level 2
    D07A.5: 1=compatibility mode, no fixes, errata level is 0, bug_compat modes are ON
    D07A.5: 0=full fixes, errata level is FF, bug_compat modes are OFF
    D08F: errata level. 0=no fixes, bug_compat modes are ON. 1=VIC III D016 Delta fix (bug_compat_vic_iii_d016_delta is OFF), 2=Delta fix + Char attr fix (bug_compat_char_attr is OFF).
    [iomapper.vhdl, machine.vhdl, sdcardio.vhdl]
2023-09-26 reset button resets 3.5mm audio ADC
    [mega65r4.vhdl]
2023-10-03 fix R4 ADC reset/power control
    [mega65r4.vhdl]
2023-10-06 Repair inverted D07A.5 not-compatibility bit; freeze all VIC-IV registers
    [freeze.asm]
2023-10-06 Corrected freezer palette block explanation in comment.
    [freeze.asm]
2023-10-13 Fix MODKEY labels: right shift is bit 1, left shift is bit 0
    [c65uart.vhdl]
2023-10-22 feat(megaflash/nohysdc): add subdirectory support and sd slot switch #683 also changes dirent structure
2023-10-28 update XDC for renamed audio ADC pins #585
2023-10-28 fix(megaflash): move dip default slot into scan_bitstream_information #683
2023-10-31 fix default hyperram mode selection #585
    [gs4510.vhdl]
2023-11-04 fix simulation errors #585
    [internal1541.vhdl, m6522.vhdl]
2023-11-04 correct some comments #585
    [hyperram.vhdl]
2023-11-04 fix two more comments #585
    [hyperram.vhdl]
2023-11-04 add missing file #585
    [iec_serial.vhdl]
2023-11-04 bring in internal 1541 updates from pgs-r4-fixups to get synthesising #585
    [dpram8x4096.vhdl, internal1541.vhdl, iomapper.vhdl, m6522.vhdl]
2023-11-05 fix(1541+neoTRNG): fix build for r4 and r3 by removing 1541 and adding ALLOW_COMBINATORIAL_LOOPS #585
    [iomapper.vhdl, mega65r3.xdc, mega65r4.xdc]
2023-11-10 more fixes for simulation under NVC
    [bitplanes.vhdl, buffereduart.vhdl]
2023-11-10 fix building of various debug targets
    [hdmidebug.vhdl]
2023-11-10 fix build error for R1 target
    [mega65r1.vhdl]
2023-11-10 update R4 I2C devices
2023-11-11 switch back to freezemenu-development branch
2023-11-23 fixed beacon not sent if eth frames are sent out at least once a second
    [ethernet.vhdl]
2023-11-25 begin plumbing I2C connected dipswitches
2023-11-25 add missing dipsw_read declaration
    [machine.vhdl]
2023-11-25 dipsw doesn't come from top in R5
    [mega65r5.vhdl]
2023-11-26 correct top-level IEC plumbing for R5
    [mega65r5.vhdl]
2023-11-27 begin replumbing R5 boared mgmt I2C
2023-11-27 fork I2C peripherals for R5
2023-12-03 work on simulating R5 DC-DC/DIPsw I2C controller
2023-12-03 add PCA9555 to R5 I2C test harness
2023-12-03 fix debug messages for compatibility
    [i2c_master.vhdl, i2c_slave.vhdl]
2023-12-03 more work on R5 DCDC I2C testbed
2023-12-03 fix R5 reset, cart and joy en plumbing
    [mega65r5.vhdl, mega65r5.xdc]
2023-12-03 invert IEC signal drive sense for R5
    [mega65r5.vhdl]
2023-12-05 fix board i2c signal names for R5
    [mega65r5.xdc]
2023-12-09 FREEZER: Reduce VIC IV Freeze Range; Save Errata Byte Separately
    Fixes: https://github.com/MEGA65/mega65-core/issues/753
    The freeze_mem_list entry for $FFD3000 ($D000) was extended to include
    memory locations up to $D100 in an effort to include the new errata
    byte at $D08F (and, I think, to just try to freeze additional state).
    Unfortunately, this area includes at least one location that should
    not be written to when unfreezing: $D081. Writing to this location
    can cause changes to the sector buffers that contain the freezer
    data. The result of writing there is almost always fatal as the
    machine is unfrozen with huge parts of the memory basically empty --
    including the ROMs. So that freez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
    [freeze.asm]
2023-12-09 work on R5 board I2C
2023-12-09 get R5 board I2C clearing ear watering mode
2023-12-09 fix dip sw etc plumbing for R5
    [i2c_master.vhdl, mega65r5_board_i2c.vhdl, pca9555.vhdl]
2023-12-09 fix R5 reading dipsw and board rev problems
    [mega65r5_board_i2c.vhdl]
2023-12-10 plumb extra DIP switches for R5 through
2023-12-10 fix I2C device ID for R5 board IO expander
    [mega65r5_board_i2c.vhdl]
2023-12-10 use board revision straps for ID on R5
2023-12-10 switch ports for R5 dipsw vs board rev reading
2023-12-10 allow reading of board minor version in $D628
2023-12-10 fix board revision plumbing for R5
    [iomapper.vhdl]
2023-12-10 make sure board minor rev is $0 on pre-R5 boards
2023-12-10 swap board minor and major rev lines for R5
    [mega65r5_board_i2c.vhdl]
2023-12-10 prepare for boards after R5 auto-ID
2023-12-10 fix mapping of I2C peripherals for R5
    [iomapper.vhdl]
2023-12-10 try to fix R5 IEC
    [mega65r5.vhdl]
2023-12-10 fix signal names for R5 IEC
    [mega65r5.vhdl]
2023-12-10 invert IEC line controls for R5
    [mega65r5.vhdl]
2023-12-10 fix inverted ATN for R5
    [mega65r5.vhdl]
2023-12-10 try inverting IEC reset for R5
    [mega65r5.vhdl]
2023-12-10 nope, IEC reset on R5 was the right way around before
    [mega65r5.vhdl]
2023-12-10 feat(mega65_config): ask user to power cycle instead of resetting #752
2023-12-10 feat(onboarding): don't reset mnachine, request power cycle from user #722
    [onboard.c]
2023-12-12 reverse cart block in hypervisor
    [gs4510.vhdl]
2023-12-12 more ROMH/ROML driving fix testing R5
    [mega65r5.vhdl]
2023-12-16 fix(machine.vhdl): large dip switches also for r6
    [machine.vhdl]
2023-12-16 removed r2 build temporarily, as the builds currently fail
2023-12-17 simplify and fix thumbnail logic for freezing #757
    [framepacker.vhdl, freeze.asm, iomapper.vhdl]
2023-12-17 fix signal name typo #757
    [framepacker.vhdl]
2023-12-17 try to fix thumbnail mapping #757
    [framepacker.vhdl, iomapper.vhdl]
2023-12-17 fix silly typo #757
    [framepacker.vhdl]
2023-12-23 fix(syntax check): cleanup CRITICAL WARNINGs
    [internal1541.vhdl]
2023-12-23 fix(r4+rtc): change TSM to 3V to protect battery onboard and megainfo will set TSM on those devices
    [onboard.c]
2023-12-23 fix(freezer): speed switch bug (2 MHz flag address)
2023-12-24 fix more simulation errors #757
    [framepacker.vhdl, machine.vhdl]
2023-12-24 and more simulation errors #757
    [internal1541.vhdl]
2023-12-24 fix even more simulation errors #757
    [c65uart.vhdl]
2023-12-24 yet more simulation errors #757
    [ghdl_ram8x4096.vhdl, keyboard_complex.vhdl, rain.vhdl, visual_keyboard.vhdl]
2023-12-24 debug thumbnail problem #757
    [framepacker.vhdl, ghdl_videobuffer.vhdl, iomapper.vhdl, main.asm]
2023-12-24 fix double-stepping thumbnail addr #757
    [framepacker.vhdl]
2023-12-25 fix synthesis errors #757
    [framepacker.vhdl, ghdl_ram8x4096_sync.vhdl]
2023-12-25 fix another typo #757
    [framepacker.vhdl]
2023-12-25 revert vertical adjust for thumbnails #757
    [framepacker.vhdl]
2023-12-25 add missing file #757
    [ghdl_ram8x4096_sync_2cs.vhdl]
2023-12-25 try fixing vertical position of thumbnail #757
    [framepacker.vhdl]
2023-12-25 fix(mega65r5.xdc): eth_clock create_clock statement was wrong #761
    [mega65r4.xdc, mega65r5.xdc]
2023-12-25 try to fix no-video bug from previous commit #757
    [framepacker.vhdl]
2023-12-26 fix synth errors #736
    [iomapper.vhdl]
2023-12-26 fix R5 IEC plumbing #736
    [mega65r5.vhdl]
2023-12-26 fix R3 IEC plumbing #736
    [mega65r3.vhdl]
2023-12-26 fix build errors for R3, nexys targets #736
    [mega65r3.vhdl, nexys4ddr-widget.vhdl, nexys4ddr.vhdl]
2023-12-26 more R3 build fixes #736
    [mega65r3.vhdl]
2023-12-26 ... and another R3 build fix #736
    [mega65r3.vhdl]
2023-12-26 fix R3 DXC #736
    [mega65r3.xdc]
2023-12-26 fix /WRITE plumbing in simulated 1541 #736
    [internal1541.vhdl]
2023-12-28 fix failing test case #736
2023-12-30 reduce turn-around delays to fix test 6 of #736
    [iec_serial.vhdl]
2023-12-31 reset IEC controller on reset #736
    [iec_serial.vhdl, iomapper.vhdl]
2023-12-31 release SRQ on reset #736
    [iec_serial.vhdl]
2023-12-31 fix two bugs where iec_busy was not cleared #736
    [iec_serial.vhdl]
2023-12-31 tighten up C128 fast serial detection #736
    [iec_serial.vhdl]
2023-12-31 hold 1541 under reset when using dummy device #736
2023-12-31 rework JiffyDOS detection #736
    [iec_serial.vhdl]
2024-01-01 probe JiffyDOS capability only on TALK or LISTEN #736
2024-01-01 correct JiffyDOS byte RX status #736
    [iec_serial.vhdl]
2024-01-02 fix JiffyDOS turn-around delay #736
    [iec_serial.vhdl]
2024-01-02 fix jiffydos tx bit order etc #736
    [iec_serial.vhdl]
2024-01-02 switch emulated drive to device 8 to avoid JD problem #736
    [internal1541.vhdl]
2024-01-02 fix JiffyDOS TX bit munging #736
    [iec_serial.vhdl]
2024-01-02 fix JiffyDOS T to 1541 timing #736
    [iec_serial.vhdl]
2024-01-02 fix JiffyDOS RX from drive timing #736
    [iec_serial.vhdl]
2024-01-02 correct delay before sending status to JD #736
    [iec_serial.vhdl]
2024-01-02 fix signal type conversion #736
    [internal1541.vhdl]
2024-01-02 correct addresses in iec test bed #736
2024-01-02 fix silly typo #736
    [iomapper.vhdl]
2024-01-02 correct time side-channel EOI indication in JD #736
    [iec_serial.vhdl]
2024-01-03 update CIA pin assignments from 1581 #736
2024-01-03 fix address bus width of 1581 #736
    [internal1581.vhdl]
2024-01-03 using the correct bus widths works better #736
    [internal1581.vhdl]
2024-01-03 no CIA timers running on reset #736
    [cia6526.vhdl]
2024-01-03 fix inverted CLK and DATA lines on R3 #736
    [mega65r3.vhdl, mega65r3.xdc]
2024-01-03 don't enable CIA imask_ta on power on #736
2024-01-03 try to fix JD RX timing with 2x speed fix #736
    [iec_serial.vhdl]
2024-01-04 apply JD timing fix by default, and accomodate in tests #736
    [iec_serial.vhdl]
2024-01-04 fix test regression from JD timing work-around #736
    [iec_serial.vhdl]
2024-01-04 fix probable cause of timing weirdness #736
    [iec_serial.vhdl]
2024-01-04 more turn-around fix testing #736
    [iec_serial.vhdl]
2024-01-04 set T_BB when resetting timing #736
    [iec_serial.vhdl]
2024-01-05 fix t_v / t_s names #736
    [iec_serial.vhdl]
2024-01-05 add missing t_h_ms initialisation #736
    [iec_serial.vhdl]
2024-01-05 always wait a whole number of milli-seconds #736
2024-01-05 work around bad milli_wait() #736
2024-01-05 but some other parts of milli_wait logic #736
2024-01-05 fix simulation error #736
    [iec_serial.vhdl]
2024-01-05 fix T_H / T_HA handling #736
    [iec_serial.vhdl]
2024-01-05 fix duplicate def #736
    [iec_serial.vhdl]
2024-01-07 implement glue logic for expansion board simulation #768
2024-01-07 begin implementing simulated exp board #768
2024-01-07 fix JD on 1541/1571 #736
    [iec_serial.vhdl]
2024-01-09 reset t_ar on reste #736
    [iec_serial.vhdl]
2024-01-09 fix release ATN logic #736
    [iec_serial.vhdl]
2024-01-11 $52 and $72 should only control RESET pin #736
2024-01-11 add missing RAM5 #736
    [iec_serial.vhdl]
2024-01-14 fix JD timing #736
    [iec_serial.vhdl]
2024-01-14 implement JD timing fixes from @johnwayner #736
    [iec_serial.vhdl]
2024-01-15 ONBOARD: Generate a MAC address silently during on-boarding #724
2024-01-17 fix sdcardio: D6A1.3 SDFDC:SILENT seems to have no effect #621
    [sdcardio.vhdl]
2024-01-18 use raw potx signal for amiga right button #751
2024-01-21 readd mega65r4 so the board can be used for testing
2024-01-21 feat(megaflash): finish high level flashing refactoring #683
    adds FACTORY flag detection on cores.
    No flag-only reflashing yet.
    Slot 0 flashing tested and working.
2024-01-21 fix(megaflash): fix some texts for megaflash #683
    Slot 1 unoccupied warning rewritten.
2024-01-23 fix(joyflash): quick and dirty fix to make joyflash compile again #683
    just copied qspicommon.h as qspijoy.h and fixing some externals!
    NOT TESTED, JUST COMPILES!
    [joyflash.c, qspijoy.c, qspijoy.h]
2024-01-24 feat(megaflash): add coreflag handling to basic flashing #683
    no slot update yet!
    also added module prefix to local functions in mf_selectcore
2024-01-26 use fx_up_mout for Amiga mouse emulation of right button #751
2024-01-27 invert amiga right button sense #751
    [mouse_input.vhdl]
2024-01-27 more fixing amiga right button #751
    [mouse_input.vhdl]
2024-01-27 revert POTAX sense for Amiga right-button. Add note about hardware incompatibility #751
    [mouse_input.vhdl]
2024-01-27 correct matrix segment access reg descriptions
    [c65uart.vhdl]
2024-01-28 rework 1351 historesis #751
    [mouse_input.vhdl]
2024-01-28 update configure option and register doc for 1351 de-jitter #775
    [c65uart.vhdl]
2024-01-28 fix(megaflash): possible fix for bootloop problem - wait! #683
    The bootloop seems to be a timing issue: when more slots are filled,
    the time to scan them actaully gets smaller, as detecting an EMPTY slot
    takes the most time. Adding 1-2 frames of waiting before the reconfigure
    seems to fix the problem.
    Also moved wait for keyrelease into mhexes as mhx_until_keys_released
2024-01-29 feat(megaflash): add BRINGUP flashing and slot flag chnage #683
2024-01-29 fix comment for amiga mouse regs so the look good in iomap.txt #751
    [c65uart.vhdl]
2024-01-30 fix F_CTRL_EN management #781 #778
    [expansion_port_controller.vhdl, mega65r2.vhdl, mega65r3.vhdl, mega65r4.vhdl, mega65r5.vhdl, mega65r6.vhdl]
2024-02-01 fix(megaflash): don't try to start slot if booted by JTAG #683
2024-02-02 fix(megaflash): change slot 0 flashing mode #783
    also adds a possible fix for flag reflash problems, by doing a dummy
    sdcard init at the end of loading the first sector of a slot from
    qspi to attic ram. #683
2024-02-04 fix(megaflash): allow erasing slot 0 if pushed by jtag #683
2024-02-04 feat(megaflash): change edit slot menu so that F4 is not show if disabled #683
2024-02-04 fix(megaflash): add dynamic erase list support for slot 0 flashing #783
2024-02-06 Changelog case changes
2024-02-12 fix(megaflash): initialize slot0 erase list with ff fro bringup #783
2024-02-22 fix comment indentation confusing some editors
    [gs4510.vhdl]
2024-04-27 attempt to implement disk missing detection #726
    [sdcardio.vhdl]
2024-04-27 assert RNF if no disk inserted #726
2024-04-27 floppy present if no motor spinning #726
2024-04-28 try to fix RNF not being asserted #726
    [sdcardio.vhdl]
2024-04-28 add missing disk not present check to read #726
    [sdcardio.vhdl]
2024-04-30 fast_divide.vhdl: Optimize division (#759)
    * fast_divide: Optimize performance
    Benchamrking shows that average latency per division is reduced from 13
    clock cycles to 8 clock cycles.
    * fast_divide: Bugfix.
    This may be a bug in Vivado. At least, the previous version worked fine
    with the GHDL simulator.
    I'm guessing Vivado has a problem with the "variable length" assignment.
    The fix introduced here ensures that all 32 bits are assigned always.
    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
    [fast_divide.vhdl]
2024-04-30 Various audio mixing and SID fixes (#801)
    * Changed the multiplication routine in audio_mixer.vhdl to not discard the top bit, changed mixer behaviour to peak at instead of overflowing (resolves MEGA65/mega65-core#793)
    * Made overflow code respect sign from before overflow, should allow repeated positive and negative overflows to still make sound
    * Implemented overflow check on the SID mixer as well, fixes a clicking in the output on overflow
    * Fixed multiplication in audio_mixer.vhdl to allow for full signed 16 bit range
    * Removed an accidental tab that I somehow didn't notice
    * Switched SID mixing in audio_complex.vhdl to 18 bit instead of 16 bit
    * Implemented fix mentio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
    [audio_complex.vhdl, audio_mixer.vhdl, sid_voice_8580.v]
2024-05-24 permit power-up + '9' key to go to MEGA659.ROM
2024-05-27 revert rebase of 726-fast-rnf-with-no-disk #726
    [sdcardio.vhdl]
2024-05-30 fix(sdcardio.vhdl): move sdio_busy set to state machine #763 instead of doing it in fastio_write block (which will get reset in Idle state)
    [sdcardio.vhdl]
2024-05-31 Various fixes for QSPI hardware assisted operations (#762, #764).
    [sdcardio.vhdl]
2024-06-03 Allow programming 256 byte pages on 512 byte page device.
    The flash chip allows programming less than the device page size,
    also from non-page-aligned offsets. The only catch is that
    programming wraps at the device page boundary. For now, we'll
    allow programming 256 byte pages when the device page size is either
    256 or 512 bytes, and 512 byte pages when the device page size is
    512 bytes. The address should be page aligned. This avoids issues
    with wrapping. If necessary, we could relax these requirements
    later, for instance allowing programming any size smaller
    than or equal to the device page size.
2024-06-08 Print PPB and DYB protection bits for debugging sector erase failures.
2024-06-08 Revert "Print PPB and DYB protection bits for debugging sector erase failures."
    This reverts commit aa5ff9fbd822d10b5e47805e8cd2efc5891137e9.
2024-06-09 fix(megaflash): rework progress bar, change SLOT_SIZE_PAGE_MAX to _MASK #782
2024-06-12 Remove mf_flash glue layer.
2024-06-17 Updates to hardware assisted flash operations.
    * Use the number of read latency cyles determined by examining the
    flash device configuration, instead of a hard-coded value.
    * Remove the possibility to pass a NULL buffer to the flash API
    read command, since it is not being used.
    * Add documentation for public functions.
2024-06-17 Determine page buffer size from the sector architecture.
    The page buffer size is coupled 1:1 to the sector architecture for
    the flash devices currently in use. This change shortens the amount
    of CFI (flash device configuration) data to be read and buffered
    from 44 to 5 bytes.
2024-06-30 fix(megaflash): rename and move SLOT_ vars to mf_utility #782
2024-06-30 feat(megaflash): rename and document compile switches #782
2024-07-03 feat(megaflash): add attic ram switching to mflash.prg #782 Also reenables the lazy attic ram check for mflash.prg only
2024-07-04 Undo DIY keyboard support for R3 boards
2024-07-04 fix(megaflash): add border flicker to verify, fix progress frame size #782
2024-07-06 feat(release-build): switch to coretool and release-1.00 tools #792
2024-07-06 Fix cells selection for pblocks defined on a "generated" component.
    [mega65r5.xdc]
2024-07-07 Fix pblock cell selection for "generated" components.
    [mega65r4.xdc, mega65r5.xdc]
2024-07-07 Backport fixes for pblock cell selection to mega65r4
    [mega65r4.xdc]
2024-07-11 Fix typo causing timeout on ack of EOI-sent byte
    [iec_serial.vhdl]
2024-07-15 Add 270 MHz clock in place of unused 135 MHz inverted clock.
    [clocking50mhz.vhdl]
2024-07-15 Do not generate an Ethernet controller for the Wukong target.
    Although the Wukong board has an Ethernet port, it uses GMII
    instead of RMII. This means the (RMII) Ethernet controller VHDL
    component cannot be used as is.
2024-07-18 AudioDMA IRQ implementation and fixes for saturation.
    [gs4510.vhdl]
2024-07-21 fix(mega65r4/5.xdc): add missing pmod1_en bin #809
    [mega65r4.xdc, mega65r5.xdc]
2024-07-23 fix(megaflash/mf_progress): fix progress (don't use invert as attr!) #782 using MHX_A_INVERT as progress ATTR will invert the progress chars which breaks the correct flow. Rather invert the full char!
2024-07-23 feat(megaflash): add possibility to switch BITBASH/HWASSIST in mflash.prg #782
2024-07-25 Fix round-off error in hardware division
    This fixes issue #786
    The problem was lack of precision in the intermediate calculations. This
    fix increases the used number of DSPs from 12 to 32.
    [fast_divide.vhdl]
2024-07-25 Fix some critical warnings during build
    [mega65r5.xdc]
2024-07-25 Add a audio clock constraint
    Everything running on the audio clock was previously unconstrained.
    Since the audio clock is running at less than 15 MHz (i.e. larger than
    60 ns clock period), it's probably not a big deal.
    I also replaced a "set_false_path" with "set_max_delay". The former is a
    complete "ignore everything", whereas the latter still constrains the
    routing delay.
    [audio_clock100.vhdl, mega65r5.xdc]
2024-07-25 Fix incorrect clock constraints
    [mega65r5.xdc]
2024-07-26 Improve SDRAM constraints
    This fix forces the I/O registers of the SDRAM controller to be placed
    inside the I/O block (rather than in the main fabric of the FPGA).
    The key is the "attribute iob".
    However, in order to get full benefit, it's necessary to have explicit
    registers of the "output enable", or rather "tristate enable".
    Furthermore, the constraints are no longer necessary, because there is
    nothing more to constrain.
    [mega65r5.xdc, sdram_controller.vhdl]
2024-07-27 SDRAM fix: Don't drive DQ during read
    [sdram_controller.vhdl]
2024-07-28 feat(release-build): switch to coretool, fix generated version
2024-07-30 Fix errors detecting timeouts while sending in JD and normal comms
    [iec_serial.vhdl]
2024-07-31 Detect timeouts when slow receiving
    This is required to detect "File Not Found" type errors.
    [iec_serial.vhdl]
2024-08-01 Add configurable timing for slow read timeout
    Also renumber states to avoid big jump
    [iec_serial.vhdl]
2024-08-04 fix missing signal ref #808
    [iomapper.vhdl, keyboard_complex.vhdl, keyboard_to_matrix_wukong.vhdl, machine.vhdl]
2024-08-04 chop directory track from d81 for faster ghdl #736
2024-08-06 Revert the (left only) "saturation" change.
    [gs4510.vhdl]
2024-08-09 fix 1581 CLK and DATA line output control #736
    [internal1581.vhdl]
2024-08-10 fix DATA and ATN_ACK line plumbing #736
    [iec_serial.vhdl, internal1581.vhdl]
2024-08-10 fix comments for device 8 access #736
2024-08-10 debug and fix failing no drive DEVICE NOT PRESENT test #736
    [cia1581.vhdl, dpram8x4096.vhdl, internal1581.vhdl]
2024-08-11 docs(gs4510.vhdl): correct some auf the Audio DMA docstrings, rebuild iomap.txt
    [gs4510.vhdl]
2024-08-11 docs(gs4510.vhdl): fixed ADMA IRQ reg numbering error, prefix with IRQ
    [gs4510.vhdl]
2024-08-13 docs(gs4510): fixed some hypervisor register docstrings
    [gs4510.vhdl]
2024-08-13 make address widths correctly vary with RAM size #736
    [dpram8x4096.vhdl]
2024-08-13 fix reporting of last_rx_byte for 1581 #736
    [internal1581.vhdl]
2024-08-13 implement ADC addressing modes for 1581 #736
2024-08-17 docs(c65uart.vhdl): put D613/14 into UARTMISC instead of DEBUG #356
2024-08-18 connect SRQ to correct CIA #736
    [iomapper.vhdl]
2024-08-18 fix inverted SRQ en line for R3 #736
    [mega65r3.vhdl, mega65r3.xdc]
2024-08-18 fix XDC for R2 #736
    [mega65r2.xdc]
2024-08-21 Squashed merge of cia_oneshot fixing #821
    commit 4f64494f436b2db66d4bf79fdb83e67c0fb126ed
    Author: Gurce Isikyildiz <gurce.isikyildiz@gmail.com>
    Date: Tue Aug 20 05:59:07 2024 +0100
    trial attempt to fix cia-oneshot bug
    [cia6526.vhdl]
2024-09-06 fixed 1351 de-jitter nor working on vertical mouse movement of port 1 #828
    [mouse_input.vhdl]
2024-09-08 fix: DMA src/dst addresses wrap around at MB boundaries #826
    [gs4510.vhdl]
2024-09-09 Add enhanced DMA job option $01 to disable MB address wrap around for the current (chain of) DMA job(s) #826
2024-09-09 add global setting in $D703.1 to disable DMA MB wrap around #826
2024-09-10 docs(Changelog.md): added a bunch of staged entries
2024-09-21 Fixing missing documentation about the RTC
    [grove_i2c.vhdl, mega65r2_i2c.vhdl, mega65r3_i2c.vhdl, mega65r4_i2c.vhdl]
2024-09-22 Implement HWERRATA maximum value (#832)
    Condensed changes:
    * feat(sdcardio.vhdl): limit HWERRATA to max supported level #829
    also changes documentation to be more verbose and adds searchable
    terms for finding places where it is used.
    * docs(sdcardio.vhdl): change HWERRATA Table to also have HWERRATA:LEVEL tags #829
    * fix(sdcardio.vhdl): remove unneeded hw_errata_level_int #829
    also move signal intialisation to machine.vhdl instead of port list
    * doc(viciv.vhdl): mark NOBUGCOMPAT as deprecated #829
    [iomapper.vhdl, machine.vhdl, sdcardio.vhdl]
2024-10-11 Use user button #2 as the restore key.
2024-12-06 experiment to put 6551's uart_tx/rx lines out to JB1 (to jtag adapter) - To see if c64 swiftlink-compatible 6551-based serial software can work with our current 6551 implementation inside "c65uart.vh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
2024-12-06 try appease another vivado error msg
    [mega65r3.vhdl]
2024-12-14 revert back to correct size of bytes to retrieve from shadowram
    [bitplanes.vhdl]
2024-12-14 tried reverting some of my prior logic to trigger the read of next h640 line early
    [bitplanes.vhdl]
2024-12-15 - added rule for ghdl-frame-gen
2024-12-22 (#689) rolling back some of my prior changes to work on the most minimal fix/solution for this issue. - Some of this rollback will cause ghdl-frame-gen tool to stop working though, so that's a shame.
    [bitplane.vhdl, bitplanes.vhdl, machine.vhdl]
2025-02-13 HYPPO: Add freeze region for the rest of FDD3000
    Fixes https://github.com/MEGA65/mega65-core/issues/868
    In https://github.com/MEGA65/mega65-core/pull/755 I reduced the amount
    of memory saved in the FFD3000 region to avoid unfreezing into D081. I
    should have added another region to save the rest of that
    region (starting with last accessed track at D084).
    Not saving D084 causes the mounting of the internal drive to seek the
    head to track 0x55 instead of the correct location. 0x55 being the
    value returned for peeks into the frozen memory that were not saved.
    [freeze.asm]
2025-02-21 (#844) attempt to get 'r' uart mon command to show current megabyte
2025-02-21 (#844) fixed another typo
    [monitor_top.v]
2025-02-21 (#844) fixed yet another typo
    [monitor_top.v]
2025-02-21 (#844) tried reducing the trace depth to save on ram
2025-02-21 (#844) tried fixing some other issues
    [monitor_bus.v, monitor_top.v]
2025-02-22 (#844) rework two historyrams into one ram that 32 bytes per trace and is 512 deep
    [monitor_bus.v, monitor_ctrl.v, monitor_top.v]
2025-03-07 docs: replace c65gs with mega65 and 48 MHz with 40.5 MHz #860
    Squashed commit of the following:
    commit 8b6d7917e2593d7b8364fd32e122f8456802f15e
    Merge: b419dd7e1 bebf6e6cd
    Author: Oliver Graf <oliver@m-e-g-a.org>
    Date: Sat Mar 8 00:00:21 2025 +0100
    Merge branch 'development' of github.com:The8BitTheory/mega65-core into The8BitTheory-development
    commit bebf6e6cdaa503d6a9e96172c9c64a70ef9b754e
    Author: Martin Goodwell <the8bittheory@gmail.com>
    Date: Sat Feb 1 12:34:26 2025 +0100
    Update gs4510.vhdl
    commit ea5d06657cb31c379e2b38d466e92824545a5b76
    Merge: b4a33f496 bc42a7271
    Author: Martin Goodwell <the8bittheory@gmail.com>
    Date: Sat Feb 1 12:34:20 2025 +0100
    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
    [gs4510.vhdl, nocpu.vhdl, rxvideo.c, vncserver.c]
2025-03-11 fix(iomapper.vhdl): fixes nexys boot problem #857 Fix courtesy to 0xa000!
    [iomapper.vhdl]
2025-03-12 Correct audio saturation when panning applied
    [gs4510.vhdl]
2025-03-13 Lengthen the keyboard debounce timer based on user reports of double-strikes
    I have tested this change with one affected user and they report the issue subsides. I was not able to reproduce debounce double-strikes before or after this change on my own hardware, but I also don't notice a difference with this change.
    [matrix_to_ascii.vhdl]
2025-03-15 Correct setting Cx registers #859
    [opl2.v]
2025-03-16 New clipping detection using 19bits mixing temp variable for mixing audio dma channels
2025-03-29 Remove alternate char attr blink behavior at HWERRATA 2
    Fixes https://github.com/MEGA65/mega65-core/issues/883
    [sdcardio.vhdl]
2025-03-31 Fix docstring typo: "indented" -> "intended"
    [sdcardio.vhdl]
2025-04-12 fix(Makefile): add build dependency for CC65, switch to Vivado 2024_2
2025-04-12 Implemented scaling down in line mode, fixed a faulty slope accumulator latency workaround, count now draws the right number of pixels in both line copy and fill.
    [gs4510.vhdl]
2025-04-12 Switched skip rate to 65536ths in line mode
    [gs4510.vhdl]
2025-04-13 fix(hyppo): set no real flag if syspart mount fails #760
    [main.asm, syspart.asm]
2025-04-16 feat(freezer): switch to development branch with removed debug output #760
2025-04-18 Ctrl+= has no PETSCII interpretation
    Fixes https://github.com/MEGA65/mega65-core/issues/888
    [matrix_to_ascii.vhdl]
2025-04-30 revert to older version, so that MCLK is in 4-5 MHz range
    [i2s_clock.vhdl]
2025-05-19 (#735) making a copy of current 'i2s_clock.vhdl' that works for r3
2025-05-19 (#735) reverted r6's i2s-clock back to latest implementation from gardners
    [i2s_clock.vhdl]
2025-05-20 (#735) reverted hyppo to use d6fe.0 location for amp chip on/off
    [syspart.asm]
2025-05-31 fix bug in saving X reg in printhex #897
    [main.asm]
2025-06-13 fix bug in SHRES HYPER trap #897
    [syspart.asm]
2025-06-18 add timeout to R3 I2C setup #800
2025-06-21 prevent infinite I2C loop for megaphone path #800
    [targetsetup.asm]
2025-06-21 PLX on return from i2c delay #800
2025-07-20 style: fix whitespace in targetsetup after merge
    [targetsetup.asm]
2025-07-20 fix reg names #903
    [gs4510.vhdl]
2025-07-20 don't clamp dma sub addresses over options #903
2025-07-20 style: fix whitespace after #903 cherry pick
    [gs4510.vhdl]
2025-07-20 fix: move syspart_error so longbranch is not needed #897
    [syspart.asm]
2025-07-20 fix: display read HYPPO Version on startup #897
    [constants.asm, main.asm]
2025-07-27 (#899) initial attempt to repair CIA timer leak
    [cia6526.vhdl]
2025-07-27 fix: remove duplicate check for reg_timerX_has_ticked #899
    [cia6526.vhdl]
2025-09-15 switch U32 byte order #915
2025-09-15 fix(c65uart): output board_minor for r5 and later #915
    [c65uart.vhdl]
2025-09-19 fix(c65uart): board_minor must not go into M65TARGET high nibble #920
    [c65uart.vhdl]
2025-11-24 Fix inaccurate CIA timing in NTSC, now correctly counting 65 cycles per VIC-II raster instead of 63 #816
    [pixel_driver.vhdl]
2026-01-14 experimental fix for DMAgic line mode inconsistent startup states
    [gs4510.vhdl]
2026-01-14 Moved initial slope accumulation to startup state, should hopefully eradicate the wacky startup alignment issues
    [gs4510.vhdl]
2026-01-19 470Ω resistor between pins 12-15 enables 15Khz mode
2026-01-25 Fixed a faulty comparison for character boundary crossing in the Y axis
    [gs4510.vhdl]
2026-03-28 Replace extracted QPI controller.
    [sdcardio.vhdl]
2026-03-29 Fix supported erase block sizes; update sensitivity list.
    [qspi_flash_s25flxxxl.vhdl]
2026-03-29 Remove obsolete software QSPI device drivers.
2026-03-29 Add other erase block sizes and renumber QSPI actions.
    Renumbering was needed to avoid non-QSPI action $57.
    [qspi_flash_s25flxxxl.vhdl, qspi_flash_s25flxxxs.vhdl, sdcardio.vhdl]
2026-03-29 Add sector buffer and new QSPI controller to current targets.
2026-05-14 QSPI: fix transfer size to 512 bytes, move status register to $D6C1.
    Remove the $D6CD/$D6CE size registers; the transfer size is now fixed at
    512 bytes in the VHDL and the C driver. Move the status register from
    $D6CC to $D6C1 so the three registers occupy the contiguous range
    $D6C1-$D6C3.
    [qspi_flash_s25flxxxl.vhdl, qspi_flash_s25flxxxs.vhdl]
2026-05-14 QSPI: fix busy polling, unify error reporting, refactor error states.
    - sdcardio: add $D6C1 to fastio read pass-through (was missing, causing
    busy-wait to never spin and all operations to appear instant); remove
    stale $D6CC/$D6CD/$D6CE entries from read and write paths; reorder
    cases to be in address order.
    - $D6C1 status register: remove busy bit (poll $D680 bit 0 instead);
    remove block_mismatch bit; shift remaining bits down to bit 0=error,
    bit 1=initialization error, bit 2=internal fault.
    - Replace REJECTED state with ERROR_IDLE, ERROR_UNINITIALIZED, and
    ERROR_INTERNAL_ERROR, isolating all dev_error assignments to these
    dedicated states. Strobe-while-busy now silently ignore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
    [qspi_flash_s25flxxxl.vhdl, qspi_flash_s25flxxxs.vhdl, sdcardio.vhdl]
2026-06-23 style: fix vhdl from merge of PR#934
    [machine.vhdl, mega65r3.vhdl, mega65r4.vhdl, mega65r5.vhdl, mega65r6.vhdl, pixel_driver.vhdl]
2026-06-25 fix(hyppo/freeze): don't overwrite VIC register 255 by accident! #937
    [freeze.asm]
2026-07-05 Squashed commit of the following:
    commit fb21cdd23250c4dc3613fe9d18f17e37e4cf3b8c
    Author: Paul Gardner-Stephen <paul@m-e-g-a.org>
    Date: Fri Aug 29 17:22:25 2025 +0930
    fix infinite loop in #913
    commit b8830452a18e7e573c46002ace6968d79bb5cf97
    Author: Paul Gardner-Stephen <paul@m-e-g-a.org>
    Date: Fri Aug 29 16:59:39 2025 +0930
    fix CHDIR trap return value #913
    [dos.asm, main.asm]
2026-07-05 clamp max RRB position if at 1023 #914
2026-07-05 clamp at 1022 instead of 1023, to allow for start at 1023 #914
2026-08-16 Fixed a bug affecting the ExecuteQreg32 state which caused the PC to increment in situations it shouldn't (INQ crash)
    [gs4510.vhdl]
2026-08-20 Take the freeze slot number in the byte order the code actually uses
    syspart_locate_freezeslot documents X as the low byte, but it pushes X
    then Y and pops plx before ply, so the multiply reads the low byte from
    Y. freeze_to_slot already asks for "Slot in XXYY", and callers follow
    the code rather than the comment, so correct the comment and the bounds
    check rather than the pops.
    That check rejected nothing: it fell through to the low byte whichever
    way the high byte compared. Fixing it exposed error paths that returned
    without pulling the pushed slot number.
    Also say why syspart_unfreeze_from_slot_trap restores only X: the trap
    dispatch clobbers it with tax, while Y reaches the handler u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
    [syspart.asm]
2026-09-05 rain: rewrite matrix mode text pixel pipeline
    The rotate+stretch shifter that expands font bytes into the 16-tick
    character cells has three defects, visible as rendering artifacts in
    matrix mode:
    1. the 2x pixel-stretch phase free-runs across raster lines; with an
    odd toggle count per line it flips every scanline, displacing
    alternate scanlines of each glyph row by one pixel (jagged,
    zig-zag glyph edges);
    2. 8 font pixels x 2 ticks never fit the 16-tick cell without a seam:
    depending on phase, either the last font pixel lingers for a third
    tick (glyphs grow an extra pixel on the right) or the first font
    column ghosts at the end of the cell;
    3. display order is b0-first: ev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
    [rain.vhdl]
2026-10-21 F011: real-drive sector writes at HD/RLL rates
    The write path only waited for the header from mfm0, which is fixed at the
    DD rate, so sector writes at any other rate (e.g. HD, rate 40) ended in RNF.
    Now any reader that finds the target header may start the write, and the
    write runs at that reader's rate and encoding:
    - mfm_fast (selected rate and encoding, MFM or RLL) starts it at once;
    - if mfm0 (DD MFM) or mfmhdonly (HD MFM, sector_found now wired out) fires
    first, wait up to 2 DD byte times for mfm_fast, then use DD, else HD.
    The fastest decoder tends to signal first (e.g. the HD reader on a DD
    track in a DD-mode drive), so the first signal alone can pick the wrong
    rate. A fixed-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
2026-10-27 (#957) when force-loading, assure timerX_visible vars are updated immediately
2026-11-03 (#964) assessing possible jitter on pot-drain signal
2026-11-04 (#964) completely comment out hysteresis logic, to see if it the cause of the jitter
